davixcky/ecualizador-esp32/README.md

# Ecualizador de audio de tres bandas con ESP32

## Video del dispositivo

[Ver video en Full HD](docs/video/ecualizador-animado.mp4) · [Escena de Blender y texturas](docs/video/ecualizador-blender.zip). Demo de 36 segundos con sonido: los deslizadores cambian el audio usando las respuestas SPICE del circuito. Pantalla y luces sincronizadas; apertura de la tapa imantada. Es una demo virtual, no una grabación del prototipo físico.

Proyecto de Electrónica II · Universidad de la Costa · Leo Rojas, David Orozco y Manuel Castilla.

La ruta de audio usa filtros activos y controles analógicos. El ESP32 lee los niveles y calcula una FFT para la pantalla Waveshare de **1,9 pulgadas, 170 × 320, ST7789V2**. El gabinete EQ / 03 tiene acabado grafito, cierre con cuatro pares de imanes y dos canales interiores para 12 NeoPixel.

| Entrega | Archivos actuales |
|---|---|
| Presentación en LaTeX | [PDF](docs/presentacion/presentacion-fase2.pdf) · [PowerPoint con notas](docs/presentacion/presentacion-fase2.pptx) · [PDF con notas](docs/presentacion/presentacion-notas.pdf) |
| Exposición con animaciones | [PowerPoint animado](docs/presentacion/presentacion-animada.pptx) · [PDF por pasos](docs/presentacion/presentacion-animada.pdf) · [Cómo presentar](docs/presentacion/LEEME.md) |
| Informe | [PDF](docs/informe-fase2.pdf) · [Word](docs/informe-fase2.docx) · [Markdown](docs/informe-fase2.md) |
| Fuentes editables en LaTeX | [Informe](docs/latex/informe.tex) · [Presentación Beamer](docs/latex/presentacion.tex) |
| Presentación corta de filtros | [PDF de 10 diapositivas](docs/presentacion/presentacion-filtros-hoy.pdf) · [PowerPoint con notas](docs/presentacion/presentacion-filtros-hoy.pptx) · [Fuente LaTeX](docs/latex/presentacion-filtros.tex) |
| Ensayo de hoy | [Generador y osciloscopio: guía](simulacion/velxio/DEMO-HOY.md) |
| Paquete para otro computador | [ZIP portátil: presentación, esquema y simulaciones](docs/exposicion-portable.zip) |
| Simulación en Velxio | [Abrir casos locales](simulacion/velxio/index.html) · [Instrucciones y alcance](simulacion/velxio/README.md) · [100 Hz](simulacion/velxio/filtros-100Hz.vlx) · [1 kHz](simulacion/velxio/filtros-1000Hz.vlx) · [8 kHz](simulacion/velxio/filtros-8000Hz.vlx) |
| Esquemático | [PDF](hardware/ecualizador.pdf) · [KiCad](hardware/ecualizador.kicad_sch) · [ERC](hardware/erc.rpt) |
| PCB de una cara D.2 | [Plano PDF](hardware/pcb-rev-D2.pdf) · [KiCad](hardware/ecualizador.kicad_pcb) · [DRC](hardware/drc.rpt) · [Montaje y puentes](hardware/una-cara/LEEME.md) · [BOM](hardware/fabricacion/bom.csv) |
| Modelos 3D | [Gabinete STEP](cad/ecualizador-gabinete.step) · [Piezas STL](cad/stl/) · [PCB STEP](hardware/3d/ecualizador-placa.step) · [PCB VRML](hardware/3d/ecualizador-placa.wrl) |
| Propuesta original y rúbrica | [Fase 1](docs/fase1/) |

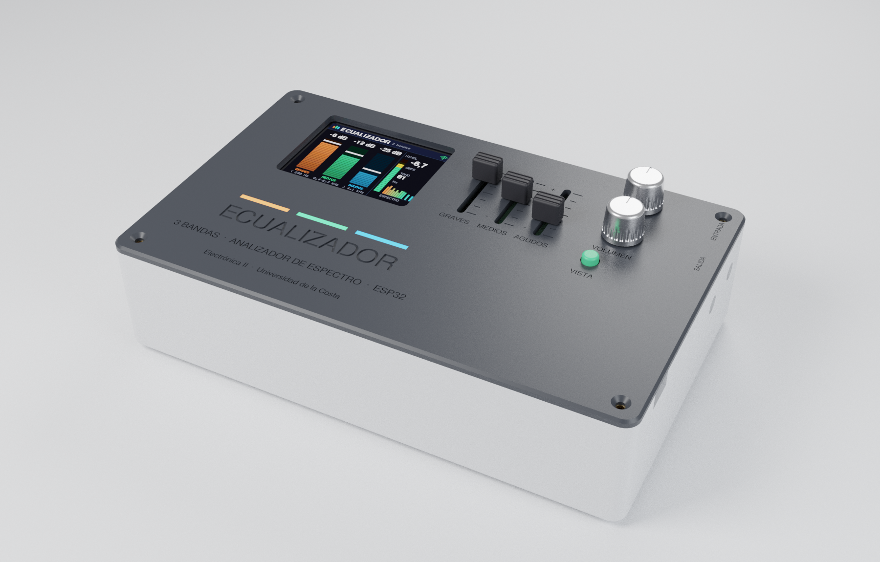
[picture p1: img/3d-gabinete-cerrado.png]
Diseño del gabinete


## Estado de la revisión del 22 de octubre de 2026

- ERC: cero errores y cero advertencias. Las 59 redes coinciden pin a pin con la definición del circuito.
- DRC D.2: cero infracciones, cero pads sin conectar y cero diferencias con el esquema. El DRC comprueba las 59 redes mediante cobre inferior, plano de GND y 80 cables. Las comprobaciones y límites de montaje se documentan en [la guía](hardware/una-cara/LEEME.md).
- ngspice: 23 casos del diseño revisado cumplen sus criterios. El caso histórico de Fase 1 reproduce el valle que motivó la corrección. El macromodelo del operacional es una aproximación propia.
- Velxio: tres proyectos ejecutados con motor SPICE; predominan graves a 100 Hz, medios a 1 kHz y agudos a 8 kHz. Los filtros usan operacionales ideales. Un cuarto [ensayo animado de 12 NeoPixel](simulacion/velxio/led-animado.vlx) ejecuta código del ESP32; usa un patrón programado sin audio.
- Velxio integrado: entrada → filtros → detectores → ADC ESP32 → TFT ILI9341, usando QEMU. Se comprueba el predominio de cada banda con 100 Hz, 1 kHz y 8 kHz. FFT sin calibración de frecuencia; no incluye potencia ni adaptación LED. [Guía y modelos](simulacion/velxio/INTEGRADO.md).
- Firmware: compilación ESP32 correcta; 19 comprobaciones DSP y cinco comparaciones de dibujo por franjas correctas en el computador.
- El montaje físico, las mediciones con instrumentos y el requisito de más del 70 % de dispositivos adquiridos y conectados **siguen sin evidencia en este repositorio**.

Los [registros de validación](docs/validacion/) conservan los resultados. Los renders provienen del CAD y de KiCad; las pantallas se dibujan con el código de interfaz y datos de ejemplo.

## Pantalla e iluminación

J4 es un adaptador de ocho señales a 2,54 mm, no la huella GH1.25 de Waveshare. Conectar por **nombre de señal**, siguiendo la tabla del informe: VCC, GND, DIN, CLK, CS, DC, RST y BL. La interfaz trabaja en horizontal a 320 × 170.

GPIO25 controla la tira mediante un 74AHCT125 y 330 Ω. J5 lleva 5 V, DIN y GND. Se prevén dos tramos de 100 mm, seis LED por tramo, y canales de 102 × 10,6 × 3 mm con difusores. El brillo inicial es 32/255, fijo. La fuente prevista es de 5 V / 3 A por J6; **desconectar VBUS del USB cuando se usa esa fuente**. No alimentar los LED desde 3,3 V ni usar VREF como retorno.

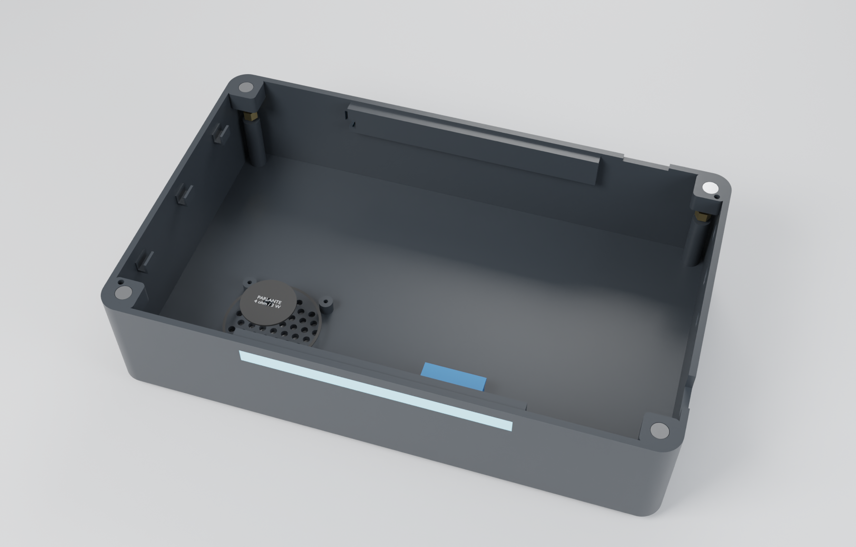
[picture p2: img/3d-gabinete-canales.png]
Canales interiores


## Reproducir los archivos

Los PDF usan el logo oficial CUC, rojo institucional y Red Hat Display, según el [manual consultado](img/marca/README.md). Las fuentes vigentes son los `.tex` (LuaLaTeX). El PowerPoint contiene imágenes de las diapositivas y notas; el texto se edita en LaTeX. El HTML anterior está archivado en `docs/archivo/`.

```sh
# TeX Live: latex-extra, lang-spanish, fonts-recommended, luatex; pandoc
# Python: pymupdf, python-pptx (para exportar PNG y PowerPoint)
bash herramientas/compilar_documentos.sh

# Firmware y pruebas en computador
pio run -d firmware
make -C firmware/test prueba pantallas

# Conectividad y simulación (ngspice, numpy, matplotlib)
python3 herramientas/verificar_netlist.py
.venv/bin/python herramientas/simulacion.py

# PCB de una cara: regenerar y verificar
python3 herramientas/generar_esquematico.py
python3 herramientas/generar_pcb.py
bash herramientas/exportar_fabricacion.sh

# CAD (CadQuery) y renders (Blender, KiCad)
.venv/bin/python herramientas/validar_cad.py
bash cad/generar.sh

# Repetir la comprobación web (Node y Playwright con Chromium)
node herramientas/validar_velxio.cjs
node herramientas/validar_led_velxio.cjs
```

Las vistas de ensamblaje y colores de bandas parten de C2-ABPR; la revisión EQ / 03 adopta acabado grafito, rotulación compacta y cierre magnético. Las cotas de pantalla, controles y conectores deben contrastarse con las piezas adquiridas antes de imprimir y montar.

La presentación incluye fragmentos del esquema real para explicar preamplificador, Sallen-Key, sumador y detector. Los PDF adjuntan el esquema, el plano D.2 y los proyectos Velxio. El enlace y el QR abren el editor; después se importa el caso `.vlx`. Ver [cierre magnético y cotas](cad/CIERRE-MAGNETICO.md).

La PCB D.2 organiza las etapas con el flujo Python/KiCad y Freerouting de medidor-energia-esp32: ESP32 a la derecha, operacionales por etapas y cableado identificado por colores. Usa una sola cara de cobre y puentes aislados. Los controles van en el panel y requieren las [cabeceras y cables de montaje](hardware/una-cara/LEEME.md). Los Gerbers de dos capas B.1 están archivados y no corresponden al montaje vigente.

### Montaje de los puentes

La cara superior lleva 29 puentes cortos (hasta 20 mm entre extremos). Los 51 cables restantes se montan aislados por debajo. El total sigue siendo 80 tramos; no se añade una capa de cobre. [La guía](hardware/PUENTES.md) y [el plano de cuatro páginas](hardware/pcb-rev-D2.pdf) indican la cara de cada conexión. Los arcos del render son orientativos: el montaje requiere comprobar separación, sujeción y continuidad.
