davixcky/ecualizador-esp32/docs/latex/validacion.tex

El esquema pasa ERC sin errores ni advertencias. Las 59 redes coinciden pin a pin con la descripción del circuito.

La revisión D.2 pasa la comprobación eléctrica DRC y la comparación con el esquema. Las 59 redes quedan conectadas al incluir los 80 puentes. La comparación con el esquema comprueba las conexiones de cada terminal. El ruteo conserva una separación mínima de 1 mm y pistas de 0,9 mm o más.

Los informes están en \texttt{hardware/drc.rpt} y \texttt{hardware/una-cara/continuidad.json}. Las comprobaciones gráficas de serigrafía no se utilizan para certificar una impresión; no se incluye una capa de serigrafía en fabricación.
