davixcky/ecualizador-esp32/docs/presentacion/presentacion-fase2.pptx

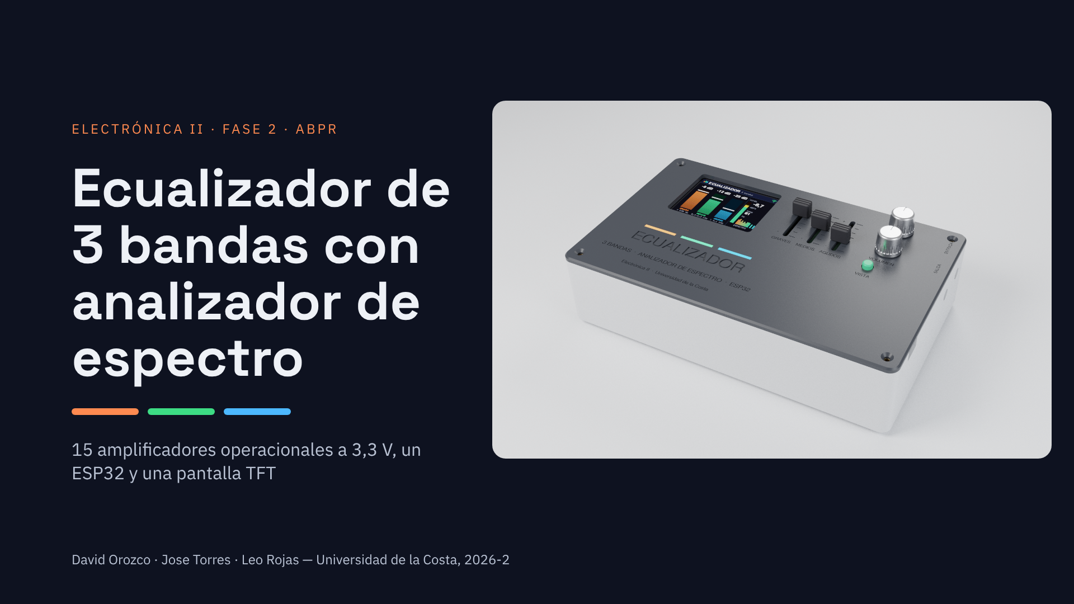
[picture p21: figure]

Notes: Presentamos la Fase 2: el desarrollo de la propuesta elegida. Es un ecualizador analógico de tres bandas hecho con amplificadores operacionales, al que le sumamos un analizador de espectro en un ESP32.

## Slide 2

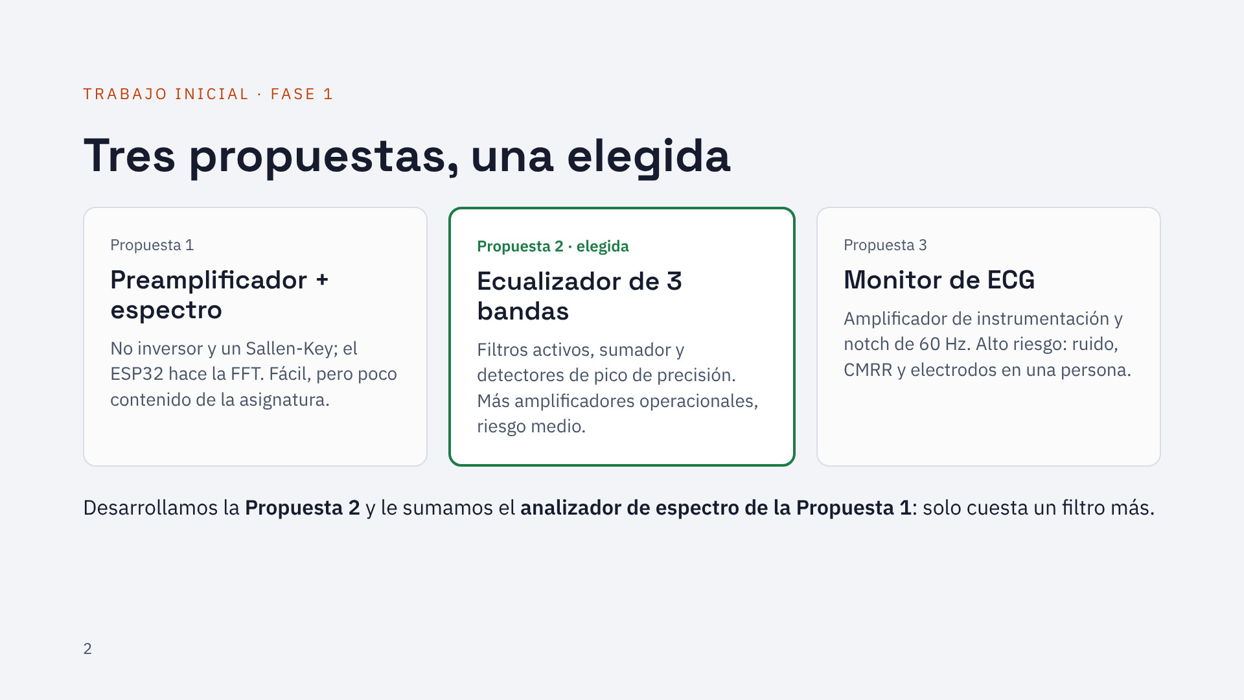
[picture p22: figure]

Notes: En la Fase 1 presentamos tres alternativas con los mismos criterios: 3,3 V, MCP6004, VREF de 1,65 V y ADC1 del ESP32. Elegimos la 2 porque tiene más contenido de Electrónica II con riesgo medio. De la 1 tomamos el analizador de espectro. La 3 se descartó por riesgo y porque conecta electrodos a una persona.

## Slide 3

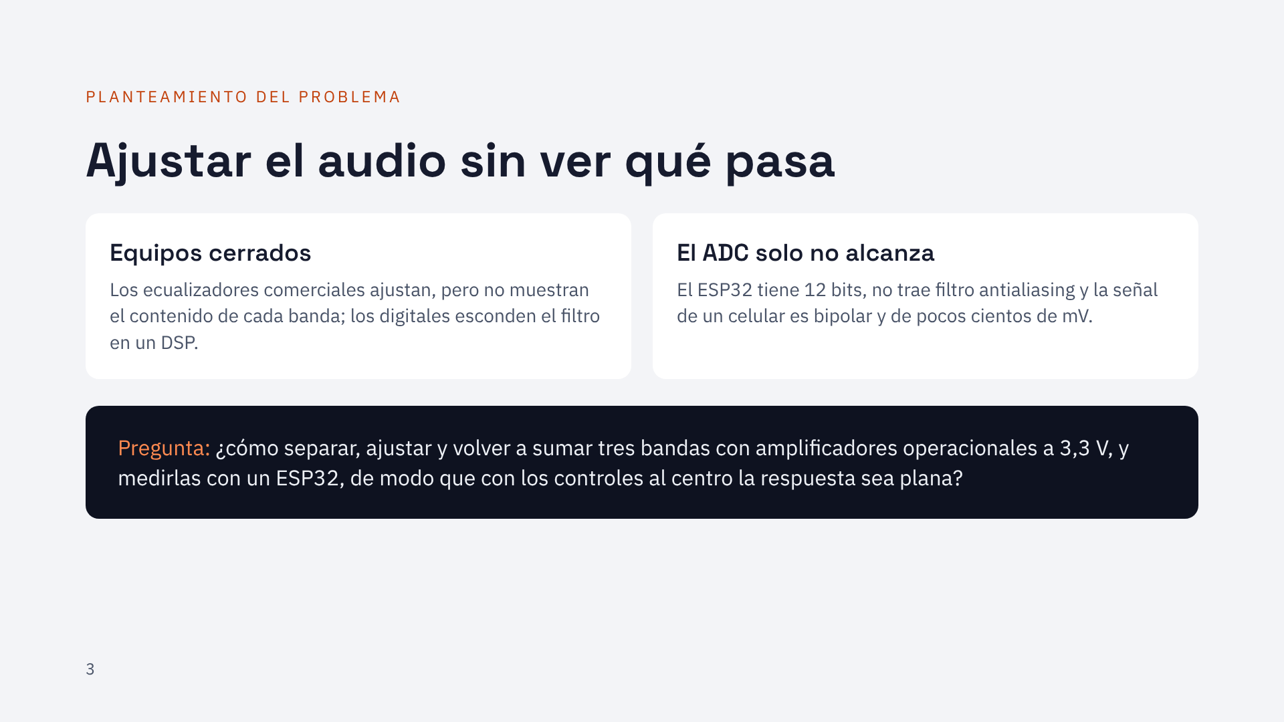
[picture p23: figure]

Notes: El problema tiene dos partes: el usuario no ve qué hace el ecualizador, y el microcontrolador no puede digitalizar bien el audio directamente. Por eso la solución es analógica para el audio y el ESP32 solo mide.

## Slide 4

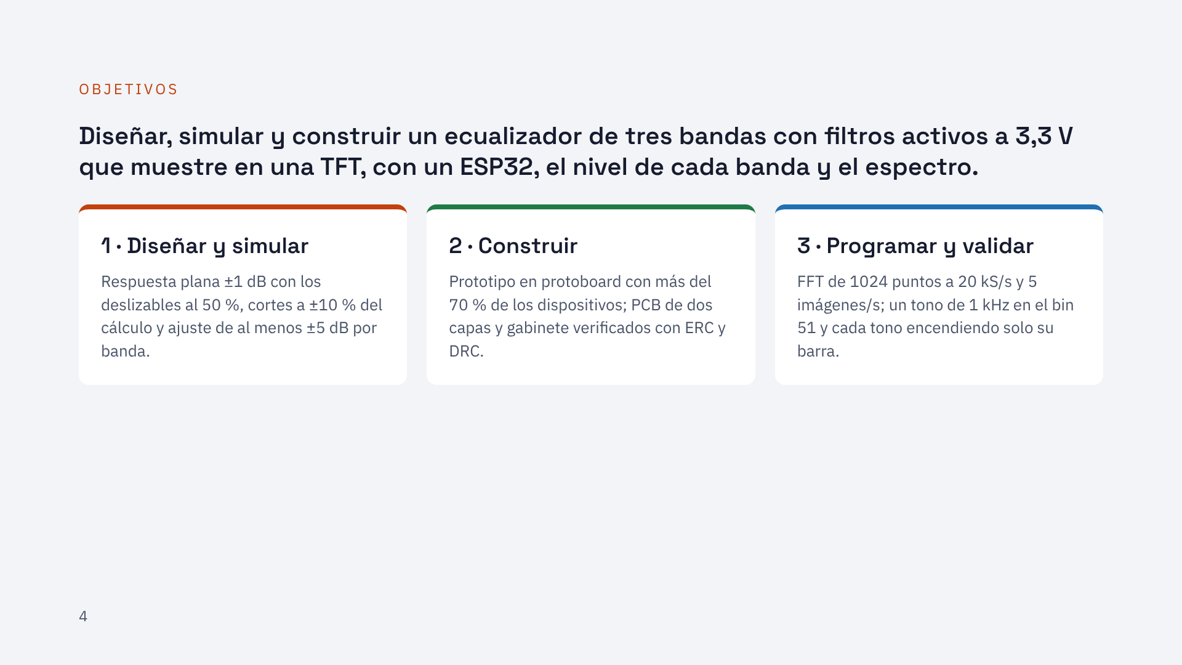
[picture p24: figure]

Notes: El objetivo general arriba; los tres específicos son medibles y cada uno tiene un criterio que luego verificamos en la simulación y que verificaremos en el montaje.

## Slide 5

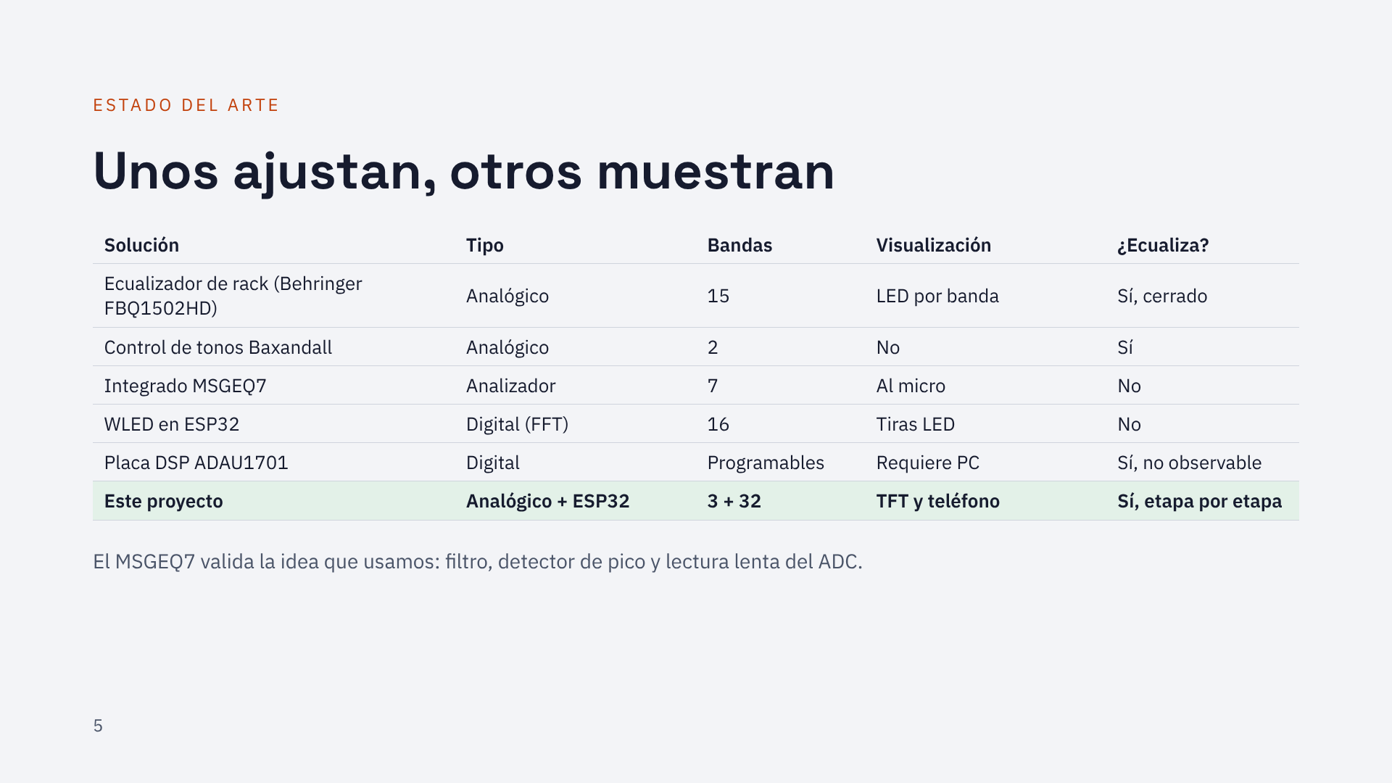
[picture p25: figure]

Notes: Ningún producto revisado hace las dos cosas con un circuito que se pueda medir. Los analógicos comerciales ecualizan pero son cerrados; los analizadores miden pero no ecualizan.

## Slide 6

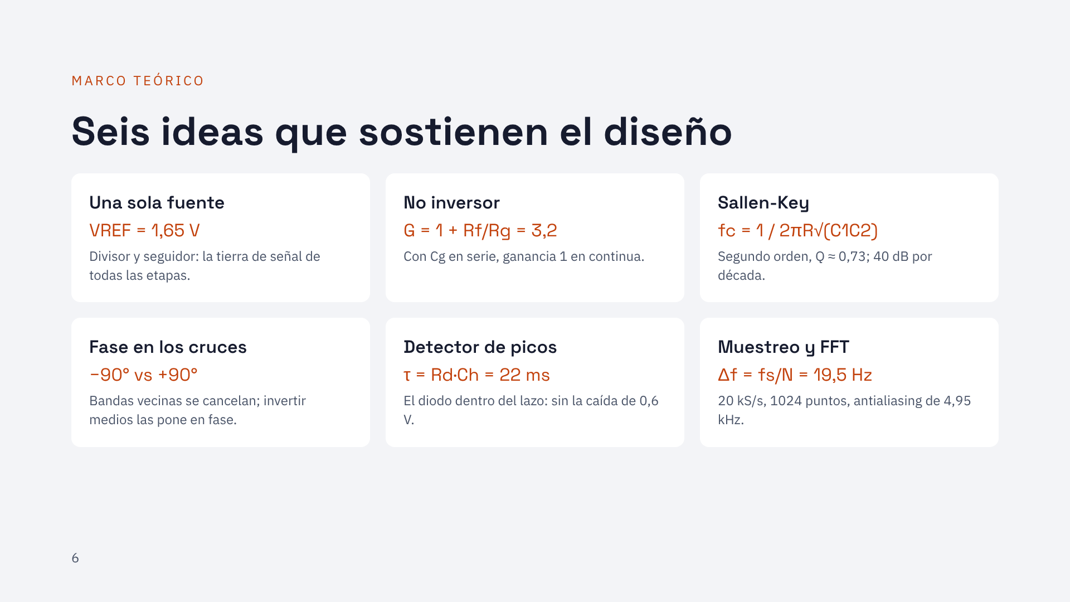
[picture p26: figure]

Notes: Lo más importante es la cuarta idea: un pasa bajas y un pasa altas de segundo orden quedan a 180 grados en su cruce. Por eso invertimos la banda de medios, como en los cruces Linkwitz-Riley de los altavoces.

## Slide 7

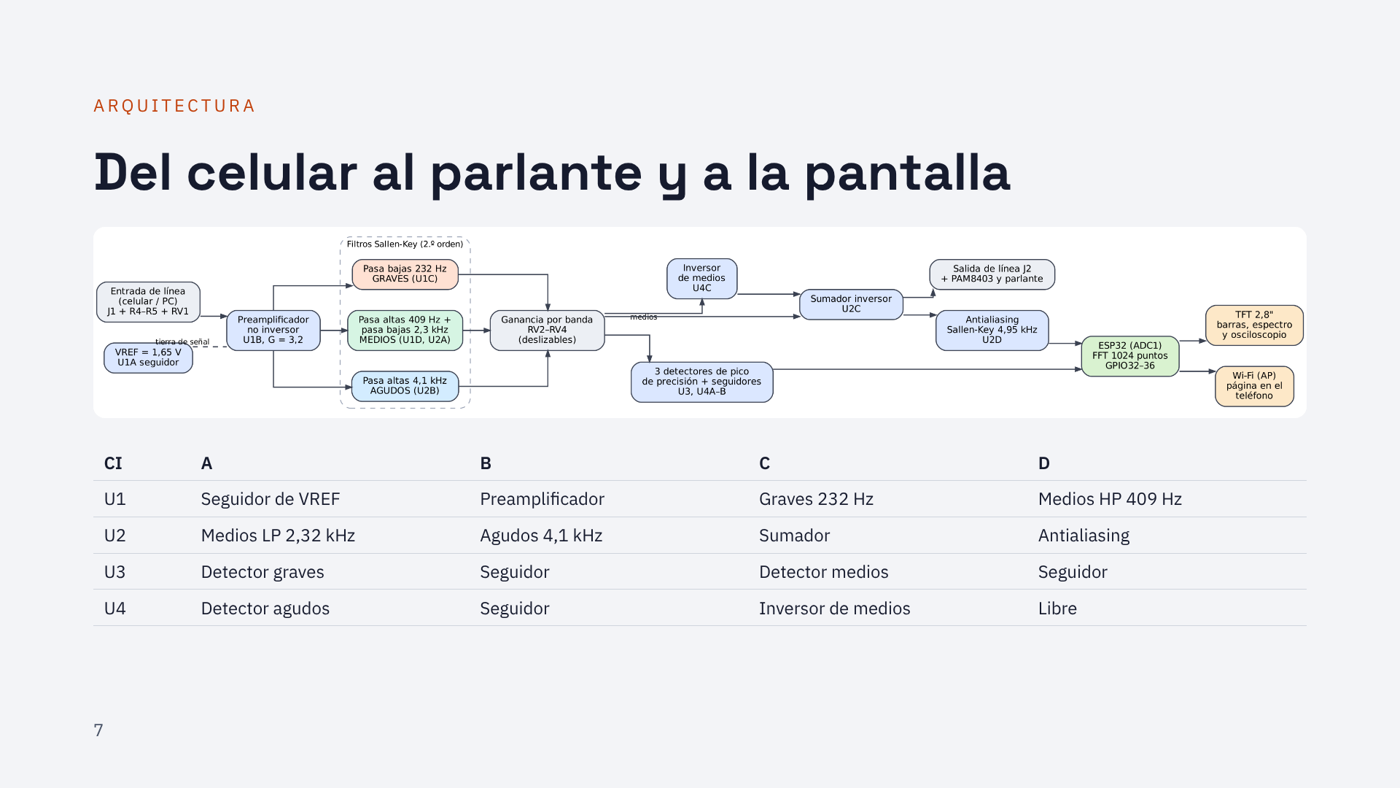
[picture p27: figure]

Notes: Cuatro MCP6004, 15 de 16 amplificadores en uso. El audio nunca pasa por el ESP32: el microcontrolador solo mide la salida filtrada y los detectores.

## Slide 8

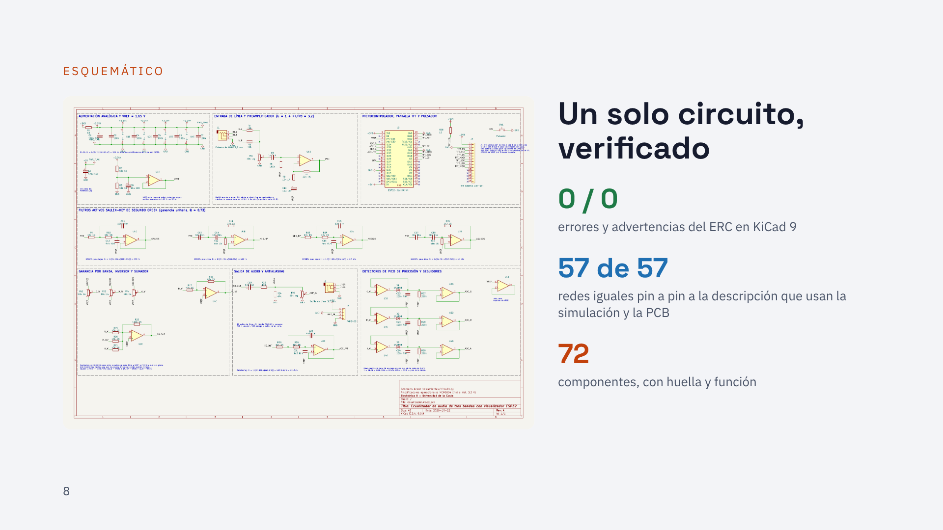
[picture p28: figure]

Notes: El esquemático, la simulación y la PCB salen del mismo archivo de descripción del circuito, y un script compara la netlist que exporta KiCad con esa descripción. Así no hay diferencias entre lo que se simula y lo que se fabrica.

## Slide 9

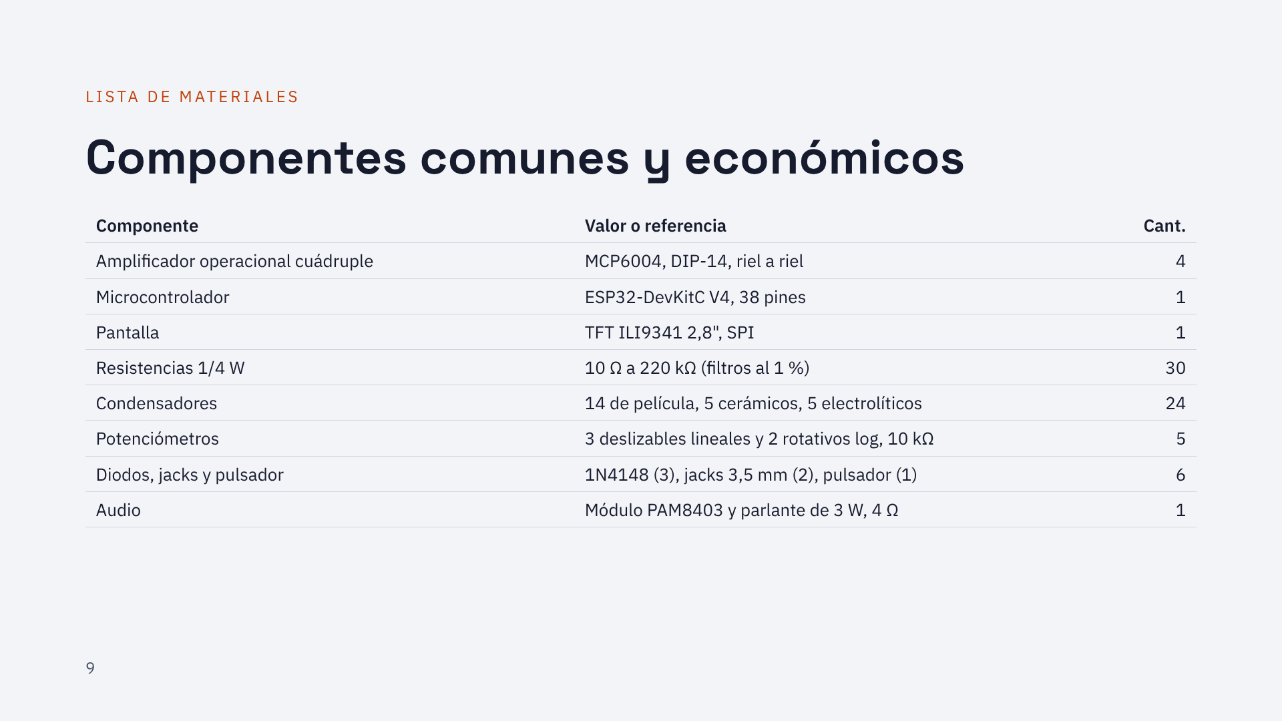
[picture p29: figure]

Notes: La lista completa por referencia está en el repositorio. Todo es de inserción, para poder montarlo en protoboard y soldarlo a mano.

## Slide 10

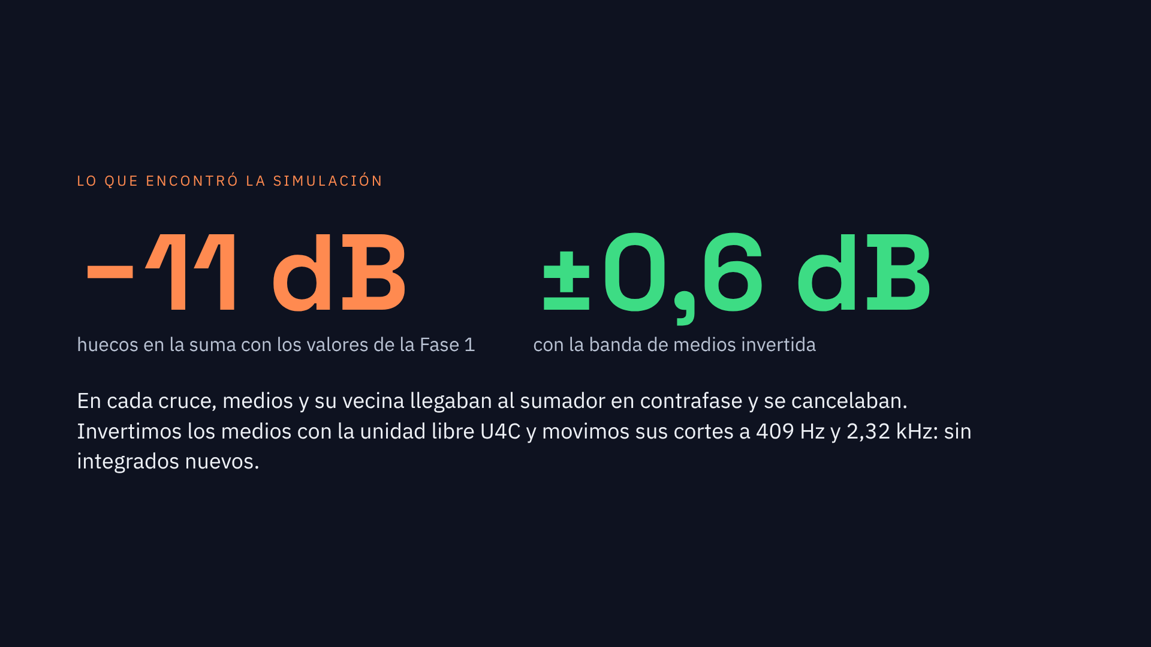
[picture p30: figure]

Notes: Este es el resultado más importante de la simulación. La propuesta original, con los tres controles al centro, tenía dos huecos de 11 dB cerca de 300 Hz y 3 kHz. La causa es la fase en los cruces de segundo orden. Con un inversor la respuesta queda entre −0,27 y +0,88 dB de 20 Hz a 20 kHz.

## Slide 11

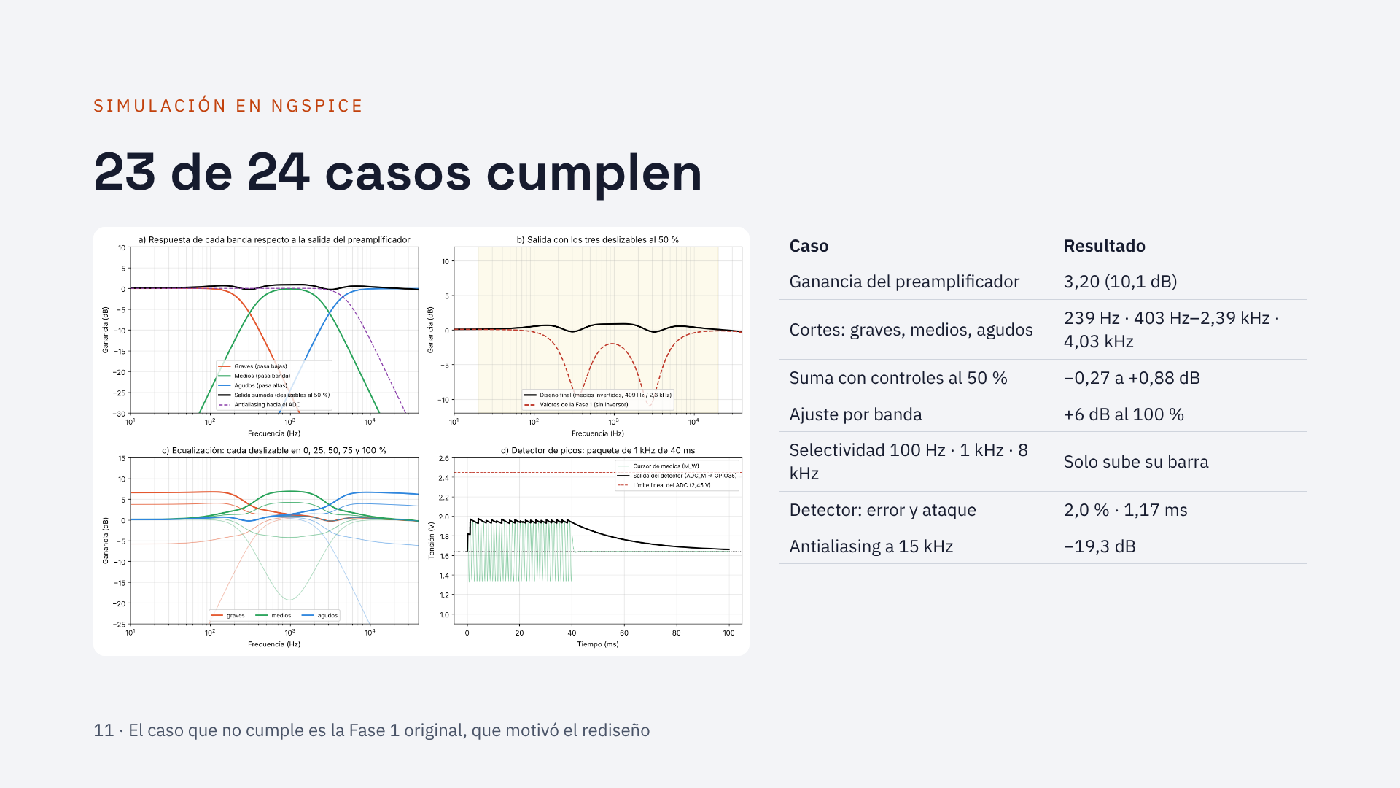
[picture p31: figure]

Notes: Para la demostración en vivo abrimos simulacion/ac_plano.cir y graficamos la salida respecto al preamplificador; con tran_tono_1000.cir mostramos que solo sube el detector de medios.

## Slide 12

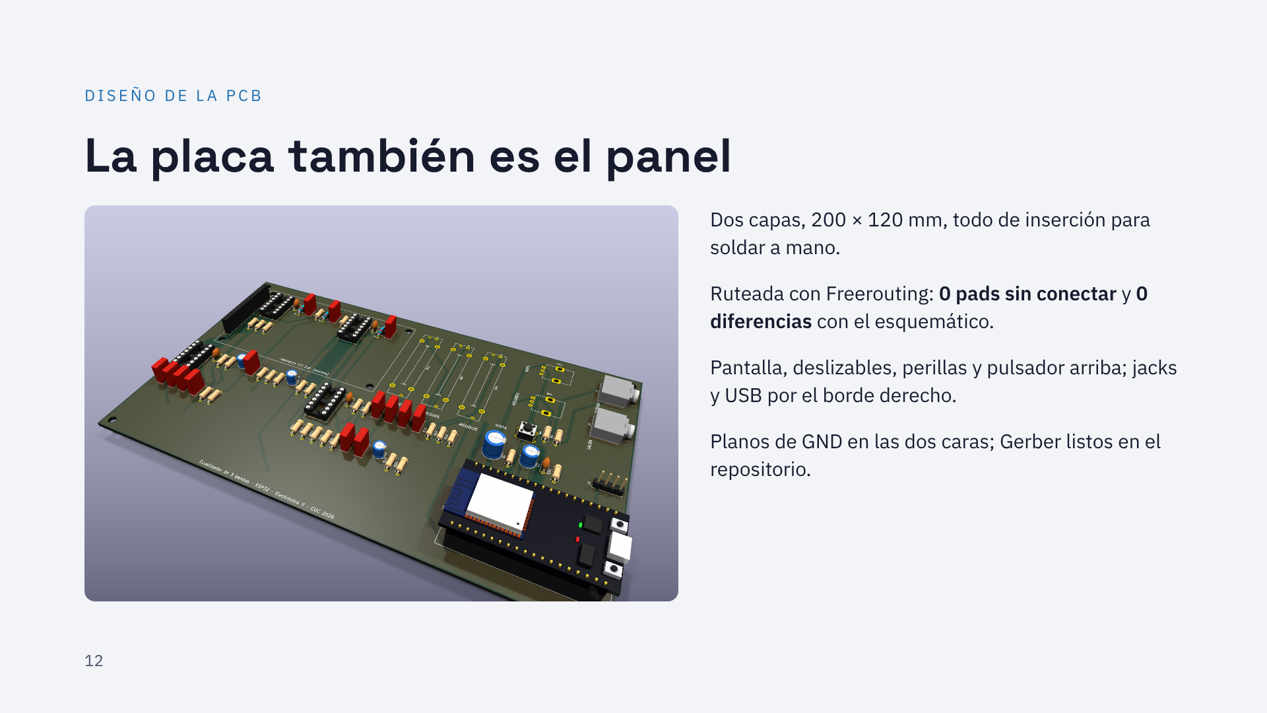
[picture p32: figure]

Notes: Quedan 9 avisos no eléctricos del DRC: textos de serigrafía que se tocan y dos conexiones térmicas con dos rayos. La zona bajo la pantalla solo tiene piezas bajas, porque la TFT queda 11 mm sobre la placa.

## Slide 13

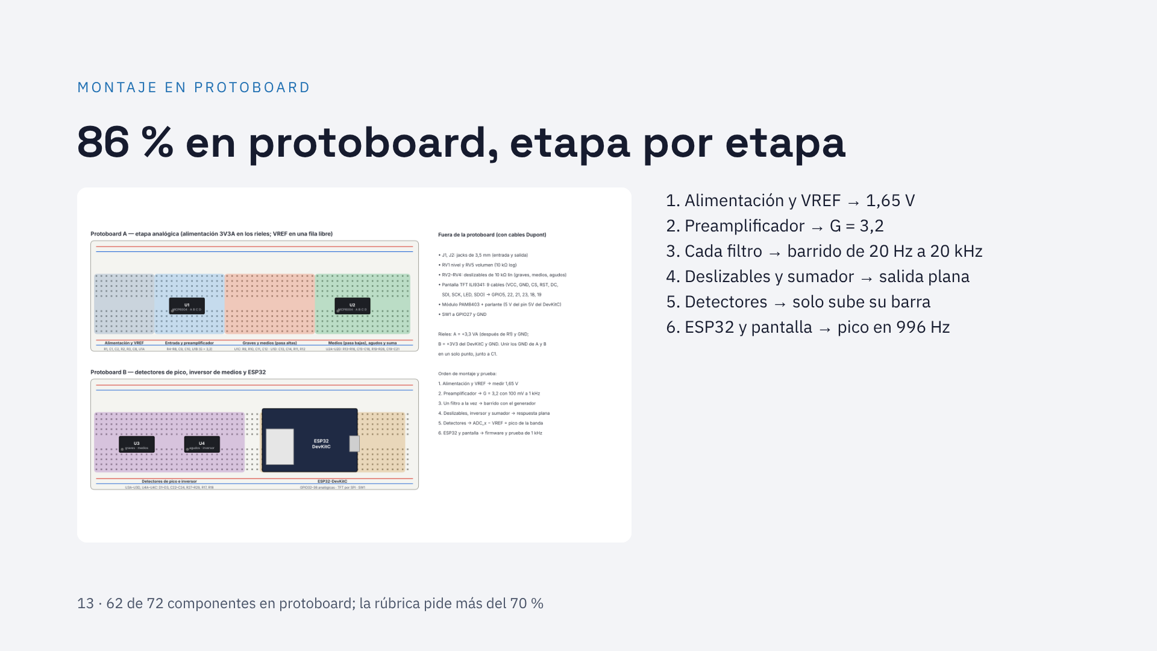
[picture p33: figure]

Notes: Armamos en el orden de la señal y medimos cada etapa antes de seguir. Fuera de la protoboard quedan solo los jacks, los potenciómetros y la pantalla, con cables Dupont.

## Slide 14

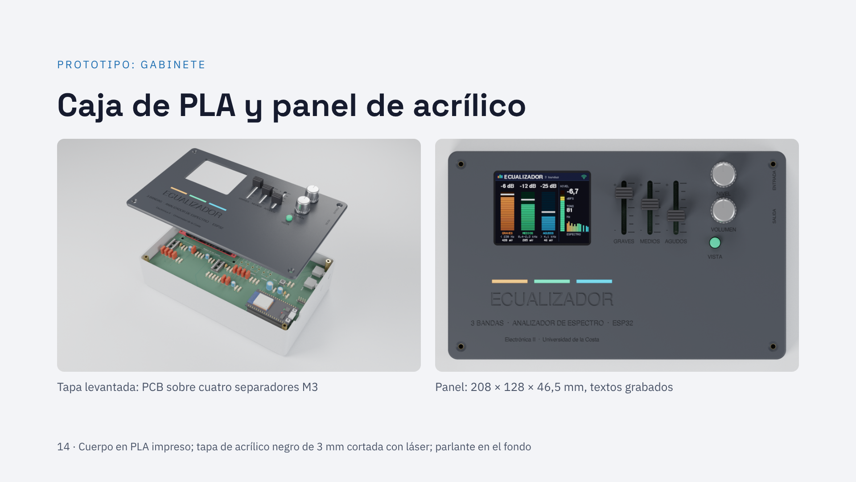
[picture p34: figure]

Notes: El gabinete se modeló con las mismas coordenadas de la PCB, así cada ranura y agujero cae sobre su pieza. La rúbrica pide que los diseños del prototipo no se hagan con IA: además de estos renders, presentaremos bocetos a mano desde varias vistas.

## Slide 15

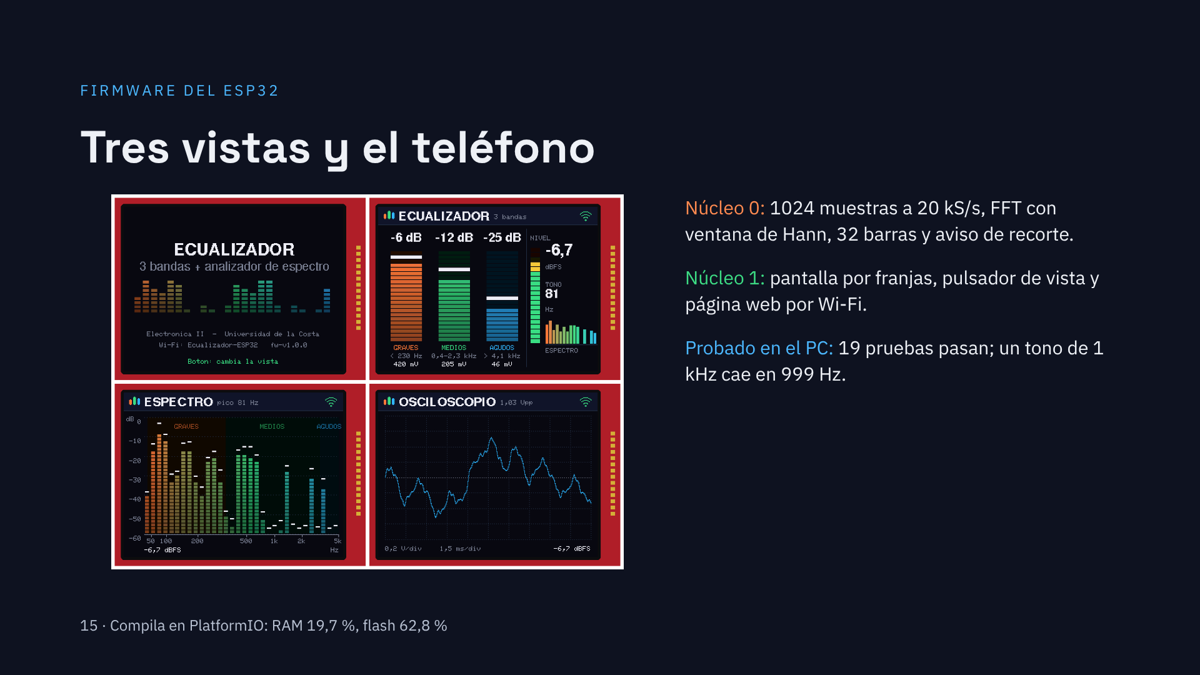
[picture p35: figure]

Notes: Las pantallas de la imagen se dibujaron con el mismo código del firmware, compilado en el PC. Las pruebas encontraron que bajo 300 Hz dos barras leían el mismo bin de la FFT, y se corrigió.

## Slide 16

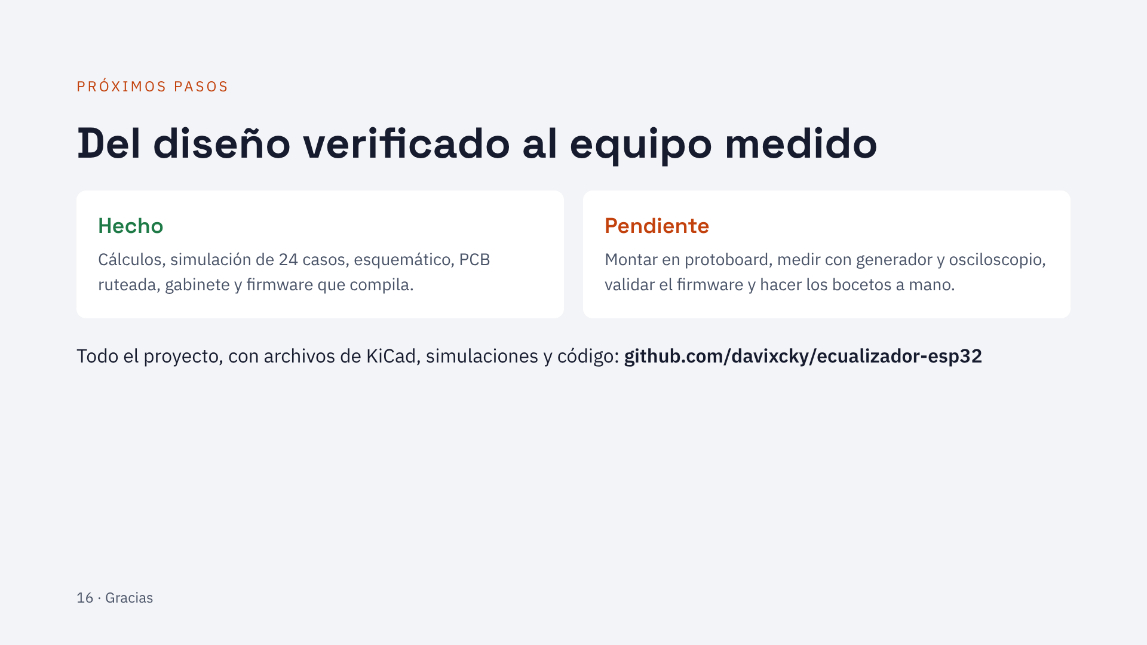
[picture p36: figure]

Notes: Cerramos con lo que falta: todo lo mostrado es diseño y simulación; la siguiente entrega es el montaje medido. Preguntas.
