davixcky/ecualizador-esp32/docs/latex/presentacion-animada.pdf

## Ecualizador de audio de tres bandas

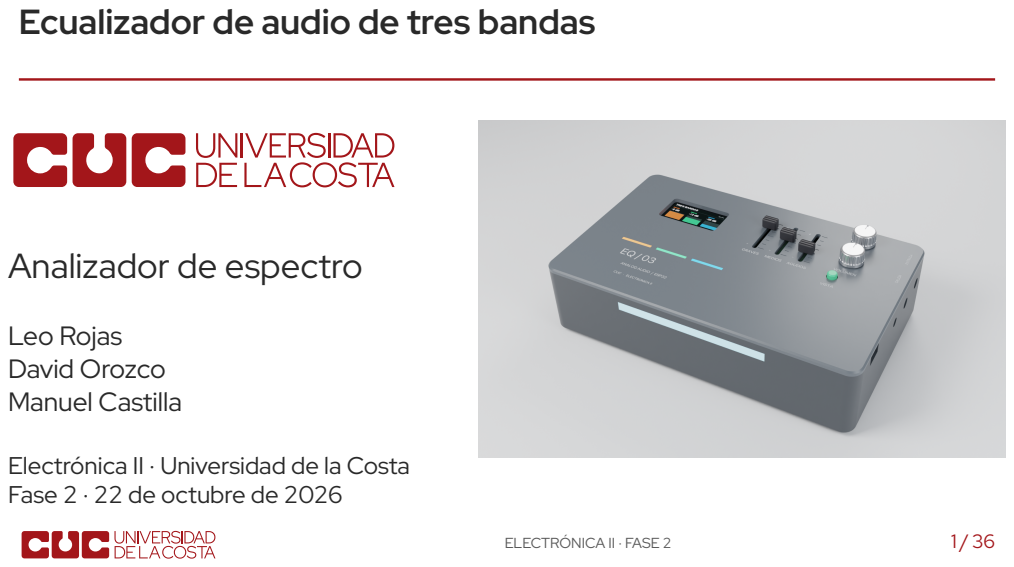
[picture p57: page 1]
Leo Rojas David Orozco Manuel Castilla; ELECTRÓNICA II · FASE 2

Analizador de espectro

Electrónica II · Universidad de la Costa
Fase 2 · 22 de octubre de 2026

## Objetivos del proyecto

Objetivo general
Desarrollar un ecualizador de audio de tres bandas que permita ajustar graves, medios y agudos, reproducir la señal procesada y visualizar sus niveles y espectro mediante un ESP32.

Tres objetivos específicos
1. Diseñar los filtros activos y las etapas de ajuste y suma para controlar las tres bandas de audio.

## Objetivos del proyecto

Objetivo general
Desarrollar un ecualizador de audio de tres bandas que permita ajustar graves, medios y agudos, reproducir la señal procesada y visualizar sus niveles y espectro mediante un ESP32.

Tres objetivos específicos
1. Diseñar los filtros activos y las etapas de ajuste y suma para controlar las tres bandas de audio.
2. Integrar la salida de línea, el amplificador y los controles en un equipo con PCB de una cara y gabinete propio.

## Objetivos del proyecto

Objetivo general
Desarrollar un ecualizador de audio de tres bandas que permita ajustar graves, medios y agudos, reproducir la señal procesada y visualizar sus niveles y espectro mediante un ESP32.

Tres objetivos específicos
1. Diseñar los filtros activos y las etapas de ajuste y suma para controlar las tres bandas de audio.
2. Integrar la salida de línea, el amplificador y los controles en un equipo con PCB de una cara y gabinete propio.
3. Programar la adquisición y visualización con el ESP32, y evaluar el equipo mediante simulación y mediciones de laboratorio.

## Antecedentes y decisión de diseño

Estado del arte

Referencia | Aporte | Qué tomamos
Sallen-Key / TI | Filtros activos de segundo or-
| den | Cálculo de los cortes y de Q.
ADAU1701 / Analog Devices | Procesamiento digital progra-
| mable | Punto de comparación con la
| | ruta analógica.
WLED Audio Reactive | Análisis de audio para ilumina-
| ción | Referencia de visualización
| | con ESP32.

Cada etapa tiene puntos de medida para comparar el montaje con el cálculo.

Fuentes: TI SLOA024B; ficha ADAU1701; documentación WLED.

## Materiales principales del prototipo

Componente | Cantidad | Función
MCP6004 + zócalos | 4 | 15 unidades activas y una de reserva
ESP32-DevKitC V4 | 1 | Adquisición, FFT, pantalla y Wi-Fi
Waveshare ST7789V2 de 1,9 pulga- das | 1 | Interfaz 170 × 320
Resistencias / condensadores | 32 / 26 | Filtros, acoples y alimentación
Potenciómetros / diodos | 5 / 3 | Ajuste y detección de picos
74AHCT125 / WS2812B | 1 / 12 LED | Adaptación de datos e iluminación
PAM8403 + parlante / fuente 5 V, 3 A | 1 juego | Salida de audio y alimentación

Lista por referencia en la BOM. Añadir cables de puente, cables, conectores, caja y tornillería.

## Recorrido del audio y puntos de medida

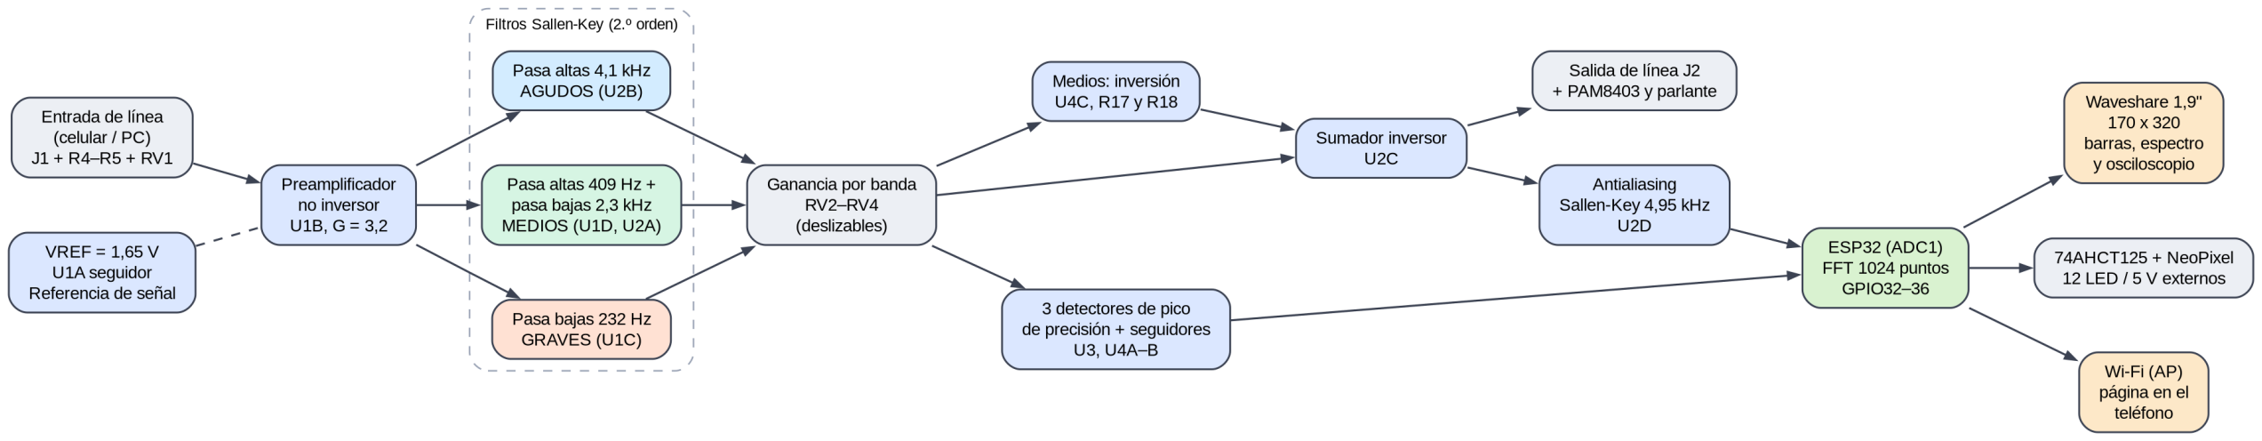
[picture p58: figure]

Entrada de línea → filtros y controles → salida. El ESP32 observa los detectores y la salida filtrada para la FFT.

## El esquema completo: revisión D.2

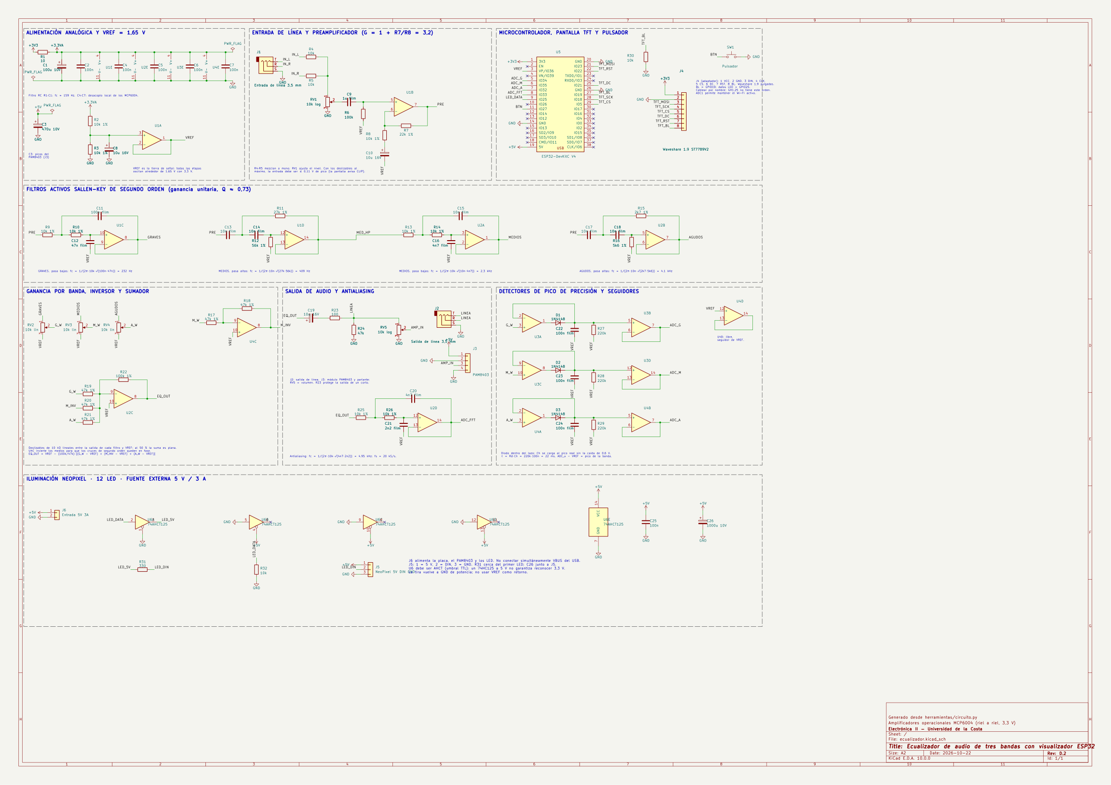
[picture p59: figure]

Seguir las redes:

PRE: entrada
acondicionada.
GRAVES / MEDIOS /
AGUDOS: filtros.
EQ_OUT: suma.
ADC_G / M / A:
detectores.

Abrir esquema PDF

## Marco teórico: filtros activos Sallen-Key R10

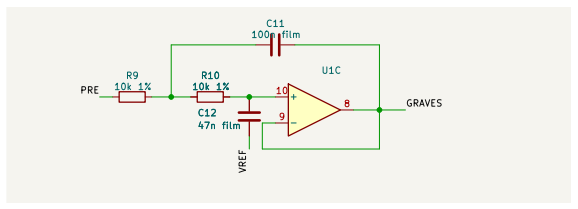
[picture p60: figure]
film; C12 47n film; GRAVES PRE; VREF R10

U1C: pasa bajas de segundo orden.
R9 = R10; C11 realimenta y C12 va a VREF.

Para resistencias iguales y ganancia unitaria:

f0 =

1
2πR√C11C12

Q = 1
2

√
C11
C12

f0 fija la frecuencia natural; Q determina la forma de la respuesta. El corte a −3 dB coincide con f0 cuando Q = 1/√
2. En medios conectamos un pasa altas y un pasa bajas en cascada.
Fuente: Karki, Texas Instruments, SLOA024B. Valores aplicados al esquema del proyecto.

## Marco teórico: ajustar y sumar las bandas

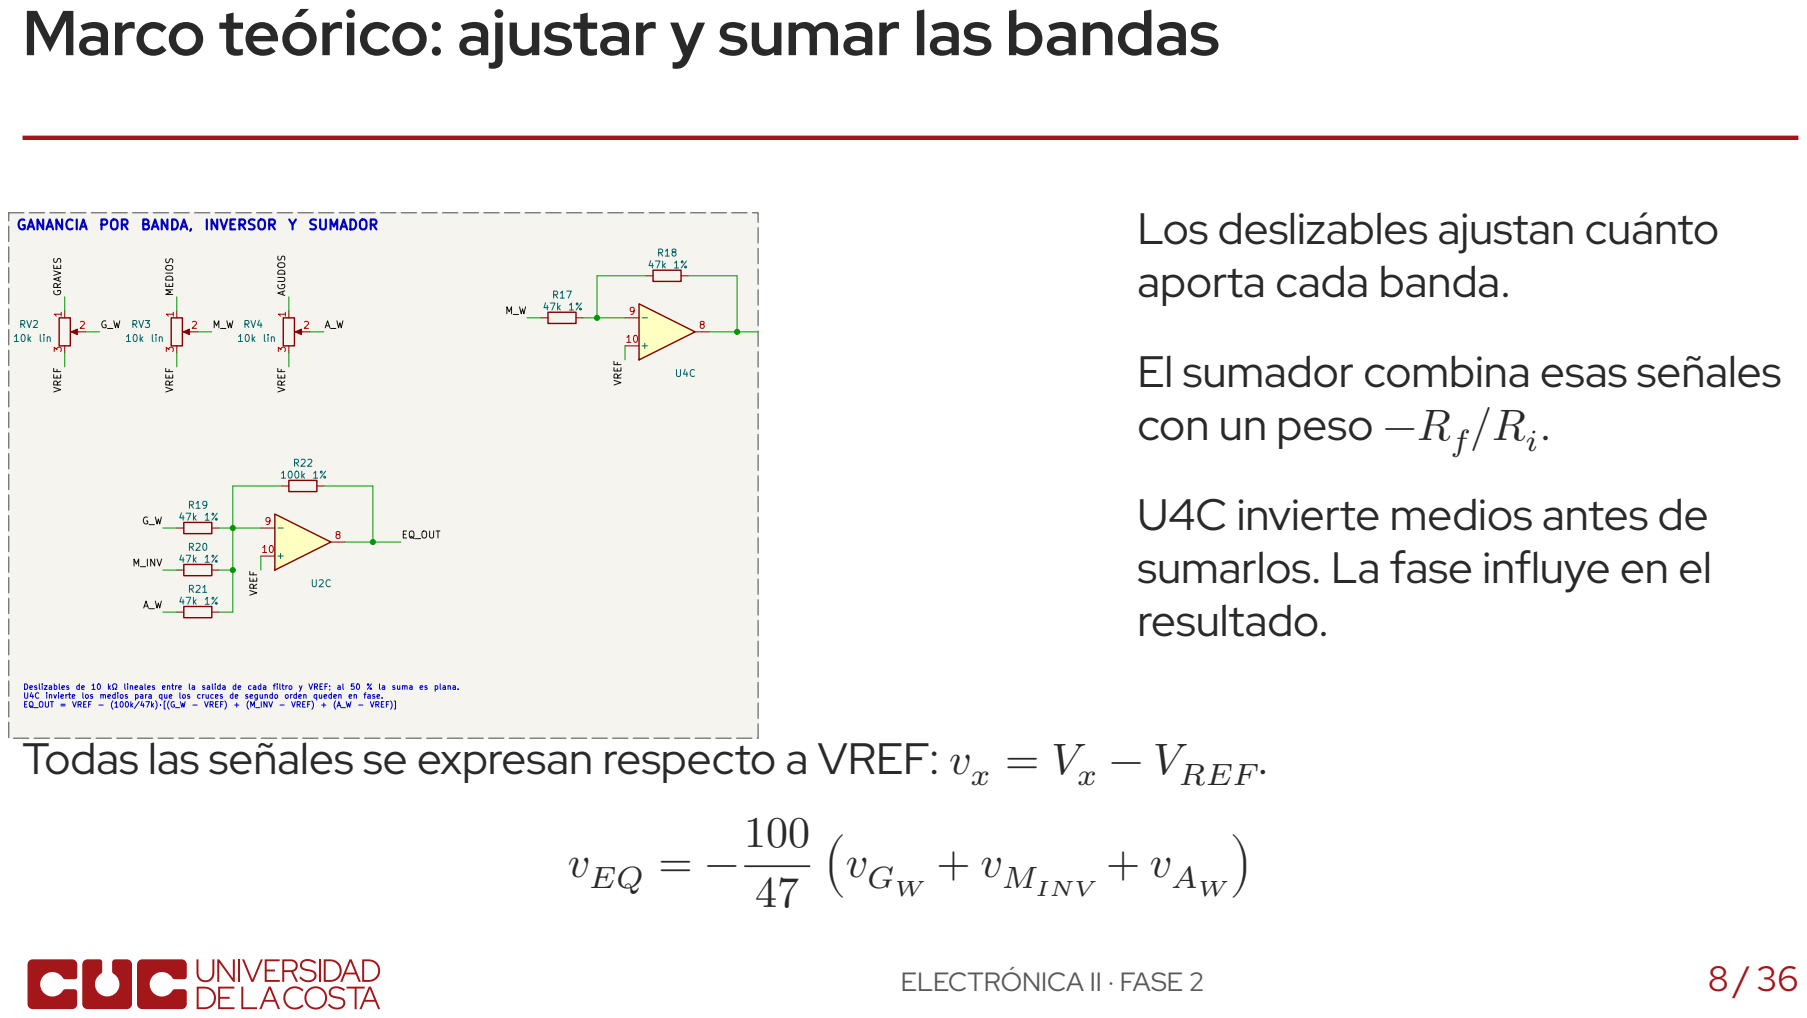
[picture p61: page 10]

GANANCIA POR BANDA, INVERSOR Y SUMADOR

Los deslizables ajustan cuánto
aporta cada banda.

El sumador combina esas señales
con un peso −Rf/Ri

U4C invierte medios antes de
sumarlos. La fase influye en el
resultado.

Deslizables de 10 kΩ lineales entre la salida de cada filtro y VREF; al 50 % la suma es plana. U4C invierte los medios para que los cruces de segundo orden queden en fase. EQ_OUT = VREF − (100k/47k)·[(G_W − VREF) + (M_INV − VREF) + (A_W − VREF)]
Todas las señales se expresan respecto a VREF: vx = Vx − VREF.

## 3,3 V de alimentación; 1,65 V de referencia

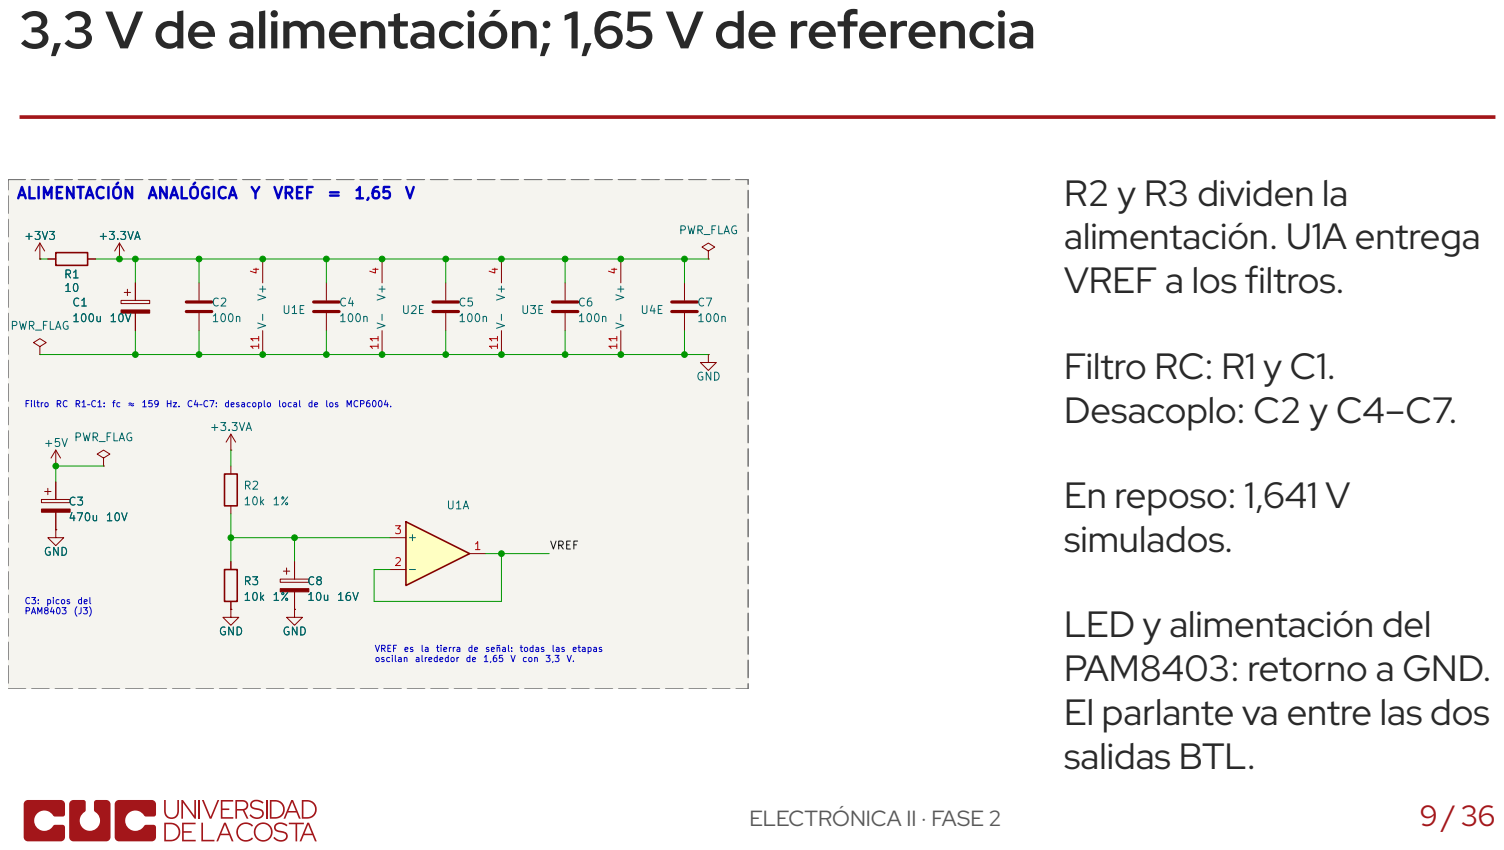
[picture p62: page 11]

Filtro RC R1⁻C1: fc ≈ 159 Hz. C4–C7: desacoplo local de los MCP6004.

LED y alimentación del
PAM8403: retorno a GND.
El parlante va entre las dos
salidas BTL.

VREF es la tierra de señal: todas las etapas oscilan alrededor de 1,65 V con 3,3 V.

## Entrada y ganancia del preamplificador

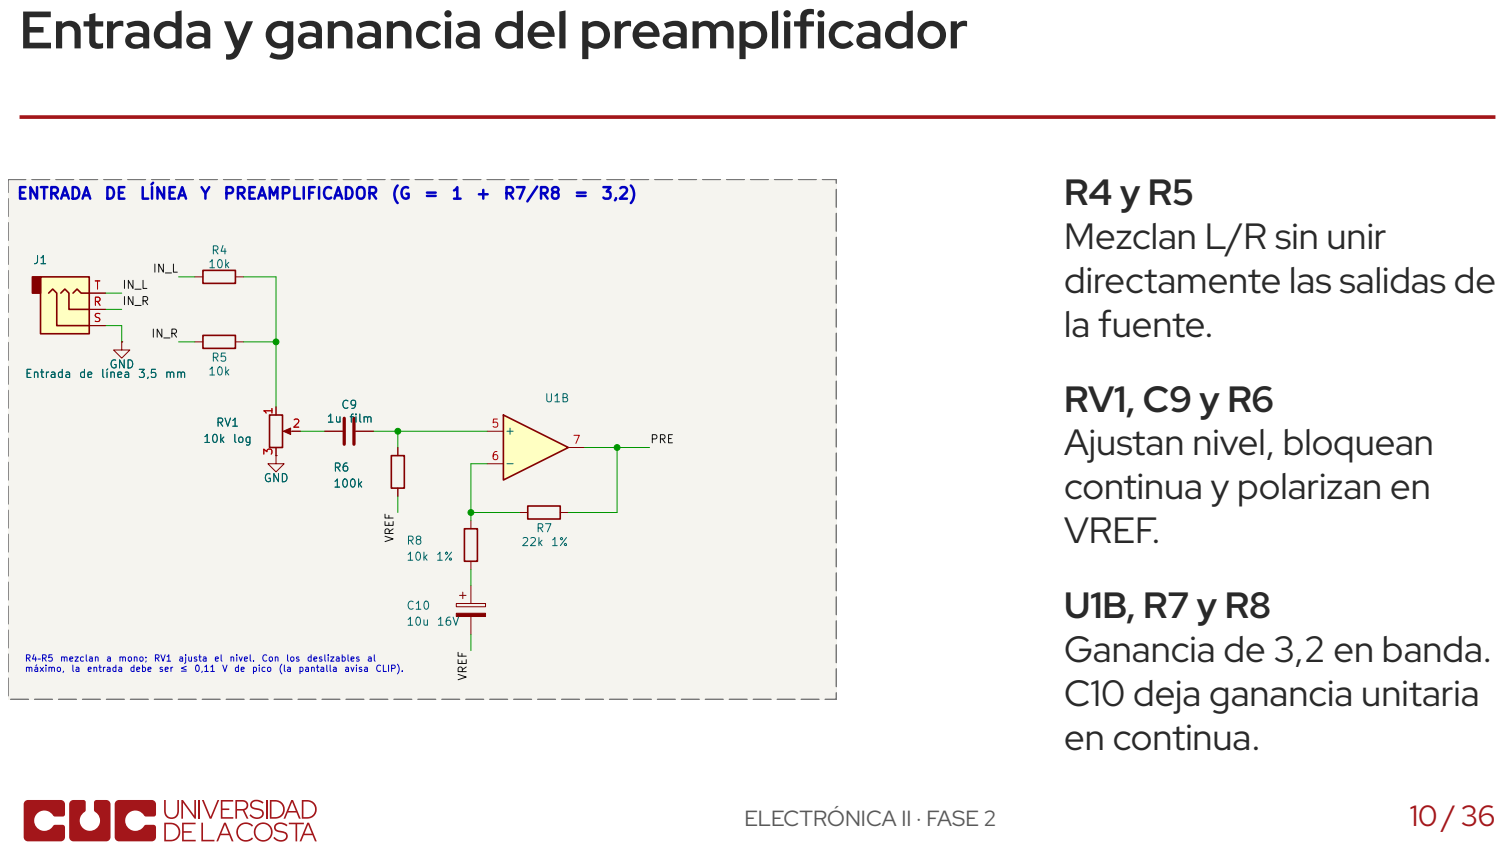
[picture p63: page 12]

ENTRADA DE LÍNEA Y PREAMPLIFICADOR (G = 1 + R7/R8 = 3,2)

Mezclan L/R sin unir
directamente las salidas de
la fuente.

Entrada de línea 3,5 mm

Ganancia de 3,2 en banda.
C10 deja ganancia unitaria
en continua.

R4–R5 mezclan a mono; RV1 ajusta el nivel. Con los deslizables al máximo, la entrada debe ser ≤ 0,11 V de pico (la pantalla avisa CLIP). VREF es la tierra de señal: todas las etapas oscilan alrededor de 1,65 V con 3,3 V.

## Filtro de graves: U1C, R9, R10, C11 y C12 R10

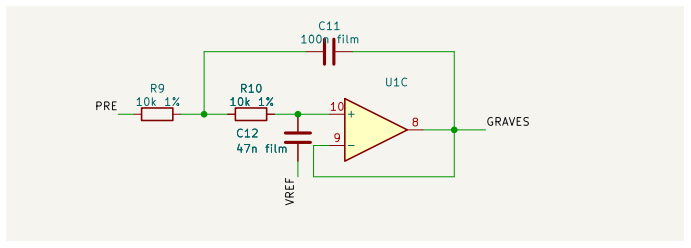
[picture p64: figure]
film; 47n film; GRAVES PRE; VREF R10

R9 = R10 = 10 kΩ.
C11 = 100 nF; C12 = 47 nF. U1C trabaja como seguidor.

## Filtro de graves: U1C, R9, R10, C11 y C12 R10

R9 = R10 = 10 kΩ.
C11 = 100 nF; C12 = 47 nF. U1C trabaja como seguidor.

C11 vuelve desde la salida al nodo intermedio. C12 deriva a VREF.
La realimentación fija Q ≈ 0, 73; el corte simulado es 239 Hz.

## Medios: dos filtros conectados en cascada C13

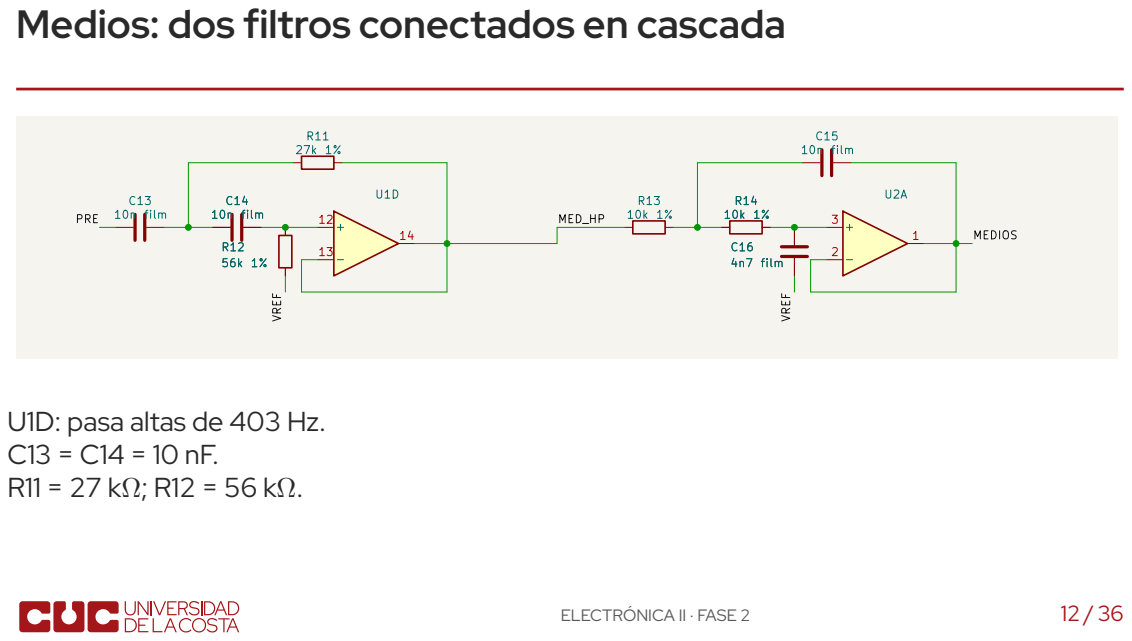
[picture p65: page 15]

U1D: pasa altas de 403 Hz.

## Medios: dos filtros conectados en cascada C13

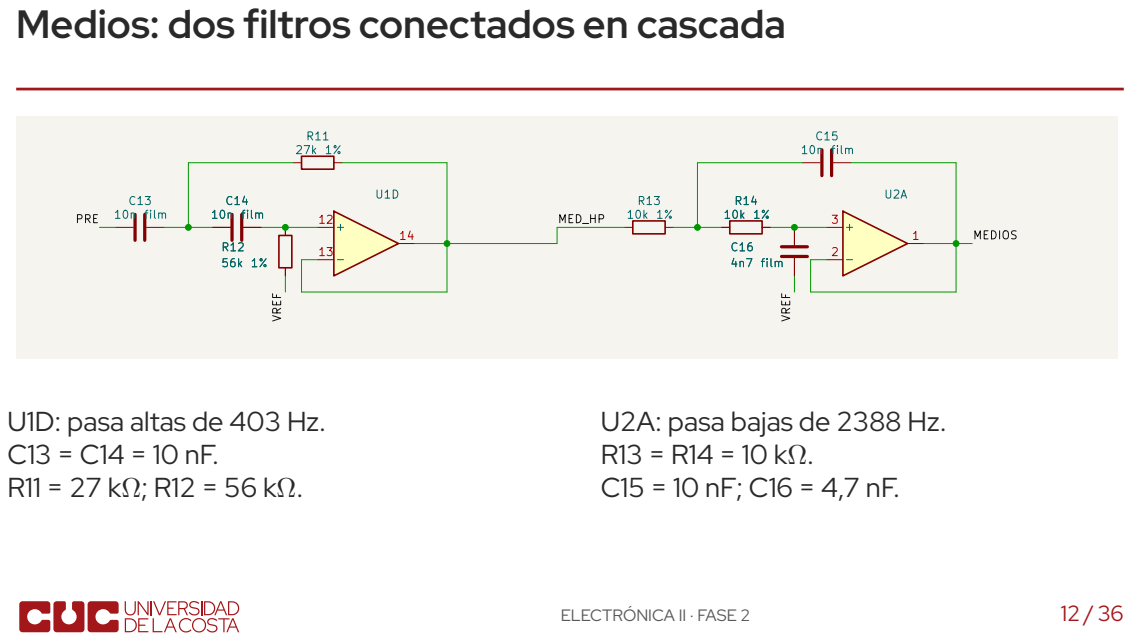
[picture p66: page 16]

U1D: pasa altas de 403 Hz.

U2A: pasa bajas de 2388 Hz.

## Agudos: pasa altas con U2B C18

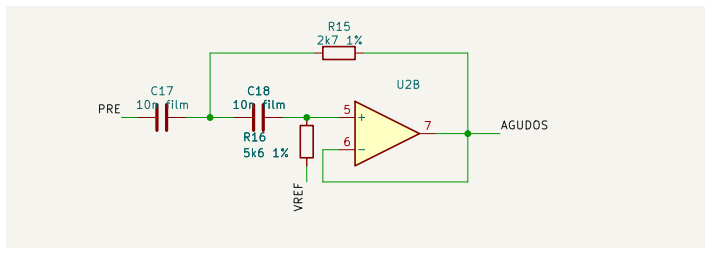
[picture p67: figure]
film; AGUDOS PRE; VREF C18

C17 = C18 = 10 nF.
R15 = 2,7 kΩ; R16 = 5,6 kΩ.

## Agudos: pasa altas con U2B C18

C17 = C18 = 10 nF.
R15 = 2,7 kΩ; R16 = 5,6 kΩ.

Corte simulado: 4026 Hz.
La salida llega a RV4, que regula su aporte a la mezcla.

## Frecuencias calculadas y simuladas

Filtro | Cálculo de f0 | Corte simulado
Graves (U1C), pasa bajas | 232 Hz | 239 Hz
Medios (U1D), pasa altas | 409 Hz | 403 Hz
Medios (U2A), pasa bajas | 2322 Hz | 2388 Hz
Agudos (U2B), pasa altas | 4093 Hz | 4026 Hz
Previo al ADC (U2D) | 4949 Hz | 5101 Hz

f0,PB =

1
2πR√C1C2

f0,PA =

1
2πC√R1R2

Cada sección es de segundo orden. La cascada de medios es de cuarto orden.

## Deslizables, inversión de medios y sumador

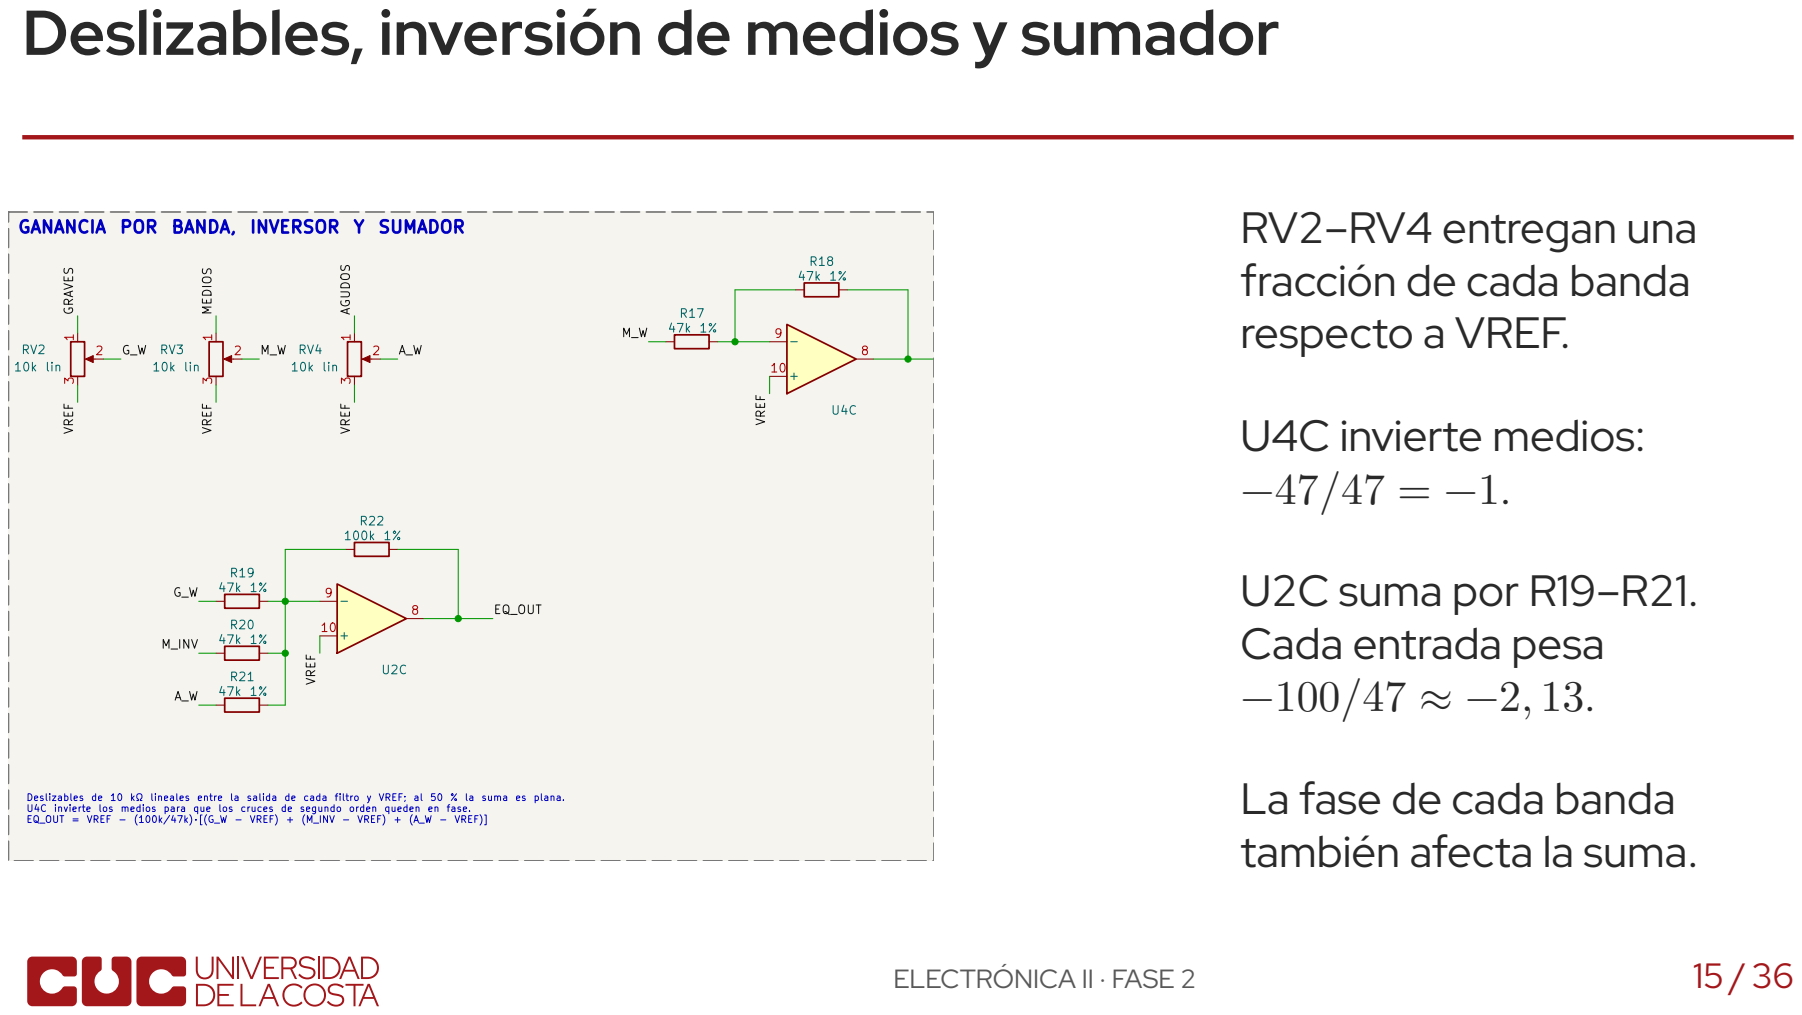
[picture p68: page 20]

GANANCIA POR BANDA, INVERSOR Y SUMADOR

RV2–RV4 entregan una
fracción de cada banda
respecto a VREF.

La fase de cada banda
también afecta la suma.

Deslizables de 10 kΩ lineales entre la salida de cada filtro y VREF; al 50 % la suma es plana. U4C invierte los medios para que los cruces de segundo orden queden en fase. EQ_OUT = VREF − (100k/47k)·[(G_W − VREF) + (M_INV − VREF) + (A_W − VREF)]

## Respuesta de la suma antes y después de corregir la fase

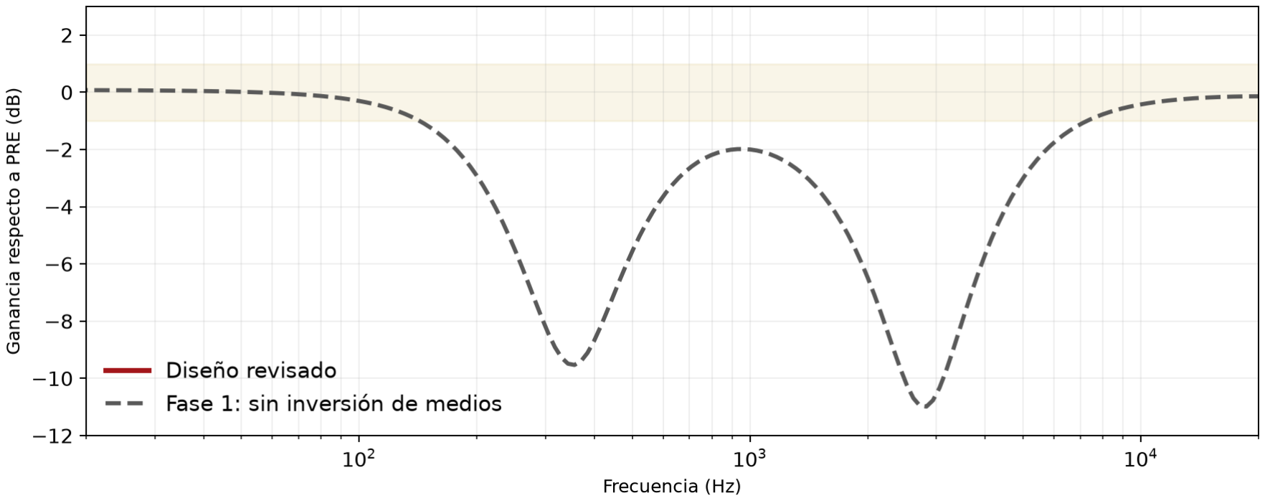
[picture p69: figure]

U4C, R17 y R18 corrigen la fase de medios. Al centro: de −11 dB a una respuesta entre −0, 27 y +0, 88 dB respecto a PRE.

## Respuesta de la suma antes y después de corregir la fase

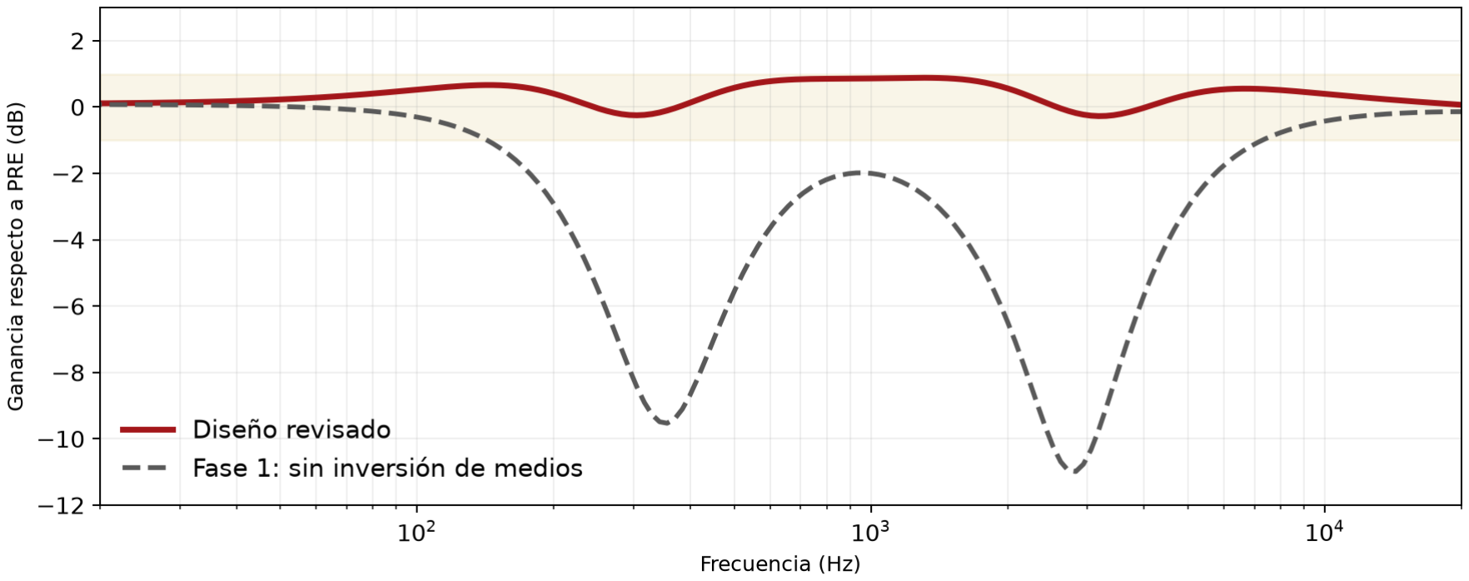
[picture p70: figure]

U4C, R17 y R18 corrigen la fase de medios. Al centro: de −11 dB a una respuesta entre −0, 27 y +0, 88 dB respecto a PRE.

## Detector de pico y seguidor para el ADC R27

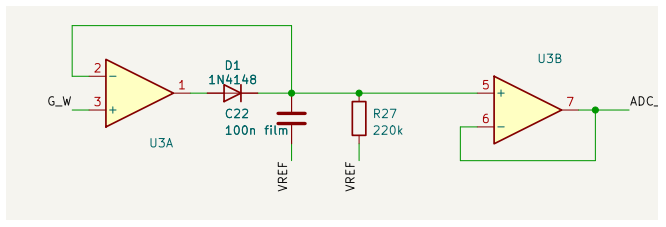
[picture p71: figure]
C22 100n film; VREF; VREF G_W; ADC_G; 100n film

U3A + D2
Cargan C22 durante los picos positivos. El diodo queda dentro de la realimentación.

## Detector de pico y seguidor para el ADC R27

U3A + D2
Cargan C22 durante los picos positivos. El diodo queda dentro de la realimentación.

R27 + C22 + U3B
Descarga de 22 ms y seguidor para el ADC. Se resta VREF para obtener el nivel de graves.

## Niveles de los detectores con un tono de 1 kHz


Tono de 1 kHz

Graves | 15 mV
Medios | 304 mV
Agudos | 17 mV

τ = 220 kΩ ⋅ 100 nF = 22 ms

D2 a D3, C22 a C24 y R27 a R29.
La lectura corresponde a la envolvente.

## Antes de la FFT: filtro y entrada al ADC R26

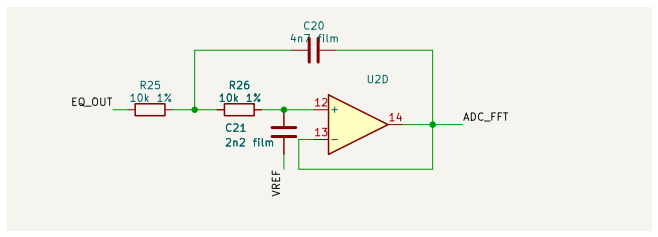
[picture p72: figure]
film; C21 2n2 film; ADC_FFT EQ_OUT; VREF R26

U2D, R25 y R26 de 10 kΩ.
C20 = 4,7 nF; C21 = 2,2 nF.

ADC_FFT llega a GPIO33.
Corte simulado: 5101 Hz.

A 15 kHz atenúa 19,3 dB. Una señal fuerte todavía puede producir aliasing.

## Muestreo y resolución de la FFT

1024

muestras por bloque

fs = 20 kS/s
Δf = 19, 53 Hz
Tiempo de bloque: 51,2 ms

## Muestreo y resolución de la FFT

1024

muestras por bloque

fs = 20 kS/s
Δf = 19, 53 Hz
Tiempo de bloque: 51,2 ms

Un tono de 1 kHz
queda cerca del bin 51 (996,1 Hz).

Límite del análisis
Se muestran aproximadamente 40 Hz–5 kHz. El filtro atenúa el aliasing; no lo elimina.

U2D entrega la señal a GPIO33 de U5. A 15 kHz: −19, 3 dB simulados.

## Pantalla: conexión SPI y control de luz

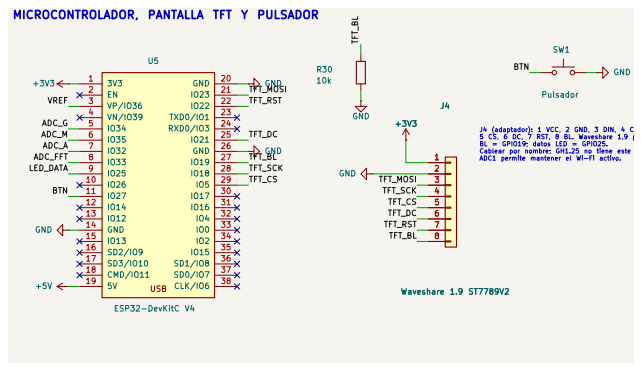
[picture p73: figure]
GND; SW1 Pulsador; J4 Waveshare 1.9 ST7789V2 ⁺3V3 GND; USB; GND 14; CMD/IO11 18; TXD0/IO1; 23 RXD0/IO3; 25 GND; 37 CLK/IO6; ESP32⁻DevKitC V4 GND; BTN; ADC_A; TFT_BL; TFT_SCK; TFT_MOSI ADC_M; LED_DATA; TFT_DC; ADC_FFT; TFT_CS VREF; TFT_MOSI; VREF; ADC_G; TFT_RST; TFT_CS; MICROCONTROLADOR, PANTALLA TFT Y PULSADOR; J4 Waveshare 1.9 ST7789V2

J4 (adaptador): 1 VCC, 2 GND, 3 DIN, 4 CLK, 5 CS, 6 DC, 7 RST, 8 BL. Waveshare 1,9 pulgadas. BL = GPIO19; datos LED = GPIO25. Cablear por nombre; GH1.25 no tiene este ADC1 permite mantener el Wi⁻Fi activo.

U5: ESP32-DevKitC.
J4: cable de ocho señales.

DIN y CLK llevan los datos. CS, DC y RST controlan la
pantalla.

GPIO19 controla BL; R30 lo mantiene apagado al
arrancar.

## Waveshare 1,9 pulgadas · 170 × 320

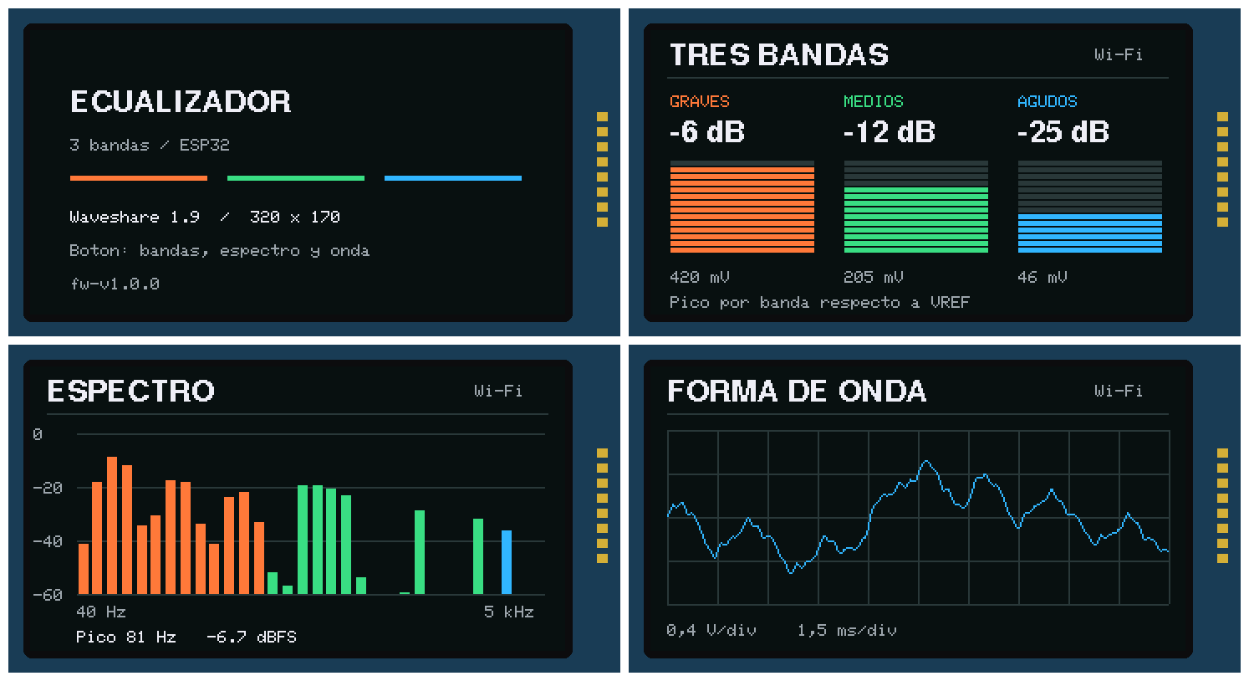
[picture p74: figure]

ST7789V2 por SPI
En horizontal: 320 × 170.

Módulo: 51,2 × 27,3 mm.
Área activa: 42,72 × 22,70 mm.

J4 usa un cable adaptador de 8 señales.
Verificar el orden por nombre; el conector del módulo es GH1.25.

## Circuito de alimentación y datos de los LED +5V GND

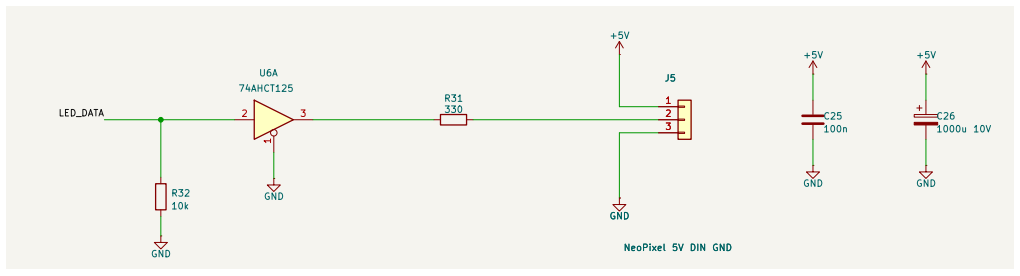
[picture p75: figure]
J5 NeoPixel 5V DIN GND; GND +5V; 100n GND; 1000u 10V +5V GND; 3 U6A 74AHCT125; GND; LED_DATA

U6: 74AHCT125 a 5 V. R31: 330 Ω en DIN. C25: 100 nF. C26: 1000 μF.
J5 conecta la tira; J6 recibe la fuente de 5 V / 3 A. R32 mantiene los datos bajos durante el arranque.

## NeoPixel: canal, difusor y alimentación

Dos tramos de 100 mm: 12 LED.

Canales interiores de
102 × 10,6 × 3 mm.

GPIO25 → 74AHCT125
→ 330 Ω → DIN.

Fuente externa 5 V / 3 A.
1000 μF de reserva.

Brillo inicial 32/255; iluminación fija y tenue.

## NeoPixel: canal, difusor y alimentación


Dos tramos de 100 mm: 12 LED.

Canales interiores de
102 × 10,6 × 3 mm.

GPIO25 → 74AHCT125
→ 330 Ω → DIN.

Fuente externa 5 V / 3 A.
1000 μF de reserva.

Brillo inicial 32/255; iluminación fija y tenue.

## Esquemático y PCB: comprobaciones distintas


Esquemático
ERC: 0 errores, 0 advertencias. 59 redes coinciden pin a pin.

PCB
Una cara, 200 × 120 mm.
Cobre por debajo y 80 puentes aislados.

DRC: 0 errores, 0 conexiones abiertas.

## D.2: PCB de una cara con puentes

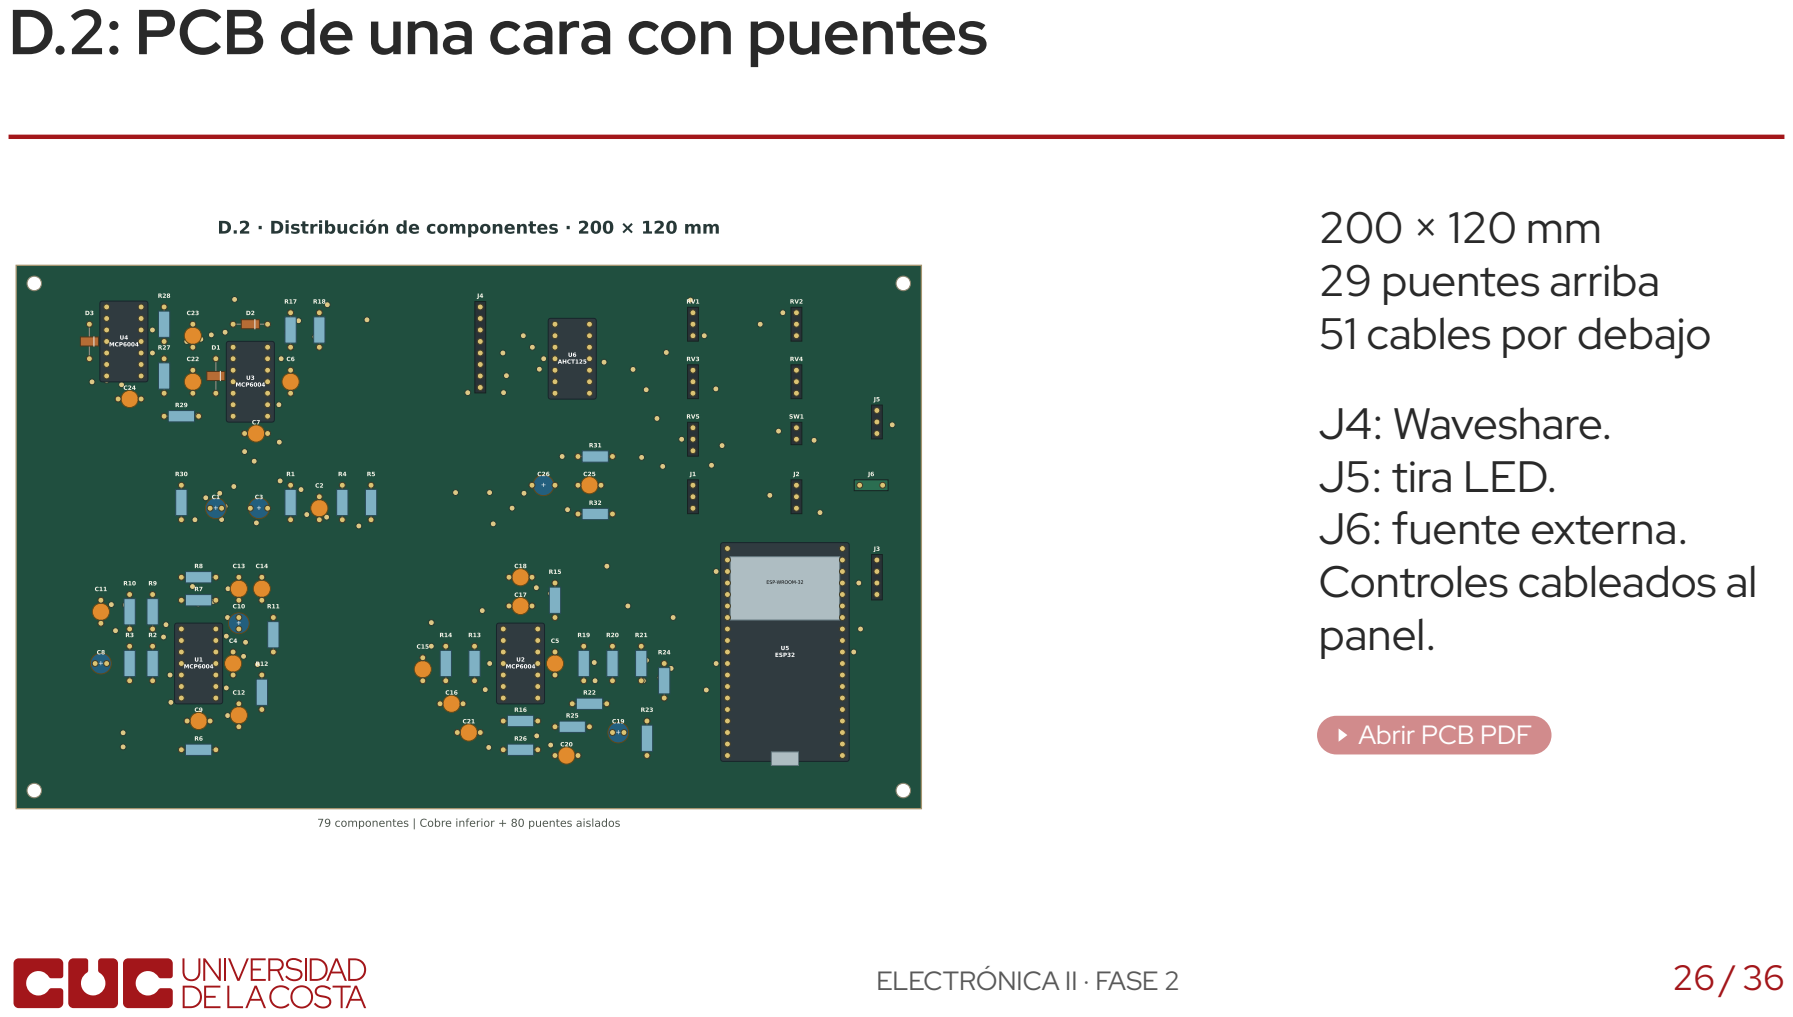
[picture p76: page 35]

D.2 · Distribución de componentes · 200 × 120 mm

79 componentes | Cobre inferior + 80 puentes aislados

## Distribución del panel y del gabinete


208 × 128 × 49,5 mm · acabado grafito · tapa magnética · canales LED.

## Tapa magnética, sin tornillos a la vista

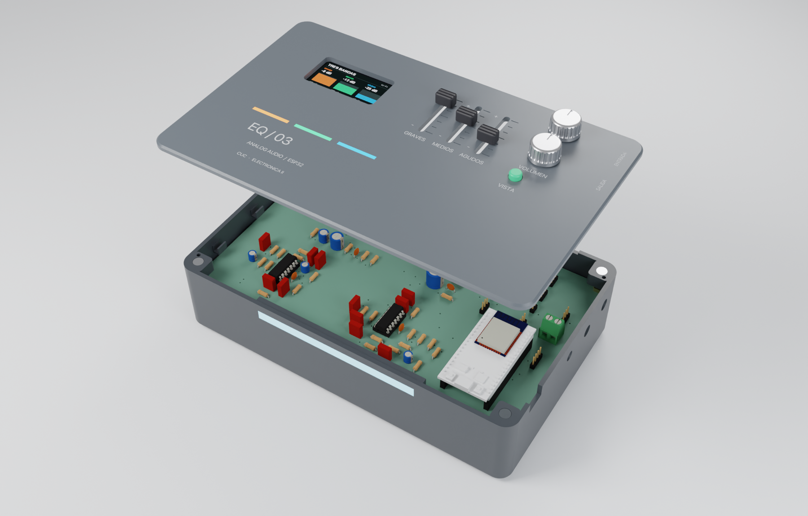
[picture p77: figure]

Cuatro pares de imanes:
8 discos de Ø6 × 2 mm.

Alojamientos Ø6,3 × 2,2 mm. Techo de tapa: 0,8 mm.

Dos guías de registro y un uñero posterior.

La PCB conserva fijación
mecánica independiente.

## Ensayo de hoy: generador y osciloscopio

Entrada PRE
Senoidal de 200 mV pico a pico. Offset: 1,65 V.

CH1: PRE. CH2: salida del filtro. Masas al GND del circuito.

100 Hz: graves.
1 kHz: medios.
8 kHz: agudos.

Qué explicar
Comparar amplitud y fase.
|H| = Vpp,out/Vpp,in.

En Velxio: clic derecho sobre el cable y Add to scope.

Los operacionales de esta prueba son ideales. El ensayo físico debe usar el MCP6004 y alimentación de 3,3 V.

## Velxio: tres tonos, tres bandas


Ejecutado en el navegador

100 Hz: graves.
1 kHz: medios.
8 kHz: agudos.

Tres archivos .vlx
con el motor SPICE activo.

Modelo de operacional ideal. Prueba de selectividad; no del equipo completo.

## Velxio: circuito, ESP32 y pantalla

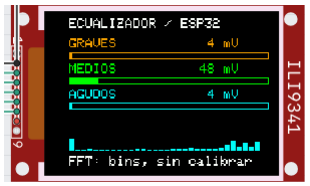
[picture p78: figure]

Captura de la TFT con entrada de 1 kHz.

Entrada → filtros → detectores → ADC → TFT.

100 Hz: predominan graves.
1 kHz: predominan medios.
8 kHz: predominan agudos.

ABRIR VELXIO / QEMU (https://velxio.dev/editor?esp32sim=qemu)

## Importar integrado-1000Hz.vlx y

pulsar Run.

TFT ILI9341 de sustitución; operacionales y diodos ideales. FFT sin calibración de frecuencia. El amplificador de potencia y los LED se ensayan aparte.

## Ensayo animado de los 12 NeoPixel

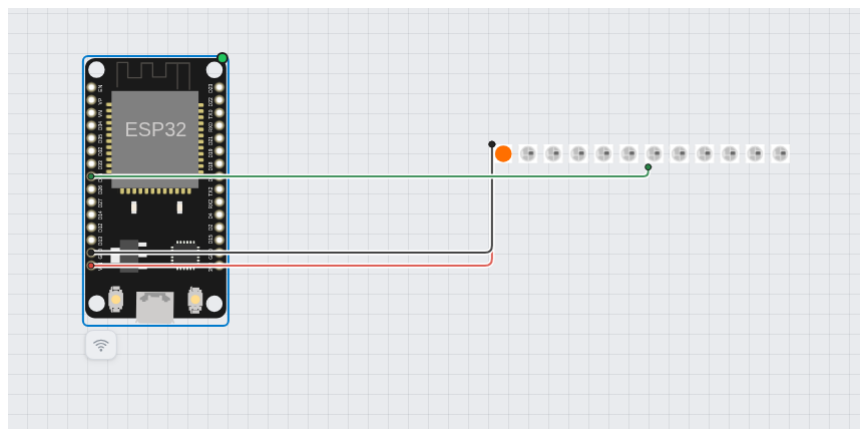
[picture p79: figure]

ESP32, GPIO25.
Brillo 32/255.

Cuatro LED naranjas,
cuatro verdes y cuatro cian.

La secuencia avanza cada
160 ms.

Abrir ensayo LED

Patrón programado sin
entrada de audio.

## Ensayo animado de los 12 NeoPixel

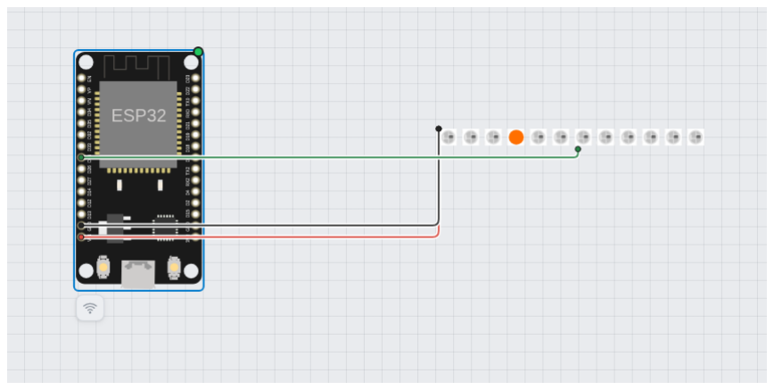
[picture p80: figure]

ESP32, GPIO25.
Brillo 32/255.

Cuatro LED naranjas,
cuatro verdes y cuatro cian.

La secuencia avanza cada
160 ms.

Abrir ensayo LED

Patrón programado sin
entrada de audio.

## Abrir la simulación durante la exposición

ABRIR VELXIO

## https://velxio.dev/editor?esp32sim=qemu

Descargar un caso y usar File → Import project.

100 Hz → graves
1 kHz → medios
8 kHz → agudos
Ensayo LED → pulsar Run

Abrir carpeta de casos

Los casos .vlx también van adjuntos al PDF.

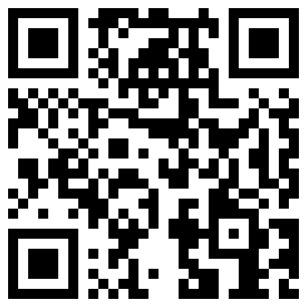
[picture p81: figure]

QR: abre el editor.
Importar después el caso.

## Resultados de las comprobaciones

Comprobación | Resultado
Esquemático | ERC sin errores; 59 redes coinciden pin a pin.
PCB de una cara Cobre inferior y 80 puentes; continuidad comprobada.
Filtros en Velxio | Graves a 100 Hz, medios a 1 kHz y agudos a 8 kHz.
Firmware | Compilación ESP32; pruebas DSP y dibujo por franjas.
Iluminación | Secuencia de 12 NeoPixel ejecutada por separado.

Resultados obtenidos con herramientas de diseño y simulación.

## Fuentes y archivos para la sustentación

- Texas Instruments: Sallen-Key, SLOA024B; 74AHCT125, SCLS264R.
- Microchip: ficha técnica MCP6004.
- Waveshare: ficha y esquema del módulo LCD de 1,9 pulgadas.
- Analog Devices: ADAU1701. WLED: documentación Audio Reactive.
- Adafruit: NeoPixel Überguide. Velxio: documentación del simulador.

Repositorio

## https://github.com/davixcky/ecualizador-esp32

Fuentes del informe y de esta presentación en docs/latex/. Resultados, esquemático, PCB y modelos 3D incluidos.

Anexo: esquema completo para ampliar 1 | 2 | 3 | 4 | 5 | 6 | 7 | 8 | 9 | 10 | 11
1 | 2 | 3 | 4 | 5 | 6 | 7 | 8 | 9 | 10 | 11

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
FGH Date: 2026⁻10⁻22 KiCad E.D.A. 10.0.0

Size: A2 | Rev: D.2
| Id: 1/1

Title: Ecualizador de audio de tres bandas con visualizador ESP32

File: ecualizador.kicad_sch

Sheet: /

Electrónica II — Universidad de la Costa

Amplificadores operacionales MCP6004 (riel a riel, 3,3 V)

Generado desde herramientas/circuito.py ¹ 2

3 RV3

10k lin | PWR_FLAG

C7

100n V+

4 V- 11 U4E GND

1 -

2 +

3 | U1A | 8 ⁻

9 +

10 | U4C

D1
1N4148 C22

100n film

R27

220k 1 ⁻

2 +

3 | U3A ¹
2

3 RV4

10k lin | D2

1N4148 V+

4 V- 11 U1E C18

10n film

R15
2k7 1%+

5 -

6

7 U2B

C24

100n film

+

5 -

6

7 U3B

1 ⁻

2 +

3 | U4A | R28
220k | + 12 -

13

14 U4D

C17
10n film

R16
5k6 1% +

12 -

13

14 U3D

C12
47n film

R11
27k 1%

R17
47k 1%

R18
47k 1%

C6

100n C5

100n V+

4 V- 11 U3E V+

4 V- 11 U2E 8 -

9 +

10 | U2C R22 100k 1%

8 -

9 +

10 | U1C R10

10k 1%

C11
100n film

D3

1N4148 R20
47k 1%

R19
47k 1%

R9
10k 1%

R21
47k 1%

PWR_FLAG

GND

GND | GND

R3

| 10k 1%

C8

10u 16V ⁺3.3VA | +5V C16

4n7 film

1 -

2 +

3 | U2A R26

10k 1%

R14
10k 1%

C21

2n2 film

R13
10k 1% +5V 9 | 8 10 | U6C

74AHCT125 GND

C20
4n7 film

+

12 -

13

14 U2D

GND

GND

C25

100n R25
10k 1% | +5V 12 | 11 13 | U6D
74AHCT125 | GND
GND | +5V | GND

7 VCC 14 U6E 74AHCT125 +5V R29

220k | +

5 -

6

7 U4B

GND

8 ⁻

9 +

10 | U3C
C23

100n film

SW1 Pulsador | GND

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
J4 Waveshare 1.9 ST7789V2 ⁺3V3 GND

GND

R30

10k +5V | USB

3V3 1

EN 2

VP/IO36 3
VN/IO39 4

IO34 5

IO35 6

IO32 7

IO33 8

IO25 9

IO26 10

IO27 11

IO14 12

IO12 13 GND 14

IO13 15

SD2/IO9 16

SD3/IO10 17 | CMD/IO11 18
5V 19 | GND | 20
IO23 | 21
IO22 | 22
TXD0/IO1 | 23 RXD0/IO3 | 24
IO21 | 25 GND | 26
IO19 | 27
IO18 | 28
IO5 | 29
IO17 | 30
IO16 | 31
IO4 | 32
IO0 | 33
IO2 | 34
IO15 | 35
SD1/IO8 | 36
SD0/IO7 | 37 CLK/IO6 | 38 U5

ESP32⁻DevKitC V4 GND

1

2

3

J5NeoPixel 5V DIN GND

GND

R24

47k | 1
2

3 RV5

10k log | GND | +5VR
| | S T

J2

Salida de línea 3,5 mm

GND

GND

1

2

3
4

# J3PAM8403 +3V3 GND +5V R6

100k GND

1
2

3 RV1

10k log +3.3VA | R5
10k | GND

C9
1u film

C10

10u 16V R1
10 | R8
10k 1% ⁺3V3 | GND

C19

10u 16V | R23

100 ⁺

12 -

13

14 U1D

GND

GND +5VR32

10k 1

2

J6
Entrada 5V 3A ⁺5V GND

C15
10n film

R

S

T

J1

Entrada de línea 3,5 mm

R4
10k | R7

22k 1% ⁺

5 -

6

7 U1B

PWR_FLAG

C13
10n film

C26

1000u 10V 1

2 | U6A3
74AHCT125 ⁺5V | GND

R2

10k 1%

R12

56k 1%

C1

100u 10V | C2
100n | C4
100n 1

2

3 RV2

10k lin | GND

4

5 | U6B6
74AHCT125 R31

# 330 C14 10n film

C3
470u 10V

IN_L

IN_L | VREF LINEA | BTN
A_W | VREF

IN_R

IN_R

LINEA

ADC_G

GRAVES VREF

AGUDOS

ADC_M

G_W

PRE GRAVES | MEDIOS

LED_5V

ADC_A M_W

TFT_BL

TFT_SCK

AMP_IN

TFT_MOSI ADC_M

LED_DATA | BTN
TFT_DC | TFT_BL VREF

ADC_FFT

TFT_CS VREF VREF

# TFT_MOSI VREF

VREF

ADC_G

TFT_RST VREF

LINEA | VREF
AMP_IN | VREF M_INV | PRE MEDIOS VREF MED_HP

LED_DIN LED_DATA VREF

LED_5V | LED_DIN
EQ_OUT VREF | VREF

A_W

M_W

G_W

PRE | VREF | EQ_OUT | VREF | VREF
VREF | PRE

ADC_A VREF M_W

M_INV EQ_OUT LED_DATA | VREF

A_W AGUDOS

TFT_BL

TFT_RST

TFT_SCK

G_W

TFT_CS

TFT_DC

ADC_FFT | Diodo dentro del lazo: Ch se carga al pico real sin la caída de 0,6 V. τ = Rd·Ch = 220k·100n = 22 ms. ADC_x − VREF = pico de la banda. MEDIOS, pasa altas: fc = 1/(2π·10n·√(27k·56k)) = 409 Hz
J4 (adaptador): 1 VCC, 2 GND, 3 DIN, 4 CLK, 5 CS, 6 DC, 7 RST, 8 BL. Waveshare 1,9 pulgadas. BL = GPIO19; datos LED = GPIO25. Cablear por nombre; GH1.25 no tiene este orden. ADC1 permite mantener el Wi⁻Fi activo. J6 alimenta la placa, el PAM8403 y los LED. No conectar simultáneamente VBUS del USB. J5: 1 = 5 V, 2 = DIN, 3 = GND. R31 cerca del primer LED; C26 junto a J5. U6 debe ser AHCT (umbral TTL): un 74HC125 a 5 V no garantiza reconocer 3,3 V. La tira vuelve a GND de potencia; no usar VREF como retorno. GRAVES, pasa bajas: fc = 1/(2π·10k·√(100n·47n)) = 232 Hz | MICROCONTROLADOR, PANTALLA TFT Y PULSADOR

GANANCIA POR BANDA, INVERSOR Y SUMADOR

C3: picos del PAM8403 (J3) | ENTRADA DE LÍNEA Y PREAMPLIFICADOR (G = 1 + R7/R8 = 3,2)

SALIDA DE AUDIO Y ANTIALIASING

R4–R5 mezclan a mono; RV1 ajusta el nivel. Con los deslizables al máximo, la entrada debe ser ≤ 0,11 V de pico (la pantalla avisa CLIP). | MEDIOS, pasa bajas: fc = 1/(2π·10k·√(10n·4n7)) = 2,3 kHz VREF es la tierra de señal: todas las etapas oscilan alrededor de 1,65 V con 3,3 V. | J2: salida de línea. J3: módulo PAM8403 y parlante; RV5 = volumen. R23 protege la salida de un corto. Antialiasing: fc = 1/(2π·10k·√(4n7·2n2)) = 4,95 kHz; fs = 20 kS/s. | U4D: libre, seguidor de VREF. FILTROS ACTIVOS SALLEN-KEY DE SEGUNDO ORDEN (ganancia unitaria, Q ≈ 0,73)

ALIMENTACIÓN ANALÓGICA Y VREF = 1,65 V

Filtro RC R1⁻C1: fc ≈ 159 Hz. C4–C7: desacoplo local de los MCP6004. Deslizables de 10 kΩ lineales entre la salida de cada filtro y VREF; al 50 % la suma es plana. U4C invierte los medios para que los cruces de segundo orden queden en fase. EQ_OUT = VREF − (100k/47k)·[(G_W − VREF) + (M_INV − VREF) + (A_W − VREF)] | DETECTORES DE PICO DE PRECISIÓN Y SEGUIDORES

ILUMINACIÓN NEOPIXEL · 12 LED · FUENTE EXTERNA 5 V / 3 A

AGUDOS, pasa altas: fc = 1/(2π·10n·√(2k7·5k6)) = 4,1 kHz +3V3 R1

10 +3.3VA C1
100u 10V C3

470u 10V

J1

Entrada de línea 3,5 mm

R

S

T GND

C9 RV1 | 1u film
10k log | 1
| 2
| 3 GND
| R6

100k C14

10n film

R12

56k 1%

R10
10k 1%

C12
47n film

GND

GND | GND

R3

10k 1%

C8

10u 16V | D1

1N4148 C22

100n film

D2

## 1N4148 C18 10n film R16 5k6 1%

J4 Waveshare 1.9 ST7789V2

1

2

3
4

5

6

7

8 ⁺3V3 R26

10k 1%

C21

2n2 film

R14
10k 1%

C16
4n7 film

J2

Salida de línea 3,5 mm

R

S

T +5V RV5

10k log 1
2
3 R24
47k GND | GND

C23

100n film

D3
1N4148 C24

100n film

El esquema está dentro de esta presentación. En PDF, ampliar con zoom; también se incluye como archivo independiente en el paquete para exposición.
