davixcky/ecualizador-esp32/docs/latex/presentacion-notas.pdf

## Ecualizador de audio de tres bandas

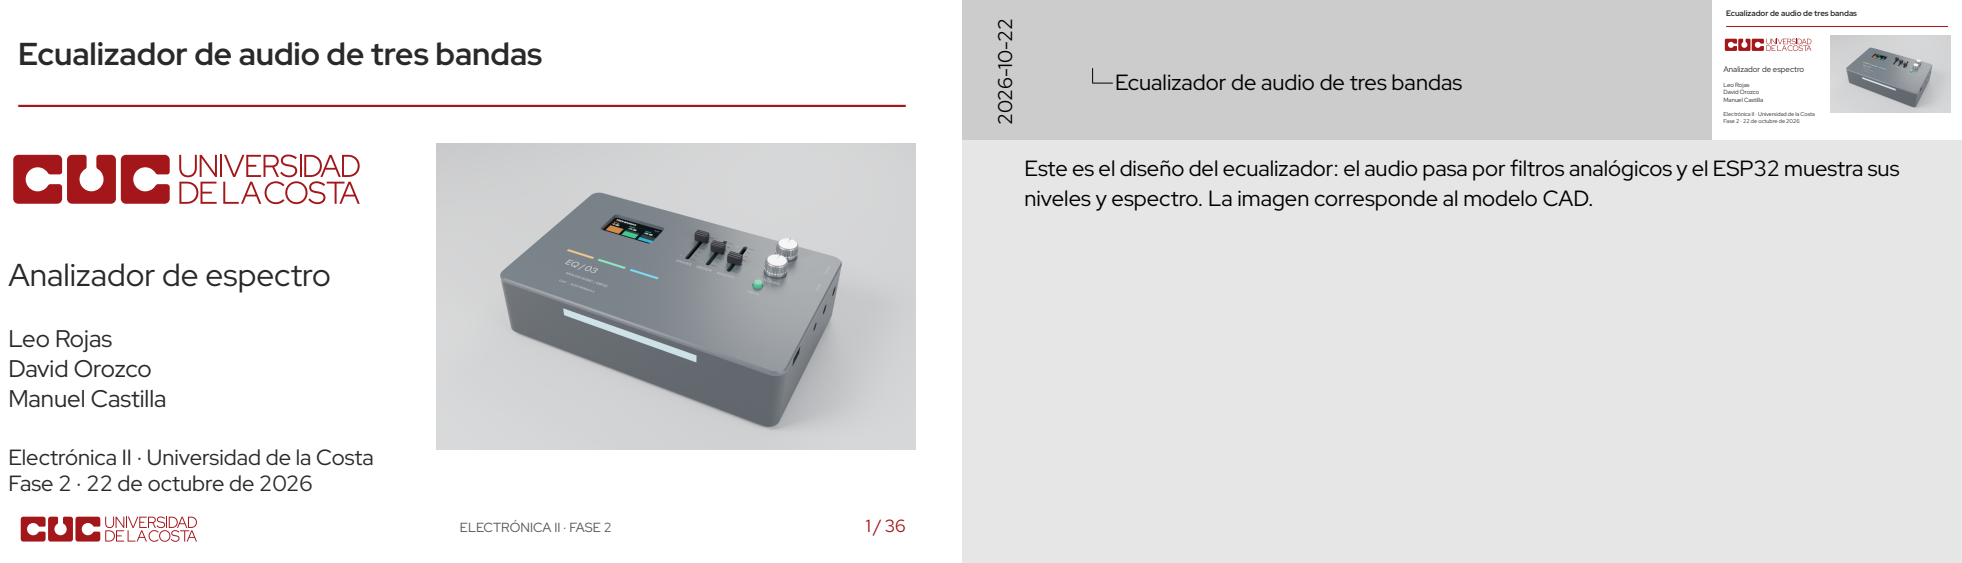
[picture p82: page 1]
Leo Rojas David Orozco Manuel Castilla; ELECTRÓNICA II · FASE 2

Ecualizador de audio de tres bandas

Analizador de espectro

Leo Rojas David Orozco Manuel Castilla

Electrónica II · Universidad de la Costa
Fase 2 · 22 de octubre de 2026

Este es el diseño del ecualizador: el audio pasa por filtros analógicos y el ESP32 muestra sus
niveles y espectro. La imagen corresponde al modelo CAD.

## Objetivos del proyecto

Objetivo general
Desarrollar un ecualizador de audio de tres bandas que permita ajustar graves, medios y agudos, reproducir la señal procesada y visualizar sus niveles y espectro mediante un ESP32.

Tres objetivos específicos
1. Diseñar los filtros activos y las etapas de ajuste y suma para controlar las tres bandas de audio.
2. Integrar la salida de línea, el amplificador y los controles en un equipo con PCB de una cara y gabinete propio.
3. Programar la adquisición y visualización con el ESP32, y evaluar el equipo mediante simulación y mediciones de laboratorio.

Objetivos del proyecto

Objetivo general Desarrollar un ecualizador de audio de tres bandas que permita ajustar graves, medios y agudos, reproducir la señal procesada y visualizar sus niveles y espectro mediante un ESP32.

Tres objetivos específicos
1. Diseñar los filtros activos y las etapas de ajuste y suma para controlar las tres bandas de audio. 2. Integrar la salida de línea, el amplificador y los controles en un equipo con PCB

de una cara y gabinete propio. 3. Programar la adquisición y visualización con el ESP32, y evaluar el equipo

2026-10-22

mediante simulación y mediciones de laboratorio.

Objetivos del proyecto

Los objetivos describen las metas del proyecto.

## Antecedentes y decisión de diseño

Estado del arte

Referencia | Aporte | Qué tomamos
Sallen-Key / TI | Filtros activos de segundo or-
| den | Cálculo de los cortes y de Q.
ADAU1701 / Analog Devices | Procesamiento digital progra-
| mable | Punto de comparación con la
| | ruta analógica.
WLED Audio Reactive | Análisis de audio para ilumina-
| ción | Referencia de visualización
| | con ESP32.

Cada etapa tiene puntos de medida para comparar el montaje con el cálculo.

Fuentes: TI SLOA024B; ficha ADAU1701; documentación WLED.

Antecedentes y decisión de diseño

Estado del arte Referencia | Aporte | Qué tomamos Sallen-Key / TI | Filtros activos de segundo or- den | Cálculo de los cortes y de Q.
ADAU1701 / Analog Devices | Procesamiento digital progra- mable | Punto de comparación con la
ruta analógica. WLED Audio Reactive | Análisis de audio para ilumina- ción | Referencia de visualización
| | con ESP32.

Cada etapa tiene puntos de medida para comparar el montaje con el cálculo.

2026-10-22

Fuentes: TI SLOA024B; ficha ADAU1701; documentación WLED.

Antecedentes y decisión de diseño

Los filtros Sallen-Key nos permiten calcular los cortes y medir cada etapa. ADAU1701 resuel-ve la ecualización con procesamiento digital. WLED aporta una referencia de visualización con ESP32. Conservamos la ruta analógica para trabajar con sus nodos en el laboratorio.

## Materiales principales del prototipo

Componente | Cantidad | Función
MCP6004 + zócalos | 4 | 15 unidades activas y una de reserva
ESP32-DevKitC V4 | 1 | Adquisición, FFT, pantalla y Wi-Fi
Waveshare ST7789V2 de 1,9 pulga- das | 1 | Interfaz 170 × 320
Resistencias / condensadores | 32 / 26 | Filtros, acoples y alimentación
Potenciómetros / diodos | 5 / 3 | Ajuste y detección de picos
74AHCT125 / WS2812B | 1 / 12 LED | Adaptación de datos e iluminación
PAM8403 + parlante / fuente 5 V, 3 A | 1 juego | Salida de audio y alimentación

Lista por referencia en la BOM. Añadir cables de puente, cables, conectores, caja y tornillería.

Materiales principales del prototipo

Componente | Cantidad | Función MCP6004 + zócalos | 4 | 15 unidades activas y una de reserva ESP32-DevKitC V4 | 1 | Adquisición, FFT, pantalla y Wi-Fi Waveshare ST7789V2 de 1,9 pulga- das
1 | Interfaz 170 × 320
Resistencias / condensadores | 32 / 26 | Filtros, acoples y alimentación Potenciómetros / diodos | 5 / 3 | Ajuste y detección de picos 74AHCT125 / WS2812B | 1 / 12 LED | Adaptación de datos e iluminación PAM8403 + parlante / fuente 5 V, 3 A | 1 juego | Salida de audio y alimentación

Lista por referencia en la BOM. Añadir cables de puente, cables, conectores, caja y tornillería.

2026-10-22

Materiales principales del prototipo

Distinguir la lista prevista del inventario ya adquirido. Los 79 componentes del esquema no incluyen todos los elementos externos y mecánicos.

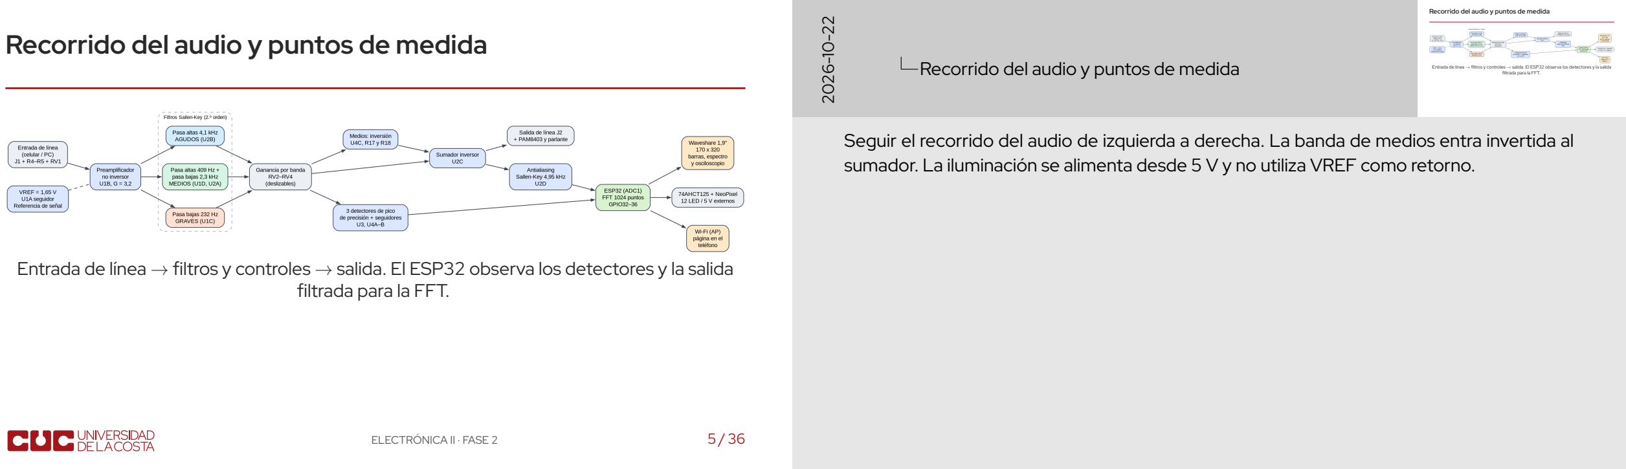
[picture p83: figure]
Recorrido del audio y puntos de medida; filtrada para la FFT.

Entrada de línea → filtros y controles → salida. El ESP32 observa los detectores y la salida

Entrada de línea → filtros y controles → salida. El ESP32 observa los detectores y la salida filtrada para la FFT.

Seguir el recorrido del audio de izquierda a derecha. La banda de medios entra invertida al sumador. La iluminación se alimenta desde 5 V y no utiliza VREF como retorno.

## El esquema completo: revisión D.2

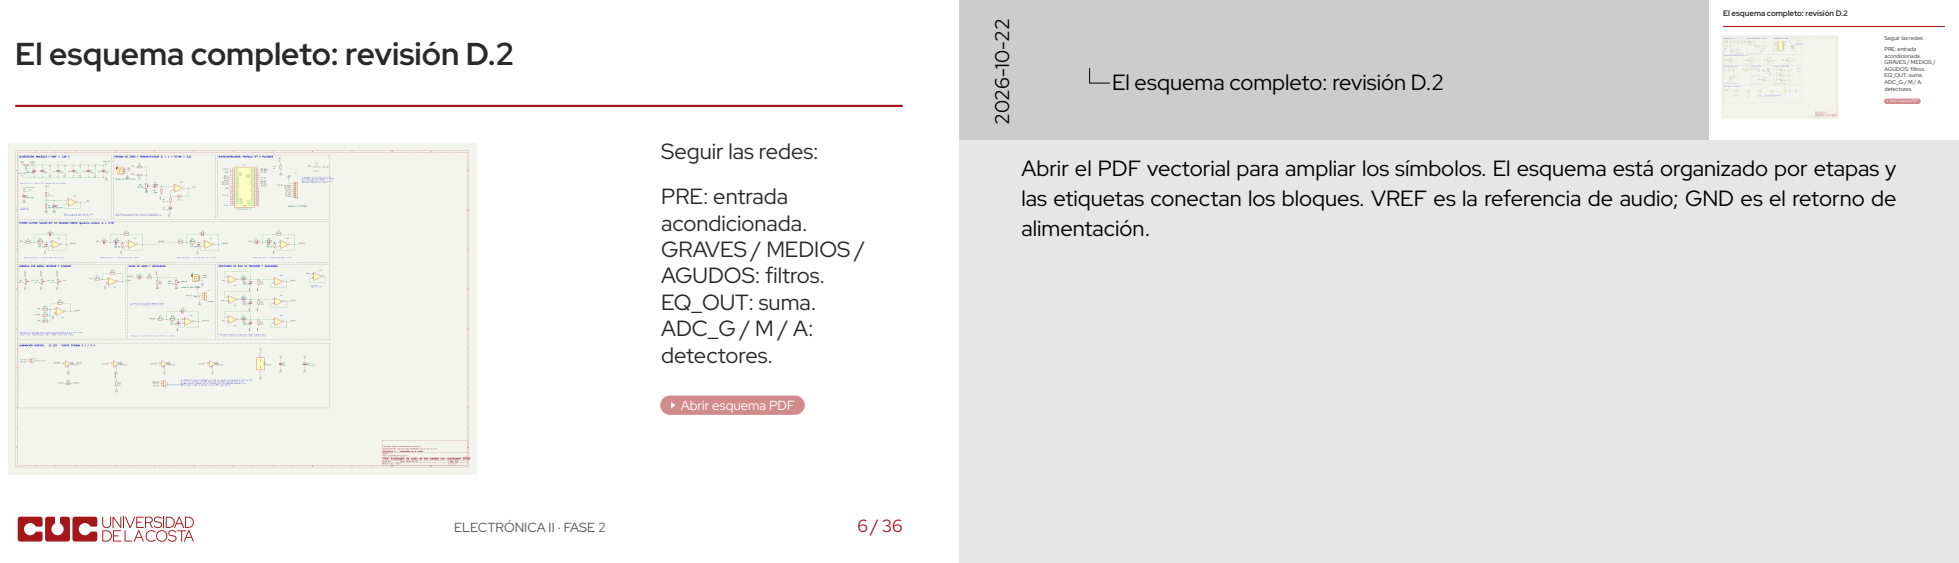
[picture p84: page 6]
PRE: entrada acondicionada. GRAVES / MEDIOS / AGUDOS: filtros. EQ_OUT: suma. ADC_G / M / A: detectores.

El esquema completo: revisión D.2

Seguir las redes:

PRE: entrada
acondicionada. GRAVES / MEDIOS / AGUDOS: filtros. EQ_OUT: suma. ADC_G / M / A: detectores.

Abrir esquema PDF

Abrir el PDF vectorial para ampliar los símbolos. El esquema está organizado por etapas y
las etiquetas conectan los bloques. VREF es la referencia de audio; GND es el retorno de
alimentación.

## Marco teórico: filtros activos Sallen-Key R10

10k 1%

R9
10k 1%

8 -

9 +

10 | U1C

C11
100n film

C12
47n film
GRAVES PRE | VREF R10
10k 1%

C12
47n film

U1C: pasa bajas de segundo orden.
R9 = R10; C11 realimenta y C12 va a VREF.

Para resistencias iguales y ganancia unitaria:

f0 =

1
2πR√C11C12

Q = 1
2

√
C11
C12

f0 fija la frecuencia natural; Q determina la forma de la respuesta. El corte a −3 dB coincide con f0 cuando Q = 1/√
2. En medios conectamos un pasa altas y un pasa bajas en cascada.
Fuente: Karki, Texas Instruments, SLOA024B. Valores aplicados al esquema del proyecto.

Marco teórico: filtros activos Sallen-Key R10

10k 1%

R9
10k 1%
8 -

9 +

10 | U1C

C11
100n film

C12
47n film
GRAVES PRE | VREF R10
10k 1%

C12
47n film

U1C: pasa bajas de segundo orden. R9 = R10; C11 realimenta y C12 va a VREF.

Para resistencias iguales y ganancia unitaria:

f0 =

1
2πR√C11C12

Q = 1

2√
C11 C12

f0 fija la frecuencia natural; Q determina la forma de la respuesta. El corte a −3 dB coincide con f0 cuando Q = 1/√
2. En medios conectamos un pasa altas y un pasa bajas en cascada.

2026-10-22

Fuente: Karki, Texas Instruments, SLOA024B. Valores aplicados al esquema del proyecto.

Marco teórico: filtros activos Sallen-Key

Señalar las dos resistencias, los dos condensadores y el operacional en la figura. La realimentación permite dar forma a la respuesta. No confundir frecuencia natural con corte: nuestros valores comerciales producen Q cercano a 0,73. La banda de medios combina dos secciones de segundo orden y por eso su respuesta completa es de cuarto orden.

## Marco teórico: ajustar y sumar las bandas

D

E

1
2

3 RV3
10k lin

8 ⁻

9 +

10 | U4C

1
2

3 RV4
10k lin

R17
47k 1%

R18
47k 1%

8 ⁻

9 +

10 | U2C

R22
100k 1%

R20
47k 1%

R19
47k 1%

R21
47k 1%

1
2

3 RV2
10k lin

G_W

GRAVES MEDIOS

M_INV

VREF

VREF VREF

A_W

M_W

G_W

VREF EQ_OUT VREF

M_W

A_W AGUDOS

GANANCIA POR BANDA, INVERSOR Y SUMADOR

Deslizables de 10 kΩ lineales entre la salida de cada filtro y VREF; al 50 % la suma es plana. U4C invierte los medios para que los cruces de segundo orden queden en fase. EQ_OUT = VREF − (100k/47k)·[(G_W − VREF) + (M_INV − VREF) + (A_W − VREF)]

Los deslizables ajustan cuánto aporta cada banda.

El sumador combina esas señales con un peso −Rf/Ri

U4C invierte medios antes de sumarlos. La fase influye en el resultado.

Todas las señales se expresan respecto a VREF: vx = Vx − VREF.

vEQ = −

100
47 (vGW
+ vMINV

+ vAW

)

Marco teórico: ajustar y sumar las bandas

D

E

1
2

3 RV3
10k lin

8 ⁻

9 +

10 | U4C

1
2

3 RV4
10k lin

R17
47k 1%

R18
47k 1%

8 ⁻

9 +

10 | U2C R22 100k 1%

R20
47k 1%

R19
47k 1%

R21
47k 1%

1
2

3 RV2
10k lin

G_W

GRAVES MEDIOS

M_INV

VREF

VREF VREF

A_W

M_W

G_W

VREF EQ_OUT VREF

M_W

A_W AGUDOS

GANANCIA POR BANDA, INVERSOR Y SUMADOR

Deslizables de 10 kΩ lineales entre la salida de cada filtro y VREF; al 50 % la suma es plana. U4C invierte los medios para que los cruces de segundo orden queden en fase. EQ_OUT = VREF − (100k/47k)·[(G_W − VREF) + (M_INV − VREF) + (A_W − VREF)]

Los deslizables ajustan cuánto aporta cada banda.

El sumador combina esas señales con un peso −Rf/Ri . U4C invierte medios antes de

sumarlos. La fase influye en el resultado.

Todas las señales se expresan respecto a VREF: vx = Vx − VREF.

vEQ = −

100
47 (vGW + vMINV + vAW

) 2026⁻¹0⁻22

Marco teórico: ajustar y sumar las bandas

Esta ecuación describe el circuito con alimentación única: primero restamos la referencia de 1,65 voltios. El signo menos corresponde al sumador inversor. La rama de medios ya llega invertida por U4C. Al mover un deslizable cambia la contribución de esa banda; la respuesta total depende también de las fases. La salida de línea entrega la señal al amplificador de potencia que mueve el parlante.

## 3,3 V de alimentación; 1,65 V de referencia

AB

PWR_FLAG

C7

100n V+

4 V- 11 U4E GND

1 -

2 +

3 | U1A

V+

4 V- 11 U1E

C6

100n C5

100n V+

4 V- 11 U3E V+

4 V- 11 U2E

PWR_FLAG

GND

GND | GND

R3
| 10k 1%

C8

10u 16V ⁺3.3VA

+3.3VA

R1
10

+3V3

PWR_FLAG
+5V

R2
10k 1%

C1

100u 10V | C2
100n | C4
100n

C3
470u 10V

VREF

C3: picos del PAM8403 (J3)

VREF es la tierra de señal: todas las etapas oscilan alrededor de 1,65 V con 3,3 V.

ALIMENTACIÓN ANALÓGICA Y VREF = 1,65 V

Filtro RC R1⁻C1: fc ≈ 159 Hz. C4–C7: desacoplo local de los MCP6004.

+3V3 R1

10 +3.3VA C1

# 100u 10V C3

470u 10V

GND

GND | GND

R3
| 10k 1%

C8
10u 16V

R2 y R3 dividen la
alimentación. U1A entrega
VREF a los filtros.

Filtro RC: R1 y C1.
Desacoplo: C2 y C4–C7.

En reposo: 1,641 V
simulados.

LED y alimentación del
PAM8403: retorno a GND.
El parlante va entre las dos salidas BTL.
3,3 V de alimentación; 1,65 V de referencia 1 | 2

AB

PWR_FLAG

C7

100n V+

4 V- 11 U4E GND

1 -

2 +

3 | U1A

V+

4 V- 11 U1E

C6

100n C5

100n V+

4 V- 11 U3E V+

4 V- 11 U2E

PWR_FLAG

GND

GND | GND

R3

| 10k 1%

C8

10u 16V ⁺3.3VA

+3.3VA

R1

10

+3V3

PWR_FLAG
+5V

R2

10k 1%

C1

100u 10V | C2
100n | C4

100n

C3

470u 10V

VREF

C3: picos del PAM8403 (J3)

VREF es la tierra de señal: todas las etapas oscilan alrededor de 1,65 V con 3,3 V | FILTROS ACTIVOS SALLEN-KEY DE SEGUNDO ORDEN (ganancia unitaria, Q ≈ 0,73)

ALIMENTACIÓN ANALÓGICA Y VREF = 1,65 V

Filtro RC R1⁻C1: fc ≈ 159 Hz. C4–C7: desacoplo local de los MCP6004.

+3V3 R1

10 +3.3VA C1
100u 10V C3

470u 10V

GND

GND | GND

R3

| 10k 1%

C8

10u 16V

R2 y R3 dividen la
alimentación. U1A entrega VREF a los filtros.

Filtro RC: R1 y C1. Desacoplo: C2 y C4–C7.

En reposo: 1,641 V
simulados.

LED y alimentación del PAM8403: retorno a GND. El parlante va entre las dos

2026-10-22

salidas BTL.

3,3 V de alimentación; 1,65 V de referencia

El audio oscila alrededor de VREF porque usamos una alimentación de 3,3 V. U1A evita cargar directamente el divisor. La caída en R1 deja la referencia en 1,641 V en la simulación. U1E es la unidad de alimentación de U1, no otro operacional. PWR_FLAG es una marca para ERC; no se compra.

## Entrada y ganancia del preamplificador

PWR_FLAG

C7

100n V+

4 V- 11 U4E GND

R6
100k GND

1
2

3 RV1

10k log R5
10k

C9
1u film

C10
10u 16V

R8
10k 1%

GND

R
S

T

J1

Entrada de línea 3,5 mm

R4
10k | R7

22k 1% ⁺

5 -

6

7 U1B

IN_L
IN_L

IN_R

IN_R

PRE

VREF

VREF

ENTRADA DE LÍNEA Y PREAMPLIFICADOR (G = 1 + R7/R8 = 3,2)

R4–R5 mezclan a mono; RV1 ajusta el nivel. Con los deslizables al máximo, la entrada debe ser ≤ 0,11 V de pico (la pantalla avisa CLIP) | VREF es la tierra de señal: todas las etapas oscilan alrededor de 1,65 V con 3,3 V.

J1

Entrada de línea 3,5 mm

R
S

T GND

C9 RV1 | 1u | film
10k log | 1
2

3 GND
R6
100k

R4 y R5
Mezclan L/R sin unir
directamente las salidas de la fuente.

RV1, C9 y R6
Ajustan nivel, bloquean
continua y polarizan en
VREF.

U1B, R7 y R8
Ganancia de 3,2 en banda.
C10 deja ganancia unitaria en continua.
Entrada y ganancia del preamplificador 2 | 3 | 4 | 5

PWR_FLAG

C7

100n V+

4 V- 11 U4E GND

1 -

2 +

3 | U1A

C6

100n C5

100n V+

4 V- 11 U3E V+

4 V- 11 U2E

R6
100k GND

1
2

3 RV1

10k log R5
10k

C9
1u film

C10
10u 16V

R8
10k 1%

GND

R
S

T

J1

Entrada de línea 3,5 mm

R4
10k | R7

22k 1% ⁺

5 -

6

7 U1B

IN_L
IN_L

IN_R

IN_R

PRE

VREF

VREF

VREF

ENTRADA DE LÍNEA Y PREAMPLIFICADOR (G = 1 + R7/R8 = 3,2)

R4–R5 mezclan a mono; RV1 ajusta el nivel. Con los deslizables al máximo, la entrada debe ser ≤ 0,11 V de pico (la pantalla avisa CLIP) | VREF es la tierra de señal: todas las etapas oscilan alrededor de 1,65 V con 3,3 V.

V

J1

Entrada de línea 3,5 mm

R
S

T GND

C9 RV1 | 1u film
10k log | 1
| 2
| 3 GND R6 100k

R4 y R5 Mezclan L/R sin unir directamente las salidas de

la fuente.

RV1, C9 y R6 Ajustan nivel, bloquean

continua y polarizan en VREF. U1B, R7 y R8 Ganancia de 3,2 en banda. C10 deja ganancia unitaria

2026-10-22

en continua.

Entrada y ganancia del preamplificador

R4 y R5 mezclan los canales del jack; RV1 ajusta cuánto llega al preamplificador. C9 bloquea la continua y R6 centra la señal en VREF. La ganancia de 3,2 se comprueba entre PRE_IN y PRE. Si la entrada es demasiado grande, el operacional satura.

## Filtro de graves: U1C, R9, R10, C11 y C12 R10

10k 1%

R9
10k 1%

8 -

9 +

10 | U1C

C11
100n film

C12
47n film
GRAVES PRE | VREF R10
10k 1%

C12
47n film

R9 = R10 = 10 kΩ.
C11 = 100 nF; C12 = 47 nF. U1C trabaja como seguidor.

C11 vuelve desde la salida al nodo intermedio. C12 deriva a VREF.
La realimentación fija Q ≈ 0, 73; el corte simulado es 239 Hz.

Filtro de graves: U1C, R9, R10, C11 y C12 R10

10k 1%

R9
10k 1%

8 -

9 +

10 | U1C

C11
100n film

C12
47n film
GRAVES PRE | VREF R10
10k 1%

C12
47n film

R9 = R10 = 10 kΩ. C11 = 100 nF; C12 = 47 nF. U1C trabaja como seguidor. C11 vuelve desde la salida al nodo intermedio. C12 deriva a VREF. La realimentación fija Q ≈ 0, 73; el corte

simulado es 239 Hz.

2026-10-22

Filtro de graves: U1C, R9, R10, C11 y C12

A baja frecuencia los condensadores cargan poco la señal; a alta frecuencia aumenta su efec-to y cae la salida de graves. El filtro no es solo dos RC independientes: C11 realimenta desde la salida. Medios encadena pasa altas y pasa bajas; agudos usa pasa altas.

## Medios: dos filtros conectados en cascada C13

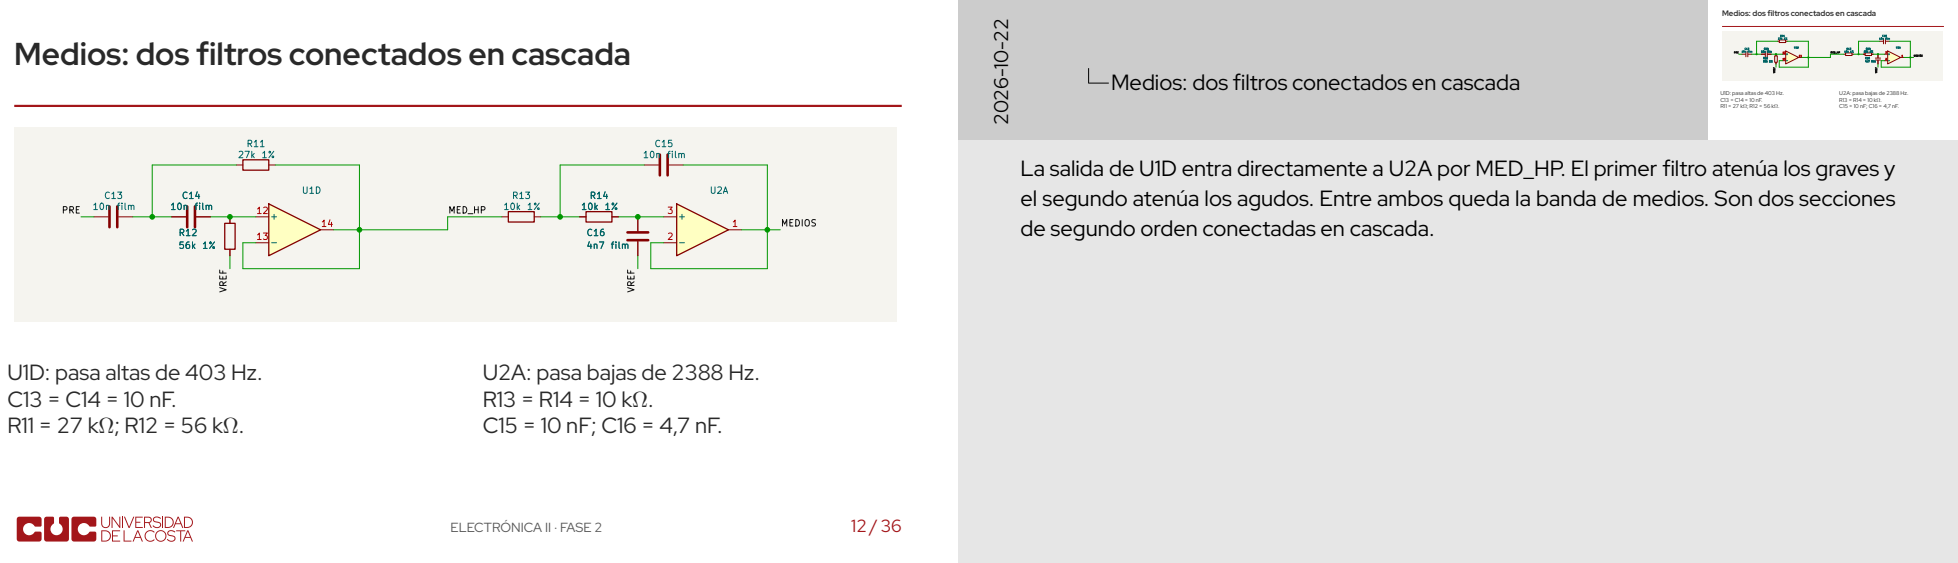
[picture p85: page 12]

Medios: dos filtros conectados en cascada C13

Medios: dos filtros conectados en cascada

U1D: pasa altas de 403 Hz. C13 = C14 = 10 nF. R11 = 27 kΩ; R12 = 56 kΩ.

U2A: pasa bajas de 2388 Hz. R13 = R14 = 10 kΩ. C15 = 10 nF; C16 = 4,7 nF.

La salida de U1D entra directamente a U2A por MED_HP. El primer filtro atenúa los graves y
el segundo atenúa los agudos. Entre ambos queda la banda de medios. Son dos secciones
de segundo orden conectadas en cascada.

U1D: pasa altas de 403 Hz.

U2A: pasa bajas de 2388 Hz.

## Agudos: pasa altas con U2B C18

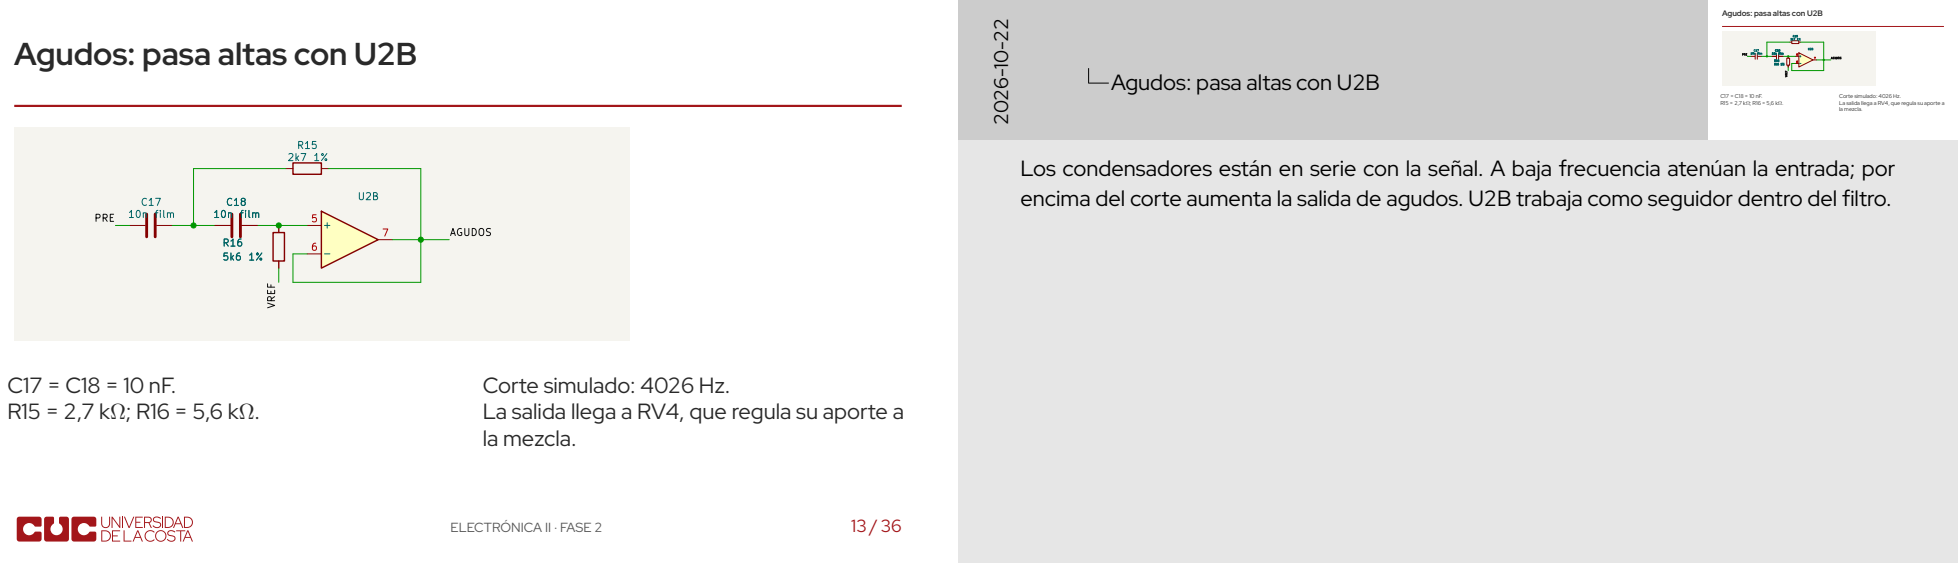
[picture p86: page 13]
film; AGUDOS PRE; VREF C18; 10n film; C17 10n film; Corte simulado: 4026 Hz. La salida llega a RV4, que regula su aporte a; la mezcla.

Agudos: pasa altas con U2B C18

Agudos: pasa altas con U2B

Los condensadores están en serie con la señal. A baja frecuencia atenúan la entrada; por
encima del corte aumenta la salida de agudos. U2B trabaja como seguidor dentro del filtro.

Corte simulado: 4026 Hz.
La salida llega a RV4, que regula su aporte a
la mezcla.

## Frecuencias calculadas y simuladas

Filtro | Cálculo de f0 | Corte simulado
Graves (U1C), pasa bajas | 232 Hz | 239 Hz
Medios (U1D), pasa altas | 409 Hz | 403 Hz
Medios (U2A), pasa bajas | 2322 Hz | 2388 Hz
Agudos (U2B), pasa altas | 4093 Hz | 4026 Hz
Previo al ADC (U2D) | 4949 Hz | 5101 Hz

f0,PB =

1
2πR√C1C2

f0,PA =

1
2πC√R1R2

Cada sección es de segundo orden. La cascada de medios es de cuarto orden.

Frecuencias calculadas y simuladas

Filtro | Cálculo de f0 | Corte simulado Graves (U1C), pasa bajas | 232 Hz | 239 Hz Medios (U1D), pasa altas | 409 Hz | 403 Hz Medios (U2A), pasa bajas | 2322 Hz | 2388 Hz Agudos (U2B), pasa altas | 4093 Hz | 4026 Hz Previo al ADC (U2D) | 4949 Hz | 5101 Hz

f0,PB =

1
2πR√C1C2

f0,PA =

1
2πC√R1R2

2026-10-22

Cada sección es de segundo orden. La cascada de medios es de cuarto orden.

Frecuencias calculadas y simuladas

Distinguir frecuencia natural y corte a menos tres decibelios: con Q cercano a 0,73 no coinciden exactamente. Todos los cortes nominales simulados cumplen el margen del diez por ciento.

## Deslizables, inversión de medios y sumador

D

E

1
2

3 RV3
10k lin

8 ⁻

9 +

10 | U4C

1
2

3 RV4
10k lin

R17
47k 1%

R18
47k 1%

8 ⁻

9 +

10 | U2C

R22
100k 1%

R20
47k 1%

R19
47k 1%

R21
47k 1%

1
2

3 RV2
10k lin

G_W

GRAVES MEDIOS

M_INV

VREF

VREF VREF

A_W

M_W

G_W

VREF EQ_OUT VREF

M_W

A_W AGUDOS

GANANCIA POR BANDA, INVERSOR Y SUMADOR

Deslizables de 10 kΩ lineales entre la salida de cada filtro y VREF; al 50 % la suma es plana. U4C invierte los medios para que los cruces de segundo orden queden en fase. EQ_OUT = VREF − (100k/47k)·[(G_W − VREF) + (M_INV − VREF) + (A_W − VREF)]

RV2–RV4 entregan una
fracción de cada banda
respecto a VREF.

U4C invierte medios:
−47/47 = −1.

U2C suma por R19–R21.
Cada entrada pesa
−100/47 ≈ −2, 13.

La fase de cada banda
también afecta la suma.

Deslizables, inversión de medios y sumador

D

E

1
2

3 RV3

10k lin

8 ⁻

9 +

10 | U4C

1
2

3 RV4

10k lin

R17
47k 1%

R18
47k 1%

8 ⁻

9 +

10 | U2C R22 100k 1%

R20
47k 1%

R19
47k 1%

R21
47k 1%

1
2

3 RV2

10k lin

G_W

GRAVES MEDIOS

M_INV

VREF

VREF VREF

A_W

M_W

G_W

VREF EQ_OUT VREF

M_W

A_W AGUDOS

GANANCIA POR BANDA, INVERSOR Y SUMADOR

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

RV2–RV4 entregan una
fracción de cada banda
respecto a VREF.

U4C invierte medios: −47/47 = −1.

U2C suma por R19–R21. Cada entrada pesa −100/47 ≈ −2, 13.

La fase de cada banda
también afecta la suma.

2026-10-22

Deslizables, inversión de medios y sumador

Cada deslizable entrega una fracción de su banda al sumador. U4C invierte medios antes de la suma. Al simular la cadena completa, esta corrección reduce los valles en los cruces; la siguiente curva muestra la comparación.

## Respuesta de la suma antes y después de corregir la fase

U4C, R17 y R18 corrigen la fase de medios. Al centro: de −11 dB a una respuesta entre −0, 27 y +0, 88 dB respecto a PRE.

Respuesta de la suma antes y después de corregir la fase

U4C, R17 y R18 corrigen la fase de medios. Al centro: de −11 dB a una respuesta entre −0, 27

2026-10-22

y +0, 88 dB respecto a PRE.

Respuesta de la suma antes y después de corregir la fase

Explicar la inversión de medios con U4C y el reajuste de sus cortes. La curva corresponde a ngspice y a un modelo aproximado, no a mediciones del equipo. No llamar a este diseño un cruce Linkwitz-Riley exacto.

## Detector de pico y seguidor para el ADC R27

220k | + 5 -

6

7 U3B

C22
100n film

D1
1N4148 1 -

2 +

3 | U3A | VREF | VREF G_W | ADC_G

D1
1N4148 C22

100n film

U3A + D2
Cargan C22 durante los picos positivos. El diodo queda dentro de la realimentación.

R27 + C22 + U3B
Descarga de 22 ms y seguidor para el ADC. Se resta VREF para obtener el nivel de graves.

Detector de pico y seguidor para el ADC R27

220k | + 5 -

6

7 U3B

C22
100n film

D1
1N4148 1 -

2 +

3 | U3A | VREF | VREF G_W | ADC_G

D1
1N4148 C22

100n film

U3A + D2 Cargan C22 durante los picos positivos. El diodo queda dentro de la realimentación.

R27 + C22 + U3B Descarga de 22 ms y seguidor para el ADC. Se resta VREF para obtener el nivel de graves.

2026-10-22

Detector de pico y seguidor para el ADC

El detector entrega una envolvente con rizado, no un RMS. La compensación del diodo es una aproximación limitada por la velocidad, saturación y recuperación del operacional. A frecuencias bajas hay más descarga entre picos.

## Niveles de los detectores con un tono de 1 kHz

Tono de 1 kHz

Graves | 15 mV
Medios | 304 mV
Agudos | 17 mV

τ = 220 kΩ ⋅ 100 nF = 22 ms

D2 a D3, C22 a C24 y R27 a R29.
La lectura corresponde a la envolvente.

Niveles de los detectores con un tono de 1 kHz

Tono de 1 kHz Graves | 15 mV Medios | 304 mV
Agudos | 17 mV

τ = 220 kΩ ⋅ 100 nF = 22 ms

D2 a D3, C22 a C24 y R27 a R29. La lectura corresponde a la envolvente.

2026-10-22

Niveles de los detectores con un tono de 1 kHz

Las lecturas son las tensiones del detector menos VREF. El criterio de selectividad es una relación de al menos cuatro a uno. La descarga entre picos afecta más a frecuencias bajas.

## Antes de la FFT: filtro y entrada al ADC R26

10k 1%

R25
10k 1% | + 12 -

13

14 U2D

C20
4n7 film

C21
2n2 film
ADC_FFT EQ_OUT | VREF R26
10k 1%

C21
2n2 film

U2D, R25 y R26 de 10 kΩ.
C20 = 4,7 nF; C21 = 2,2 nF.

ADC_FFT llega a GPIO33.
Corte simulado: 5101 Hz.

A 15 kHz atenúa 19,3 dB. Una señal fuerte todavía puede producir aliasing.

Antes de la FFT: filtro y entrada al ADC R26

10k 1%

R25
10k 1% | + 12 -

13

14 U2D

C20
4n7 film

C21
2n2 film
ADC_FFT EQ_OUT | VREF R26
10k 1%

C21
2n2 film

U2D, R25 y R26 de 10 kΩ. C20 = 4,7 nF; C21 = 2,2 nF.

ADC_FFT llega a GPIO33. Corte simulado: 5101 Hz.

A 15 kHz atenúa 19,3 dB. Una señal fuerte todavía puede producir aliasing.

2026-10-22

Antes de la FFT: filtro y entrada al ADC

Este filtro está después del sumador y antes del ADC. Reduce las componentes por encima de la zona que queremos visualizar. Con 20 mil muestras por segundo, un tono de 15 kHz puede plegarse a 5 kHz si no queda suficientemente atenuado.

## Muestreo y resolución de la FFT

1024

muestras por bloque

fs = 20 kS/s
Δf = 19, 53 Hz
Tiempo de bloque: 51,2 ms

Un tono de 1 kHz
queda cerca del bin 51 (996,1 Hz).

Límite del análisis
Se muestran aproximadamente 40 Hz–5 kHz. El filtro atenúa el aliasing; no lo elimina.

U2D entrega la señal a GPIO33 de U5. A 15 kHz: −19, 3 dB simulados.

Muestreo y resolución de la FFT

1024

muestras por bloque

fs = 20 kS/s Δf = 19, 53 Hz Tiempo de bloque: 51,2 ms

Un tono de 1 kHz queda cerca del bin 51 (996,1 Hz).

Límite del análisis Se muestran aproximadamente 40 Hz–5

kHz. El filtro atenúa el aliasing; no lo elimina. U2D entrega la señal a GPIO33 de U5. A 15 kHz: −19, 3 dB simulados.

2026-10-22

Muestreo y resolución de la FFT

La frecuencia que muestra el estimador interpolado puede acercarse a mil hertz. El muestreo nominal y los cinco cuadros por segundo se deben medir en la placa con Wi-Fi activo.

## Pantalla: conexión SPI y control de luz

GND

SW1 Pulsador | GND

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
J4 Waveshare 1.9 ST7789V2 ⁺3V3 GND

GND

R30
10k +5V | USB

3V3 1
EN 2
VP/IO36 3
VN/IO39 4
IO34 5
IO35 6
IO32 7
IO33 8
IO25 9
IO26 10
IO27 11
IO14 12
IO12 13 GND 14

IO13 15
SD2/IO9 16
SD3/IO10 17 | CMD/IO11 18
5V 19 | GND | 20
IO23 | 21
IO22 | 22
TXD0/IO1 | 23 RXD0/IO3 | 24
IO21 | 25 GND | 26
IO19 | 27
IO18 | 28
IO5 | 29
IO17 | 30
IO16 | 31
IO4 | 32
IO0 | 33
IO2 | 34
IO15 | 35
SD1/IO8 | 36
SD0/IO7 | 37 CLK/IO6 | 38 U5

ESP32⁻DevKitC V4 GND

GND

+3V3

BTN

ADC_A
TFT_BL
TFT_SCK

TFT_MOSI ADC_M

LED_DATA | BTN
TFT_DC | TFT_BL

ADC_FFT

TFT_CS VREF

TFT_MOSI
VREF

ADC_G

TFT_RST

TFT_BL

TFT_RST

TFT_SCK
TFT_CS
TFT_DC

J4 (adaptador): 1 VCC, 2 GND, 3 DIN, 4 CLK, 5 CS, 6 DC, 7 RST, 8 BL. Waveshare 1,9 pulgadas. BL = GPIO19; datos LED = GPIO25. Cablear por nombre; GH1.25 no tiene este ADC1 permite mantener el Wi⁻Fi activo.

MICROCONTROLADOR, PANTALLA TFT Y PULSADOR

J4 Waveshare 1.9 ST7789V2

1
2
3
4
5
6
7

8 ⁺3V3

U5: ESP32-DevKitC.
J4: cable de ocho señales.

DIN y CLK llevan los datos. CS, DC y RST controlan la
pantalla.

GPIO19 controla BL; R30 lo mantiene apagado al
arrancar.

Pantalla: conexión SPI y control de luz

GND

SW1 Pulsador | GND

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
J4 Waveshare 1.9 ST7789V2 ⁺3V3 GND

GND

R30
10k +5V | USB

3V3 1
EN 2
VP/IO36 3
VN/IO39 4
IO34 5
IO35 6
IO32 7
IO33 8
IO25 9
IO26 10
IO27 11
IO14 12
IO12 13 GND 14

IO13 15
SD2/IO9 16
SD3/IO10 17 | CMD/IO11 18
5V 19 | GND | 20
IO23 | 21
IO22 | 22
TXD0/IO1 | 23 RXD0/IO3 | 24
IO21 | 25 GND | 26
IO19 | 27
IO18 | 28
IO5 | 29
IO17 | 30
IO16 | 31
IO4 | 32
IO0 | 33
IO2 | 34
IO15 | 35
SD1/IO8 | 36
SD0/IO7 | 37 CLK/IO6 | 38 U5

ESP32⁻DevKitC V4 GND

GND

+3V3

C10
10u 16V

R8
10k 1%

R7

22k 1% ⁺

5 -

6

7 U1B

BTN

PRE

ADC_A
TFT_BL
TFT_SCK

TFT_MOSI ADC_M

LED_DATA | BTN
TFT_DC | TFT_BL

ADC_FFT

TFT_CS VREF

TFT_MOSI
VREF

ADC_G

TFT_RST

TFT_BL

TFT_RST

TFT_SCK
TFT_CS
TFT_DC
J4 (adaptador): 1 VCC, 2 GND, 3 DIN, 4 CLK, 5 CS, 6 DC, 7 RST, 8 BL. Waveshare 1,9 pulgadas. BL = GPIO19; datos LED = GPIO25. Cablear por nombre; GH1.25 no tiene este ADC1 permite mantener el Wi⁻Fi activo | MICROCONTROLADOR, PANTALLA TFT Y PULSADOR

= 1 + R7/R8 = 3,2)

J4 Waveshare 1.9 ST7789V2

1
2
3
4
5
6
7

8 ⁺3V3

U5: ESP32-DevKitC. J4: cable de ocho señales.

DIN y CLK llevan los datos. CS, DC y RST controlan la pantalla. GPIO19 controla BL; R30 lo mantiene apagado al arrancar.

2026-10-22

Pantalla: conexión SPI y control de luz

La pantalla Waveshare se conecta por cable y queda sujeta a la tapa. J4 usa paso de 2,54 mm; el módulo usa GH1.25. El adaptador se revisa por nombre de señal porque los números de ambos conectores no coinciden.

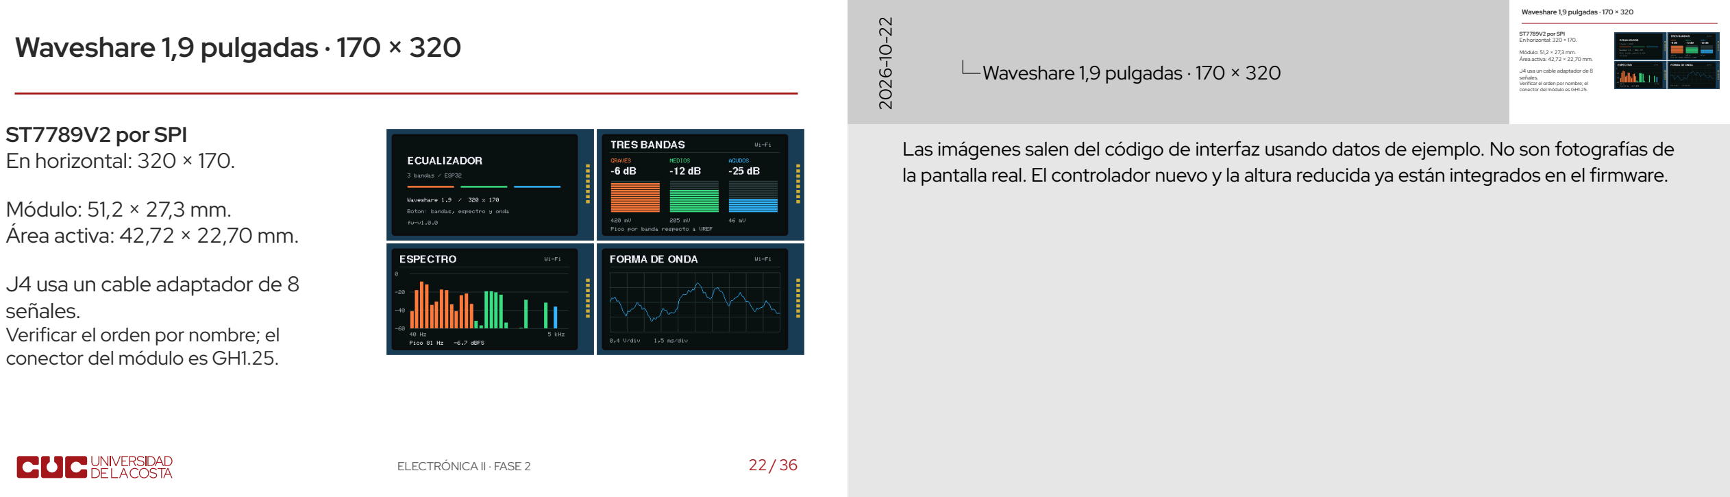
[picture p87: figure]
Waveshare 1,9 pulgadas · 170 × 320; ST7789V2 por SPI En horizontal: 320 × 170.; Módulo: 51,2 × 27,3 mm. Área activa: 42,72 × 22,70 mm.; J4 usa un cable adaptador de 8 señales. Verificar el orden por nombre; el conector del módulo es GH1.25.; J4 usa un cable adaptador de 8

ST7789V2 por SPI En horizontal: 320 × 170. Módulo: 51,2 × 27,3 mm. Área activa: 42,72 × 22,70 mm.

señales. Verificar el orden por nombre; el conector del módulo es GH1.25.

Las imágenes salen del código de interfaz usando datos de ejemplo. No son fotografías de la pantalla real. El controlador nuevo y la altura reducida ya están integrados en el firmware.

## Circuito de alimentación y datos de los LED +5V GND

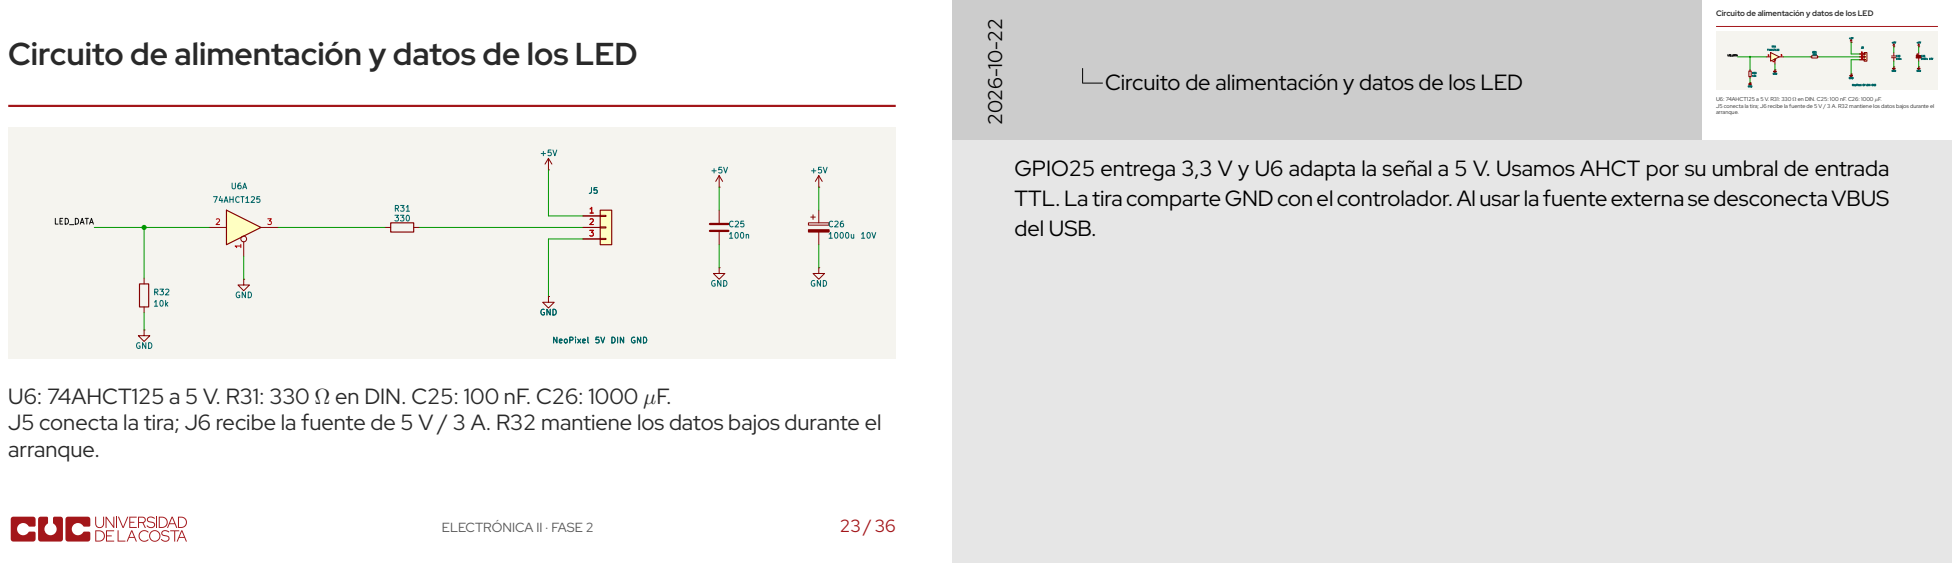
[picture p88: page 23]

Circuito de alimentación y datos de los LED

U6: 74AHCT125 a 5 V. R31: 330 Ω en DIN. C25: 100 nF. C26: 1000 μF. J5 conecta la tira; J6 recibe la fuente de 5 V / 3 A. R32 mantiene los datos bajos durante el arranque.

GPIO25 entrega 3,3 V y U6 adapta la señal a 5 V. Usamos AHCT por su umbral de entrada
TTL. La tira comparte GND con el controlador. Al usar la fuente externa se desconecta VBUS
del USB.

U6: 74AHCT125 a 5 V. R31: 330 Ω en DIN. C25: 100 nF. C26: 1000 μF.
J5 conecta la tira; J6 recibe la fuente de 5 V / 3 A. R32 mantiene los datos bajos durante el
arranque.

## NeoPixel: canal, difusor y alimentación

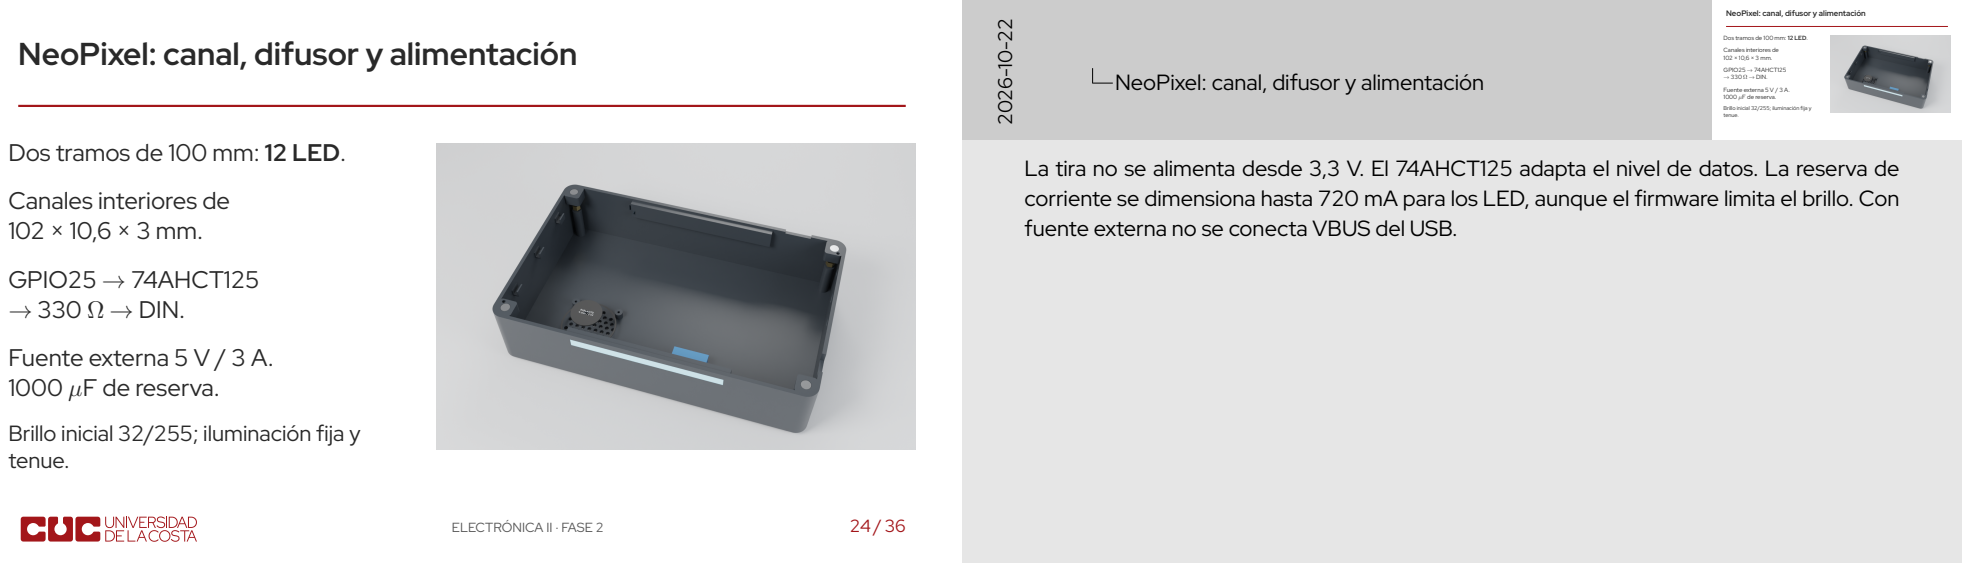
[picture p89: page 24]
GPIO25 → 74AHCT125 → 330 Ω → DIN.; 102 × 10,6 × 3 mm. GPIO25 → 74AHCT125 → 330 Ω → DIN.

NeoPixel: canal, difusor y alimentación

Dos tramos de 100 mm: 12 LED. Canales interiores de

Fuente externa 5 V / 3 A.
1000 μF de reserva.

Brillo inicial 32/255; iluminación fija y
tenue.

Dos tramos de 100 mm: 12 LED.

La tira no se alimenta desde 3,3 V. El 74AHCT125 adapta el nivel de datos. La reserva de
corriente se dimensiona hasta 720 mA para los LED, aunque el firmware limita el brillo. Con
fuente externa no se conecta VBUS del USB.

Canales interiores de

## Esquemático y PCB: comprobaciones distintas

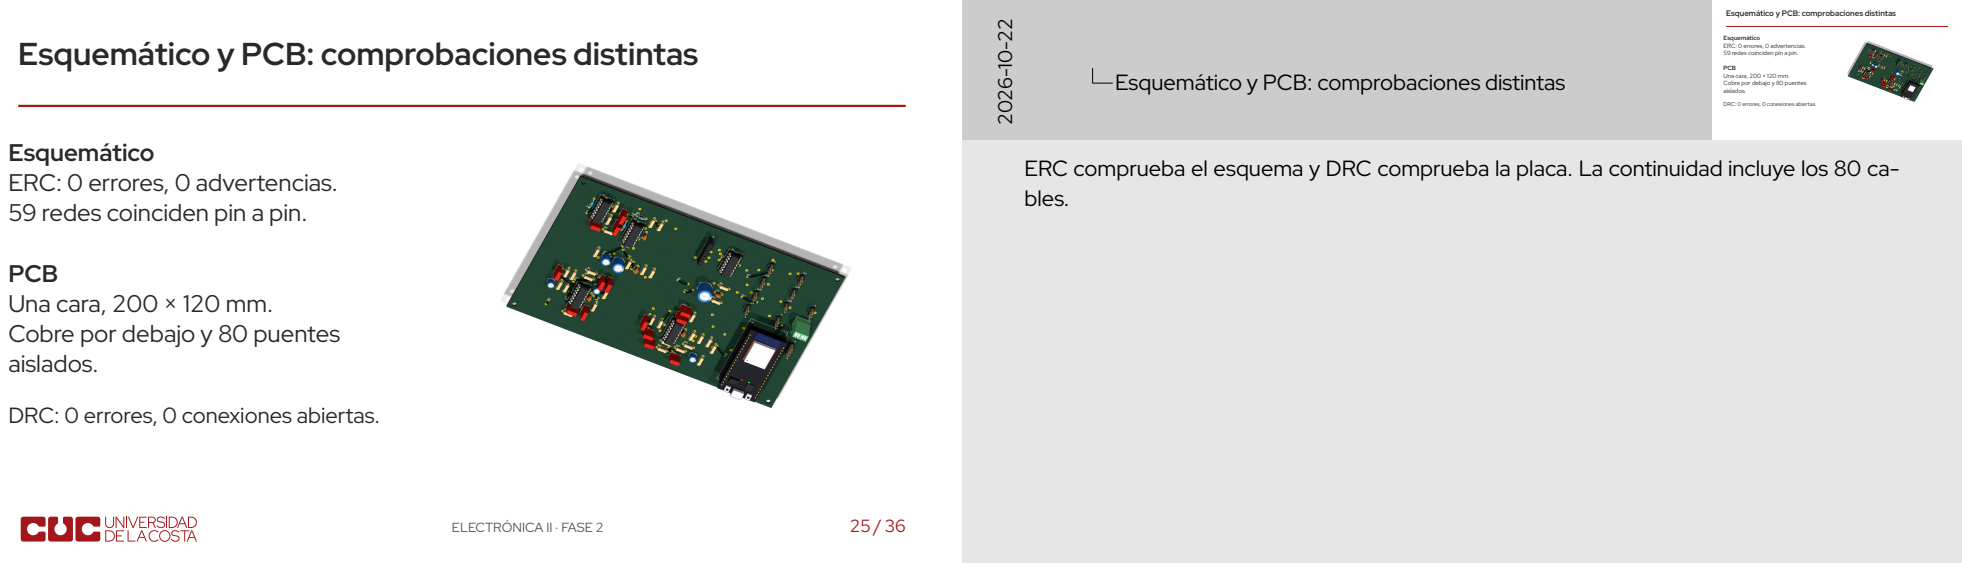
[picture p90: page 25]

Esquemático y PCB: comprobaciones distintas

Esquemático ERC: 0 errores, 0 advertencias. 59 redes coinciden pin a pin.

PCB Una cara, 200 × 120 mm. Cobre por debajo y 80 puentes aislados.

DRC: 0 errores, 0 conexiones abiertas.

Esquemático
ERC: 0 errores, 0 advertencias.
59 redes coinciden pin a pin.

ERC comprueba el esquema y DRC comprueba la placa. La continuidad incluye los 80 ca-
bles.

PCB
Una cara, 200 × 120 mm.
Cobre por debajo y 80 puentes
aislados.

## D.2: PCB de una cara con puentes

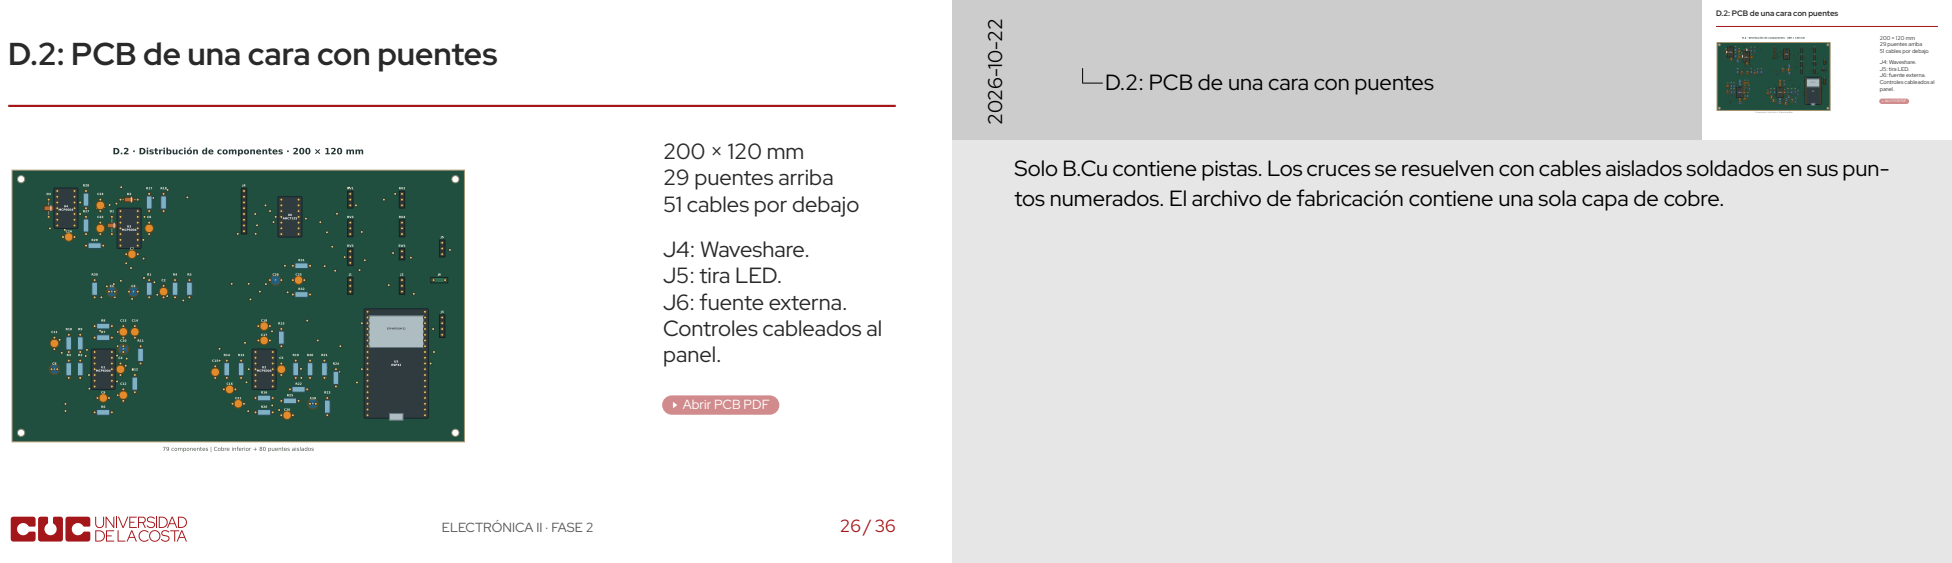
[picture p91: page 26]

D.2: PCB de una cara con puentes

D.2 · Distribución de componentes · 200 × 120 mm

29 puentes arriba 51 cables por debajo

J4: Waveshare. J5: tira LED. J6: fuente externa. Controles cableados al panel.

79 componentes | Cobre inferior + 80 puentes aislados

Solo B.Cu contiene pistas. Los cruces se resuelven con cables aislados soldados en sus pun-
tos numerados. El archivo de fabricación contiene una sola capa de cobre.

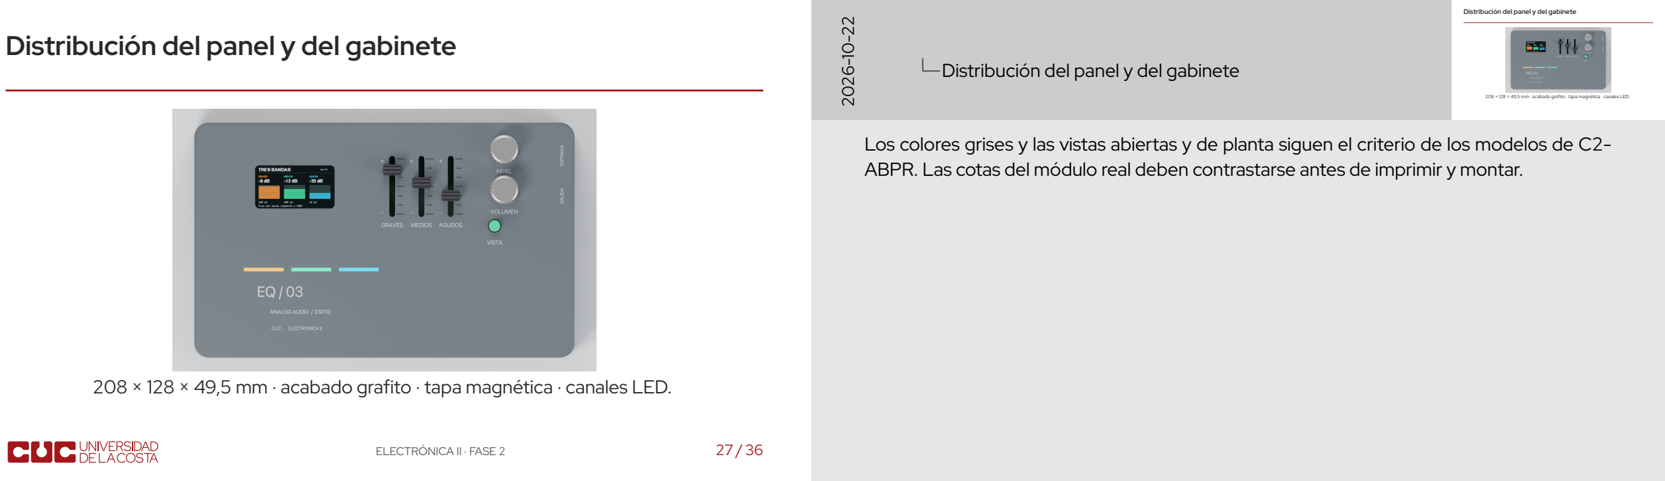
[picture p92: figure]
Distribución del panel y del gabinete

208 × 128 × 49,5 mm · acabado grafito · tapa magnética · canales LED.

208 × 128 × 49,5 mm · acabado grafito · tapa magnética · canales LED.

Los colores grises y las vistas abiertas y de planta siguen el criterio de los modelos de C2-ABPR. Las cotas del módulo real deben contrastarse antes de imprimir y montar.

## Tapa magnética, sin tornillos a la vista

Cuatro pares de imanes:
8 discos de Ø6 × 2 mm.

Alojamientos Ø6,3 × 2,2 mm. Techo de tapa: 0,8 mm.

Dos guías de registro y un uñero posterior.

La PCB conserva fijación
mecánica independiente.

Tapa magnética, sin tornillos a la vista

Cuatro pares de imanes: 8 discos de Ø6 × 2 mm.

Alojamientos Ø6,3 × 2,2 mm. Techo de tapa: 0,8 mm. Dos guías de registro y un

uñero posterior.

La PCB conserva fijación mecánica independiente.

2026-10-22

Tapa magnética, sin tornillos a la vista

Comprobar la polaridad de cada par antes de pegar. La holgura y el adhesivo se validan con una pieza de prueba. La fuerza de retención y el ajuste deben comprobarse con la tapa y el cable de pantalla instalados; no se han medido todavía.

## Ensayo de hoy: generador y osciloscopio

Entrada PRE
Senoidal de 200 mV pico a pico. Offset: 1,65 V.

CH1: PRE. CH2: salida del filtro. Masas al GND del circuito.

100 Hz: graves.
1 kHz: medios.
8 kHz: agudos.

Qué explicar
Comparar amplitud y fase.
|H| = Vpp,out/Vpp,in.

En Velxio: clic derecho sobre el cable y Add to scope.

Los operacionales de esta prueba son ideales. El ensayo físico debe usar el MCP6004 y alimentación de 3,3 V.

Ensayo de hoy: generador y osciloscopio

Entrada PRE
Senoidal de 200 mV pico a pico. Offset: 1,65 V. CH1: PRE. CH2: salida del filtro. Masas al GND del circuito.

100 Hz: graves.
1 kHz: medios. 8 kHz: agudos.

Qué explicar Comparar amplitud y fase.

|H| = Vpp,out/Vpp,in.

En Velxio: clic derecho sobre el cable y Add to scope.

Los operacionales de esta prueba son ideales. El ensayo físico debe usar el MCP6004 y alimentación de 3,3 V.

2026-10-22

Ensayo de hoy: generador y osciloscopio

Cargar filtros-1000Hz.vlx. El generador inyecta directamente en PRE; esta prueba aísla los filtros. Añadir PRE y la salida al osciloscopio. En el banco, no conectar la pinza de masa a VREF. Cambiar a 100 Hz y a 8 kHz para comparar las bandas.

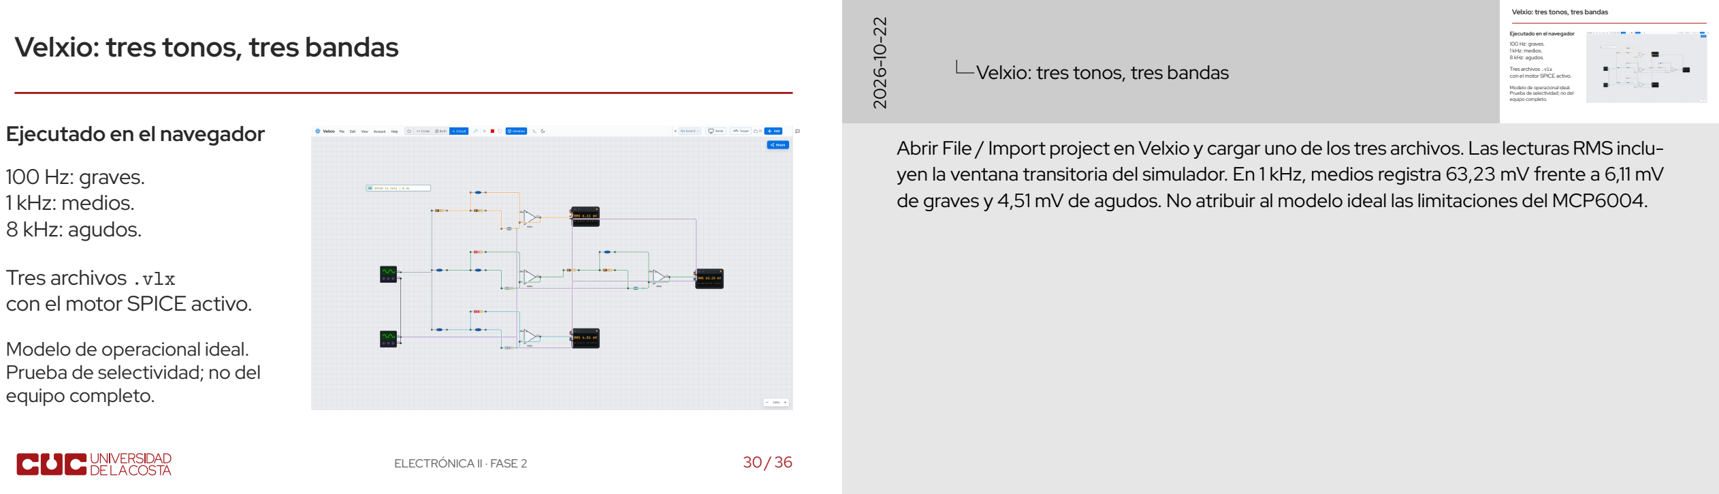
[picture p93: figure]
Velxio: tres tonos, tres bandas; Ejecutado en el navegador; 100 Hz: graves. 1 kHz: medios. 8 kHz: agudos.; Tres archivos .vlx; con el motor SPICE activo.; Modelo de operacional ideal. Prueba de selectividad; no del equipo completo.

con el motor SPICE activo. Modelo de operacional ideal. Prueba de selectividad; no del equipo completo.

Abrir File / Import project en Velxio y cargar uno de los tres archivos. Las lecturas RMS incluyen la ventana transitoria del simulador. En 1 kHz, medios registra 63,23 mV frente a 6,11 mV de graves y 4,51 mV de agudos. No atribuir al modelo ideal las limitaciones del MCP6004.

## Velxio: circuito, ESP32 y pantalla

Captura de la TFT con entrada de 1 kHz.

Entrada → filtros → detectores → ADC → TFT.

100 Hz: predominan graves.
1 kHz: predominan medios.
8 kHz: predominan agudos.

ABRIR VELXIO / QEMU (https://velxio.dev/editor?esp32sim=qemu)

## Importar integrado-1000Hz.vlx y

pulsar Run.

TFT ILI9341 de sustitución; operacionales y diodos ideales. FFT sin calibración de frecuencia. El amplificador de potencia y los LED se ensayan aparte.

Velxio: circuito, ESP32 y pantalla

Captura de la TFT con entrada de 1 kHz.

Entrada → filtros → detectores → ADC → TFT.

100 Hz: predominan graves.
1 kHz: predominan medios. 8 kHz: predominan agudos.

ABRIR VELXIO / QEMU
Importar integrado-1000Hz.vlx y pulsar Run.

TFT ILI9341 de sustitución; operacionales y diodos ideales. FFT sin calibración de frecuencia. El amplificador de potencia y los LED se ensayan aparte.

2026-10-22

Velxio: circuito, ESP32 y pantalla

Las barras proceden de analogRead ejecutado por el ESP32 emulado, no de una animación con amplitudes precargadas. Abrir el enlace con QEMU: el motor JavaScript aproxima las ondas del ADC a una constante. La TFT ILI9341 sustituye únicamente a la pantalla de esta simulación. No presentar la frecuencia calculada por la FFT como una medición válida; ese aspecto no quedó validado. Los proyectos y la guía INTEGRADO.md viajan en el paquete portátil y adjuntos al PDF.

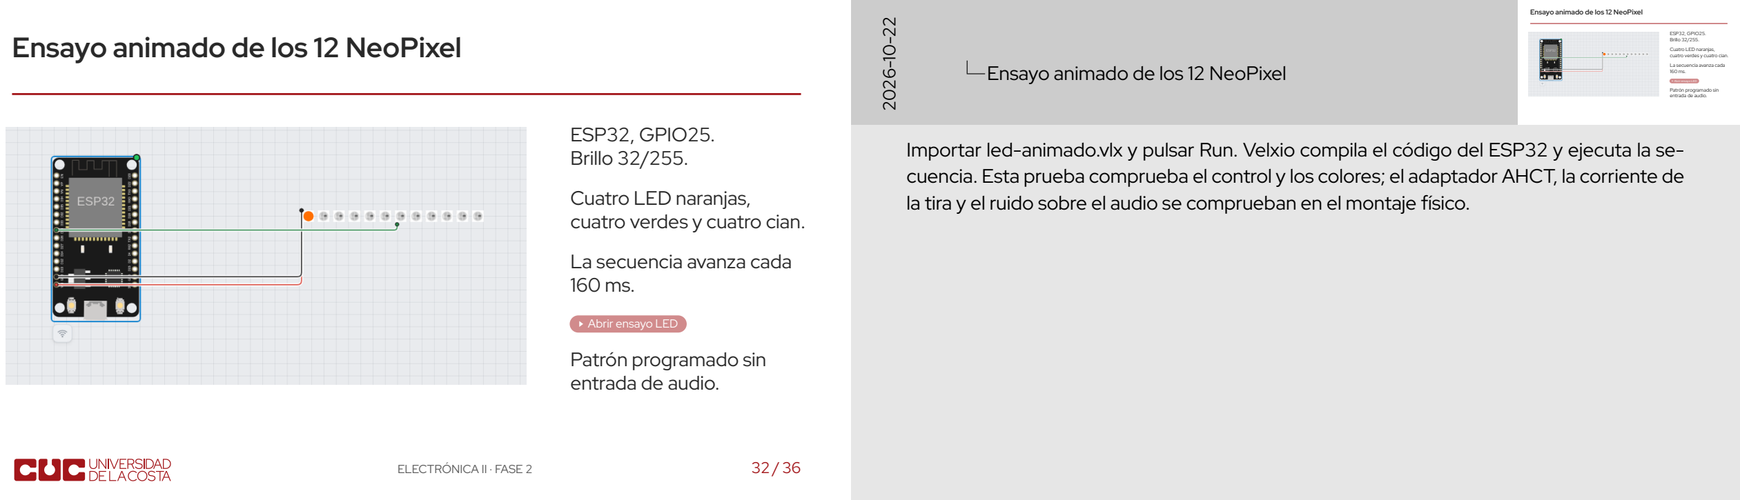
[picture p94: figure]
Ensayo animado de los 12 NeoPixel; ESP32, GPIO25. Brillo 32/255.; Cuatro LED naranjas, cuatro verdes y cuatro cian.; La secuencia avanza cada 160 ms.; Abrir ensayo LED; Patrón programado sin entrada de audio.

ESP32, GPIO25. Brillo 32/255. Cuatro LED naranjas, cuatro verdes y cuatro cian.

Importar led-animado.vlx y pulsar Run. Velxio compila el código del ESP32 y ejecuta la secuencia. Esta prueba comprueba el control y los colores; el adaptador AHCT, la corriente de la tira y el ruido sobre el audio se comprueban en el montaje físico.

## Abrir la simulación durante la exposición

ABRIR VELXIO

## https://velxio.dev/editor?esp32sim=qemu

Descargar un caso y usar File → Import project.

100 Hz → graves
1 kHz → medios
8 kHz → agudos
Ensayo LED → pulsar Run

Abrir carpeta de casos

Los casos .vlx también van adjuntos al PDF.

QR: abre el editor.
Importar después el caso.

Abrir la simulación durante la exposición

ABRIR VELXIO
https://velxio.dev/editor?esp32sim=qemu

Descargar un caso y usar File → Import project.

100 Hz → graves
1 kHz → medios 8 kHz → agudos Ensayo LED → pulsar Run

Abrir carpeta de casos

Los casos .vlx también van adjuntos al PDF.

QR: abre el editor.
Importar después el caso.

2026-10-22

Abrir la simulación durante la exposición

El enlace y el QR abren Velxio; no abren automáticamente un proyecto publicado. Los archivos están en simulacion/velxio y adjuntos al PDF. Tener el caso de 1 kHz descargado antes de la exposición. El visor PDF puede bloquear enlaces a archivos locales; en ese caso abrir index.html desde la carpeta del proyecto.

## Resultados de las comprobaciones

Comprobación | Resultado
Esquemático | ERC sin errores; 59 redes coinciden pin a pin.
PCB de una cara Cobre inferior y 80 puentes; continuidad comprobada.
Filtros en Velxio | Graves a 100 Hz, medios a 1 kHz y agudos a 8 kHz.
Firmware | Compilación ESP32; pruebas DSP y dibujo por franjas.
Iluminación | Secuencia de 12 NeoPixel ejecutada por separado.

Resultados obtenidos con herramientas de diseño y simulación.

Resultados de las comprobaciones

Comprobación | Resultado Esquemático | ERC sin errores; 59 redes coinciden pin a pin. PCB de una cara Cobre inferior y 80 puentes; continuidad comprobada. Filtros en Velxio | Graves a 100 Hz, medios a 1 kHz y agudos a 8 kHz. Firmware | Compilación ESP32; pruebas DSP y dibujo por franjas.
Iluminación | Secuencia de 12 NeoPixel ejecutada por separado.

Resultados obtenidos con herramientas de diseño y simulación.

2026-10-22

Resultados de las comprobaciones

Mostrar cada registro junto a su herramienta. Los resultados analógicos, el ensayo LED y las pruebas del firmware tienen alcances distintos.

## Fuentes y archivos para la sustentación

- Texas Instruments: Sallen-Key, SLOA024B; 74AHCT125, SCLS264R.
- Microchip: ficha técnica MCP6004.
- Waveshare: ficha y esquema del módulo LCD de 1,9 pulgadas.
- Analog Devices: ADAU1701. WLED: documentación Audio Reactive.
- Adafruit: NeoPixel Überguide. Velxio: documentación del simulador.

Repositorio

## https://github.com/davixcky/ecualizador-esp32

Fuentes del informe y de esta presentación en docs/latex/. Resultados, esquemático, PCB y modelos 3D incluidos.

Fuentes y archivos para la sustentación

- Texas Instruments: Sallen-Key, SLOA024B; 74AHCT125, SCLS264R.
- Microchip: ficha técnica MCP6004.
- Waveshare: ficha y esquema del módulo LCD de 1,9 pulgadas.
- Analog Devices: ADAU1701. WLED: documentación Audio Reactive.
- Adafruit: NeoPixel Überguide. Velxio: documentación del simulador.

Repositorio
https://github.com/davixcky/ecualizador-esp32

Fuentes del informe y de esta presentación en docs/latex/. 2026⁻¹0⁻22

Resultados, esquemático, PCB y modelos 3D incluidos.

Fuentes y archivos para la sustentación

Tener abiertos el informe de validación, el proyecto Velxio y el modelo 3D. Si preguntan por un valor, volver al cálculo y al nodo donde se verificó.

Anexo: esquema completo para ampliar 1 | 2 | 3 | 4 | 5 | 6 | 7 | 8 | 9 | 10 | 11
1 | 2 | 3 | 4 | 5 | 6 | 7 | 8 | 9 | 10 | 11

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
FGH Date: 2026⁻10⁻22 KiCad E.D.A. 10.0.0

Size: A2 | Rev: D.2
| Id: 1/1

Title: Ecualizador de audio de tres bandas con visualizador ESP32

File: ecualizador.kicad_sch

Sheet: /

Electrónica II — Universidad de la Costa

Amplificadores operacionales MCP6004 (riel a riel, 3,3 V)

Generado desde herramientas/circuito.py ¹ 2

3 RV3

10k lin | PWR_FLAG

C7

100n V+

4 V- 11 U4E GND

1 -

2 +

3 | U1A | 8 ⁻

9 +

10 | U4C

D1
1N4148 C22

100n film

R27

220k 1 ⁻

2 +

3 | U3A ¹
2

3 RV4

10k lin | D2

1N4148 V+

4 V- 11 U1E C18

10n film

R15
2k7 1%+

5 -

6

7 U2B

C24

100n film

+

5 -

6

7 U3B

1 ⁻

2 +

3 | U4A | R28
220k | + 12 -

13

14 U4D

C17
10n film

R16
5k6 1% +

12 -

13

14 U3D

C12
47n film

R11
27k 1%

R17
47k 1%

R18
47k 1%

C6

100n C5

100n V+

4 V- 11 U3E V+

4 V- 11 U2E 8 -

9 +

10 | U2C R22 100k 1%

8 -

9 +

10 | U1C R10

10k 1%

C11
100n film

D3

1N4148 R20
47k 1%

R19
47k 1%

R9
10k 1%

R21
47k 1%

PWR_FLAG

GND

GND | GND

R3

| 10k 1%

C8

10u 16V ⁺3.3VA | +5V C16

4n7 film

1 -

2 +

3 | U2A R26

10k 1%

R14
10k 1%

C21

2n2 film

R13
10k 1% +5V 9 | 8 10 | U6C

74AHCT125 GND

C20
4n7 film

+

12 -

13

14 U2D

GND

GND

C25

100n R25
10k 1% | +5V 12 | 11 13 | U6D
74AHCT125 | GND
GND | +5V | GND

7 VCC 14 U6E 74AHCT125 +5V R29

220k | +

5 -

6

7 U4B

GND

8 ⁻

9 +

10 | U3C
C23

100n film

SW1 Pulsador | GND

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
J4 Waveshare 1.9 ST7789V2 ⁺3V3 GND

GND

R30

10k +5V | USB

3V3 1

EN 2

VP/IO36 3
VN/IO39 4

IO34 5

IO35 6

IO32 7

IO33 8

IO25 9

IO26 10

IO27 11

IO14 12

IO12 13 GND 14

IO13 15

SD2/IO9 16

SD3/IO10 17 | CMD/IO11 18
5V 19 | GND | 20
IO23 | 21
IO22 | 22
TXD0/IO1 | 23 RXD0/IO3 | 24
IO21 | 25 GND | 26
IO19 | 27
IO18 | 28
IO5 | 29
IO17 | 30
IO16 | 31
IO4 | 32
IO0 | 33
IO2 | 34
IO15 | 35
SD1/IO8 | 36
SD0/IO7 | 37 CLK/IO6 | 38 U5

ESP32⁻DevKitC V4 GND

1

2

3

J5NeoPixel 5V DIN GND

GND

R24

47k | 1
2

3 RV5

10k log | GND | +5VR
| | S T

J2

Salida de línea 3,5 mm

GND

GND

1

2

3
4

# J3PAM8403 +3V3 GND +5V R6

100k GND

1
2

3 RV1

10k log +3.3VA | R5
10k | GND

C9
1u film

C10

10u 16V R1
10 | R8
10k 1% ⁺3V3 | GND

C19

10u 16V | R23

100 ⁺

12 -

13

14 U1D

GND

GND +5VR32

10k 1

2

J6
Entrada 5V 3A ⁺5V GND

C15
10n film

R

S

T

J1

Entrada de línea 3,5 mm

R4
10k | R7

22k 1% ⁺

5 -

6

7 U1B

PWR_FLAG

C13
10n film

C26

1000u 10V 1

2 | U6A3
74AHCT125 ⁺5V | GND

R2

10k 1%

R12

56k 1%

C1

100u 10V | C2
100n | C4
100n 1

2

3 RV2

10k lin | GND

4

5 | U6B6
74AHCT125 R31

# 330 C14 10n film

C3
470u 10V

IN_L

IN_L | VREF LINEA | BTN
A_W | VREF

IN_R

IN_R

LINEA

ADC_G

GRAVES VREF

AGUDOS

ADC_M

G_W

PRE GRAVES | MEDIOS

LED_5V

ADC_A M_W

TFT_BL

TFT_SCK

AMP_IN

TFT_MOSI ADC_M

LED_DATA | BTN
TFT_DC | TFT_BL VREF

ADC_FFT

TFT_CS VREF VREF

# TFT_MOSI VREF

VREF

ADC_G

TFT_RST VREF

LINEA | VREF
AMP_IN | VREF M_INV | PRE MEDIOS VREF MED_HP

LED_DIN LED_DATA VREF

LED_5V | LED_DIN
EQ_OUT VREF | VREF

A_W

M_W

G_W

PRE | VREF | EQ_OUT | VREF | VREF
VREF | PRE

ADC_A VREF M_W

M_INV EQ_OUT LED_DATA | VREF

A_W AGUDOS

TFT_BL

TFT_RST

TFT_SCK

G_W

TFT_CS

TFT_DC

ADC_FFT | Diodo dentro del lazo: Ch se carga al pico real sin la caída de 0,6 V. τ = Rd·Ch = 220k·100n = 22 ms. ADC_x − VREF = pico de la banda. MEDIOS, pasa altas: fc = 1/(2π·10n·√(27k·56k)) = 409 Hz
J4 (adaptador): 1 VCC, 2 GND, 3 DIN, 4 CLK, 5 CS, 6 DC, 7 RST, 8 BL. Waveshare 1,9 pulgadas. BL = GPIO19; datos LED = GPIO25. Cablear por nombre; GH1.25 no tiene este orden. ADC1 permite mantener el Wi⁻Fi activo. J6 alimenta la placa, el PAM8403 y los LED. No conectar simultáneamente VBUS del USB. J5: 1 = 5 V, 2 = DIN, 3 = GND. R31 cerca del primer LED; C26 junto a J5. U6 debe ser AHCT (umbral TTL): un 74HC125 a 5 V no garantiza reconocer 3,3 V. La tira vuelve a GND de potencia; no usar VREF como retorno. GRAVES, pasa bajas: fc = 1/(2π·10k·√(100n·47n)) = 232 Hz | MICROCONTROLADOR, PANTALLA TFT Y PULSADOR

GANANCIA POR BANDA, INVERSOR Y SUMADOR

C3: picos del PAM8403 (J3) | ENTRADA DE LÍNEA Y PREAMPLIFICADOR (G = 1 + R7/R8 = 3,2)

SALIDA DE AUDIO Y ANTIALIASING

R4–R5 mezclan a mono; RV1 ajusta el nivel. Con los deslizables al máximo, la entrada debe ser ≤ 0,11 V de pico (la pantalla avisa CLIP). | MEDIOS, pasa bajas: fc = 1/(2π·10k·√(10n·4n7)) = 2,3 kHz VREF es la tierra de señal: todas las etapas oscilan alrededor de 1,65 V con 3,3 V. | J2: salida de línea. J3: módulo PAM8403 y parlante; RV5 = volumen. R23 protege la salida de un corto. Antialiasing: fc = 1/(2π·10k·√(4n7·2n2)) = 4,95 kHz; fs = 20 kS/s. | U4D: libre, seguidor de VREF. FILTROS ACTIVOS SALLEN-KEY DE SEGUNDO ORDEN (ganancia unitaria, Q ≈ 0,73)

ALIMENTACIÓN ANALÓGICA Y VREF = 1,65 V

Filtro RC R1⁻C1: fc ≈ 159 Hz. C4–C7: desacoplo local de los MCP6004. Deslizables de 10 kΩ lineales entre la salida de cada filtro y VREF; al 50 % la suma es plana. U4C invierte los medios para que los cruces de segundo orden queden en fase. EQ_OUT = VREF − (100k/47k)·[(G_W − VREF) + (M_INV − VREF) + (A_W − VREF)] | DETECTORES DE PICO DE PRECISIÓN Y SEGUIDORES

ILUMINACIÓN NEOPIXEL · 12 LED · FUENTE EXTERNA 5 V / 3 A

AGUDOS, pasa altas: fc = 1/(2π·10n·√(2k7·5k6)) = 4,1 kHz +3V3 R1

10 +3.3VA C1
100u 10V C3

470u 10V

J1

Entrada de línea 3,5 mm

R

S

T GND

C9 RV1 | 1u film
10k log | 1
| 2
| 3 GND
| R6

100k C14

10n film

R12

56k 1%

R10
10k 1%

C12
47n film

GND

GND | GND

R3

10k 1%

C8

10u 16V | D1

1N4148 C22

100n film

D2

## 1N4148 C18 10n film R16 5k6 1%

J4 Waveshare 1.9 ST7789V2

1

2

3
4

5

6

7

8 ⁺3V3 R26

10k 1%

C21

2n2 film

R14
10k 1%

C16
4n7 film

J2

Salida de línea 3,5 mm

R

S

T +5V RV5

10k log 1
2
3 R24
47k GND | GND

C23

100n film

D3
1N4148 C24

100n film

El esquema está dentro de esta presentación. En PDF, ampliar con zoom; también se incluye como archivo independiente en el paquete para exposición.

Anexo: esquema completo para ampliar 1 | 2 | 3 | 4 | 5 | 6 | 7 | 8 | 9 | 10 | 11
1 | 2 | 3 | 4 | 5 | 6 | 7 | 8 | 9 | 10 | 11

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
FGH Date: 2026⁻10⁻22 KiCad E.D.A. 10.0.0

Size: A2 | Rev: D.2
| Id: 1/1

Title: Ecualizador de audio de tres bandas con visualizador ESP32

File: ecualizador.kicad_sch

Sheet: /

Electrónica II — Universidad de la Costa

Amplificadores operacionales MCP6004 (riel a riel, 3,3 V)

Generado desde herramientas/circuito.py ¹

2

3 RV3

10k lin | PWR_FLAG
| C7

100n V+

4 V- 11 U4E GND

1 -

2 +

3 | U1A | 8 ⁻

9 +

10 | U4C

D1

1N4148 C22

100n film

R27

220k 1 ⁻

2 +

3 | U3A ¹

2

3 RV4

10k lin | D2

1N4148 V+

4 V- 11 U1E C18

10n film

R15

2k7 1%+

5 -

6

7 U2B

C24

100n film

+

5 -

6

7 U3B

1 ⁻

2 +

3 | U4A | R28
220k | +

12 -

13

14 U4D

C17

10n film

R16
5k6 1% +

12 -

13

14 U3D

C12

47n film

R11

27k 1%

R17

47k 1%

R18

47k 1%

C6

100n C5

100n V+

4 V- 11 U3E V+

4 V- 11 U2E 8 -

9 +

10 | U2C R22
| 100k 1%

8 -

9 +

10 | U1C R10

10k 1%

C11

100n film

D3

1N4148 R20

47k 1%

R19

47k 1%

R9

10k 1%

R21

47k 1%

PWR_FLAG

GND

GND | GND

R3

| 10k 1%

C8

10u 16V ⁺3.3VA | +5V C16

4n7 film

1 -

2 +

3 | U2A R26

10k 1%

R14

10k 1%

C21

2n2 film

R13
10k 1% +5V 9 | 8 10 | U6C

74AHCT125 GND

C20

4n7 film

+

12 -

13

14 U2D

GND

GND

C25

100n R25

10k 1% | +5V 12 | 11 13 | U6D
74AHCT125 | GND
GND | +5V | GND

7 VCC 14 U6E 74AHCT125 +5V R29

220k | +

5 -

6

7 U4B

GND

8 ⁻

9 +

10 | U3C

C23

100n film

SW1 Pulsador | GND

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
J4 Waveshare 1.9 ST7789V2 ⁺3V3 GND

GND

R30

10k +5V | USB

3V3 1

EN 2

VP/IO36 3

VN/IO39 4

IO34 5

IO35 6

IO32 7

IO33 8

IO25 9

IO26 10

IO27 11

IO14 12

IO12 13 | GND 14

IO13 15

SD2/IO9 16

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

ESP32⁻DevKitC V4 GND

1

2

3

J5NeoPixel 5V DIN GND

GND

R24

47k | 1

2

3 RV5

10k log | GND | +5VR
| | S T

J2

Salida de línea 3,5 mm

GND

GND

1

2

3

4

J3PAM8403 +3V3 GND +5V R6

100k GND

1

2

3 RV1

10k log +3.3VA | R5
10k | GND

C9

1u film

C10

10u 16V R1

10 | R8
10k 1% ⁺3V3 | GND

C19

10u 16V | R23

100 ⁺

12 -

13

14 U1D

GND

GND +5VR32

10k 1

2

J6

Entrada 5V 3A ⁺5V GND

C15

10n film

R

S

T

J1

Entrada de línea 3,5 mm

R4

10k | R7

22k 1% ⁺

5 -

6

7 U1B

PWR_FLAG

C13

10n film

C26

1000u 10V 1

2 | U6A3
74AHCT125 ⁺5V | GND

R2

10k 1%

R12

56k 1%

C1

100u 10V | C2
100n | C4
100n 1

2

3 RV2

10k lin | GND

4

5 | U6B6

74AHCT125 R31

330 C14 10n film

C3

470u 10V

IN_L

IN_L | VREF LINEA | BTN
A_W | VREF

IN_R

IN_R

LINEA

ADC_G

GRAVES VREF

AGUDOS

ADC_M

G_W

PRE GRAVES | MEDIOS

LED_5V

ADC_A M_W

TFT_BL

TFT_SCK

AMP_IN

TFT_MOSI ADC_M

LED_DATA | BTN
TFT_DC | TFT_BL VREF

ADC_FFT

TFT_CS VREF VREF

TFT_MOSI VREF

VREF

ADC_G

TFT_RST VREF

LINEA | VREF
AMP_IN | VREF M_INV | PRE MEDIOS VREF MED_HP

LED_DIN LED_DATA VREF

LED_5V | LED_DIN
EQ_OUT VREF | VREF

A_W

M_W

G_W

PRE | VREF | EQ_OUT | VREF | VREF
VREF | PRE

ADC_A VREF M_W

M_INV EQ_OUT LED_DATA | VREF

A_W AGUDOS

TFT_BL

TFT_RST

TFT_SCK

G_W

TFT_CS

TFT_DC

ADC_FFT | Diodo dentro del lazo: Ch se carga al pico real sin la caída de 0,6 V. τ = Rd·Ch = 220k·100n = 22 ms. ADC_x − VREF = pico de la banda. MEDIOS, pasa altas: fc = 1/(2π·10n·√(27k·56k)) = 409 Hz
J4 (adaptador): 1 VCC, 2 GND, 3 DIN, 4 CLK, 5 CS, 6 DC, 7 RST, 8 BL. Waveshare 1,9 pulgadas. BL = GPIO19; datos LED = GPIO25. Cablear por nombre; GH1.25 no tiene este orden. ADC1 permite mantener el Wi⁻Fi activo. J6 alimenta la placa, el PAM8403 y los LED. No conectar simultáneamente VBUS del USB. J5: 1 = 5 V, 2 = DIN, 3 = GND. R31 cerca del primer LED; C26 junto a J5. U6 debe ser AHCT (umbral TTL): un 74HC125 a 5 V no garantiza reconocer 3,3 V. La tira vuelve a GND de potencia; no usar VREF como retorno. GRAVES, pasa bajas: fc = 1/(2π·10k·√(100n·47n)) = 232 Hz | MICROCONTROLADOR, PANTALLA TFT Y PULSADOR

GANANCIA POR BANDA, INVERSOR Y SUMADOR

C3: picos del PAM8403 (J3) | ENTRADA DE LÍNEA Y PREAMPLIFICADOR (G = 1 + R7/R8 = 3,2)

SALIDA DE AUDIO Y ANTIALIASING

R4–R5 mezclan a mono; RV1 ajusta el nivel. Con los deslizables al máximo, la entrada debe ser ≤ 0,11 V de pico (la pantalla avisa CLIP). | MEDIOS, pasa bajas: fc = 1/(2π·10k·√(10n·4n7)) = 2,3 kHz VREF es la tierra de señal: todas las etapas oscilan alrededor de 1,65 V con 3,3 V. | J2: salida de línea. J3: módulo PAM8403 y parlante; RV5 = volumen. R23 protege la salida de un corto. Antialiasing: fc = 1/(2π·10k·√(4n7·2n2)) = 4,95 kHz; fs = 20 kS/s. | U4D: libre, seguidor de VREF. FILTROS ACTIVOS SALLEN-KEY DE SEGUNDO ORDEN (ganancia unitaria, Q ≈ 0,73)

ALIMENTACIÓN ANALÓGICA Y VREF = 1,65 V

Filtro RC R1⁻C1: fc ≈ 159 Hz. C4–C7: desacoplo local de los MCP6004. Deslizables de 10 kΩ lineales entre la salida de cada filtro y VREF; al 50 % la suma es plana. U4C invierte los medios para que los cruces de segundo orden queden en fase. EQ_OUT = VREF − (100k/47k)·[(G_W − VREF) + (M_INV − VREF) + (A_W − VREF)] | DETECTORES DE PICO DE PRECISIÓN Y SEGUIDORES

ILUMINACIÓN NEOPIXEL · 12 LED · FUENTE EXTERNA 5 V / 3 A

AGUDOS, pasa altas: fc = 1/(2π·10n·√(2k7·5k6)) = 4,1 kHz +3V3 R1

10 | +3.3VA C1
100u 10V C3

470u 10V

J1

Entrada de línea 3,5 mm

R

S

T GND

C9 RV1 | 1u film
10k log | 1

2

3 GND

R6

100k C14

10n film

R12

56k 1%

R10

10k 1%

C12

47n film

GND

GND | GND

R3

10k 1%

C8

10u 16V | D1

1N4148 C22

100n film

D2

1N4148 C18 10n film R16 5k6 1%

J4 Waveshare 1.9 ST7789V2

1

2

3

4

5

6

7

8 ⁺3V3 R26

10k 1%

C21

2n2 film

R14

10k 1%

C16

4n7 film

J2

Salida de línea 3,5 mm

R

S

T +5V RV5

10k log | 1

2

3 R24

47k GND | GND

C23

100n film

D3

1N4148 C24

100n film

El esquema está dentro de esta presentación. En PDF, ampliar con zoom; también se incluye como archivo

2026-10-22

independiente en el paquete para exposición.

Anexo: esquema completo para ampliar

Esta página permite consultar el esquema sin depender de las carpetas del computador ori-ginal. Para leer los valores pequeños, abrir el PDF de la presentación y ampliar esta página, o abrir esquema.pdf dentro del paquete de exposición.
