davixcky/ecualizador-esp32/docs/archivo/README.md

# Archivo histórico

La presentación HTML anterior se conserva para referencia. Contiene especificaciones anteriores y no corresponde a la entrega actual. La fuente vigente es `../latex/presentacion.tex`; editar y compilar esa versión.
