davixcky/ecualizador-esp32/docs/latex/marca-cuc.tex

% Identidad: Manual resumido de marca CUC, edición publicada en agosto de 2024.
% Logo vectorial oficial, sin reconstrucción ni modificación de sus elementos.
\usepackage{fontspec}
\usepackage{unicode-math}
\setmathfont{Latin Modern Math}
\defaultfontfeatures{Ligatures=TeX}
\setmainfont{RedHatDisplay}[Path=fuentes/,Extension=.ttf,UprightFont=*-Regular,BoldFont=*-Bold,ItalicFont=*-Italic]
\setsansfont{RedHatDisplay}[Path=fuentes/,Extension=.ttf,UprightFont=*-Regular,BoldFont=*-Bold,ItalicFont=*-Italic]
\definecolor{cucrojo}{HTML}{A3161A}
\definecolor{cucoro}{HTML}{C9A227}
\definecolor{cucgris}{HTML}{595959}
\definecolor{cucplata}{HTML}{CCCCCC}
\newcommand{\logocuc}[1]{}
