davixcky/ecualizador-esp32/img/circuitos/antialias.pdf

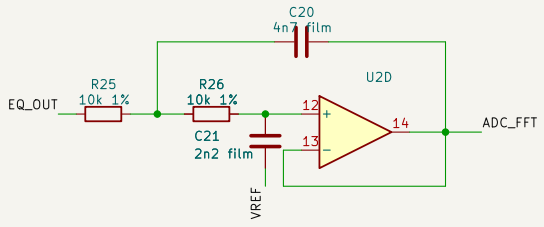
[picture p95: figure]
film; C21 2n2 film; ADC_FFT EQ_OUT; VREF R26
