davixcky/ecualizador-esp32/img/circuitos/graves.pdf

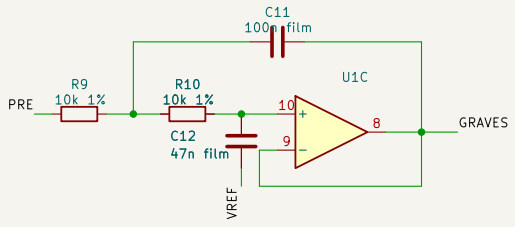
[picture p96: figure]
film; C12 47n film; GRAVES PRE; VREF R10
