davixcky/ecualizador-esp32/docs/fase1/rubrica-fase2.png

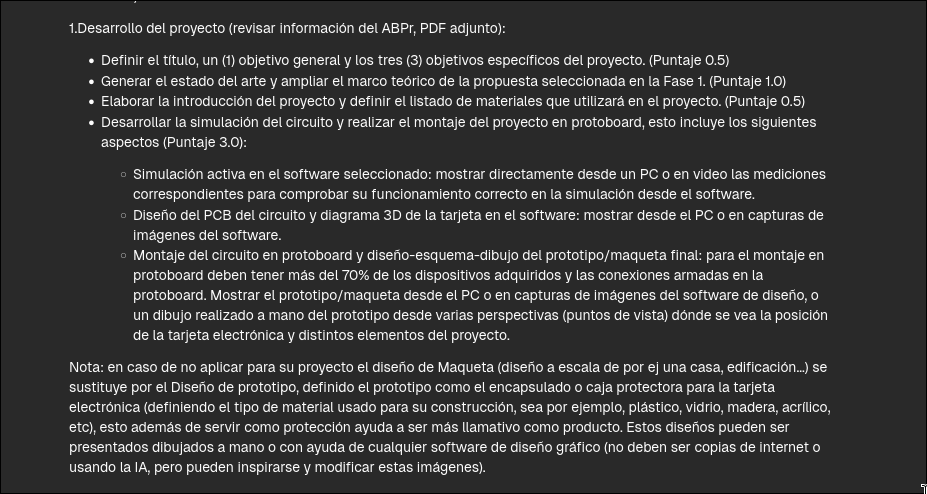
docs/fase1/rubrica-fase2.png
