davixcky/ecualizador-esp32/docs/presentacion/png/02.png

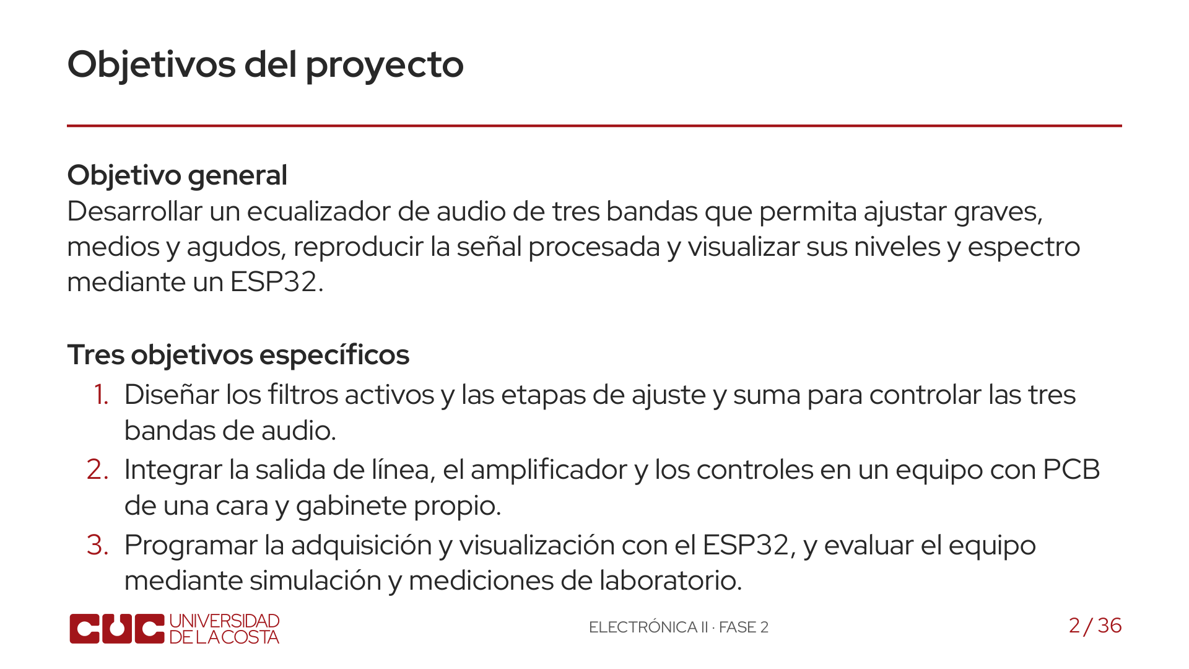
docs/presentacion/png/02.png
