davixcky/ecualizador-esp32/docs/presentacion/png/03.png

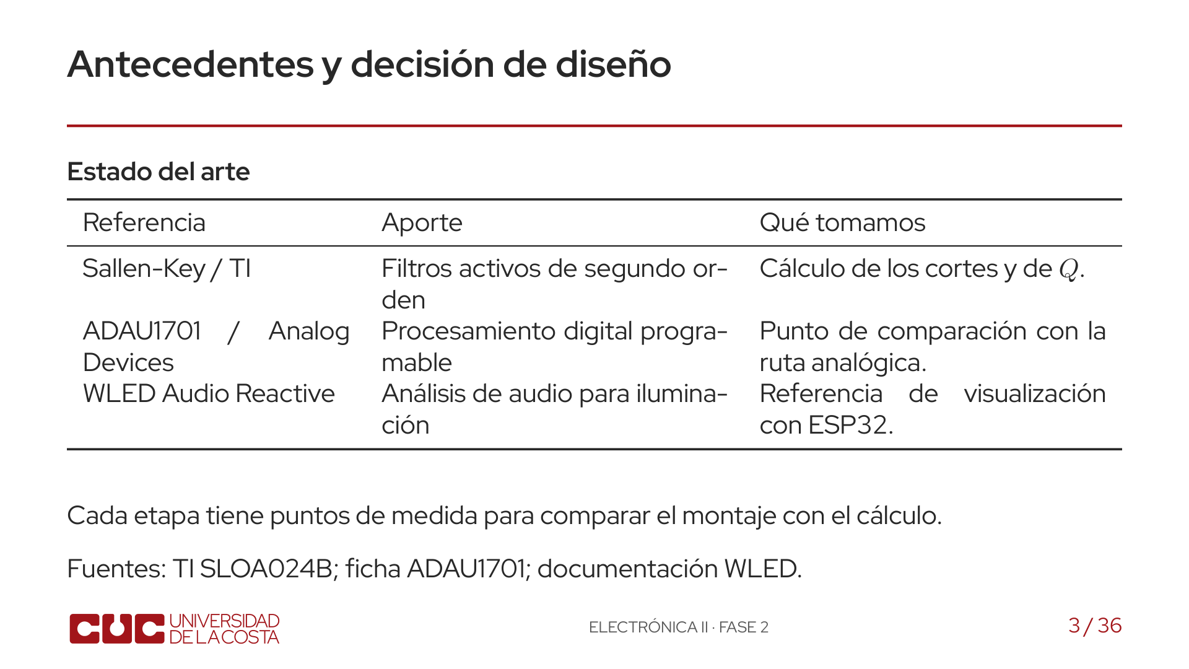
docs/presentacion/png/03.png
