davixcky/ecualizador-esp32/docs/presentacion/png/05.png

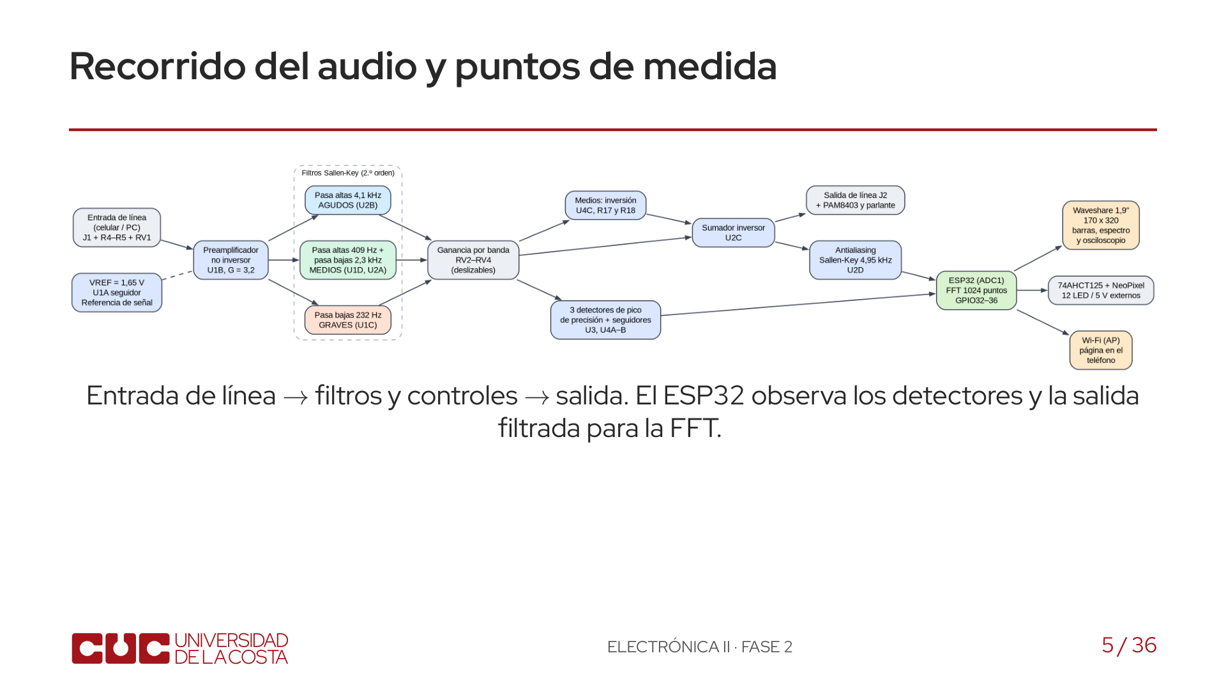
docs/presentacion/png/05.png
