davixcky/ecualizador-esp32/docs/presentacion/png/10.png

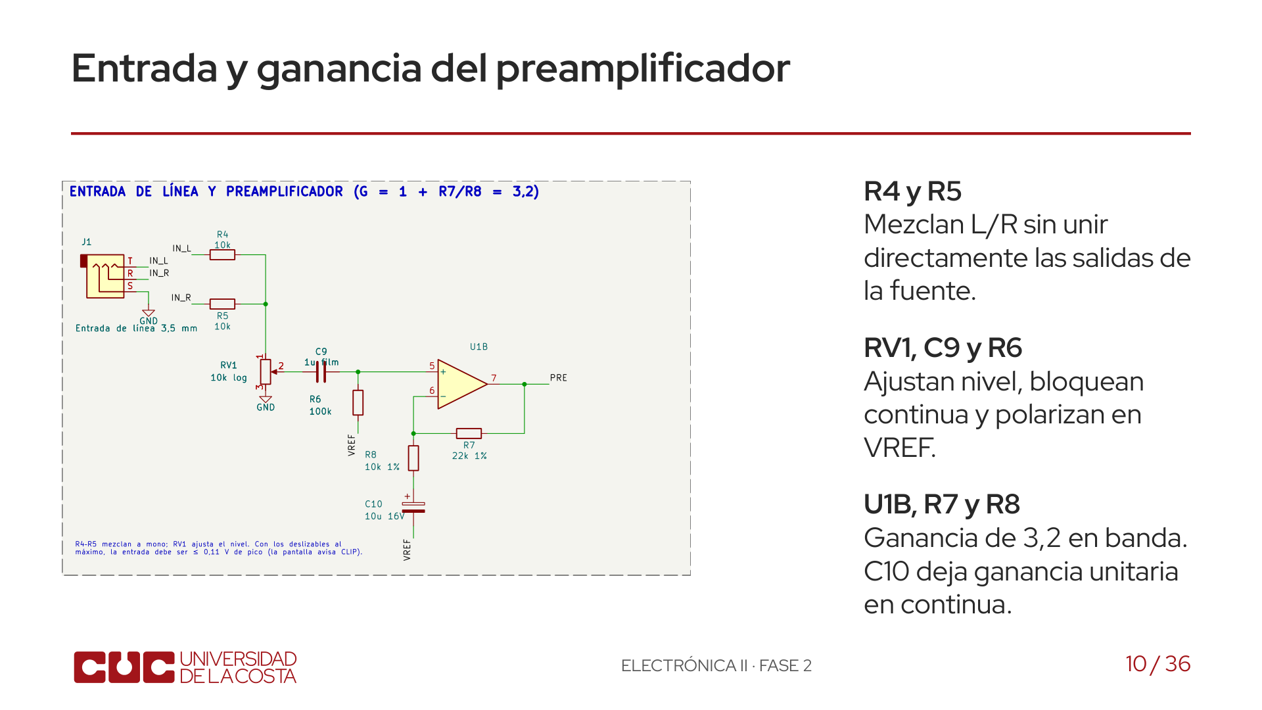
docs/presentacion/png/10.png
