davixcky/ecualizador-esp32/docs/presentacion/png/15.png

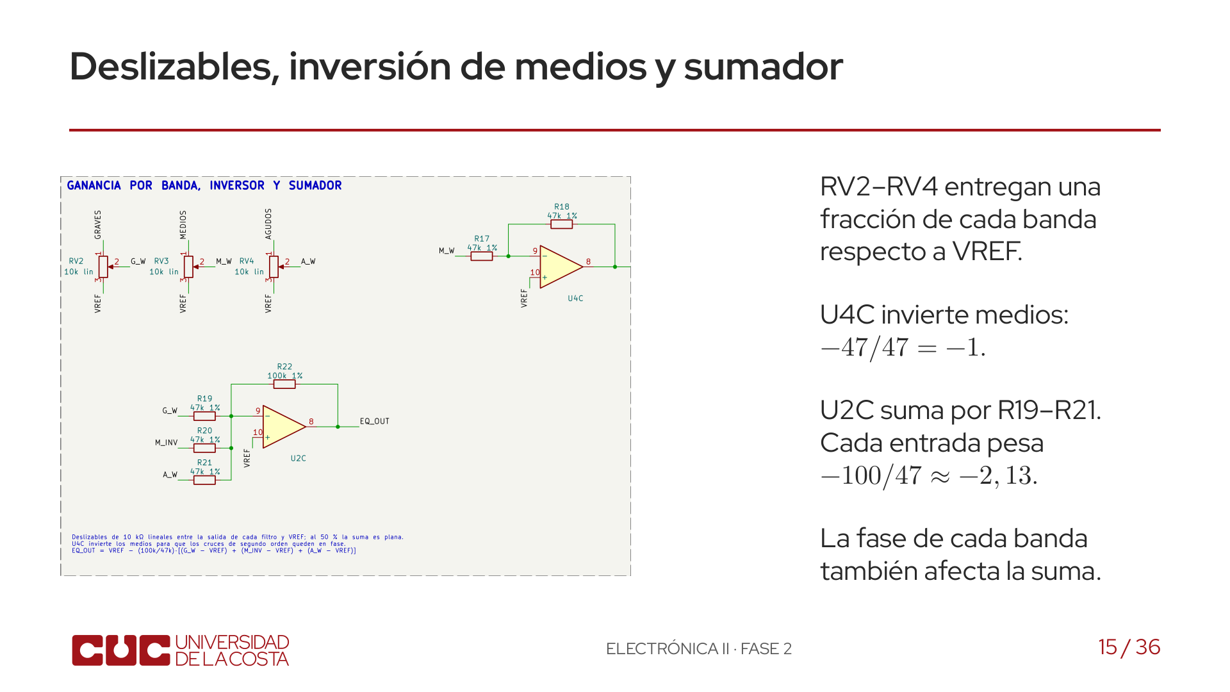
docs/presentacion/png/15.png
