davixcky/ecualizador-esp32/docs/presentacion/png/17.png

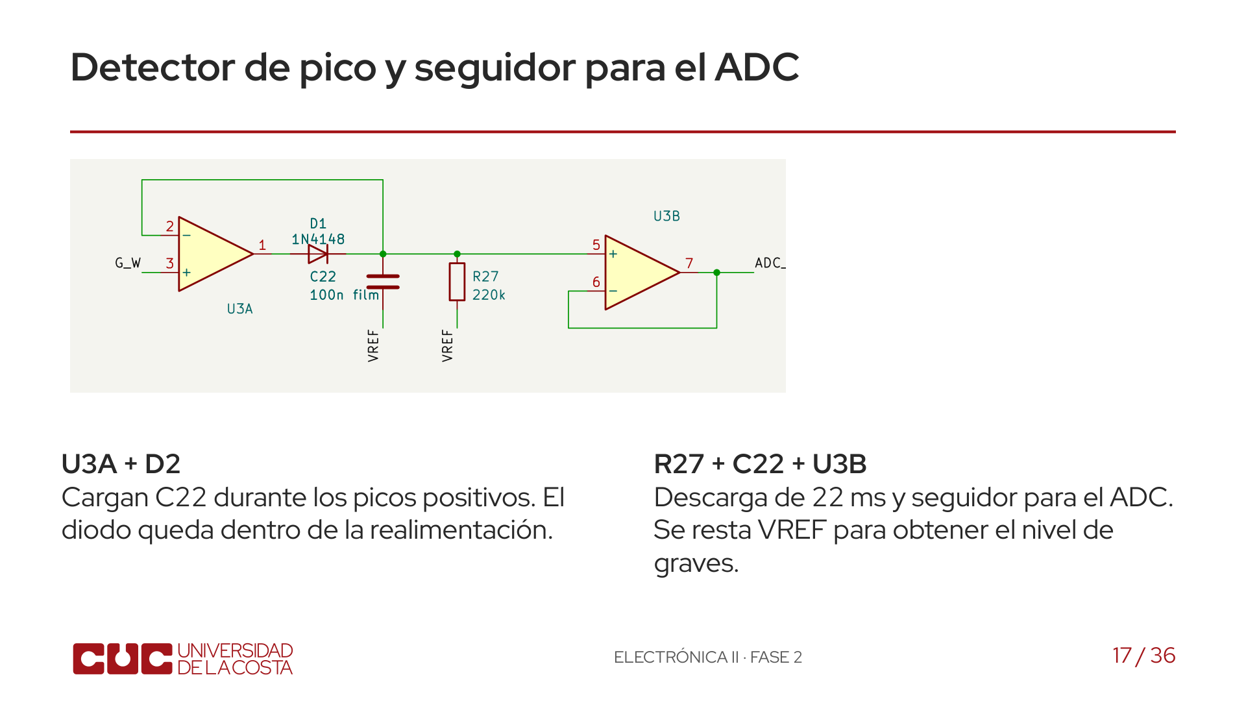
docs/presentacion/png/17.png
