davixcky/ecualizador-esp32/docs/presentacion/png/18.png

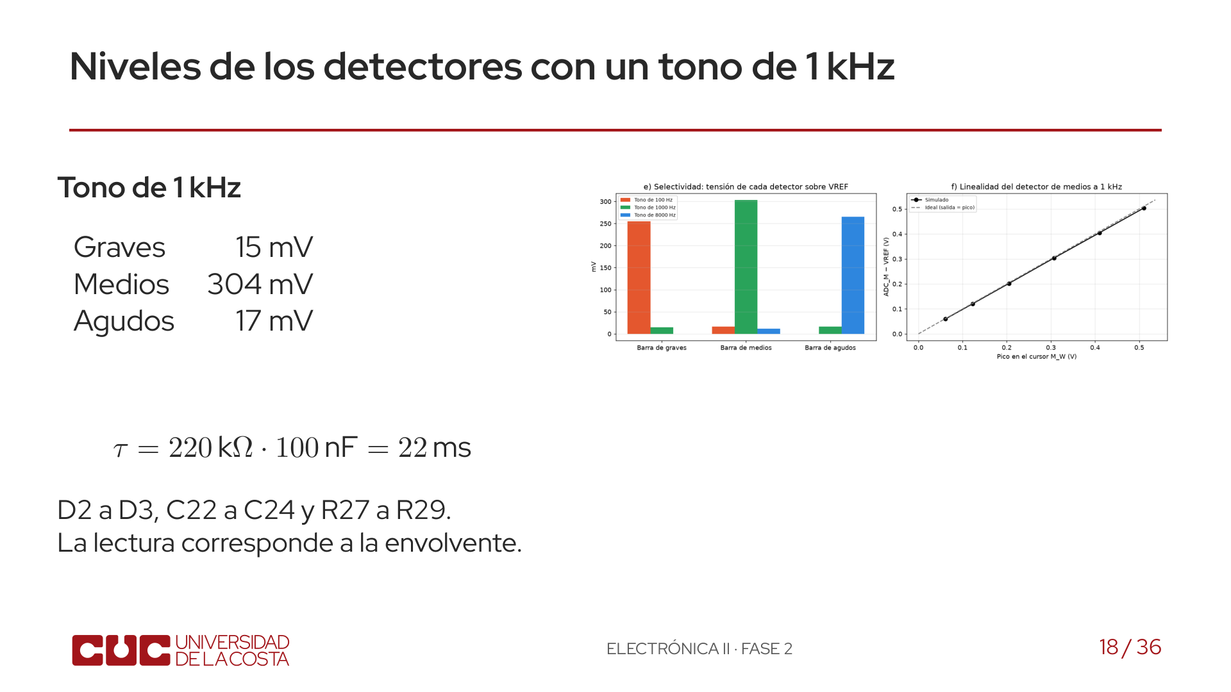
docs/presentacion/png/18.png
