davixcky/ecualizador-esp32/docs/presentacion/png/20.png

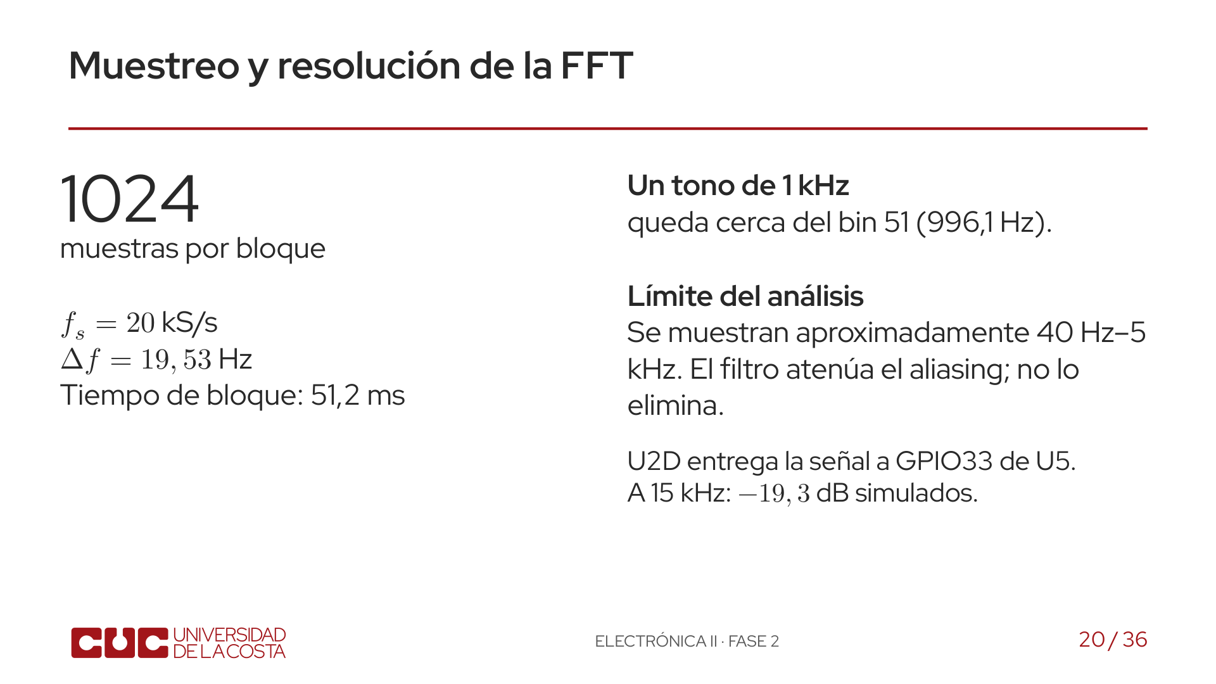
docs/presentacion/png/20.png
