davixcky/ecualizador-esp32/docs/presentacion/png/21.png

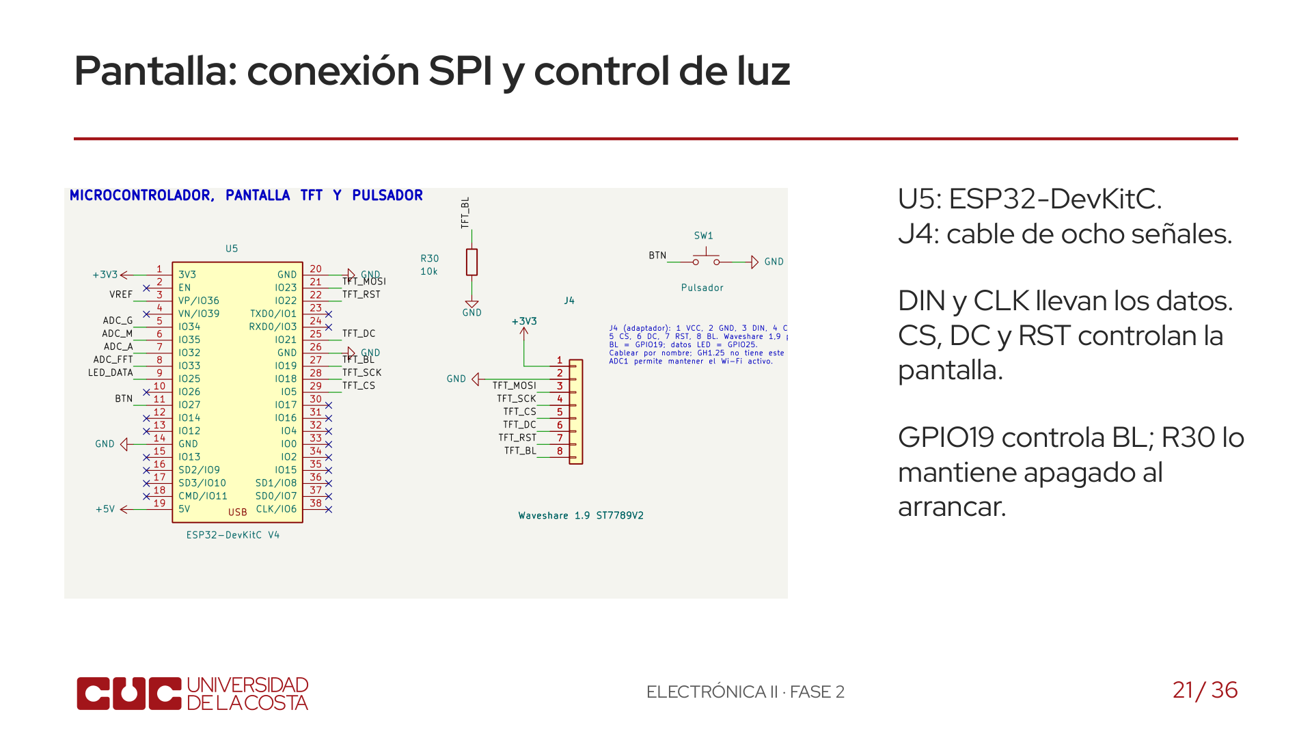
docs/presentacion/png/21.png
