davixcky/ecualizador-esp32/docs/presentacion/png/24.png

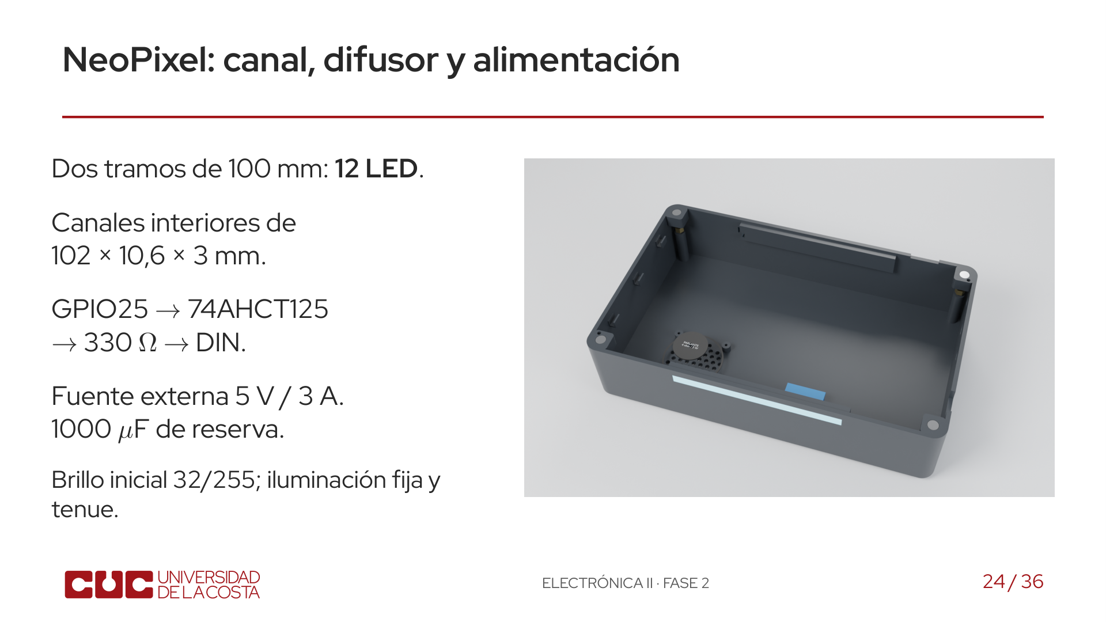
docs/presentacion/png/24.png
