davixcky/ecualizador-esp32/docs/presentacion/png/25.png

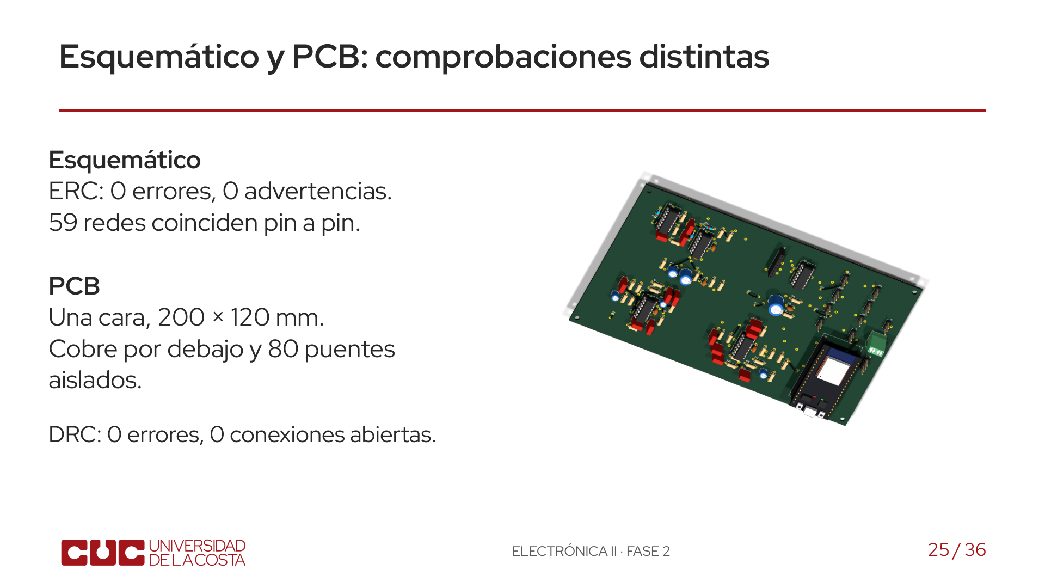
docs/presentacion/png/25.png
