davixcky/ecualizador-esp32/docs/presentacion/png/26.png

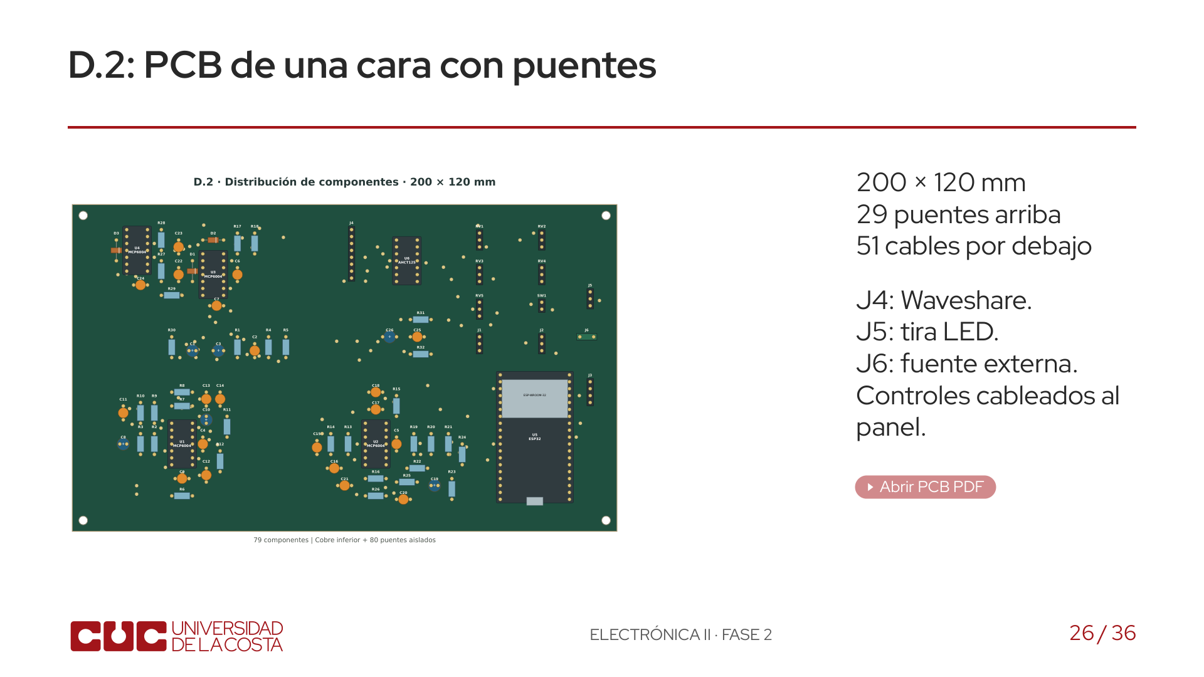
docs/presentacion/png/26.png
