davixcky/ecualizador-esp32/docs/presentacion/png/34.png

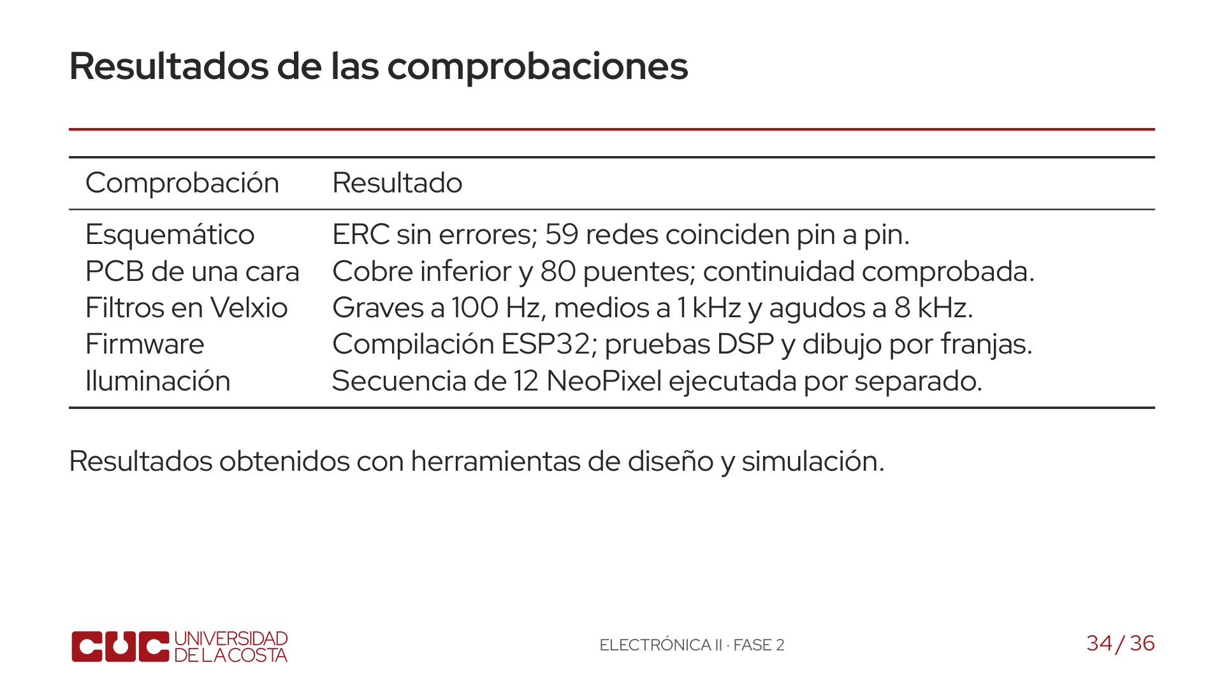
docs/presentacion/png/34.png
