davixcky/ecualizador-esp32/docs/validacion/velxio-diagnosticos/integrado-1000Hz.vlx.png

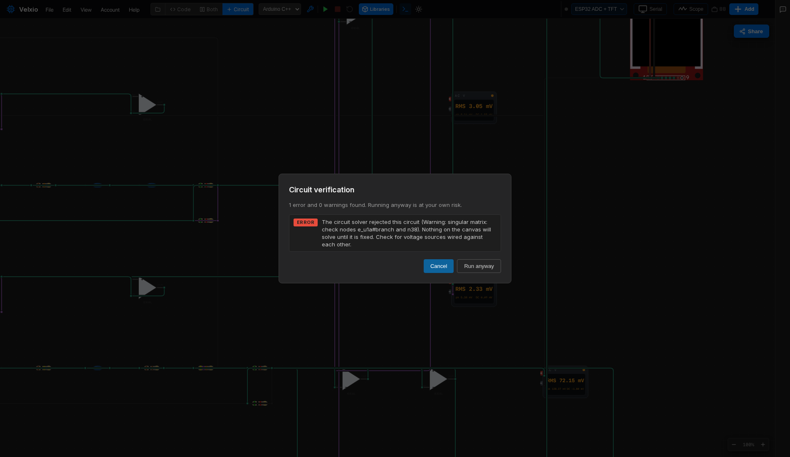
docs/validacion/velxio-diagnosticos/integrado-1000Hz.vlx.png
