davixcky/ecualizador-esp32/img/3d-gabinete-debajo.png

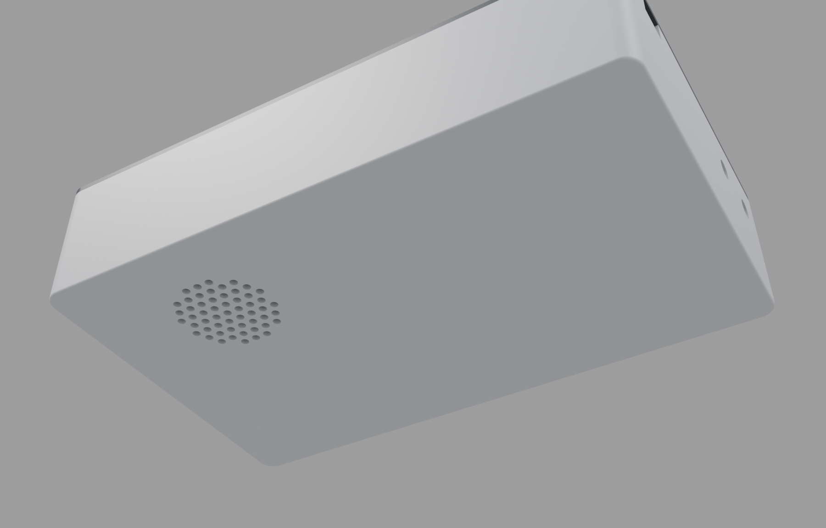
img/3d-gabinete-debajo.png
