davixcky/ecualizador-esp32/img/3d-placa-iso.png

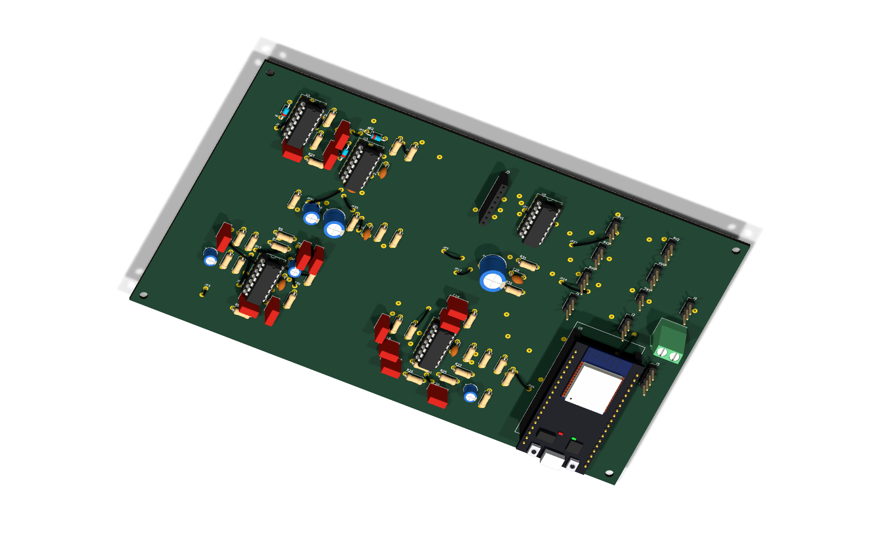
img/3d-placa-iso.png
