davixcky/ecualizador-esp32/img/circuitos/antialias.png

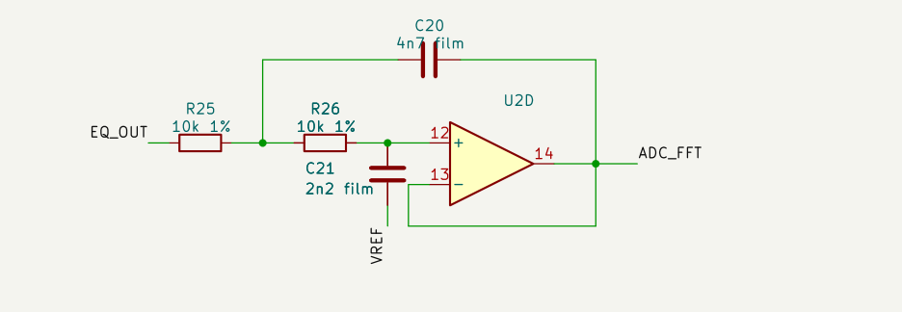
img/circuitos/antialias.png
