davixcky/ecualizador-esp32/img/circuitos/detectores.png

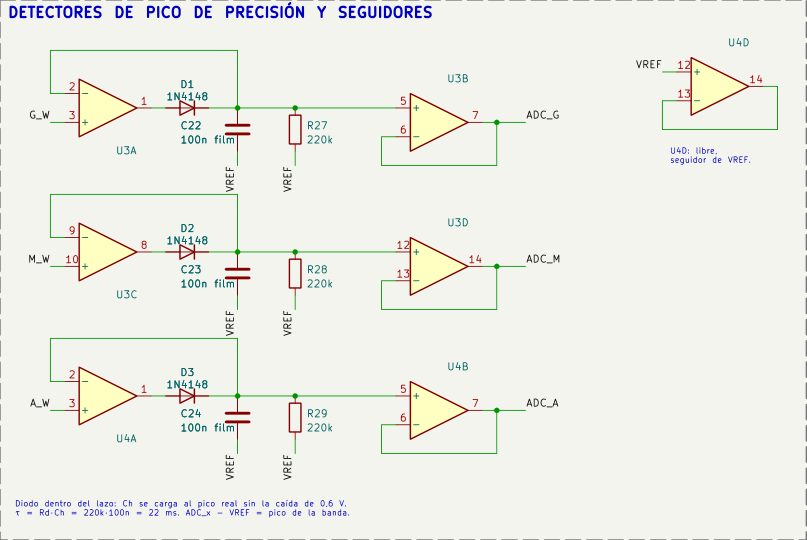
img/circuitos/detectores.png
