davixcky/ecualizador-esp32/img/circuitos/entrada.png

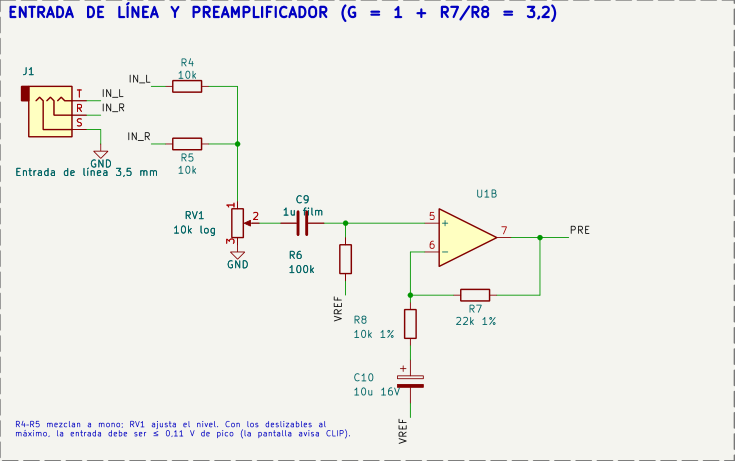
img/circuitos/entrada.png
