davixcky/ecualizador-esp32/img/circuitos/filtros.png

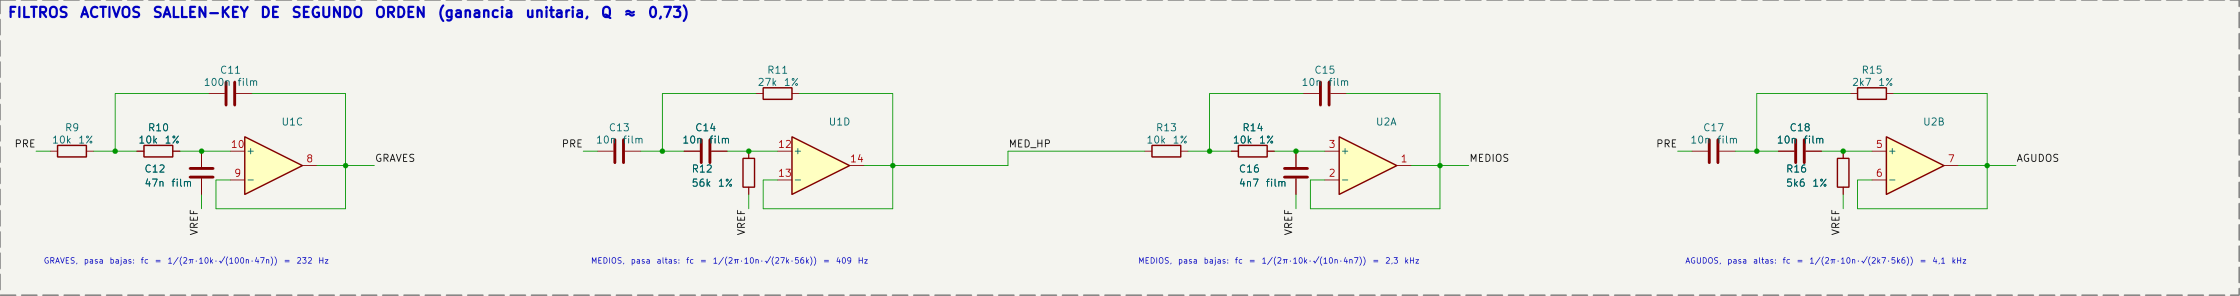
img/circuitos/filtros.png
