davixcky/ecualizador-esp32/img/circuitos/medios.png

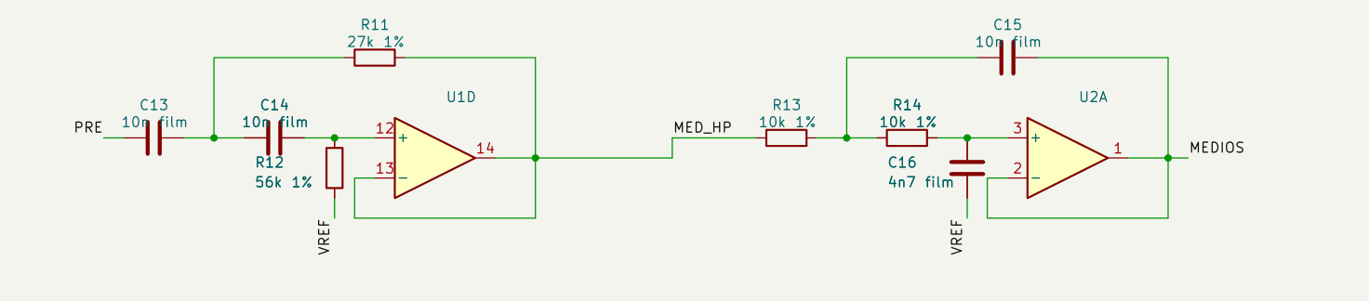
img/circuitos/medios.png
