davixcky/ecualizador-esp32/img/circuitos/neopixel.png

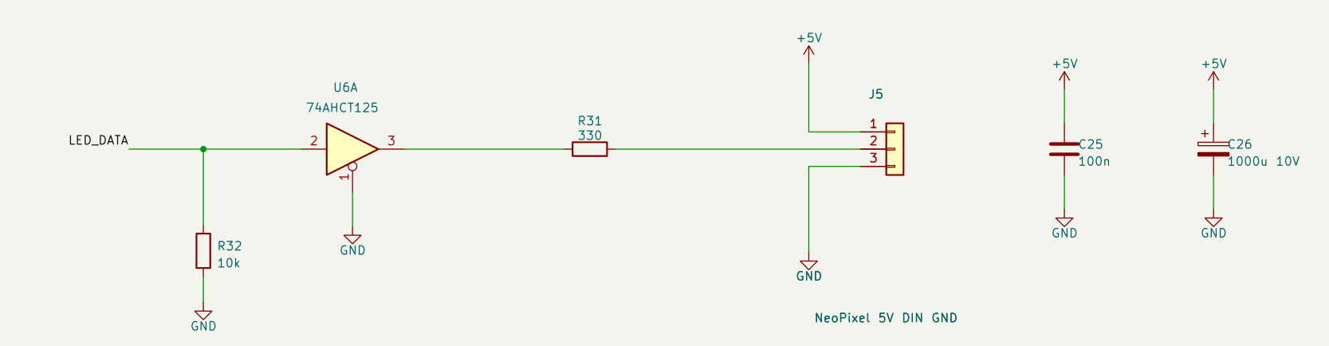
img/circuitos/neopixel.png
