davixcky/ecualizador-esp32/img/circuitos/pantalla.png

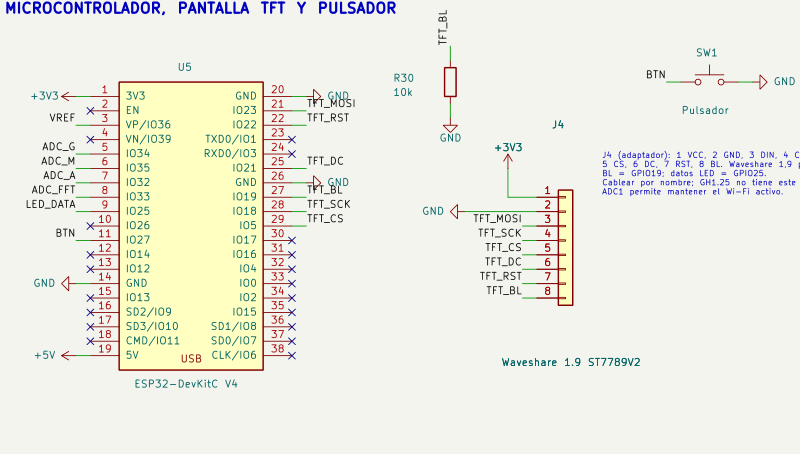
img/circuitos/pantalla.png
