davixcky/ecualizador-esp32/img/circuitos/referencia.png

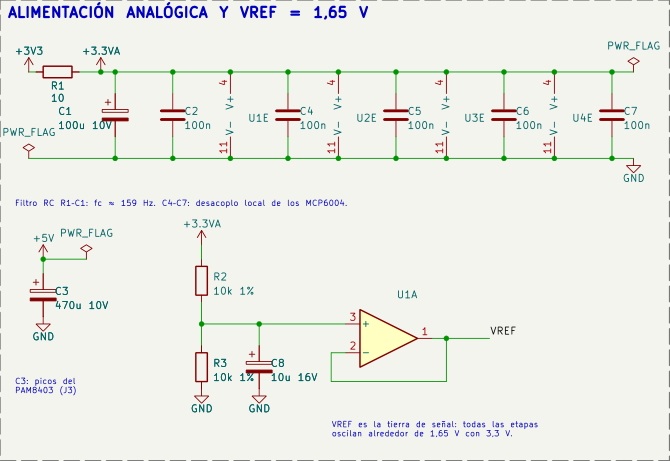
img/circuitos/referencia.png
