davixcky/ecualizador-esp32/img/pcb-una-cara-puentes.png

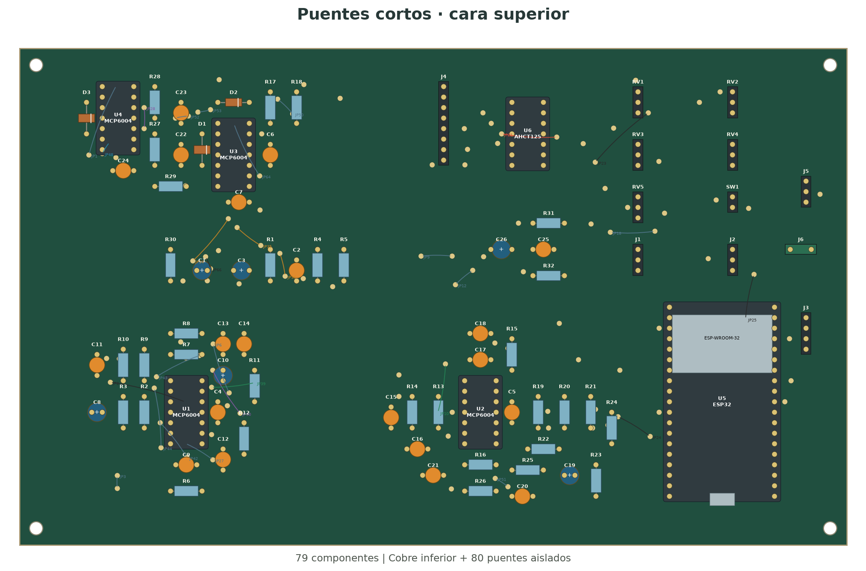
img/pcb-una-cara-puentes.png
