davixcky/ecualizador-esp32/img/pcb-una-cara-soldadura.png

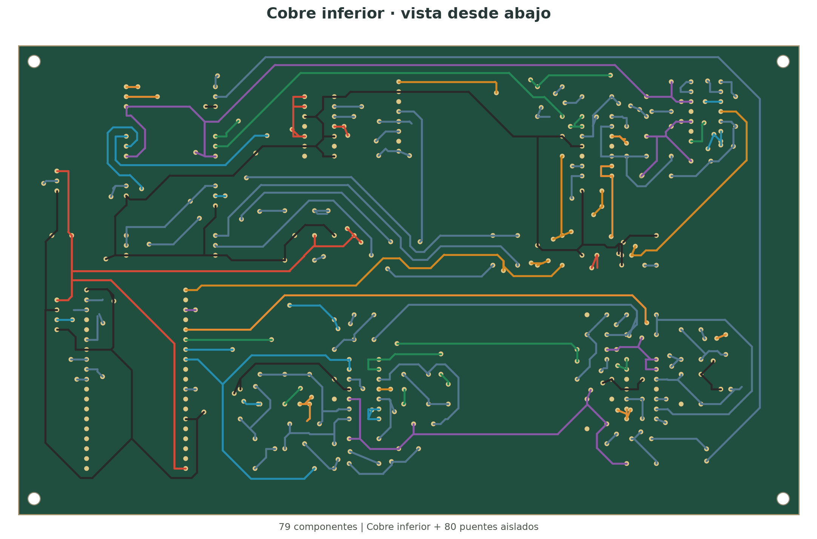
img/pcb-una-cara-soldadura.png
