davixcky/ecualizador-esp32/img/sim-comparacion-fase.png

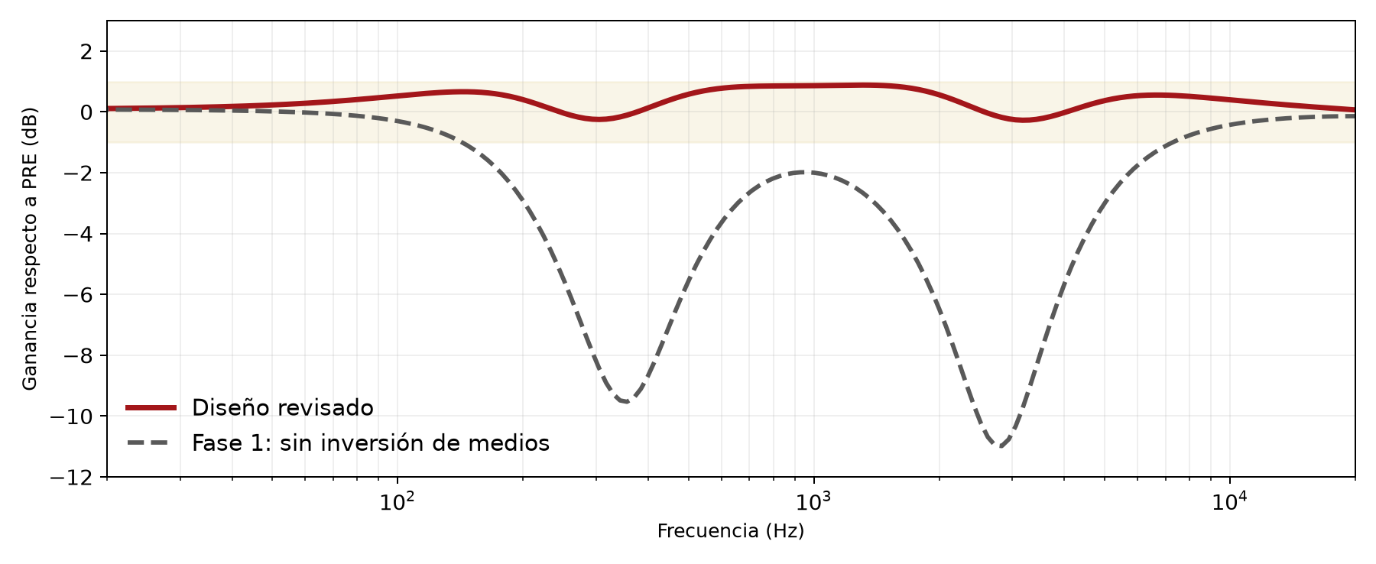
img/sim-comparacion-fase.png
