davixcky/ecualizador-esp32/img/ui-tft-arranque.png

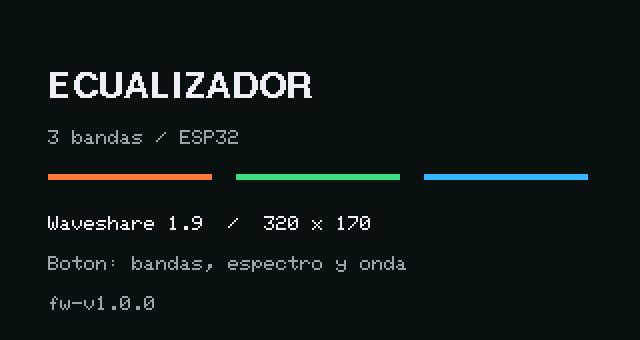
img/ui-tft-arranque.png
