davixcky/ecualizador-esp32/img/ui-tft-bandas.png

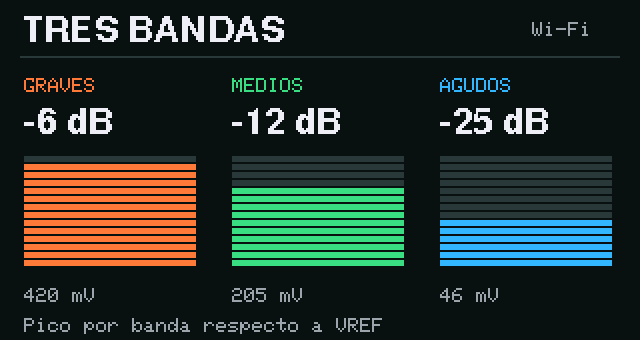
img/ui-tft-bandas.png
