davixcky/ecualizador-esp32/img/ui-tft-espectro.png

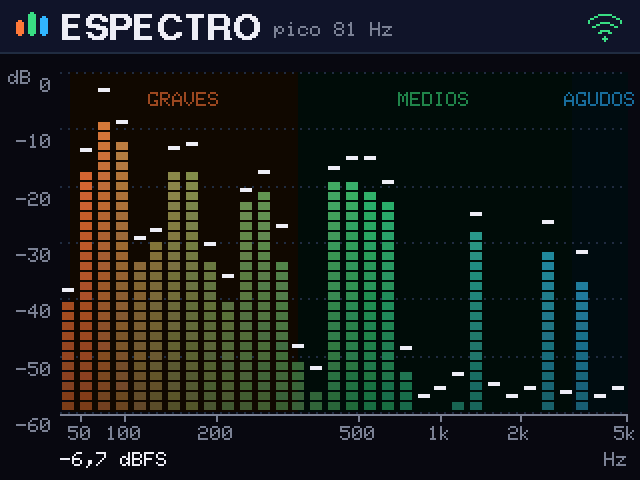
img/ui-tft-espectro.png
