davixcky/ecualizador-esp32/img/ui-tft-onda.png

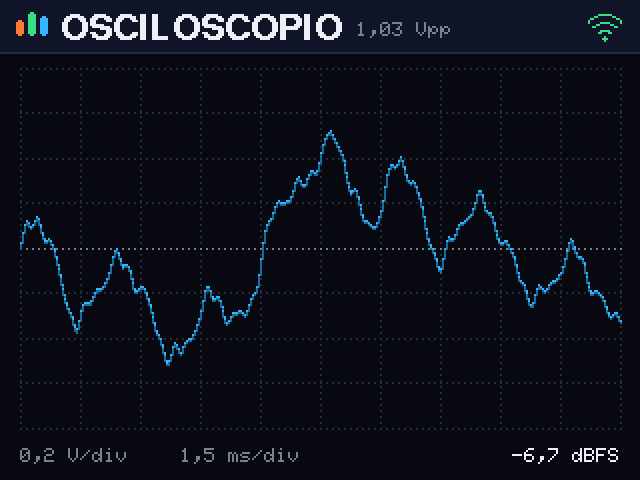
img/ui-tft-onda.png
