davixcky/ecualizador-esp32/img/velxio-integrado-1000Hz.png

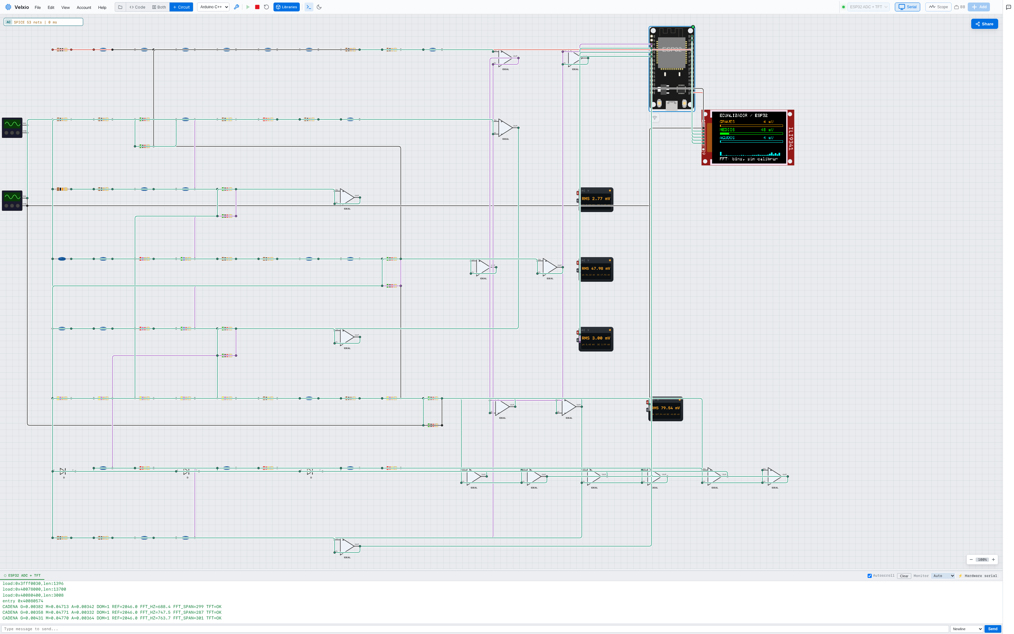
img/velxio-integrado-1000Hz.png
