davixcky/ecualizador-esp32/img/velxio-tft-8000Hz.png

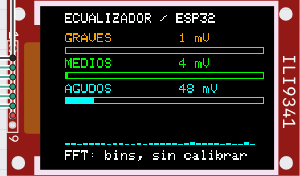
img/velxio-tft-8000Hz.png
