davixcky/ecualizador-esp32/hardware/fabricacion/bom.csv

Reference | Value | Footprint | QUANTITY
C1 | 100u 10V | Capacitor_THT:CP_Radial_D6.3mm_P2.50mm | 1
C2,C4-C7 | 100n | Capacitor_THT:C_Disc_D5.0mm_W2.5mm_P5.00mm | 5
C3 | 470u 10V | Capacitor_THT:CP_Radial_D8.0mm_P3.50mm | 1
C8,C10,C19 | 10u 16V | Capacitor_THT:CP_Radial_D5.0mm_P2.00mm | 3
C9 | 1u film | Capacitor_THT:C_Rect_L7.2mm_W3.0mm_P5.00mm_FKS2_FKP2_MKS2_MKP2 | 1
C11,C22-C24 | 100n film | Capacitor_THT:C_Rect_L7.2mm_W3.0mm_P5.00mm_FKS2_FKP2_MKS2_MKP2 | 4
C12 | 47n film | Capacitor_THT:C_Rect_L7.2mm_W3.0mm_P5.00mm_FKS2_FKP2_MKS2_MKP2 | 1
C13-C15,C17,C18 | 10n film | Capacitor_THT:C_Rect_L7.2mm_W3.0mm_P5.00mm_FKS2_FKP2_MKS2_MKP2 | 5
C16,C20 | 4n7 film | Capacitor_THT:C_Rect_L7.2mm_W3.0mm_P5.00mm_FKS2_FKP2_MKS2_MKP2 | 2
C21 | 2n2 film | Capacitor_THT:C_Rect_L7.2mm_W3.0mm_P5.00mm_FKS2_FKP2_MKS2_MKP2 | 1
D1-D3 | 1N4148 | Diode_THT:D_DO-35_SOD27_P7.62mm_Horizontal | 3
J1 | Entrada de línea 3,5 mm | Connector_Audio:Jack_3.5mm_CUI_SJ1-3523N_Horizontal | 1
J2 | Salida de línea 3,5 mm | Connector_Audio:Jack_3.5mm_CUI_SJ1-3523N_Horizontal | 1
J3 | PAM8403 | Connector_PinHeader_2.54mm:PinHeader_1x04_P2.54mm_Vertical | 1
J4 | TFT ILI9341 2,8" SPI | Connector_PinSocket_2.54mm:PinSocket_1x14_P2.54mm_Vertical | 1
R1,R30 | 10 | Resistor_THT:R_Axial_DIN0207_L6.3mm_D2.5mm_P7.62mm_Horizontal | 2
R2,R3,R8-R10,R13,R14,R25,R26 | 10k 1% | Resistor_THT:R_Axial_DIN0207_L6.3mm_D2.5mm_P7.62mm_Horizontal | 9
R4,R5 | 10k | Resistor_THT:R_Axial_DIN0207_L6.3mm_D2.5mm_P7.62mm_Horizontal | 2
R6 | 100k | Resistor_THT:R_Axial_DIN0207_L6.3mm_D2.5mm_P7.62mm_Horizontal | 1
R7 | 22k 1% | Resistor_THT:R_Axial_DIN0207_L6.3mm_D2.5mm_P7.62mm_Horizontal | 1
R11 | 27k 1% | Resistor_THT:R_Axial_DIN0207_L6.3mm_D2.5mm_P7.62mm_Horizontal | 1
R12 | 56k 1% | Resistor_THT:R_Axial_DIN0207_L6.3mm_D2.5mm_P7.62mm_Horizontal | 1
R15 | 2k7 1% | Resistor_THT:R_Axial_DIN0207_L6.3mm_D2.5mm_P7.62mm_Horizontal | 1
R16 | 5k6 1% | Resistor_THT:R_Axial_DIN0207_L6.3mm_D2.5mm_P7.62mm_Horizontal | 1
R17-R21 | 47k 1% | Resistor_THT:R_Axial_DIN0207_L6.3mm_D2.5mm_P7.62mm_Horizontal | 5
R22 | 100k 1% | Resistor_THT:R_Axial_DIN0207_L6.3mm_D2.5mm_P7.62mm_Horizontal | 1
R23 | 100 | Resistor_THT:R_Axial_DIN0207_L6.3mm_D2.5mm_P7.62mm_Horizontal | 1
R24 | 47k | Resistor_THT:R_Axial_DIN0207_L6.3mm_D2.5mm_P7.62mm_Horizontal | 1
R27-R29 | 220k | Resistor_THT:R_Axial_DIN0207_L6.3mm_D2.5mm_P7.62mm_Horizontal | 3
RV1,RV5 | 10k log | Potentiometer_THT:Potentiometer_Alps_RK09K_Single_Vertical | 2
RV2-RV4 | 10k lin | Potentiometer_THT:Potentiometer_Bourns_PTA3043_Single_Slide | 3
SW1 | Pulsador | Button_Switch_THT:SW_PUSH_6mm_H5mm | 1
U1-U4 | MCP6004 | Package_DIP:DIP-14_W7.62mm_Socket | 4
U5 | ESP32-DevKitC V4 | Ecualizador:ESP32-DevKitC-38_Zocalo | 1
