davixcky/ecualizador-esp32/hardware/una-cara/puentes.csv

puente | red | x_origen_mm | y_origen_mm | x_destino_mm | y_destino_mm | color | montaje
JP1 | Net-(D3-K) | 16.76 | 25.74 | 23.38 | 8.98 | #53788d | taladro propio, cara superior
JP10 | /MED_HP | 101.14 | 88.0 | 102.98 | 76.26 | #258656 | taladro propio, cara superior
JP11 | Net-(U2D-+) | 104.41 | 106.48 | 111.72 | 87.82 | #53788d | taladro propio, cara inferior
JP12 | /IN_R | 105.4 | 57.1 | 109.57 | 53.63 | #53788d | taladro propio, cara superior
JP13 | /AGUDOS | 130.509999 | 66.45 | 136.29 | 22.99 | #258eaf | taladro propio, cara inferior
JP14 | /LED_DIN | 138.19 | 42.42 | 193.56 | 35.23 | #53788d | taladro propio, cara inferior
JP15 | /LINEA | 139.26 | 87.24 | 155.96 | 39.81 | #53788d | taladro propio, cara inferior
JP16 | Net-(R4-Pad2) | 141.58 | 33.82 | 148.98 | 7.67 | #53788d | taladro propio, cara inferior
JP17 | /A_W | 142.27 | 91.05 | 168.44 | 36.62 | #258eaf | taladro propio, cara inferior
JP18 | /TFT_SCK | 142.85 | 44.41 | 153.63 | 44.16 | #53788d | taladro propio, cara superior
JP19 | /TFT_SCK | 166.52 | 50.8 | 178.46 | 84.74 | #53788d | taladro propio, cara inferior
JP2 | GND | 21.95 | 80.69 | 40.05 | 85.45 | #292929 | taladro propio, cara superior
JP20 | +5V | 112.202 | 50.338 | 53.079 | 56.884 | #d54937 | taladro propio, cara inferior
JP21 | +5V | 116.55 | 20.63 | 129.889 | 21.402 | #d54937 | taladro propio, cara superior
JP22 | GND | 45.39 | 56.15 | 50.24 | 86.357 | #292929 | taladro propio, cara inferior
JP23 | GND | 139.2 | 27.478 | 152.03 | 15.55 | #292929 | taladro propio, cara superior
JP24 | GND | 152.48 | 93.792 | 144.711 | 89.026 | #292929 | taladro propio, cara superior
JP25 | GND | 175.548 | 65.385 | 177.601 | 54.607 | #292929 | taladro propio, cara superior
JP26 | Net-(U1C-+) | 40.12 | 90.48 | 24.113 | 75.01 | #53788d | taladro propio, cara inferior
JP27 | Net-(U1C-+) | 46.725 | 99.435 | 40.12 | 95.48 | #53788d | taladro propio, cara superior
JP28 | /VREF | 30.11 | 14.28 | 30.11 | 19.36 | #8758a4 | taladro propio, cara superior
JP29 | /VREF | 40.227 | 74.795 | 40.153 | 33.173 | #8758a4 | taladro propio, cara inferior
JP3 | Net-(C9-Pad1) | 23.63 | 103.24 | 23.63 | 106.36 | #53788d | taladro propio, cara superior
JP30 | /VREF | 53.323 | 88.17 | 46.7 | 77.78 | #8758a4 | taladro propio, cara superior
JP31 | /VREF | 154.591 | 27.293 | 154.65 | 67.62 | #8758a4 | taladro propio, cara inferior
JP32 | /M_INV | 127.722 | 87.722 | 68.748 | 8.702 | #258656 | taladro propio, cara inferior
JP33 | /AGUDOS | 118.093 | 72.47 | 109.415 | 93.25 | #258eaf | taladro propio, cara inferior
JP34 | +3.3VA | 41.893 | 51.34 | 50.47 | 41.14 | #d28822 | taladro propio, cara superior
JP35 | +3.3VA | 58.32 | 47.613 | 52.591 | 43.261 | #d28822 | taladro propio, cara superior
JP36 | +3.3VA | 64.208 | 55.042 | 62.94 | 49.527 | #d28822 | taladro propio, cara superior
JP37 | +3.3VA | 104.62 | 87.94 | 68.594 | 55.616 | #d28822 | taladro propio, cara inferior
JP38 | /AMP_IN | 147.03 | 38.41 | 186.17 | 70.16 | #258eaf | taladro propio, cara inferior
JP39 | /MED_HP | 56.82 | 80.78 | 46.43 | 81.903 | #258656 | taladro propio, cara superior
JP4 | /M_INV | 24.26 | 19.7 | 48.26 | 7.53 | #258656 | taladro propio, cara inferior
JP40 | /A_W | 23.99 | 14.28 | 138.563 | 91.75 | #258eaf | taladro propio, cara inferior
JP41 | Net-(U2B-+) | 103.641 | 93.714 | 114.927 | 71.2 | #53788d | taladro propio, cara inferior
JP42 | Net-(U1B-+) | 40.474 | 98.872 | 34.0 | 90.48 | #53788d | taladro propio, cara superior
JP43 | /PRE | 33.101 | 79.363 | 43.477 | 74.237 | #53788d | taladro propio, cara superior
JP44 | /PRE | 34.19 | 96.517 | 32.558999 | 82.088 | #53788d | taladro propio, cara superior
JP45 | /GRAVES | 43.163 | 93.25 | 21.03 | 74.927 | #e48c32 | taladro propio, cara inferior
JP46 | /GRAVES | 46.43 | 93.333 | 169.39 | 10.47 | #e48c32 | taladro propio, cara inferior
JP47 | /LED_5V | 120.63 | 42.22 | 114.05 | 18.09 | #53788d | taladro propio, cara inferior
JP48 | /ADC_A | 19.99 | 25.4 | 21.758 | 22.672 | #258eaf | taladro propio, cara superior
JP49 | /ADC_A | 23.289 | 26.368 | 145.15 | 77.78 | #258eaf | taladro propio, cara inferior
JP5 | /ADC_G | 38.96 | 70.94 | 48.09 | 48.85 | #e48c32 | taladro propio, cara inferior
JP50 | Net-(U4C--) | 66.022999 | 15.78 | 62.398 | 12.238 | #53788d | taladro propio, cara superior
JP51 | Net-(C20-Pad1) | 115.011 | 103.929 | 118.093 | 105.95 | #53788d | taladro propio, cara superior
JP52 | Net-(D2-K) | 40.808 | 16.322 | 37.69 | 16.82 | #53788d | taladro propio, cara superior
JP53 | Net-(D2-K) | 46.162 | 14.778 | 43.118 | 15.365 | #53788d | taladro propio, cara superior
JP54 | +3V3 | 77.51 | 12.033 | 75.708 | 57.571 | #d28822 | taladro propio, cara inferior
JP55 | /TFT_CS | 185.05 | 85.4 | 107.54 | 19.36 | #53788d | taladro propio, cara inferior
JP56 | /TFT_DC | 178.353 | 71.014 | 108.317 | 24.375 | #53788d | taladro propio, cara inferior
JP57 | /TFT_BL | 99.768 | 28.128 | 39.5 | 56.19 | #53788d | taladro propio, cara inferior
JP58 | /TFT_BL | 186.55 | 80.32 | 107.683 | 28.124 | #53788d | taladro propio, cara inferior
JP59 | /G_W | 164.39 | 13.01 | 127.9 | 91.75 | #e48c32 | taladro propio, cara inferior
JP6 | Net-(C10-Pad1) | 46.8 | 71.43 | 50.68 | 83.25 | #53788d | taladro propio, cara superior
JP60 | /ADC_M | 135.15 | 75.24 | 58.55 | 20.63 | #258656 | taladro propio, cara inferior
JP61 | /LED_DATA | 112.05 | 15.55 | 121.82 | 53.963 | #53788d | taladro propio, cara inferior
JP62 | /BTN | 176.29 | 38.642 | 154.65 | 87.94 | #53788d | taladro propio, cara inferior
JP63 | +5V | 115.738 | 46.802 | 115.593 | 22.94 | #d54937 | taladro propio, cara inferior
JP64 | Net-(D2-K) | 58.05 | 30.79 | 51.841 | 18.214 | #53788d | taladro propio, cara superior
JP65 | /G_W | 44.15 | 24.938 | 124.882 | 89.982 | #e48c32 | taladro propio, cara inferior
JP66 | GND | 46.173 | 53.248 | 44.979 | 50.338 | #292929 | taladro propio, cara superior
JP67 | GND | 27.61 | 16.82 | 55.55 | 25.71 | #292929 | terminal existente, cara inferior
JP68 | Net-(U1D-+) | 44.12 | 85.399999 | 54.28 | 98.1 | #53788d | terminal existente, cara inferior
JP69 | Net-(U1D-+) | 54.28 | 68.89 | 44.12 | 85.399999 | #53788d | terminal existente, cara inferior
JP7 | Net-(D2-A) | 58.14 | 39.05 | 59.94 | 14.6 | #53788d | taladro propio, cara inferior
JP70 | +3.3VA | 30.15 | 91.75 | 36.5 | 87.94 | #d28822 | terminal existente, cara inferior
JP71 | +3.3VA | 36.5 | 87.94 | 47.93 | 90.48 | #d28822 | terminal existente, cara inferior
JP72 | +3.3VA | 42.85 | 53.65 | 36.5 | 87.94 | #d28822 | terminal existente, cara inferior
JP73 | +3.3VA | 50.47 | 37.14 | 47.93 | 25.71 | #d28822 | terminal existente, cara inferior
JP74 | +3.3VA | 119.05 | 90.48 | 107.62 | 87.94 | #d28822 | terminal existente, cara inferior
JP75 | Net-(U4C--) | 60.63 | 10.47 | 27.61 | 21.900001 | #53788d | terminal existente, cara inferior
JP76 | /LED_DATA | 157.15 | 82.860001 | 124.13 | 54.92 | #53788d | terminal existente, cara inferior
JP77 | /M_W | 60.63 | 18.09 | 55.55 | 28.25 | #258656 | terminal existente, cara inferior
JP78 | /TFT_MOSI | 182.550001 | 65.080001 | 102.54 | 14.28 | #53788d | terminal existente, cara inferior
JP79 | /TFT_RST | 182.550001 | 67.620001 | 102.54 | 24.44 | #53788d | terminal existente, cara inferior
JP8/1 | /MEDIOS | 91.73 | 78.91 | 91.73 | 84.12 | #258656 | taladro propio, cara inferior
JP8/2 | /MEDIOS | 91.73 | 78.91 | 143.64 | 19.25 | #258656 | taladro propio, cara inferior
JP9 | /TFT_SCK | 97.08 | 50.19 | 104.6 | 50.19 | #53788d | taladro propio, cara superior
