davixcky/ecualizador-esp32/img/pcb-una-cara-componentes.png

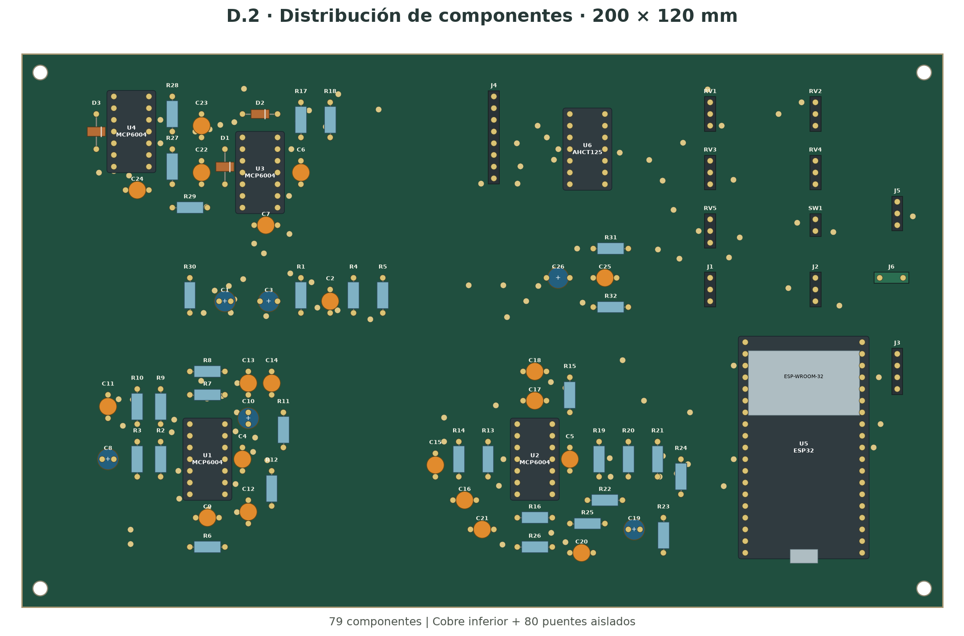
img/pcb-una-cara-componentes.png
