davixcky/ecualizador-esp32/cad/ecualizador-gabinete.step

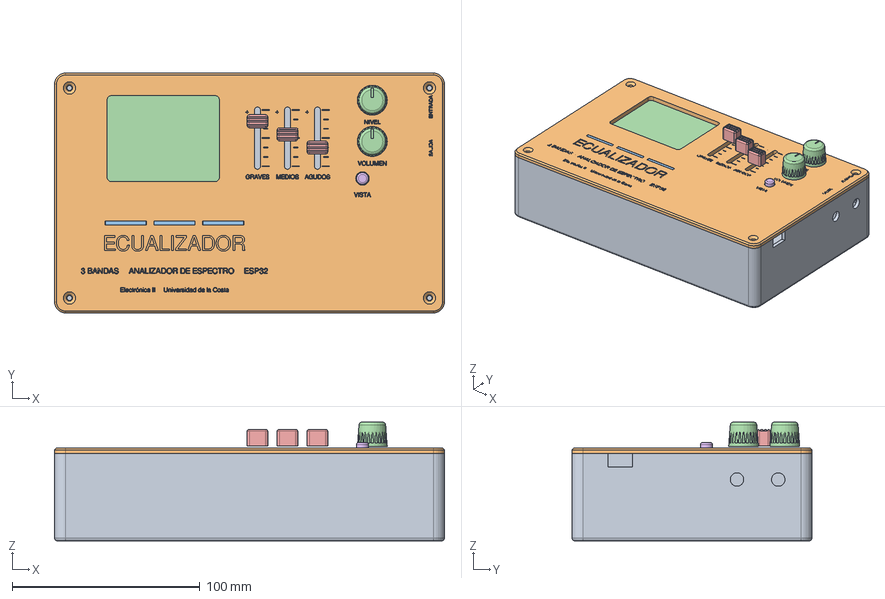
[picture p132: CAD file, 2026-10-22]
cad/ecualizador-gabinete.step
208.0 x 128.0 x 63.3 mm
cuerpo
tapa
franja0
franja1
franja2
perilla-nivel
perilla-volumen
deslizable0
deslizable1
deslizable2
boton
separadores
parlante
pam8403
pam8403-ci
tft-placa
tft-vidrio
