davixcky/ecualizador-esp32/cad/stl/parlante.stl

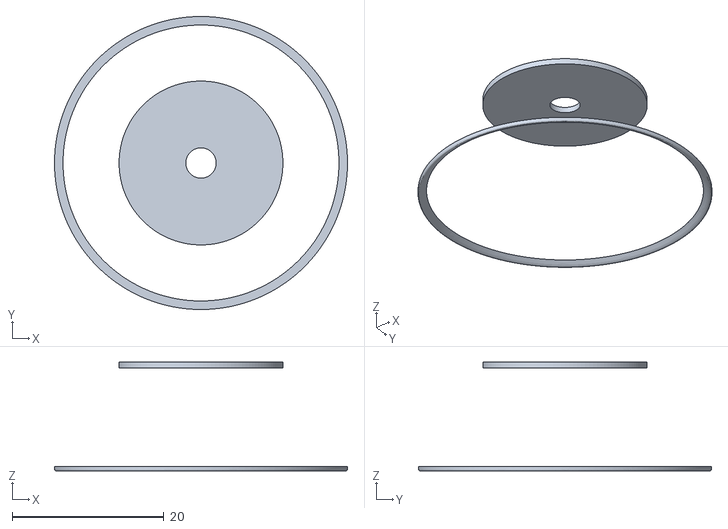
[picture p133: CAD file, 2026-10-22]
cad/stl/parlante.stl
38.6 x 38.6 x 14.4
