davixcky/ecualizador-esp32/hardware/3d/ecualizador-placa.step

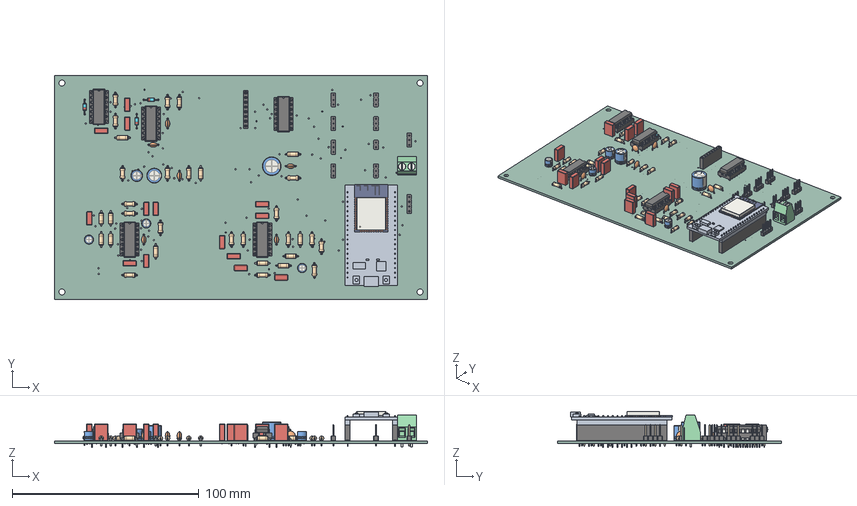
[picture p134: CAD file, 2026-10-22]
hardware/3d/ecualizador-placa.step
200.0 x 120.0 x 19.5 mm
PinHeader_1x03_P2.54mm_Vertical x 8
C_Rect_L7.2mm_W3.0mm_P5.00mm_FKS2_FKP2_MKS2_MKP2 x 14
R_Axial_DIN0207_L6.3mm_D2.5mm_P7.62mm_Horizontal x 32
TerminalBlock_Phoenix_MKDS-1,5-2-5.08_1x02_P5.08mm_Horizontal
PinHeader_1x04_P2.54mm_Vertical
C_Disc_D5.0mm_W2.5mm_P5.00mm x 6
PinSocket_1x19_P2.54mm_Vertical x 2
esp32-devkitc-v4
ESP32-WROOM-32
CP_Radial_D5.0mm_P2.00mm x 3
DIP-14_W7.62mm_Socket x 5
DIP-14_W7.62mm x 5
CP_Radial_D10.0mm_P5.00mm
D_DO-35_SOD27_P7.62mm_Horizontal x 3
CP_Radial_D8.0mm_P3.50mm
PinSocket_1x08_P2.54mm_Vertical
CP_Radial_D6.3mm_P2.50mm
PinHeader_1x02_P2.54mm_Vertical
ecualizador_PCB
