davixcky/ecualizador-esp32/cad/stl/iman-base3.stl

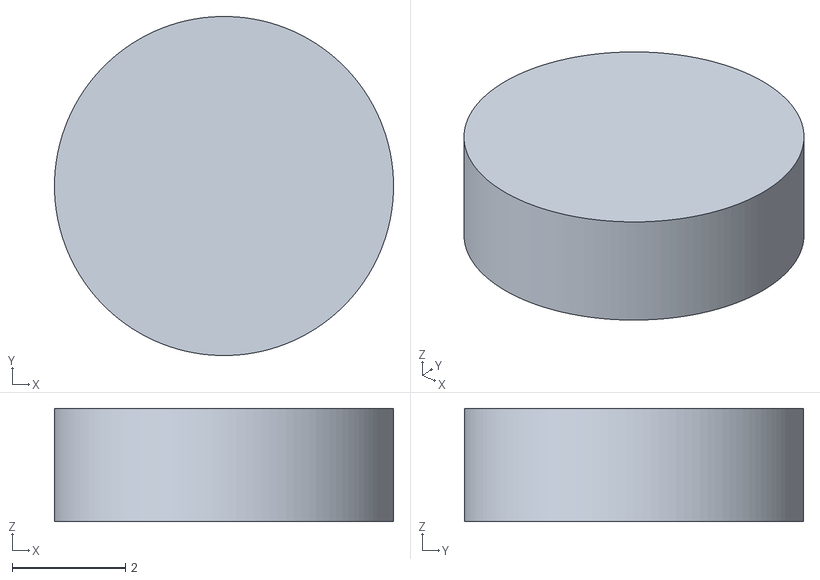
[picture p135: CAD file, 2026-10-22]
cad/stl/iman-base3.stl
6.00 x 6.00 x 2.00
