davixcky/ecualizador-esp32/cad/stl/deslizable2.stl

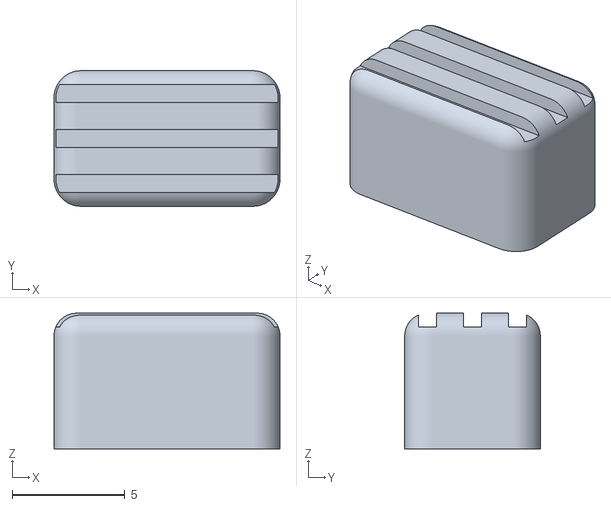
[picture p136: CAD file, 2026-10-22]
cad/stl/deslizable2.stl
10.0 x 6.00 x 6.00
