davixcky/ecualizador-esp32/cad/stl/difusor1.stl

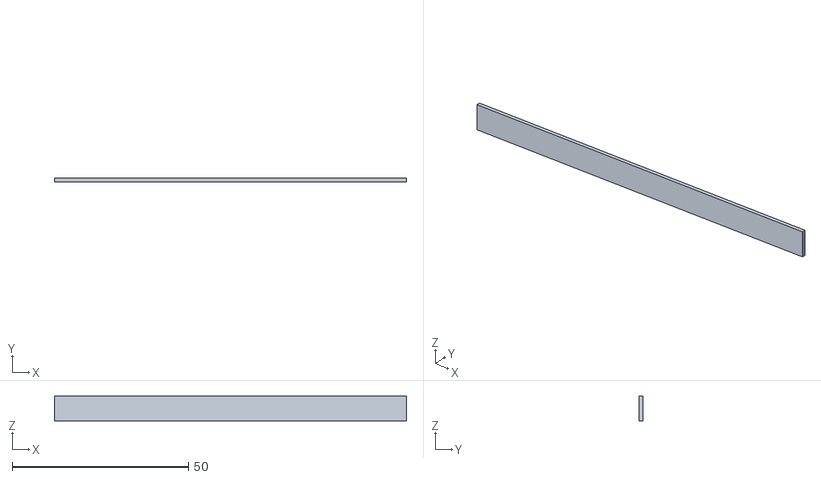
[picture p137: CAD file, 2026-10-22]
cad/stl/difusor1.stl
100.0 x 1.00 x 7.00
