davixcky/ecualizador-esp32/cad/stl/perilla-volumen.stl

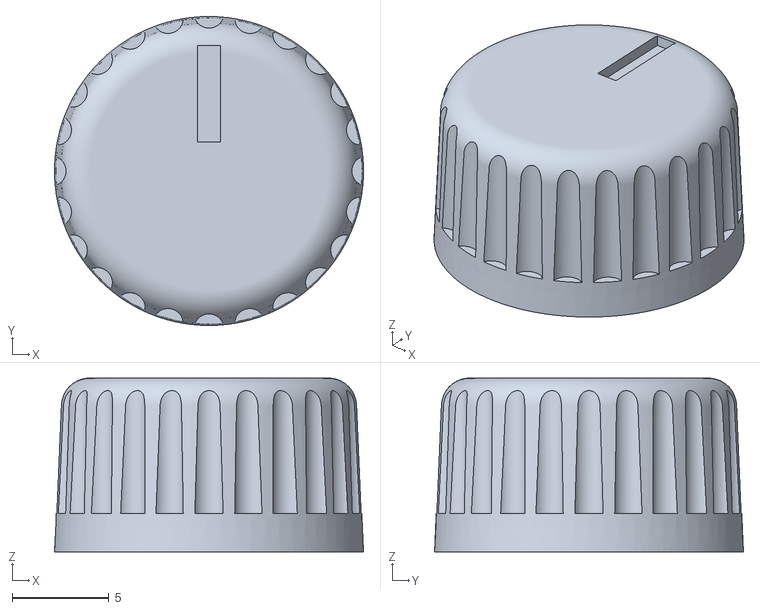
[picture p138: CAD file, 2026-10-22]
cad/stl/perilla-volumen.stl
16.0 x 16.0 x 9.00
