davixcky/ecualizador-esp32/cad/stl/tira1.stl

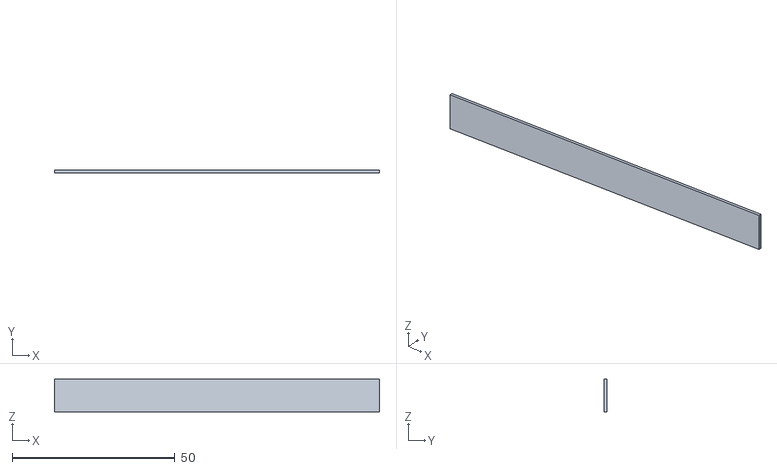
[picture p139: CAD file, 2026-10-22]
cad/stl/tira1.stl
100.0 x 0.8 x 10.0
