davixcky/ecualizador-esp32/cad/stl/led1.stl

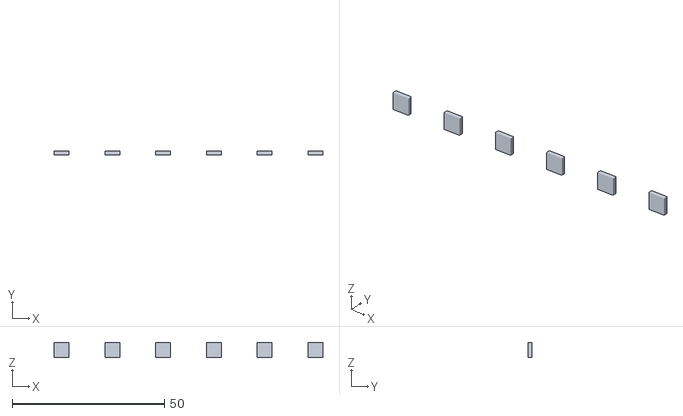
[picture p140: CAD file, 2026-10-22]
cad/stl/led1.stl
88.3 x 1.20 x 5.00
