davixcky/ecualizador-esp32/cad/stl/tapa.stl

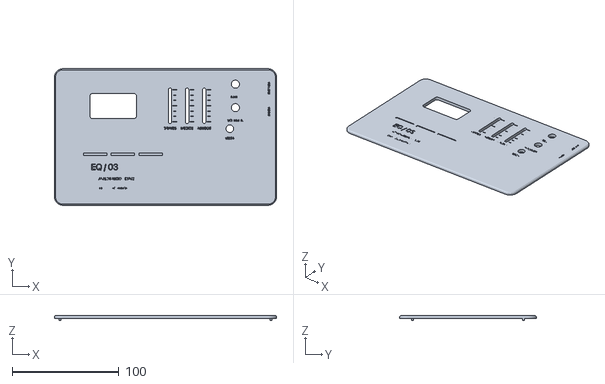
[picture p141: CAD file, 2026-10-22]
cad/stl/tapa.stl
208.0 x 128.0 x 5.00
