davixcky/ecualizador-esp32/cad/stl/cuerpo.stl

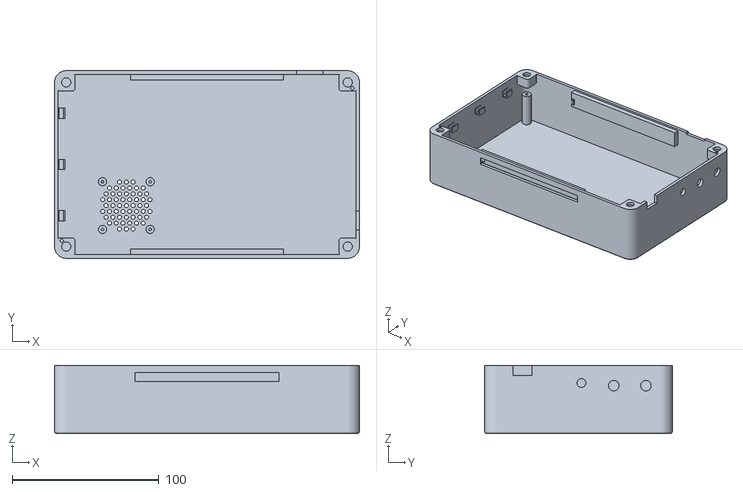
[picture p142: CAD file, 2026-10-22]
cad/stl/cuerpo.stl
208.0 x 128.0 x 46.5
