davixcky/ecualizador-esp32/cad/stl/rotulos.stl

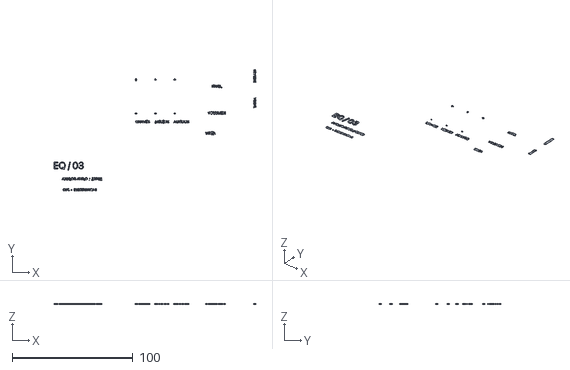
[picture p143: CAD file, 2026-10-22]
cad/stl/rotulos.stl
167.1 x 100.6 x 0.55
