davixcky/ecualizador-esp32/cad/stl/tft-placa.stl

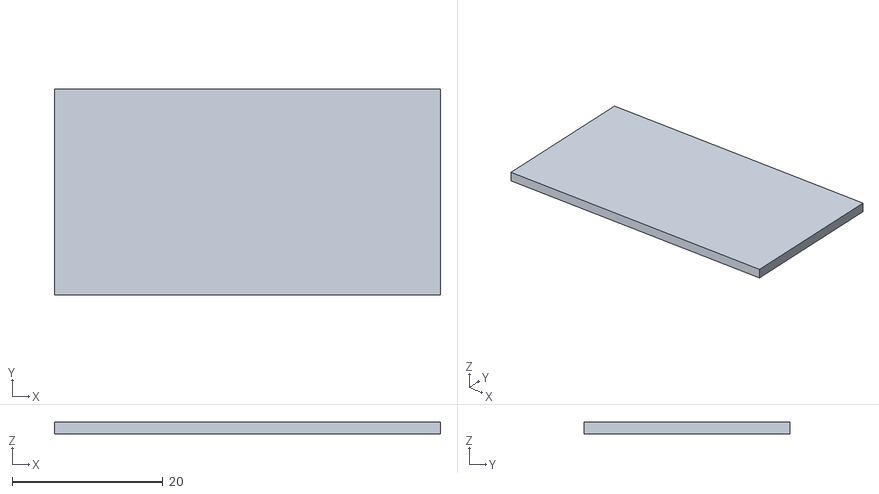
[picture p144: CAD file, 2026-10-22]
cad/stl/tft-placa.stl
51.2 x 27.3 x 1.60
