davixcky/ecualizador-esp32/cad/stl/pam8403.stl

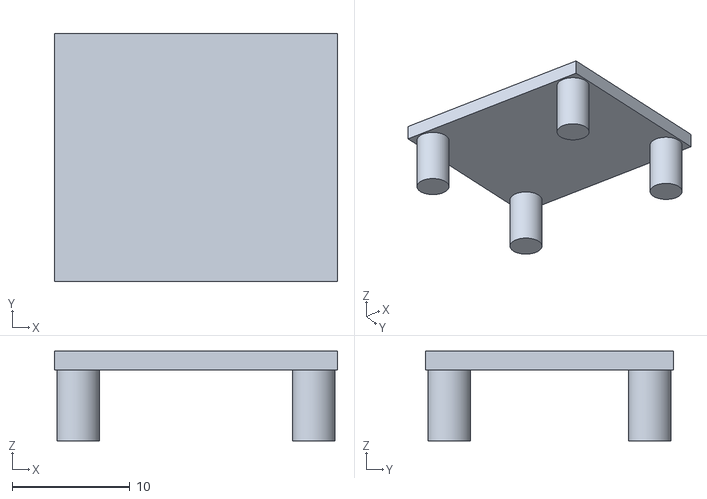
[picture p145: CAD file, 2026-10-22]
cad/stl/pam8403.stl
24.0 x 21.0 x 7.60
