davixcky/ecualizador-esp32/cad/stl/franja0.stl

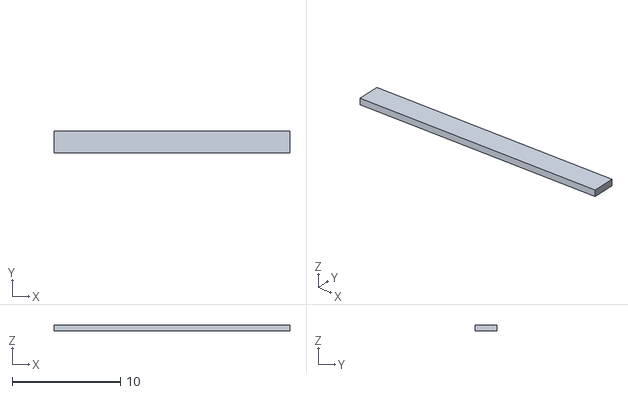
[picture p146: CAD file, 2026-10-22]
cad/stl/franja0.stl
21.8 x 2.00 x 0.55
