davixcky/ecualizador-esp32/cad/stl/tft-vidrio.stl

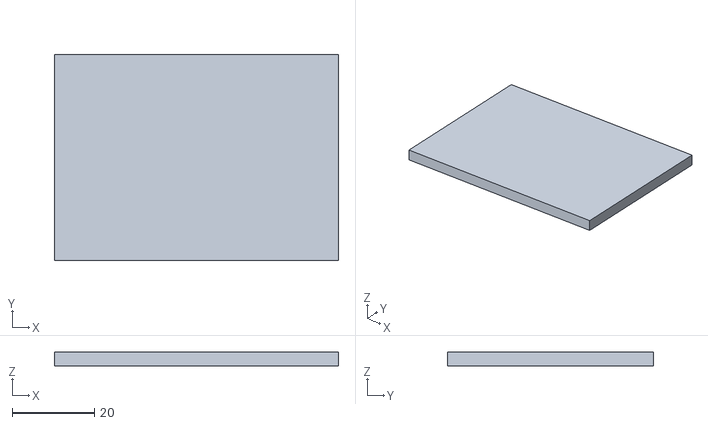
[picture p147: CAD file, 2026-10-22]
cad/stl/tft-vidrio.stl
69.0 x 50.0 x 3.40
