davixcky/ecualizador-esp32/(list of files, cad)

Other CAD files:
cad/stl/iman-tapa0.stl
cad/stl/iman-tapa3.stl
cad/stl/iman-base2.stl
cad/stl/perilla-nivel.stl
cad/stl/iman-base0.stl
cad/stl/deslizable0.stl
cad/stl/iman-base1.stl
cad/stl/deslizable1.stl
