davixcky/ecualizador-esp32/hardware/fabricacion/D2/LEEME-FABRICACION.txt

D.2 — PCB DE UNA CARA. 200 x 120 mm; FR4 de 1,6 mm.
Una sola capa de cobre, INFERIOR (B.Cu). No fabricar cobre superior.
Los cruces son 80 cables aislados instalados a mano, fuera de los Gerbers.
Los taladros de componentes y puentes se sueldan desde abajo; no requieren conexión metalizada entre capas.
Mascara inferior opcional. Sin serigrafia de fabricacion. Separacion minima 1 mm; pistas >=0,9 mm.
Consultar montaje/PUENTES.md y montaje/puentes.csv. JP67-JP79 se sueldan a terminales existentes por debajo; no abrir nuevos agujeros.
