davixcky/ecualizador-esp32/hardware/ecualizador.pdf

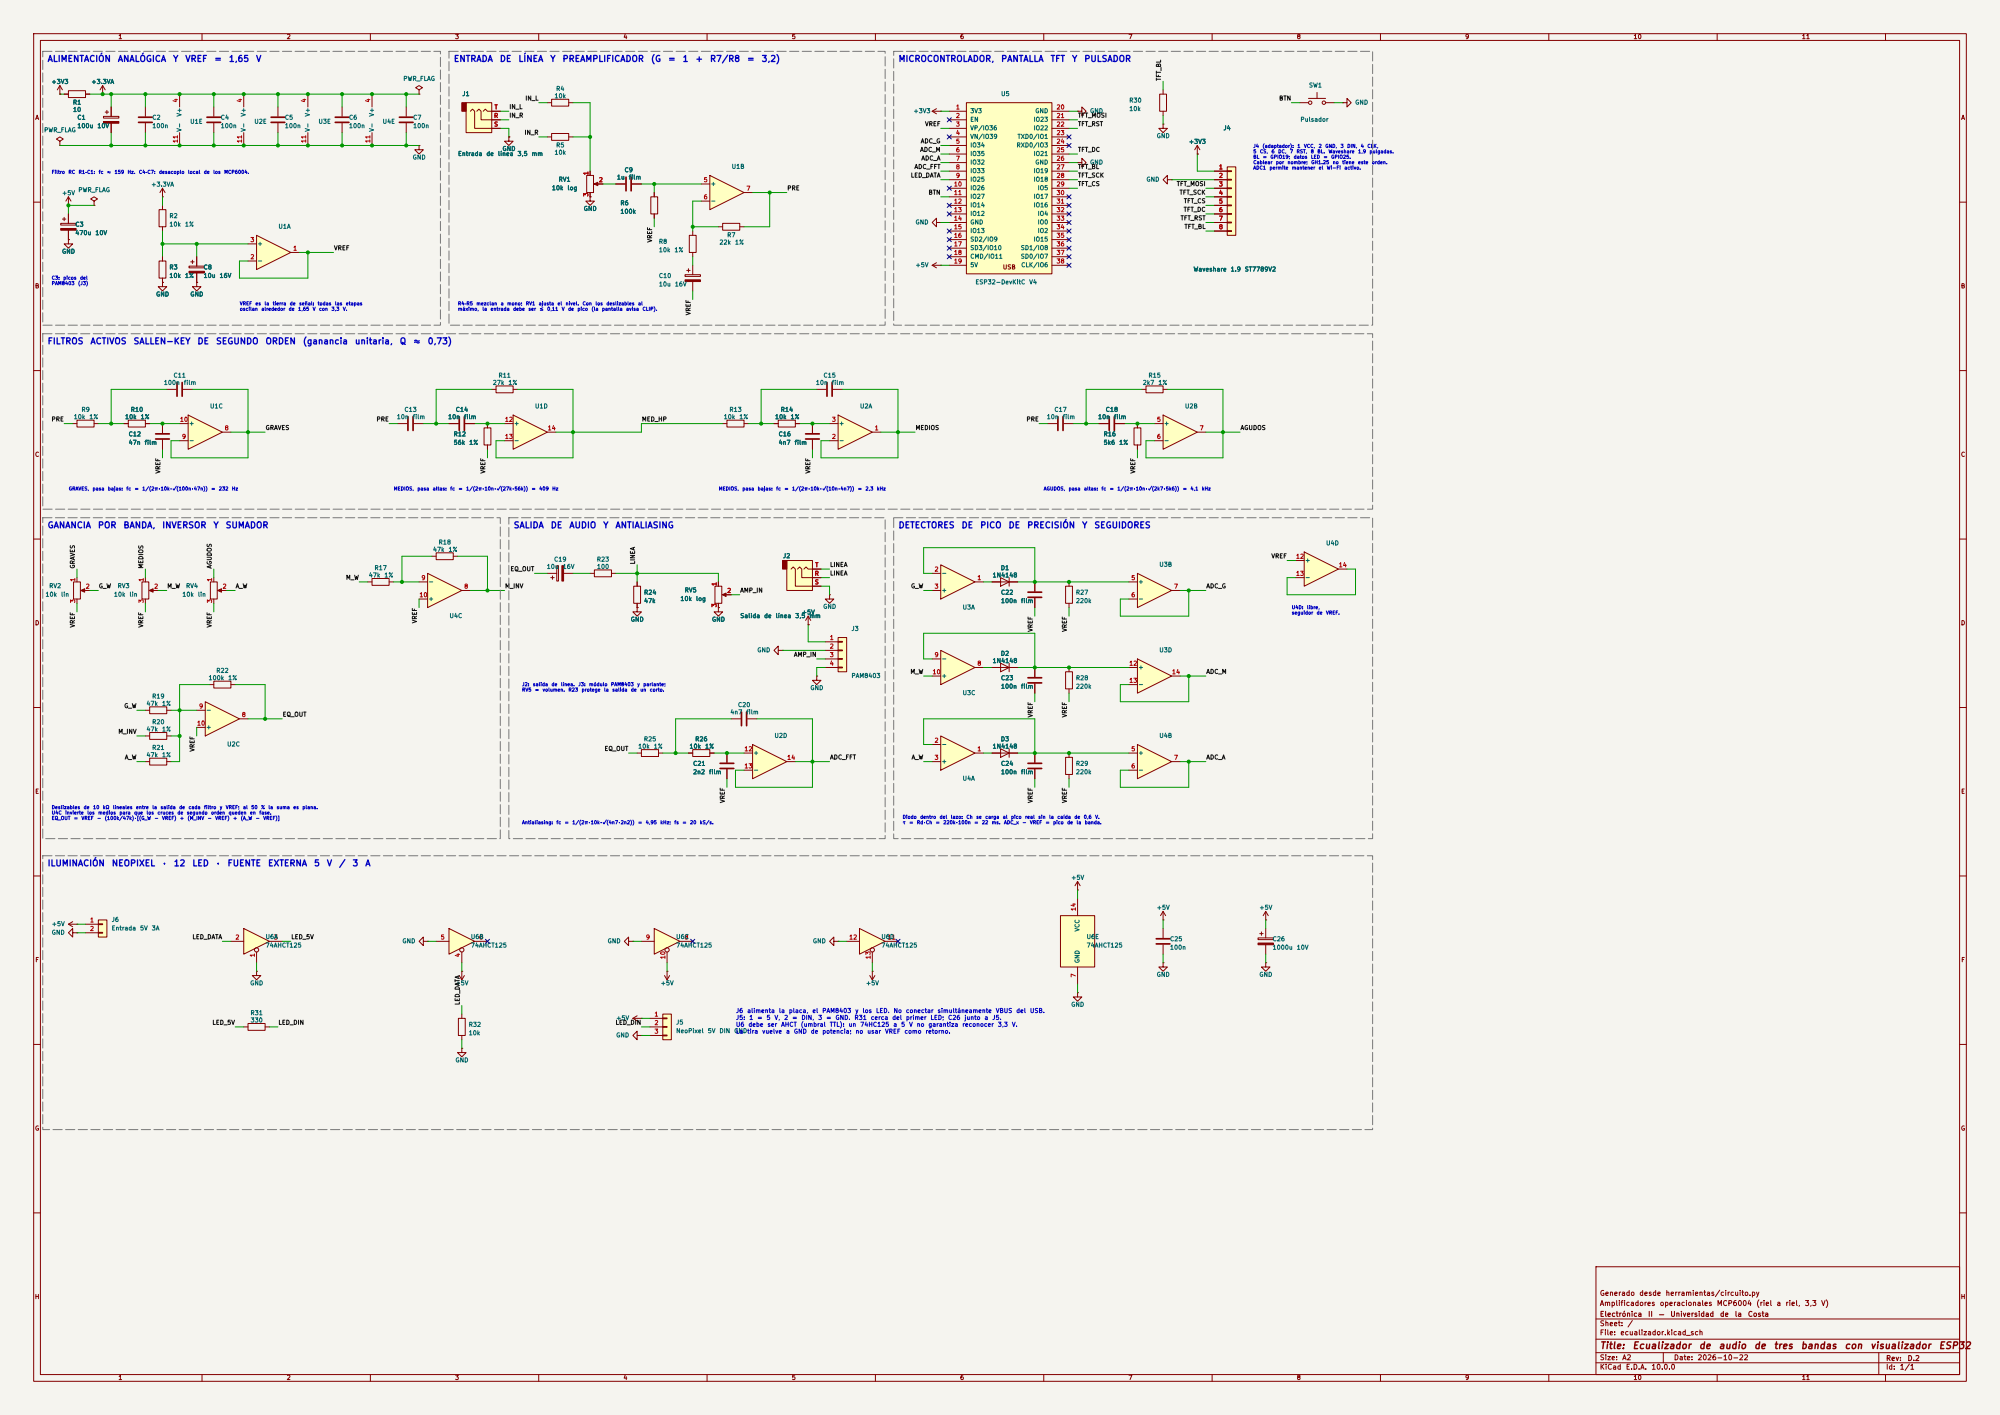
[picture p148: page 1]
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

Entrada de línea 3,5 mm

Filtro RC R1–C1: fc ≈ 159 Hz. C4–C7: desacoplo local de los MCP6004.

MEDIOS, pasa altas: fc = 1/(2π·10n·√(27k·56k)) = 409 Hz

AGUDOS, pasa altas: fc = 1/(2π·10n·√(2k7·5k6)) = 4,1 kHz

GANANCIA POR BANDA, INVERSOR Y SUMADOR

SALIDA DE AUDIO Y ANTIALIASING

ILUMINACIÓN NEOPIXEL · 12 LED · FUENTE EXTERNA 5 V / 3 A

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

Generado desde herramientas/circuito.py
Amplificadores operacionales MCP6004 (riel a riel, 3,3 V)
Electrónica II — Universidad de la Costa
Sheet: /
File: ecualizador.kicad_sch
Title: Ecualizador de audio de tres bandas con visualizador ESP32

Size: A2 | Rev: D.2
