davixcky/ecualizador-esp32/hardware/pcb-rev-D2.pdf

# D.2 · Distribución de componentes · 200 × 120 mm

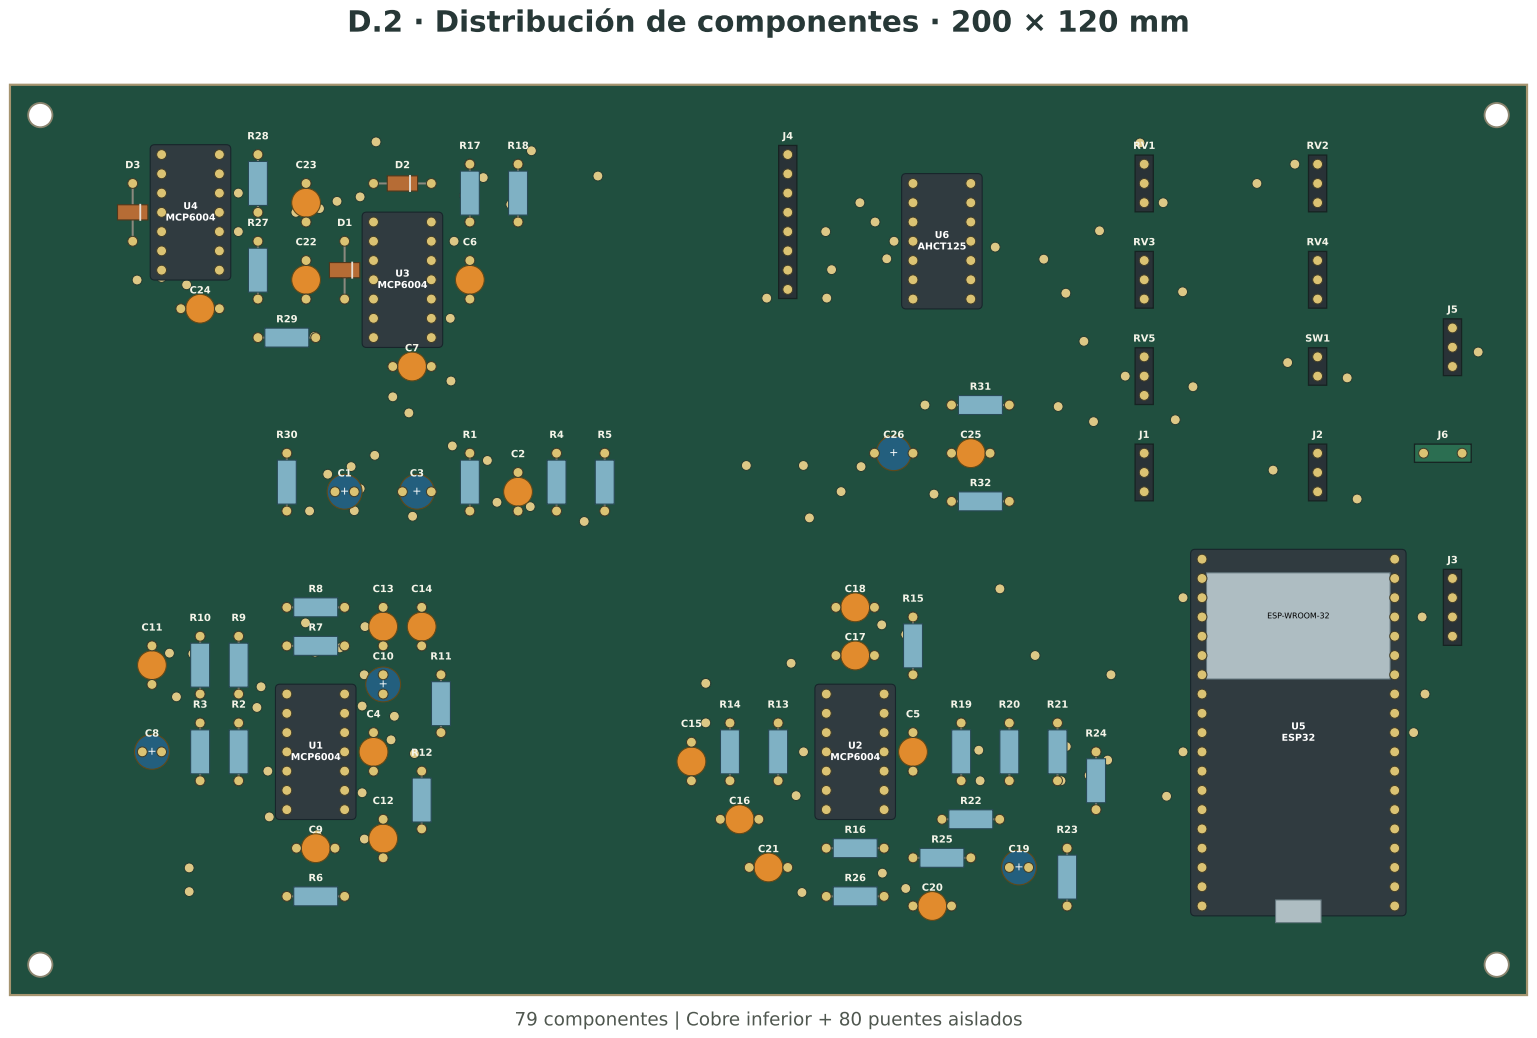
[picture p149: page 1]

79 componentes | Cobre inferior + 80 puentes aislados

# Puentes cortos · cara superior

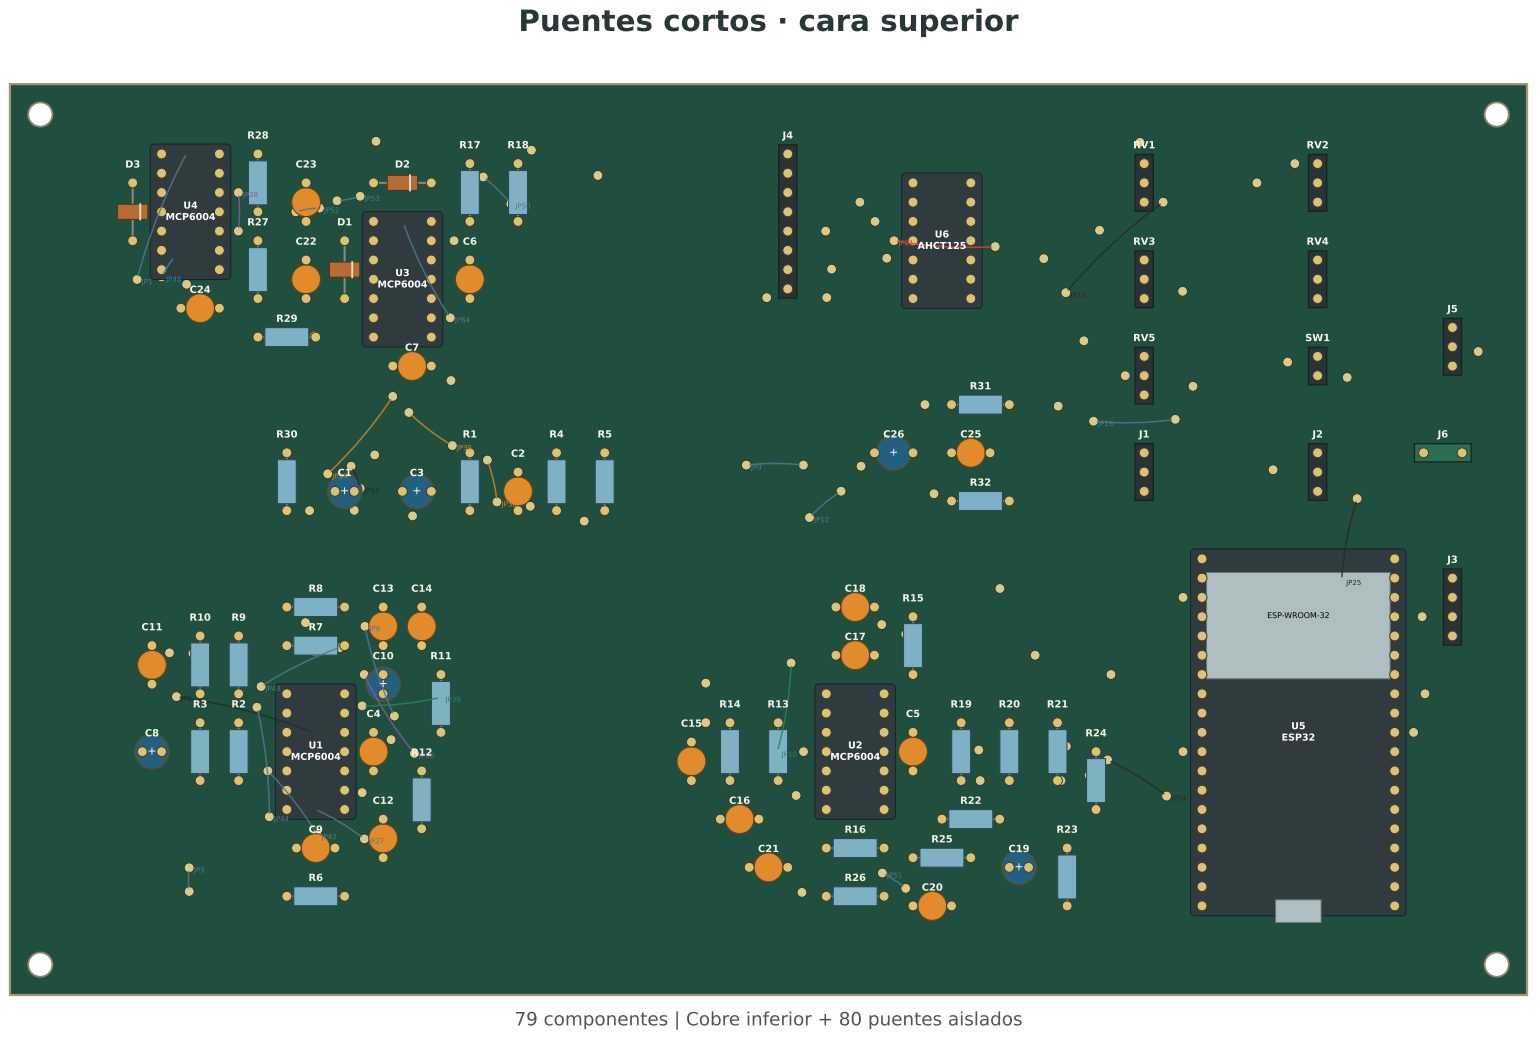
[picture p150: page 2]

# Cableado inferior aislado · vista desde abajo

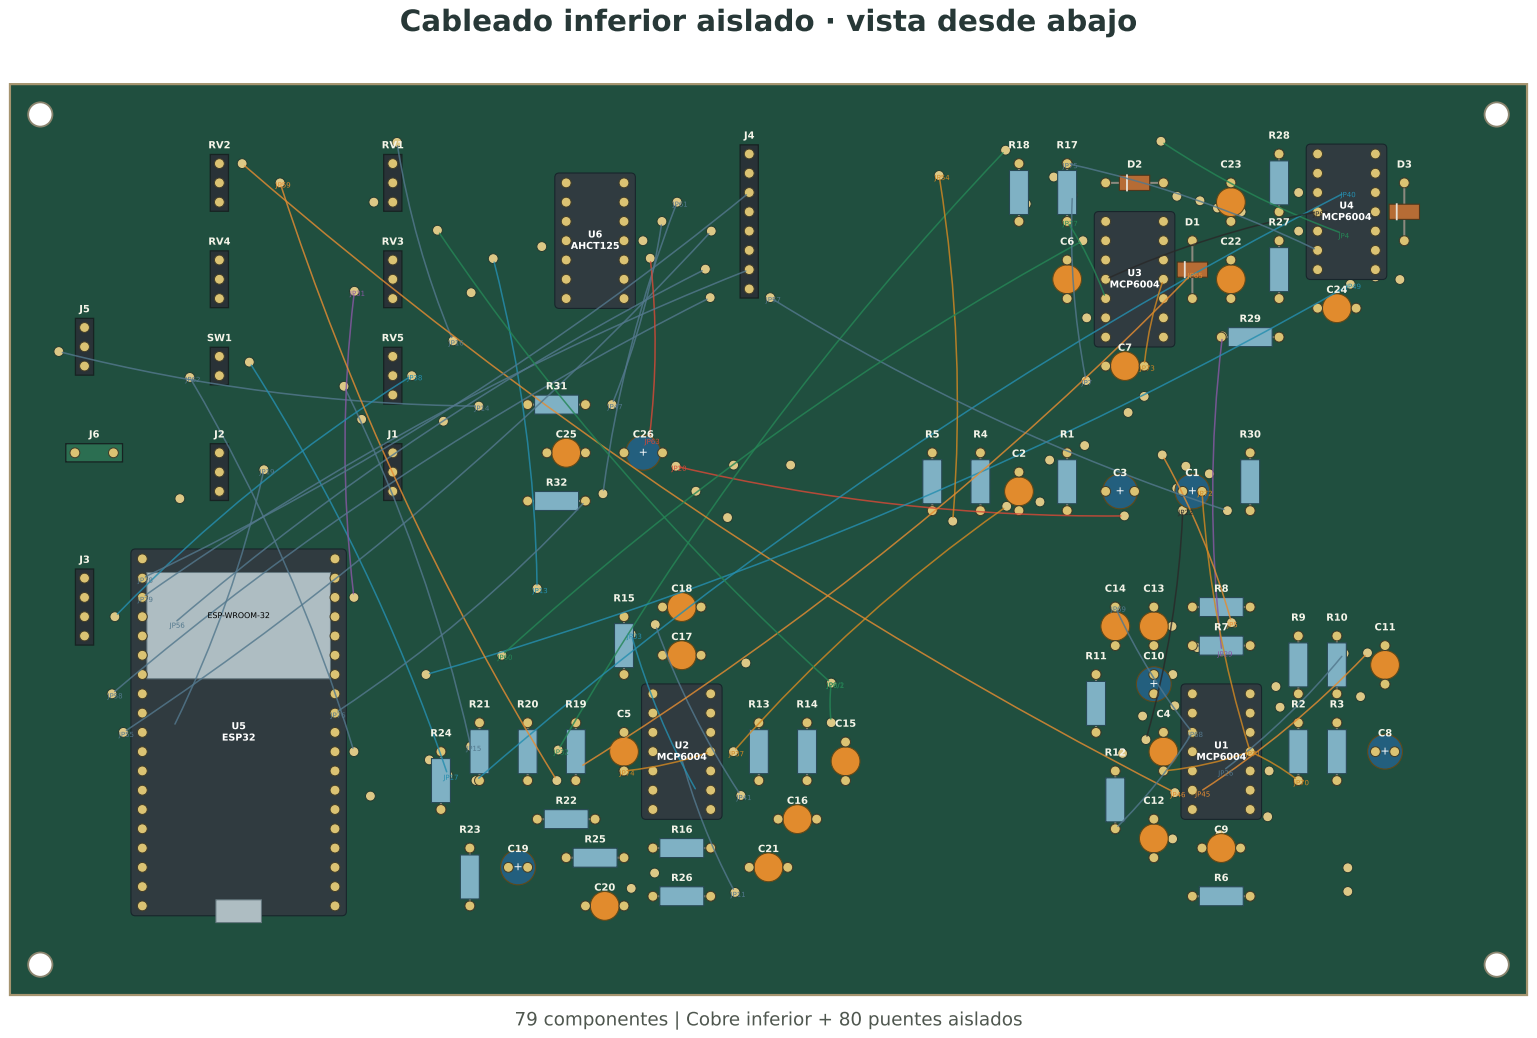
[picture p151: page 3]

# Cobre inferior · vista desde abajo

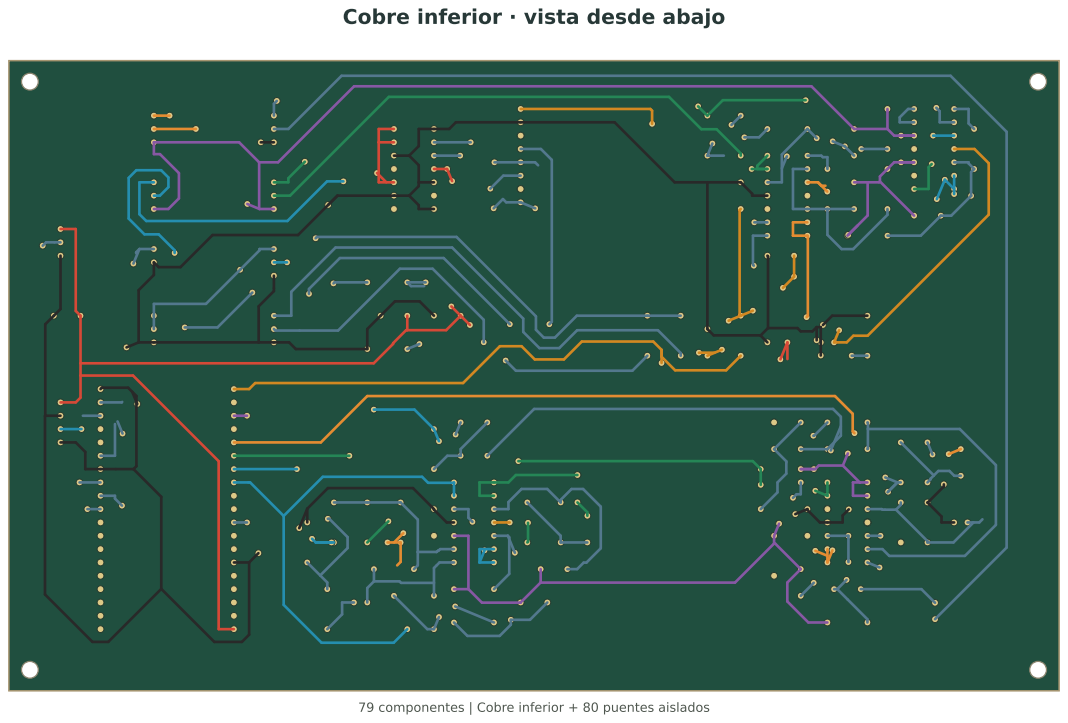
[picture p152: page 4]
