davixcky/ecualizador-esp32/img/diagrama-de-bloques.pdf

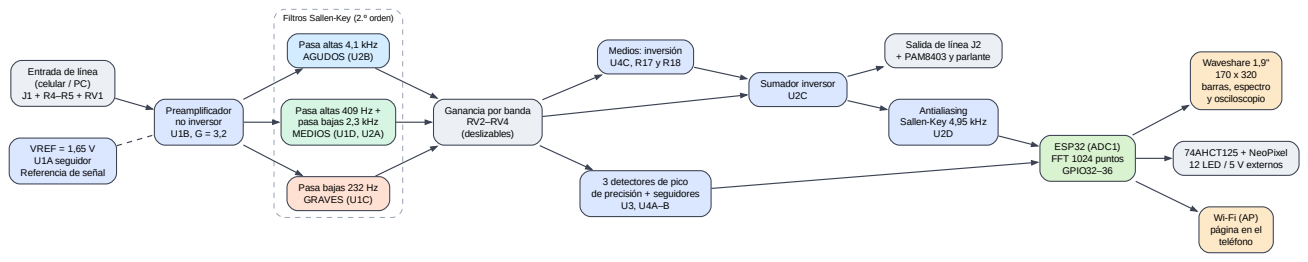
[picture p153: page 1]
Preamplificador no inversor U1B, G = 3,2; Ganancia por banda RV2–RV4 (deslizables); Medios: inversión U4C, R17 y R18; Sumador inversor U2C; ESP32 (ADC1) FFT 1024 puntos GPIO32–36; Waveshare 1,9" 170 x 320 barras, espectro y osciloscopio; 74AHCT125 + NeoPixel 12 LED / 5 V externos

Filtros Sallen-Key (2.º orden)

Pasa altas 4,1 kHz
AGUDOS (U2B)

Salida de línea J2
+ PAM8403 y parlante

Entrada de línea
(celular / PC)

Pasa altas 409 Hz +
pasa bajas 2,3 kHz
MEDIOS (U1D, U2A)

Antialiasing
Sallen-Key 4,95 kHz

VREF = 1,65 V
U1A seguidor
Referencia de señal

Pasa bajas 232 Hz
GRAVES (U1C)

3 detectores de pico
de precisión + seguidores

página en el
teléfono
