davixcky/ecualizador-esp32/img/circuitos/entrada.pdf

1N4148 V+

10k log +3.3VA | R5

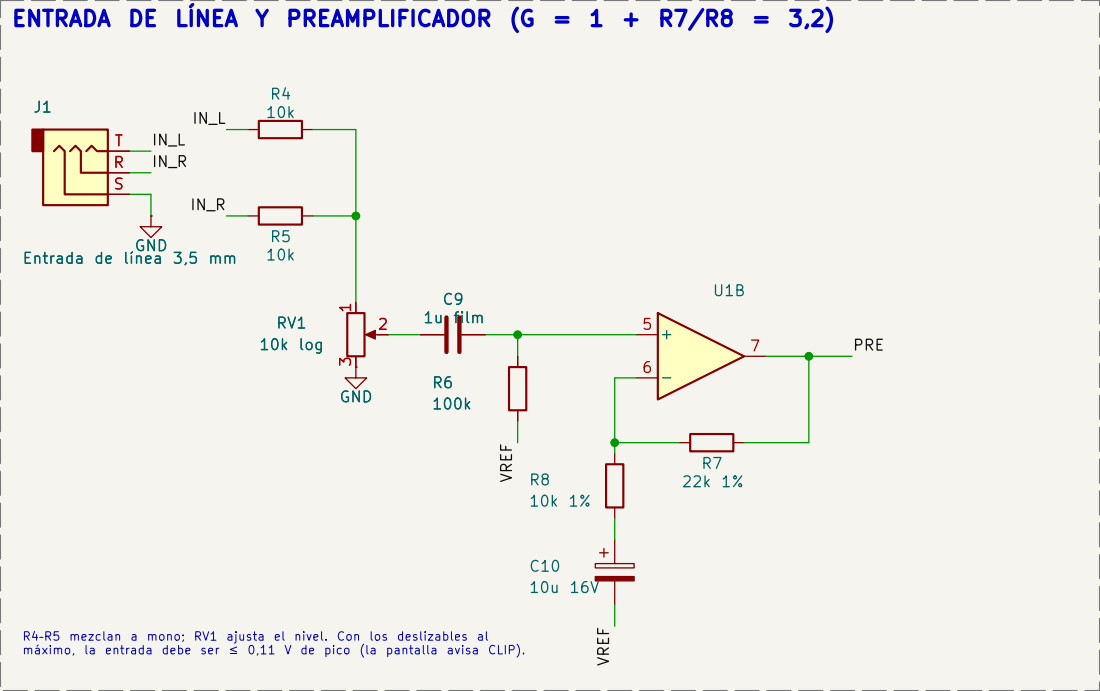
[picture p154: page 1]

Entrada de línea 3,5 mm
