davixcky/ecualizador-esp32/img/circuitos/pcb-capas.pdf

# D.2 · Distribución de componentes · 200 × 120 mm


79 componentes | Cobre inferior + 80 puentes aislados
