davixcky/ecualizador-esp32/hardware/una-cara/montaje-kicad.pdf

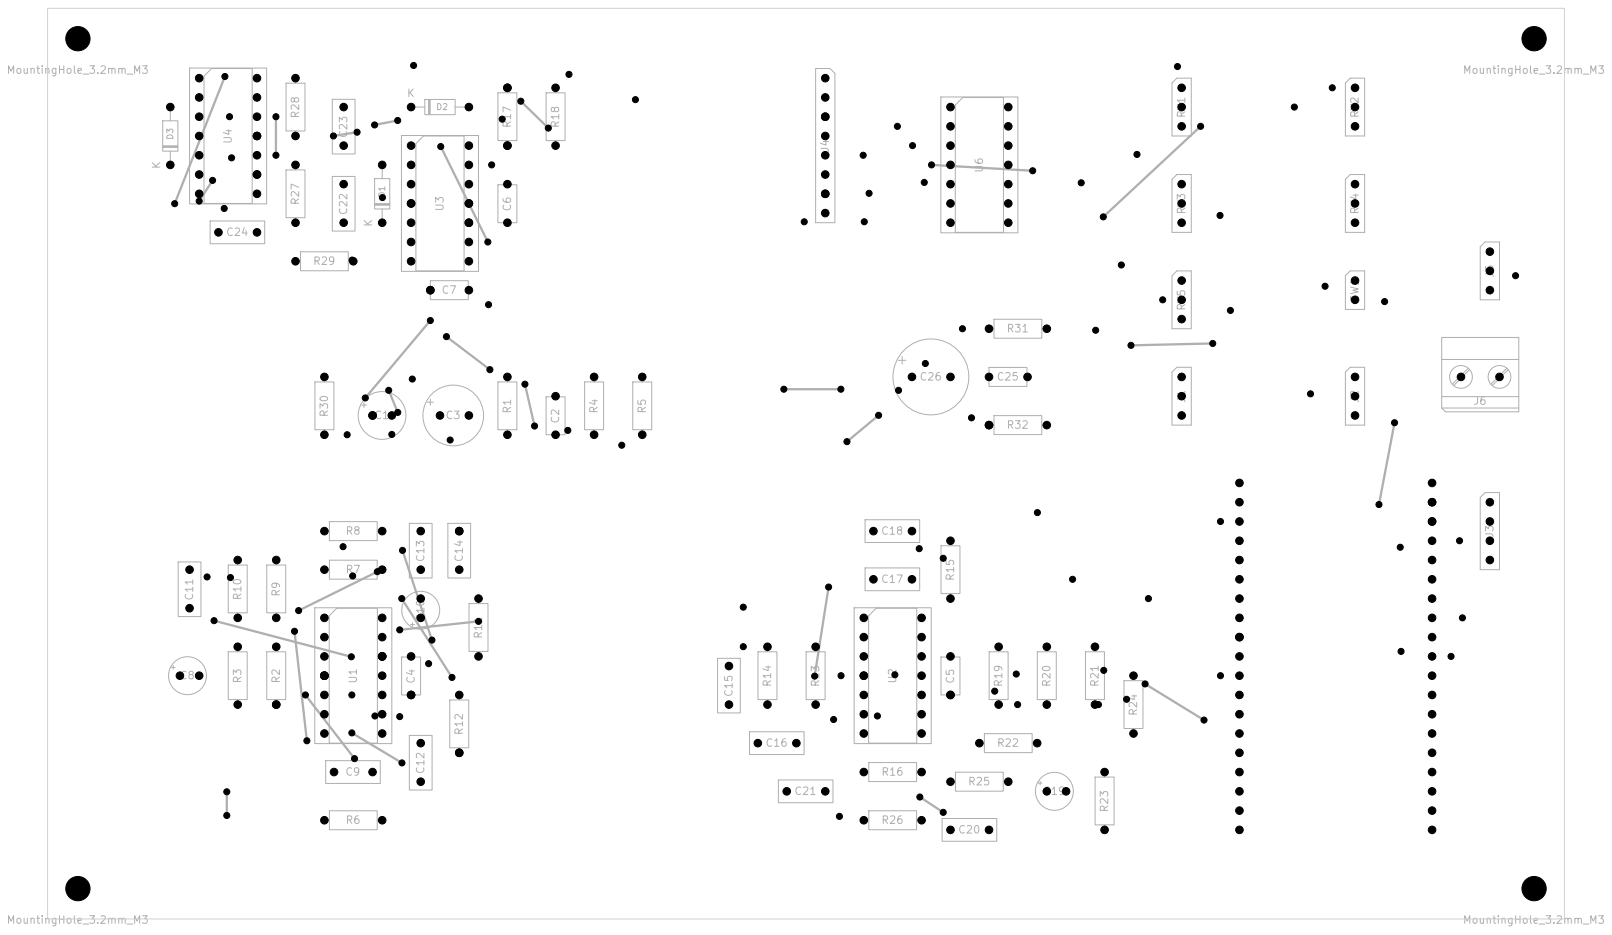
[picture p155: page 1]
