davixcky/ecualizador-esp32/hardware/una-cara/pcb-una-cara-puentes.pdf

# Puentes cortos · cara superior


79 componentes | Cobre inferior + 80 puentes aislados
