davixcky/ecualizador-esp32/hardware/archivo/B1/pcb-capas.pdf

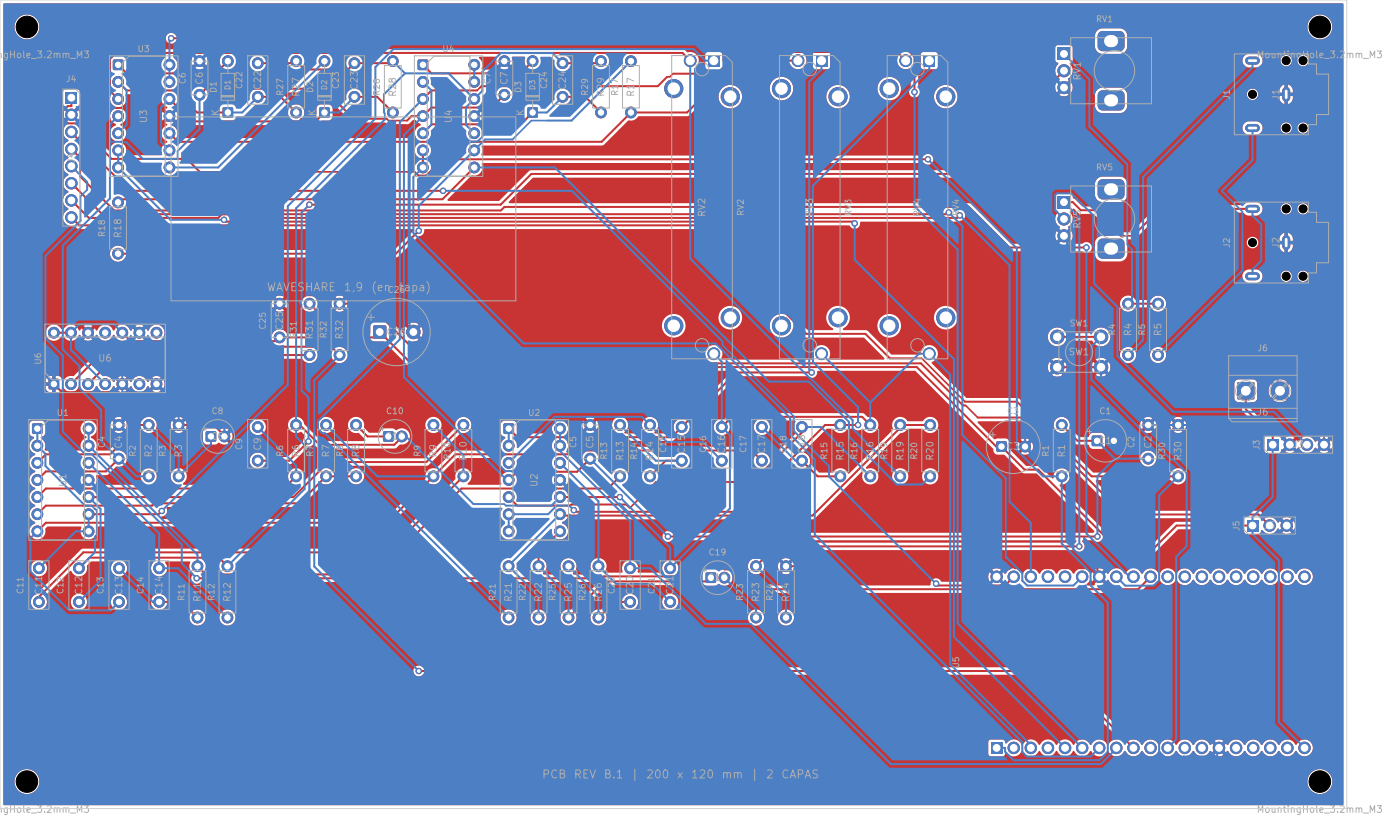
[picture p156: page 1]
