davixcky/ecualizador-esp32/img/circuitos/detectores.pdf

D1
1N4148 C22

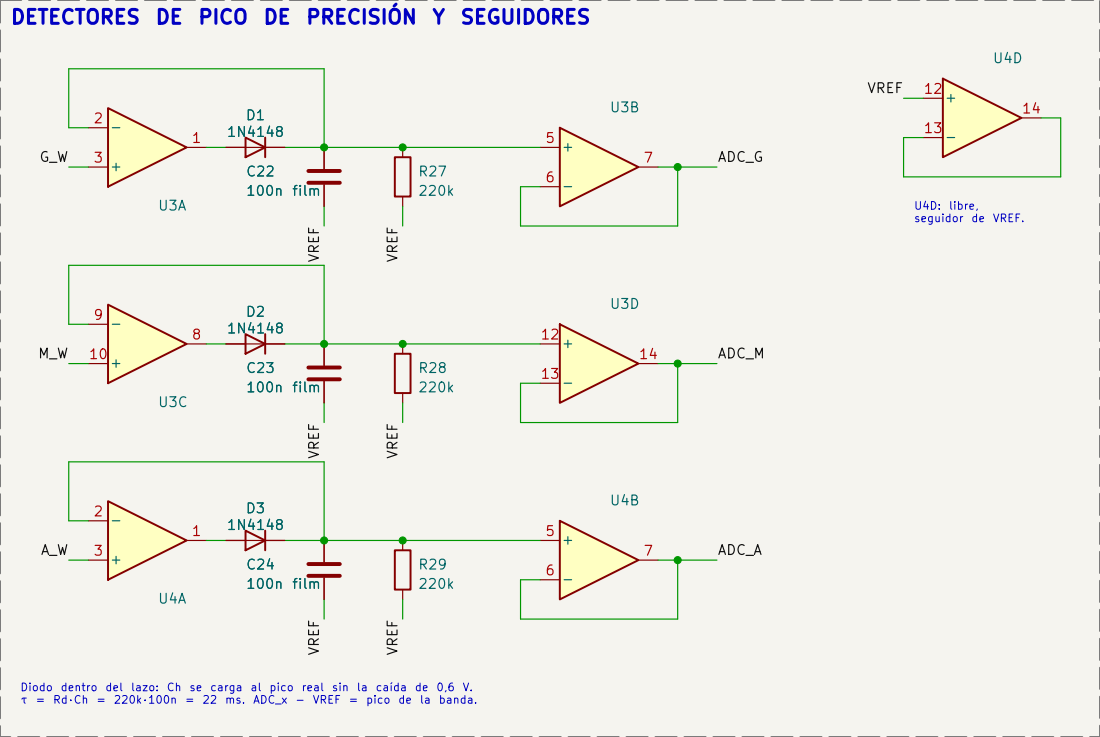
[picture p157: page 1]
