davixcky/ecualizador-esp32/img/circuitos/medios.pdf

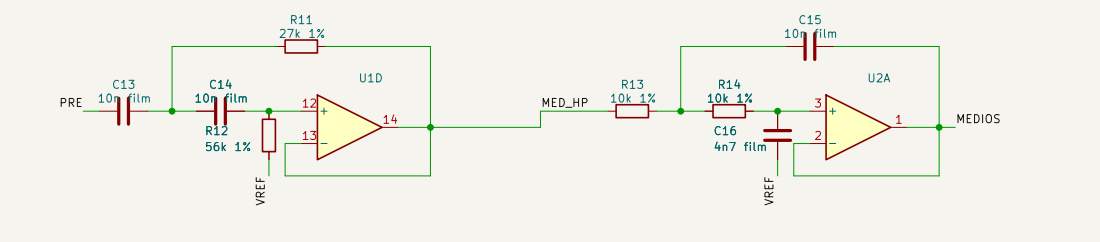
[picture p158: page 1]
