davixcky/ecualizador-esp32/img/circuitos/sumador.pdf

2

## 10k lin

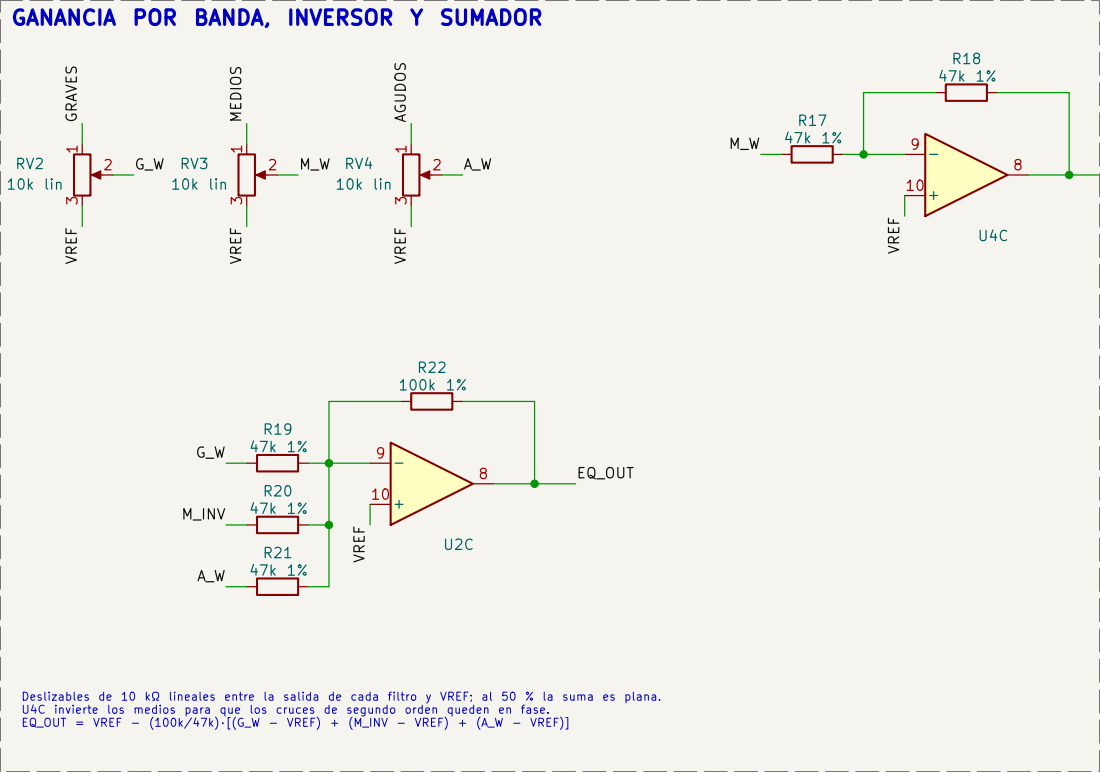
[picture p159: page 1]

GANANCIA POR BANDA, INVERSOR Y SUMADOR
