davixcky/ecualizador-esp32/img/marca/cuc-logo-vector.pdf

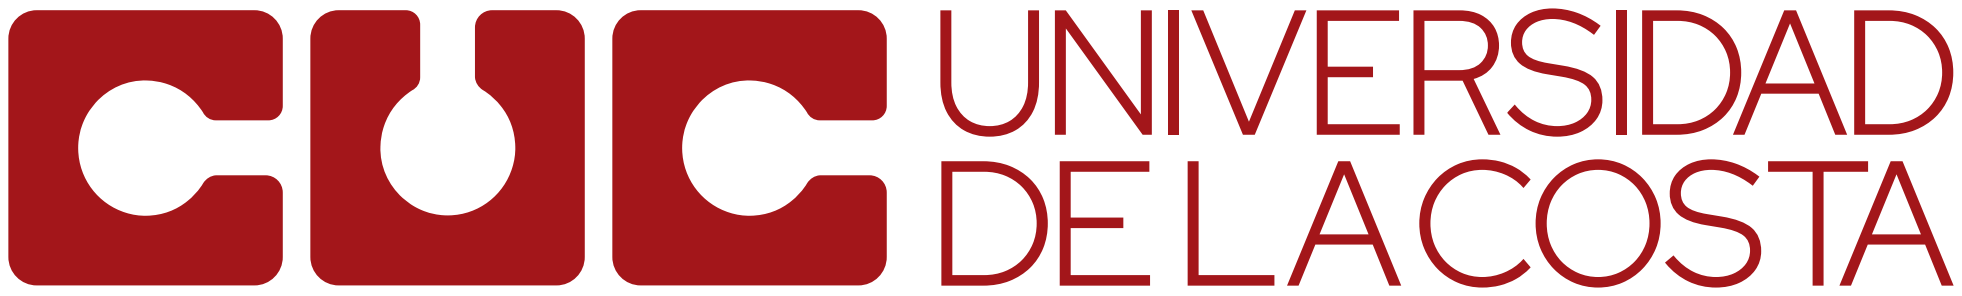
[picture p160: page 1]
