davixcky/ecualizador-esp32/hardware/ecualizador.kicad_pcb

## KiCad design hardware/ecualizador.kicad_pcb (2026-10-22)

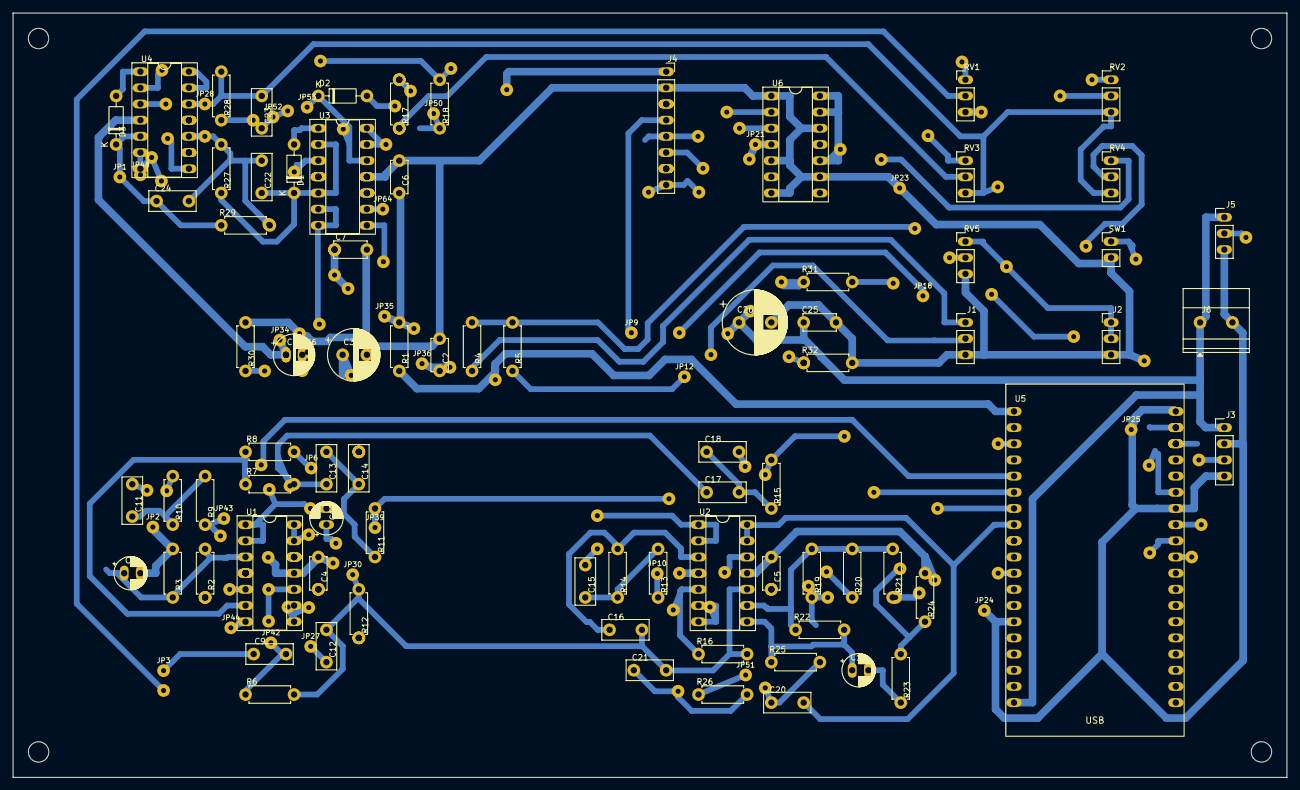
[picture p161: board ecualizador.kicad_pcb from above]

Board: 2 copper layers, 200.0 x 120.0 mm, 162 parts (0 on the bottom side), 59 nets.

Parts:
C1: 100u 10V; UnaCara_C1
C2: 100n; UnaCara_C2
C3: 470u 10V; UnaCara_C3
C4: 100n; UnaCara_C4
C5: 100n; UnaCara_C5
C6: 100n; UnaCara_C6
C7: 100n; UnaCara_C7
C8: 10u 16V; UnaCara_C8
C9: 1u film; UnaCara_C9
C10: 10u 16V; UnaCara_C10
C11: 100n film; UnaCara_C11
C12: 47n film; UnaCara_C12
C13: 10n film; UnaCara_C13
C14: 10n film; UnaCara_C14
C15: 10n film; UnaCara_C15
C16: 4n7 film; UnaCara_C16
C17: 10n film; UnaCara_C17
C18: 10n film; UnaCara_C18
C19: 10u 16V; UnaCara_C19
C20: 4n7 film; UnaCara_C20
C21: 2n2 film; UnaCara_C21
C22: 100n film; UnaCara_C22
C23: 100n film; UnaCara_C23
C24: 100n film; UnaCara_C24
C25: 100n; UnaCara_C25
C26: 1000u 10V; UnaCara_C26
D1: 1N4148; UnaCara_D1
D2: 1N4148; UnaCara_D2
D3: 1N4148; UnaCara_D3
H1, H2, H3, H4: MountingHole_3.2mm_M3
J1: Entrada de línea 3,5 mm; UnaCara_J1
J2: Salida de línea 3,5 mm; UnaCara_J2
J3: PAM8403; UnaCara_J3
J4: Waveshare 1.9 ST7789V2; UnaCara_J4
J5: NeoPixel 5V DIN GND; UnaCara_J5
J6: Entrada 5V 3A; UnaCara_J6
JP1, JP2, JP3, JP4, JP5, JP6, JP7, JP8, JP9, JP10, JP11, JP12, JP13, JP14, JP15, JP16, JP17, JP18, JP19, JP20, JP21, JP22, JP23, JP24, JP25, JP26, JP27, JP28, JP29, JP30, JP31, JP32, JP33, JP34, JP35, JP36, JP37, JP38, JP39, JP40, JP41, JP42, JP43, JP44, JP45, JP46, JP47, JP48, JP49, JP50, JP51, JP52, JP53, JP54, JP55, JP56, JP57, JP58, JP59, JP60, JP61, JP62, JP63, JP64, JP65, JP66: Puente aislado
JP67, JP68, JP69, JP70, JP71, JP72, JP73, JP74, JP75, JP76, JP77, JP78, JP79: Puente a terminal
R1: 10; UnaCara_R1
R2: 10k 1%; UnaCara_R2
R3: 10k 1%; UnaCara_R3
R4: 10k; UnaCara_R4
R5: 10k; UnaCara_R5
R6: 100k; UnaCara_R6
R7: 22k 1%; UnaCara_R7
R8: 10k 1%; UnaCara_R8
R9: 10k 1%; UnaCara_R9
R10: 10k 1%; UnaCara_R10
R11: 27k 1%; UnaCara_R11
R12: 56k 1%; UnaCara_R12
R13: 10k 1%; UnaCara_R13
R14: 10k 1%; UnaCara_R14
R15: 2k7 1%; UnaCara_R15
R16: 5k6 1%; UnaCara_R16
R17: 47k 1%; UnaCara_R17
R18: 47k 1%; UnaCara_R18
R19: 47k 1%; UnaCara_R19
R20: 47k 1%; UnaCara_R20
R21: 47k 1%; UnaCara_R21
R22: 100k 1%; UnaCara_R22
R23: 100; UnaCara_R23
R24: 47k; UnaCara_R24
R25: 10k 1%; UnaCara_R25
R26: 10k 1%; UnaCara_R26
R27: 220k; UnaCara_R27
R28: 220k; UnaCara_R28
R29: 220k; UnaCara_R29
R30: 10k; UnaCara_R30
R31: 330; UnaCara_R31
R32: 10k; UnaCara_R32
RV1: 10k log; UnaCara_RV1
RV2: 10k lin; UnaCara_RV2
RV3: 10k lin; UnaCara_RV3
RV4: 10k lin; UnaCara_RV4
RV5: 10k log; UnaCara_RV5
SW1: Pulsador; UnaCara_SW1
U1: MCP6004; UnaCara_U1
U2: MCP6004; UnaCara_U2
U3: MCP6004; UnaCara_U3
U4: MCP6004; UnaCara_U4
U5: ESP32-DevKitC V4; UnaCara_U5
U6: 74AHCT125; UnaCara_U6

Connections:
+3.3VA: C1.1, C2.1, C4.1, C5.1, C6.1, C7.1, JP34.1, JP35.1, JP36.1, JP37.1, JP70.1, JP71.1, JP72.1, JP73.1, JP74.1, R1.2, R2.1, U1.4, U2.4, U3.4, U4.4
+3V3: J4.1, JP54.1, R1.1, U5.1
+5V: C3.1, C25.1, C26.1, J3.1, J5.1, J6.1, JP20.1, JP21.1, JP63.1, U5.19, U6.4, U6.10, U6.13, U6.14
/ADC_A: JP48.1, JP49.1, U4.6, U4.7, U5.7
/ADC_FFT: C20.2, U2.13, U2.14, U5.8
/ADC_G: JP5.1, U3.6, U3.7, U5.5
/ADC_M: JP60.1, U3.13, U3.14, U5.6
/AGUDOS: JP13.1, JP33.1, R15.2, RV4.1, U2.6, U2.7
/AMP_IN: J3.3, JP38.1, RV5.2
/A_W: JP17.1, JP40.1, R21.1, RV4.2, U4.3
/BTN: JP62.1, SW1.1, U5.11
/EQ_OUT: C19.1, R22.2, R25.1, U2.8
/GRAVES: C11.2, JP45.1, JP46.1, RV2.1, U1.8, U1.9
/G_W: JP59.1, JP65.1, R19.1, RV2.2, U3.3
/IN_L: J1.T, R4.1
/IN_R: J1.R, JP12.1, R5.1
/LED_5V: JP47.1, R31.1, U6.3
/LED_DATA: JP61.1, JP76.1, R32.1, U5.9, U6.2
/LED_DIN: J5.2, JP14.1, R31.2
/LINEA: J2.R, J2.T, JP15.1, R23.2, R24.1, RV5.1
/MEDIOS: C15.2, JP8.1, RV3.1, U2.1, U2.2
/MED_HP: JP10.1, JP39.1, R11.2, R13.1, U1.13, U1.14
/M_INV: JP4.1, JP32.1, R18.2, R20.1, U4.8
/M_W: JP77.1, R17.1, RV3.2, U3.10
/PRE: C13.1, C17.1, JP43.1, JP44.1, R7.2, R9.1, U1.7
/TFT_BL: J4.8, JP57.1, JP58.1, R30.1, U5.27
/TFT_CS: J4.5, JP55.1, U5.29
/TFT_DC: J4.6, JP56.1, U5.25
/TFT_MOSI: J4.3, JP78.1, U5.21
/TFT_RST: J4.7, JP79.1, U5.22
/TFT_SCK: J4.4, JP9.1, JP18.1, JP19.1, U5.28
/VREF: C10.2, C12.2, C16.2, C21.2, C22.2, C23.2, C24.2, JP28.1, JP29.1, JP30.1, JP31.1, R6.2, R12.2, R16.2, R27.2, R28.2, R29.2, RV2.3, RV3.3, RV4.3, U1.1, U1.2, U2.10, U4.10, U4.12, U5.3
GND: C1.2, C2.2, C3.2, C4.2, C5.2, C6.2, C7.2, C8.2, C25.2, C26.2, J1.S, J2.S, J3.2, J3.4, J4.2, J5.3, J6.2, JP2.1, JP22.1, JP23.1, JP24.1, JP25.1, JP66.1, JP67.1, R3.2, R24.2, R30.2, R32.2, RV1.3, RV5.3, SW1.2, U1.11, U2.11, U3.11, U4.11, U5.14, U5.20, U5.26, U6.1, U6.5, U6.7, U6.9, U6.12
unnamed: C9.1, JP3.1, RV1.2
unnamed: C10.1, JP6.1, R8.2
unnamed: C11.1, R9.2, R10.1
unnamed: C13.2, C14.1, R11.1
unnamed: C15.1, R13.2, R14.1
unnamed: C17.2, C18.1, R15.1
unnamed: C19.2, R23.1
unnamed: C20.1, JP51.1, R25.2, R26.1
unnamed: D1.2, U3.1
unnamed: C22.1, D1.1, R27.1, U3.2, U3.5
unnamed: D2.2, JP7.1, U3.8
unnamed: C23.1, D2.1, JP52.1, JP53.1, JP64.1, R28.1, U3.9, U3.12
unnamed: D3.2, U4.1
unnamed: C24.1, D3.1, JP1.1, R29.1, U4.2, U4.5
unnamed: JP16.1, R4.2, R5.2, RV1.1
unnamed: C8.1, R2.2, R3.1, U1.3
unnamed: C9.2, JP42.1, R6.1, U1.5
unnamed: R7.1, R8.1, U1.6
unnamed: C12.1, JP26.1, JP27.1, R10.2, U1.10
unnamed: C14.2, JP68.1, JP69.1, R12.1, U1.12
unnamed: C16.1, R14.2, U2.3
unnamed: C18.2, JP41.1, R16.1, U2.5
unnamed: R19.2, R20.2, R21.2, R22.1, U2.9
unnamed: C21.1, JP11.1, R26.2, U2.12
unnamed: JP50.1, JP75.1, R17.2, R18.1, U4.9
unnamed: U4.13, U4.14
