davixcky/ecualizador-esp32/hardware/una-cara/ecualizador-D1.kicad_pcb

## KiCad design hardware/una-cara/ecualizador-D1.kicad_pcb (2026-10-22)

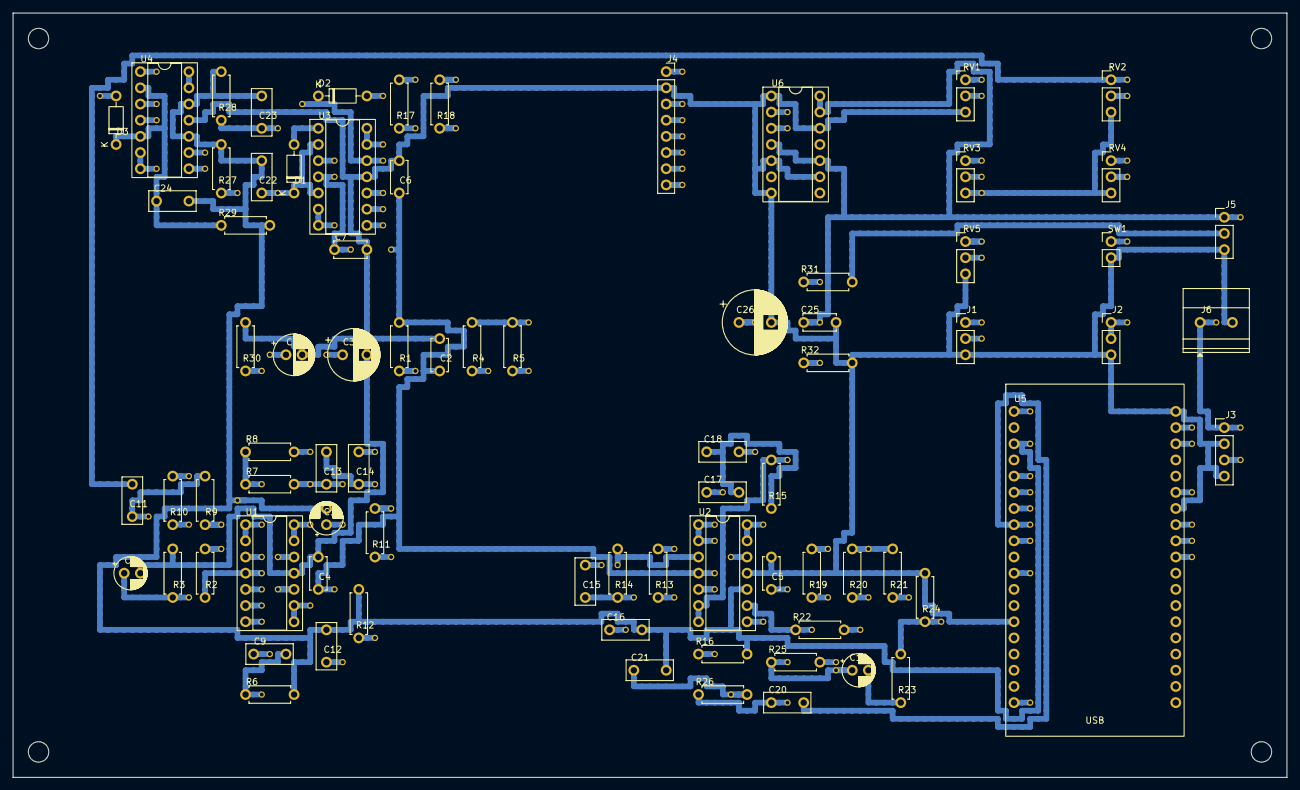
[picture p162: board ecualizador-D1.kicad_pcb from above]

Board: 2 copper layers, 200.0 x 120.0 mm, 163 parts (0 on the bottom side), 59 nets.

Parts:
C1: 100u 10V; UnaCara_C1
C2: 100n; UnaCara_C2
C3: 470u 10V; UnaCara_C3
C4: 100n; UnaCara_C4
C5: 100n; UnaCara_C5
C6: 100n; UnaCara_C6
C7: 100n; UnaCara_C7
C8: 10u 16V; UnaCara_C8
C9: 1u film; UnaCara_C9
C10: 10u 16V; UnaCara_C10
C11: 100n film; UnaCara_C11
C12: 47n film; UnaCara_C12
C13: 10n film; UnaCara_C13
C14: 10n film; UnaCara_C14
C15: 10n film; UnaCara_C15
C16: 4n7 film; UnaCara_C16
C17: 10n film; UnaCara_C17
C18: 10n film; UnaCara_C18
C19: 10u 16V; UnaCara_C19
C20: 4n7 film; UnaCara_C20
C21: 2n2 film; UnaCara_C21
C22: 100n film; UnaCara_C22
C23: 100n film; UnaCara_C23
C24: 100n film; UnaCara_C24
C25: 100n; UnaCara_C25
C26: 1000u 10V; UnaCara_C26
D1: 1N4148; UnaCara_D1
D2: 1N4148; UnaCara_D2
D3: 1N4148; UnaCara_D3
H1, H2, H3, H4: MountingHole_3.2mm_M3
J1: Entrada de línea 3,5 mm; UnaCara_J1
J2: Salida de línea 3,5 mm; UnaCara_J2
J3: PAM8403; UnaCara_J3
J4: Waveshare 1.9 ST7789V2; UnaCara_J4
J5: NeoPixel 5V DIN GND; UnaCara_J5
J6: Entrada 5V 3A; UnaCara_J6
R1: 10; UnaCara_R1
R2: 10k 1%; UnaCara_R2
R3: 10k 1%; UnaCara_R3
R4: 10k; UnaCara_R4
R5: 10k; UnaCara_R5
R6: 100k; UnaCara_R6
R7: 22k 1%; UnaCara_R7
R8: 10k 1%; UnaCara_R8
R9: 10k 1%; UnaCara_R9
R10: 10k 1%; UnaCara_R10
R11: 27k 1%; UnaCara_R11
R12: 56k 1%; UnaCara_R12
R13: 10k 1%; UnaCara_R13
R14: 10k 1%; UnaCara_R14
R15: 2k7 1%; UnaCara_R15
R16: 5k6 1%; UnaCara_R16
R17: 47k 1%; UnaCara_R17
R18: 47k 1%; UnaCara_R18
R19: 47k 1%; UnaCara_R19
R20: 47k 1%; UnaCara_R20
R21: 47k 1%; UnaCara_R21
R22: 100k 1%; UnaCara_R22
R23: 100; UnaCara_R23
R24: 47k; UnaCara_R24
R25: 10k 1%; UnaCara_R25
R26: 10k 1%; UnaCara_R26
R27: 220k; UnaCara_R27
R28: 220k; UnaCara_R28
R29: 220k; UnaCara_R29
R30: 10k; UnaCara_R30
R31: 330; UnaCara_R31
R32: 10k; UnaCara_R32
RV1: 10k log; UnaCara_RV1
RV2: 10k lin; UnaCara_RV2
RV3: 10k lin; UnaCara_RV3
RV4: 10k lin; UnaCara_RV4
RV5: 10k log; UnaCara_RV5
SW1: Pulsador; UnaCara_SW1
U1: MCP6004; UnaCara_U1
U2: MCP6004; UnaCara_U2
U3: MCP6004; UnaCara_U3
U4: MCP6004; UnaCara_U4
U5: ESP32-DevKitC V4; UnaCara_U5
U6: 74AHCT125; UnaCara_U6
W1, W2: Cable aislado /VREF
W3, W4, W5, W6, W7: Cable aislado +3.3VA
W8, W9, W10, W11: Cable aislado +5V
W12, W13: Cable aislado /LINEA
W14, W15, W16: Cable aislado /PRE
W17: Cable aislado Net-(D1-K)
W18, W19: Cable aislado Net-(D2-K)
W20, W21: Cable aislado Net-(U2C--)
W22: Cable aislado /ADC_FFT
W23: Cable aislado /AGUDOS
W24, W25: Cable aislado /EQ_OUT
W26: Cable aislado /GRAVES
W27, W28: Cable aislado /MEDIOS
W29, W30: Cable aislado /MED_HP
W31, W32: Cable aislado Net-(U1A-+)
W33, W34: Cable aislado +3V3
W35: Cable aislado /ADC_A
W36: Cable aislado /ADC_G
W37: Cable aislado /ADC_M
W38, W39: Cable aislado /A_W
W40, W41: Cable aislado /G_W
W42, W43: Cable aislado /LED_DATA
W44, W45: Cable aislado /M_INV
W46, W47: Cable aislado /M_W
W48, W49: Cable aislado /TFT_BL
W50: Cable aislado Net-(C11-Pad1)
W51: Cable aislado Net-(C13-Pad2)
W52: Cable aislado Net-(C15-Pad1)
W53: Cable aislado Net-(C20-Pad1)
W54: Cable aislado Net-(R4-Pad2)
W55: Cable aislado Net-(U1B-+)
W56: Cable aislado Net-(U1B--)
W57, W58: Cable aislado Net-(U1C-+)
W59, W60: Cable aislado Net-(U1D-+)
W61: Cable aislado Net-(U2A-+)
W62, W63: Cable aislado Net-(U2B-+)
W64: Cable aislado Net-(U2D-+)
W65, W66: Cable aislado Net-(U4C--)
W67: Cable aislado /AMP_IN
W68: Cable aislado /BTN
W69: Cable aislado /IN_L
W70: Cable aislado /IN_R
W71: Cable aislado /LED_5V
W72: Cable aislado /TFT_CS
W73: Cable aislado /TFT_DC
W74: Cable aislado /TFT_MOSI
W75: Cable aislado /TFT_RST
W76: Cable aislado /TFT_SCK
W77: Cable aislado Net-(C10-Pad1)
W78: Cable aislado Net-(C9-Pad1)
W79: Cable aislado Net-(D2-A)
W80: Cable aislado Net-(D3-A)

Connections:
+3.3VA: C1.1, C2.1, C4.1, C5.1, C6.1, C7.1, R1.2, R2.1, U1.4, U2.4, U3.4, U4.4, W3.1, W3.2, W4.1, W4.2, W5.1, W5.2, W6.1, W6.2, W7.1, W7.2
+3V3: J4.1, R1.1, U5.1, W33.1, W33.2, W34.1, W34.2
+5V: C3.1, C25.1, C26.1, J3.1, J5.1, J6.1, U5.19, U6.4, U6.10, U6.13, U6.14, W8.1, W8.2, W9.1, W9.2, W10.1, W10.2, W11.1, W11.2
/ADC_A: U4.6, U4.7, U5.7, W35.1, W35.2
/ADC_FFT: C20.2, U2.13, U2.14, U5.8, W22.1, W22.2
/ADC_G: U3.6, U3.7, U5.5, W36.1, W36.2
/ADC_M: U3.13, U3.14, U5.6, W37.1, W37.2
/AGUDOS: R15.2, RV4.1, U2.6, U2.7, W23.1, W23.2
/AMP_IN: J3.3, RV5.2, W67.1, W67.2
/A_W: R21.1, RV4.2, U4.3, W38.1, W38.2, W39.1, W39.2
/BTN: SW1.1, U5.11, W68.1, W68.2
/EQ_OUT: C19.1, R22.2, R25.1, U2.8, W24.1, W24.2, W25.1, W25.2
/GRAVES: C11.2, RV2.1, U1.8, U1.9, W26.1, W26.2
/G_W: R19.1, RV2.2, U3.3, W40.1, W40.2, W41.1, W41.2
/IN_L: J1.T, R4.1, W69.1, W69.2
/IN_R: J1.R, R5.1, W70.1, W70.2
/LED_5V: R31.1, U6.3, W71.1, W71.2
/LED_DATA: R32.1, U5.9, U6.2, W42.1, W42.2, W43.1, W43.2
/LED_DIN: J5.2, R31.2
/LINEA: J2.R, J2.T, R23.2, R24.1, RV5.1, W12.1, W12.2, W13.1, W13.2
/MEDIOS: C15.2, RV3.1, U2.1, U2.2, W27.1, W27.2, W28.1, W28.2
/MED_HP: R11.2, R13.1, U1.13, U1.14, W29.1, W29.2, W30.1, W30.2
/M_INV: R18.2, R20.1, U4.8, W44.1, W44.2, W45.1, W45.2
/M_W: R17.1, RV3.2, U3.10, W46.1, W46.2, W47.1, W47.2
/PRE: C13.1, C17.1, R7.2, R9.1, U1.7, W14.1, W14.2, W15.1, W15.2, W16.1, W16.2
/TFT_BL: J4.8, R30.1, U5.27, W48.1, W48.2, W49.1, W49.2
/TFT_CS: J4.5, U5.29, W72.1, W72.2
/TFT_DC: J4.6, U5.25, W73.1, W73.2
/TFT_MOSI: J4.3, U5.21, W74.1, W74.2
/TFT_RST: J4.7, U5.22, W75.1, W75.2
/TFT_SCK: J4.4, U5.28, W76.1, W76.2
/VREF: C10.2, C12.2, C16.2, C21.2, C22.2, C23.2, C24.2, R6.2, R12.2, R16.2, R27.2, R28.2, R29.2, RV2.3, RV3.3, RV4.3, U1.1, U1.2, U2.10, U4.10, U4.12, U5.3, W1.1, W1.2, W2.1, W2.2
GND: C1.2, C2.2, C3.2, C4.2, C5.2, C6.2, C7.2, C8.2, C25.2, C26.2, J1.S, J2.S, J3.2, J3.4, J4.2, J5.3, J6.2, R3.2, R24.2, R30.2, R32.2, RV1.3, RV5.3, SW1.2, U1.11, U2.11, U3.11, U4.11, U5.14, U5.20, U5.26, U6.1, U6.5, U6.7, U6.9, U6.12
unnamed: C9.1, RV1.2, W78.1, W78.2
unnamed: C10.1, R8.2, W77.1, W77.2
unnamed: C11.1, R9.2, R10.1, W50.1, W50.2
unnamed: C13.2, C14.1, R11.1, W51.1, W51.2
unnamed: C15.1, R13.2, R14.1, W52.1, W52.2
unnamed: C17.2, C18.1, R15.1
unnamed: C19.2, R23.1
unnamed: C20.1, R25.2, R26.1, W53.1, W53.2
unnamed: D1.2, U3.1
unnamed: C22.1, D1.1, R27.1, U3.2, U3.5, W17.1, W17.2
unnamed: D2.2, U3.8, W79.1, W79.2
unnamed: C23.1, D2.1, R28.1, U3.9, U3.12, W18.1, W18.2, W19.1, W19.2
unnamed: D3.2, U4.1, W80.1, W80.2
unnamed: C24.1, D3.1, R29.1, U4.2, U4.5
unnamed: R4.2, R5.2, RV1.1, W54.1, W54.2
unnamed: C8.1, R2.2, R3.1, U1.3, W31.1, W31.2, W32.1, W32.2
unnamed: C9.2, R6.1, U1.5, W55.1, W55.2
unnamed: R7.1, R8.1, U1.6, W56.1, W56.2
unnamed: C12.1, R10.2, U1.10, W57.1, W57.2, W58.1, W58.2
unnamed: C14.2, R12.1, U1.12, W59.1, W59.2, W60.1, W60.2
unnamed: C16.1, R14.2, U2.3, W61.1, W61.2
unnamed: C18.2, R16.1, U2.5, W62.1, W62.2, W63.1, W63.2
unnamed: R19.2, R20.2, R21.2, R22.1, U2.9, W20.1, W20.2, W21.1, W21.2
unnamed: C21.1, R26.2, U2.12, W64.1, W64.2
unnamed: R17.2, R18.1, U4.9, W65.1, W65.2, W66.1, W66.2
unnamed: U4.13, U4.14
