davixcky/ecualizador-esp32/(commit log)

2026-10-22 Ecualizador de tres bandas con analizador de espectro en ESP32 (Fase 2)
    Circuito descrito una sola vez en herramientas/circuito.py, del que salen la
    simulación en ngspice (24 casos), el esquemático de KiCad (ERC 0/0, netlist
    verificada pin a pin), la PCB de dos capas ruteada con Freerouting, el
    firmware del ESP32 con pruebas en el PC, el gabinete en CadQuery con renders
    en Blender y la guía de montaje en protoboard.
2026-10-22 Informe y presentación de la Fase 2, propuestas de la Fase 1 y archivos de fabricación
    - docs/informe-fase2: informe en Markdown, PDF y Word (trabajo inicial,
    objetivos, estado del arte, marco teórico, desarrollo y pendientes)
    - docs/presentacion: 16 diapositivas en PDF, PowerPoint (con notas del
    orador), PNG y su fuente HTML; scripts de exportación en herramientas/
    - docs/fase1: documento de propuestas de la Fase 1 y rúbrica
    - Gerber sueltos y modelo VRML de la PCB ahora versionados
    - README: tabla de entregables con enlaces
2026-10-22 Completa PCB de una cara, documentación LaTeX y demo con audio sincronizado
